aalonsopuig/Inmoov_ROS2/hardware/Default Hardware Map.pdf

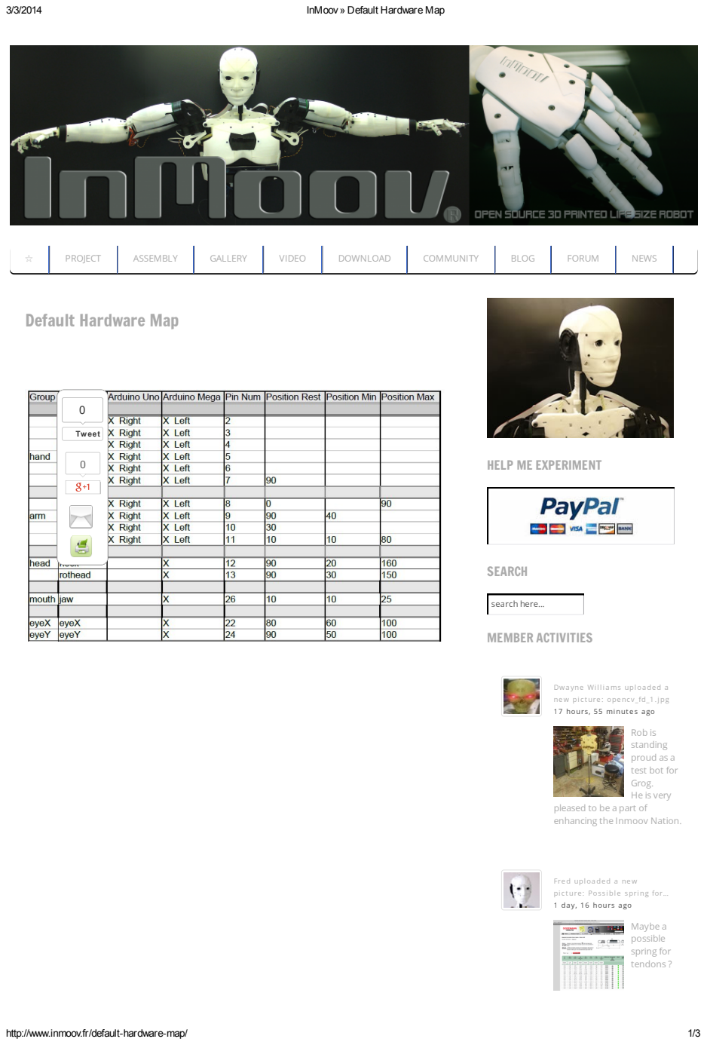
[picture p20: page 1]
InMoov» Default Hardware Map; http://www.inmoov.fr/default-hardware-map/; SEARCH; search here...; MEMBER ACTIVITIES; Maybe a possible spring for tendons ?; PROJECT; ASSEMBLY; GALLERY; VIDEO; DOWNLOAD; COMMUNITY; BLOG; FORUM; NEWS; Tweet

Default Hardware Map

HELP ME EXPERIMENT

Dwa yne Wi l l i a ms (http://www.inmoov.fr/members/dwilli9013/) upl oa ded a
new pi c t ure : openc v_fd_1. j pg (http://www.inmoov.fr/members/dwilli9013/album/picture/46/)
17 hours , 55 mi nut e s a go (http://www.inmoov.fr/activity/p/1213/)

Rob is
standing
proud as a
test bot for
Grog.
He is very

pleased to be a part of
enhancing the Inmoov Nation.

Fred (http://www.inmoov.fr/members/freddyzaz/) upl oa ded a new
pi c t ure : Pos s i bl e spri ng for… (http://www.inmoov.fr/members/freddyzaz/album/picture/45/)
1 da y, 16 hours a go (http://www.inmoov.fr/activity/p/1203/)

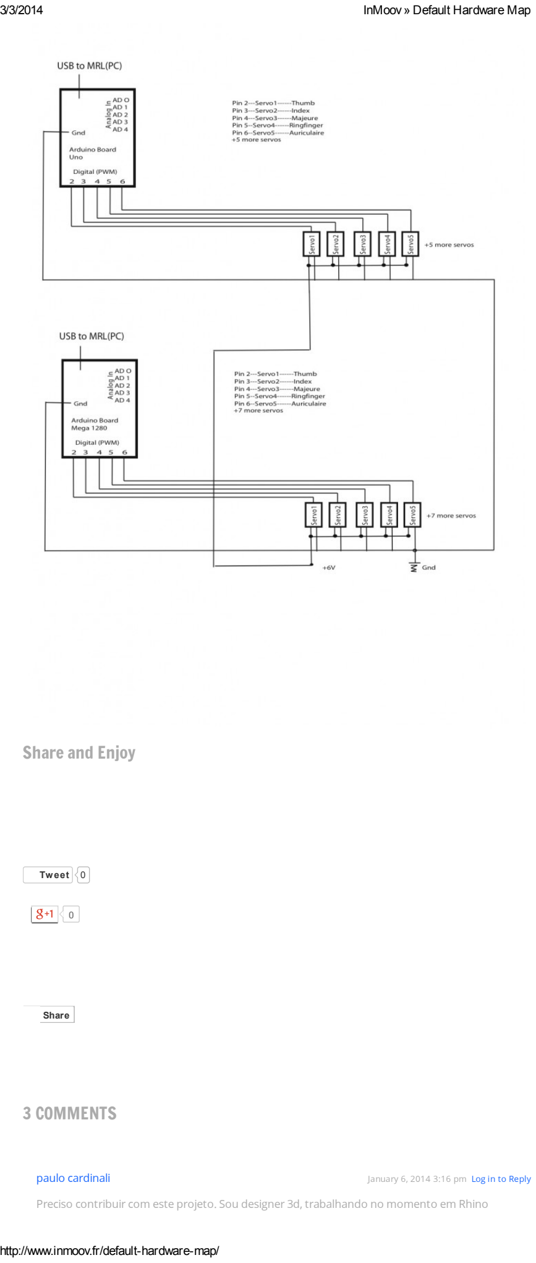
[picture p21: figure]
Tweet 0; January 6, 2014 3:16 pm Log in to Reply; Share and Enjoy; 3 COMMENTS; paulo cardinali; Share

Preciso contribuir com este projeto. Sou designer 3d, trabalhando no momento em Rhino

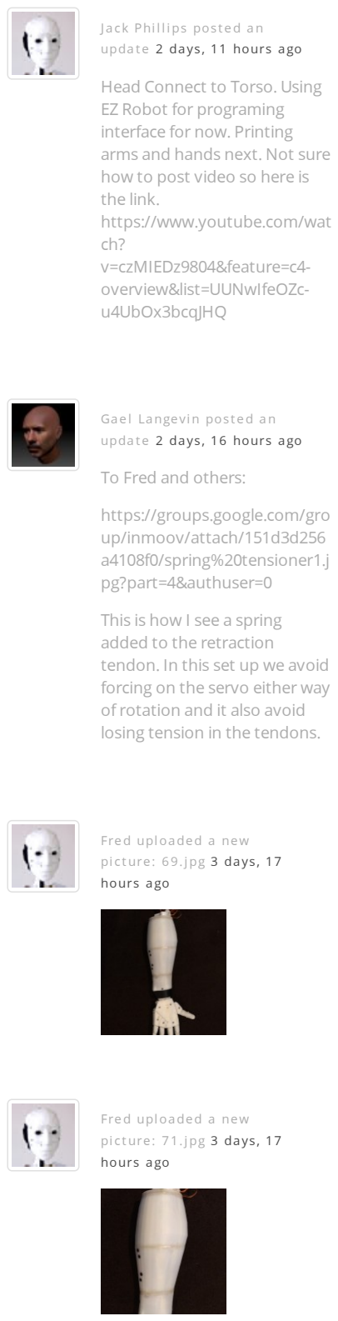
[picture p22: figure]
J a c k Phi l l i ps pos t ed a n upda t e 2 da ys , 11 hours a go; Head Connect to Torso. Using EZ Robot for programing interface for now. Printing arms and hands next. Not sure how to post video so here is the link. https://www.youtube.com/wat ch? v=czMIEDz9804&feature=c4- overview&list=UUNwIfeOZc- u4UbOx3bcqJHQ; Ga e l La nge vi n pos t ed a n upda t e 2 da ys , 16 hours a go; To Fred and others:; https://groups.google.com/gro up/inmoov/attach/151d3d256 a4108f0/spring%20tensioner1.j pg?part=4&authuser=0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

## FOLLOW ME

gael langevin (https://plus.google.com/109466702837468444192?prsrc=5) 1 circle 413 followers

## RECENT POSTS

InMoov prosthetic hand almost ready (http://www.inmoov.fr/inmoov-prosthetic-hand-almost-ready/) InMoov in Moscow, Geek Picnic (http://www.inmoov.fr/inmoov-in-moscow-geek-picnic/) InMoov on the New Yorker (http://www.inmoov.fr/inmoov-on-the-new-yorker/)
Wow InMoov Santa! (http://www.inmoov.fr/wow-inmoov-santa/)

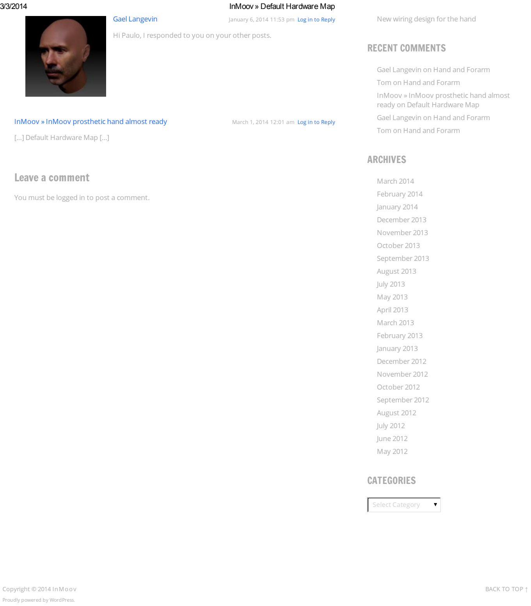
[picture p23: figure]
March 1, 2014 12:01 am Log in to Reply; Gael Langevin; […] Default Hardware Map […]; Leave a comment; New wiring design for the hand; RECENT COMMENTS; Gael Langevin on Hand and Forarm; Tom on Hand and Forarm; InMoov » InMoov prosthetic hand almost ready on Default Hardware Map; ARCHIVES; March 2014; February 2014; January 2014; December 2013; November 2013; October 2013; September 2013; August 2013; July 2013; May 2013; April 2013; March 2013; February 2013; January 2013; December 2012; November 2012; October 2012; September 2012; August 2012; July 2012; June 2012; May 2012; CATEGORIES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

January 6, 2014 11:53 pm Log in to Reply (http://www.inmoov.fr/wp-login.php?redirect_to=http%3A%2F%2Fwww.inmoov.fr%2Fdefault-hardware-map%2F)

Hi Paulo, I responded to you on your other posts.

InMoov » InMoov prosthetic hand almost ready (http://www.inmoov.fr/inmoov-prosthetic-hand-almost-ready/)

You must be logged in (http://www.inmoov.fr/wp-login.php?redirect_to=http%3A%2F%2Fwww.inmoov.fr%2Fdefault-hardware-map%2F) to post a comment.
