aalonsopuig/Inmoov_ROS2/media/Tornillos cabeza.pptx

3x16 tirafondo cabeza redonda

4x13 tirafondo cabeza redonda

3x16 tirafondo cabeza redonda

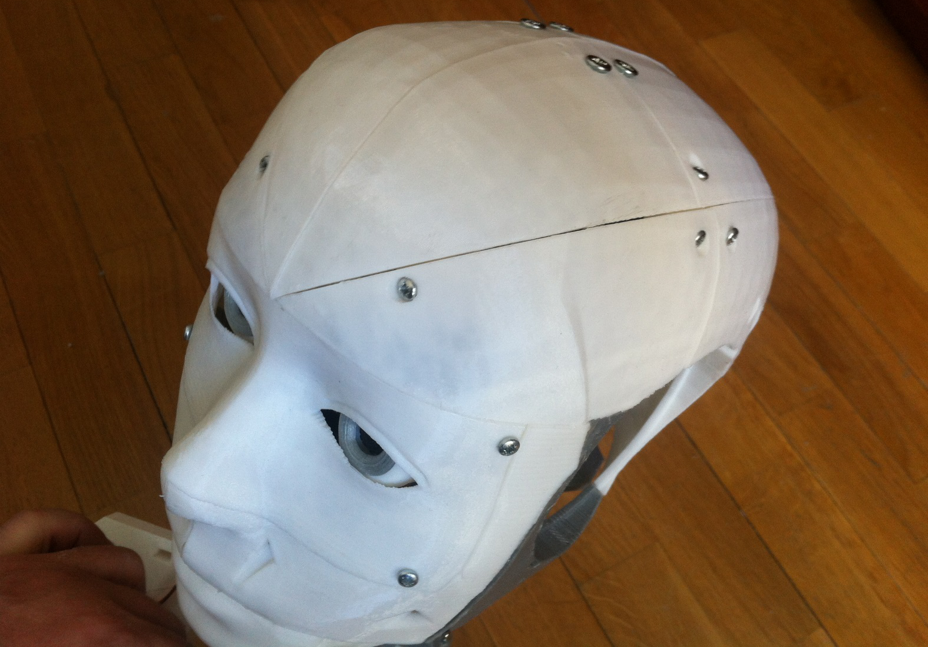
[picture p34: figure]
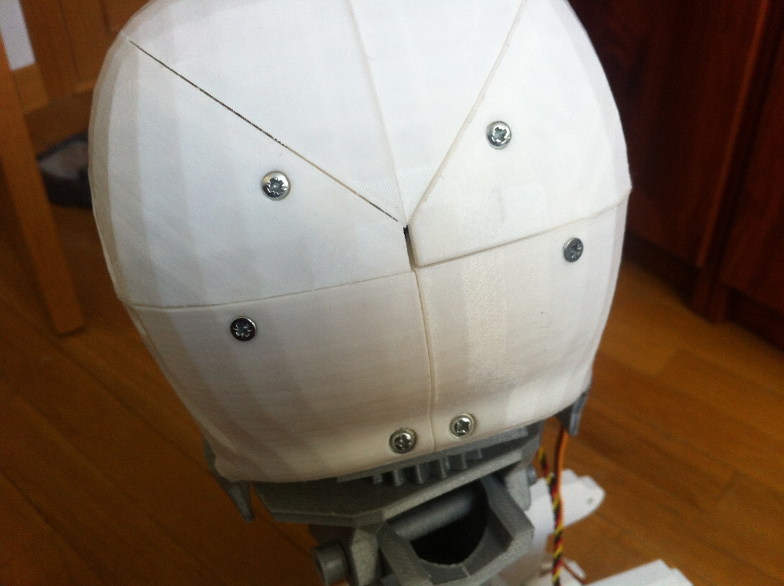
[picture p35: figure]

3x10 tirafondo cabeza redonda

3x16 tirafondo cabeza redonda

3x16 tirafondo cabeza redonda

3x10 tirafondo cabeza redonda
