aalonsopuig/Inmoov_ROS2/inmoov_ws/src/inmoov_vision/faces_db/Alejandro/Alejandro_2.png

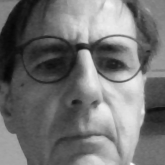
inmoov_ws/src/inmoov_vision/faces_db/Alejandro/Alejandro_2.png
