aalonsopuig/Inmoov_ROS2/inmoov_ws/src/inmoov_vision/faces_db/Daniel/Daniel_5.png

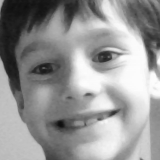
inmoov_ws/src/inmoov_vision/faces_db/Daniel/Daniel_5.png
