aalonsopuig/Inmoov_ROS2/media/20260720_172436.jpg

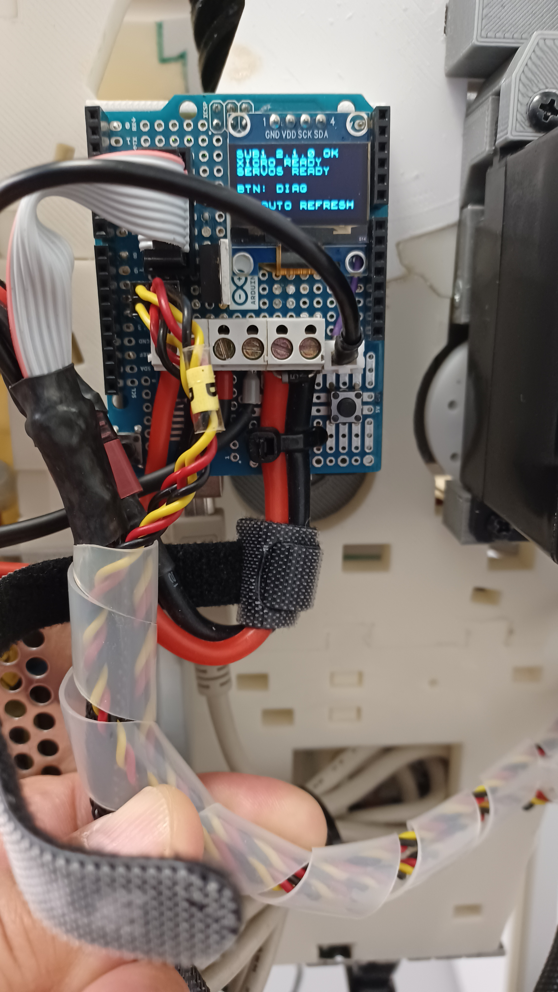
media/20260720_172436.jpg
