aalonsopuig/Inmoov_ROS2/media/20260720_172716.jpg

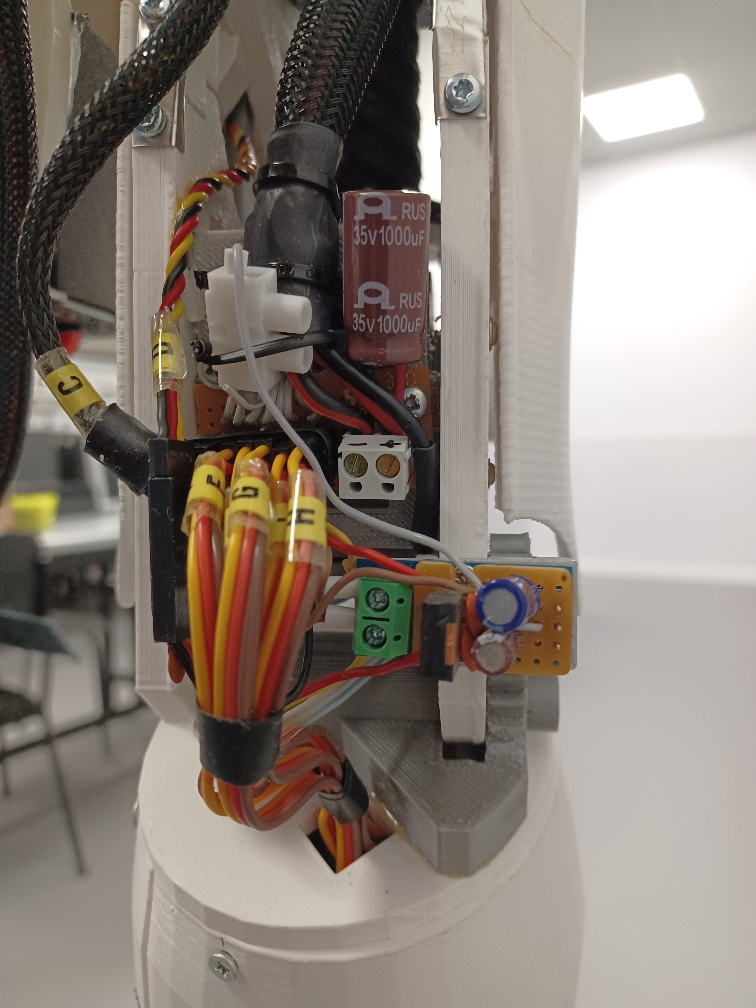
media/20260720_172716.jpg
