aalonsopuig/Inmoov_ROS2/media/IMG-20170118-WA0012.jpg

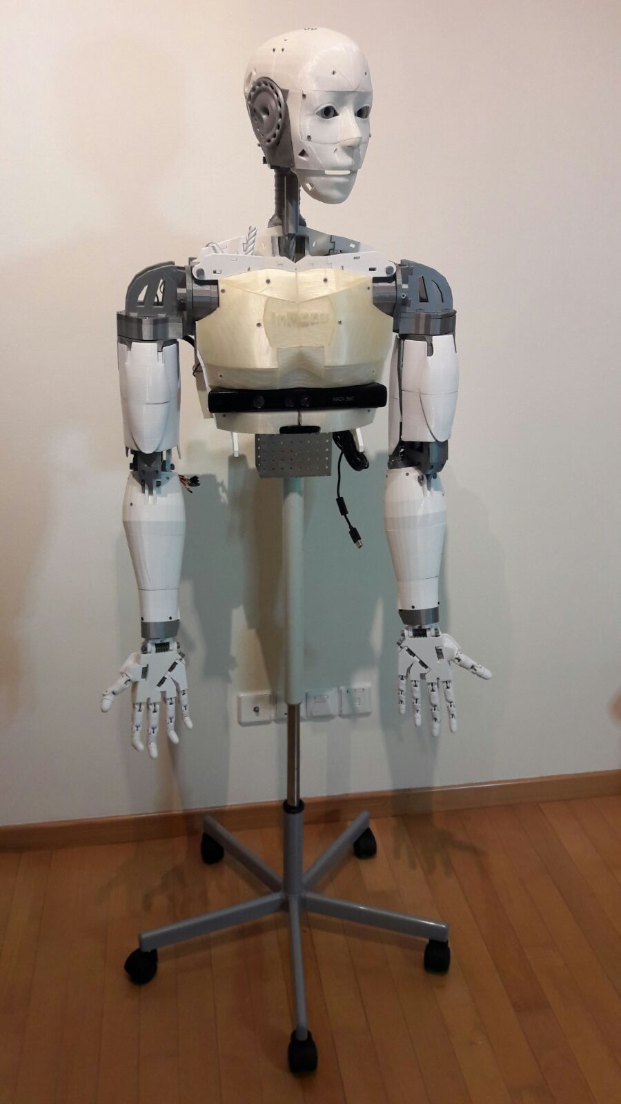
media/IMG-20170118-WA0012.jpg
