aalonsopuig/Inmoov_ROS2/media/IMG-20201107-WA0004.jpg

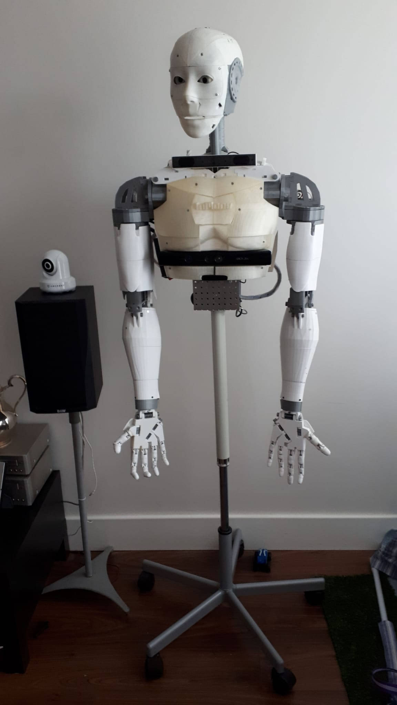
media/IMG-20201107-WA0004.jpg
