aalonsopuig/Inmoov_ROS2/media/IMG-20210605-WA0004.jpeg

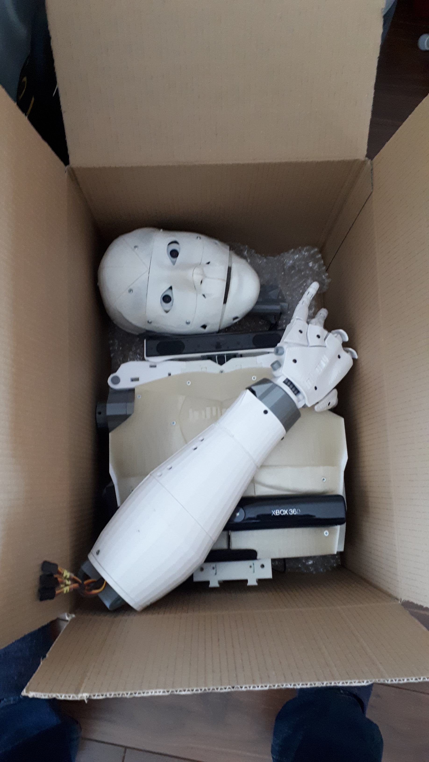
media/IMG-20210605-WA0004.jpeg
