aalonsopuig/Inmoov_ROS2/media/IMG-20211107-WA0002.jpg

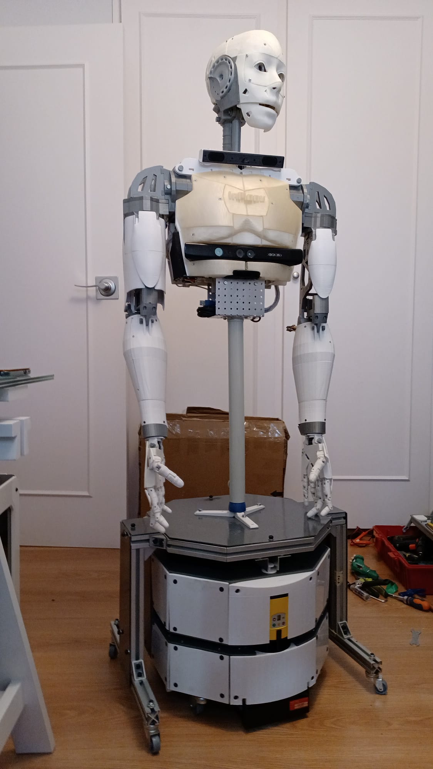
media/IMG-20211107-WA0002.jpg
