aalonsopuig/Inmoov_ROS2/media/IMG_5346.JPG

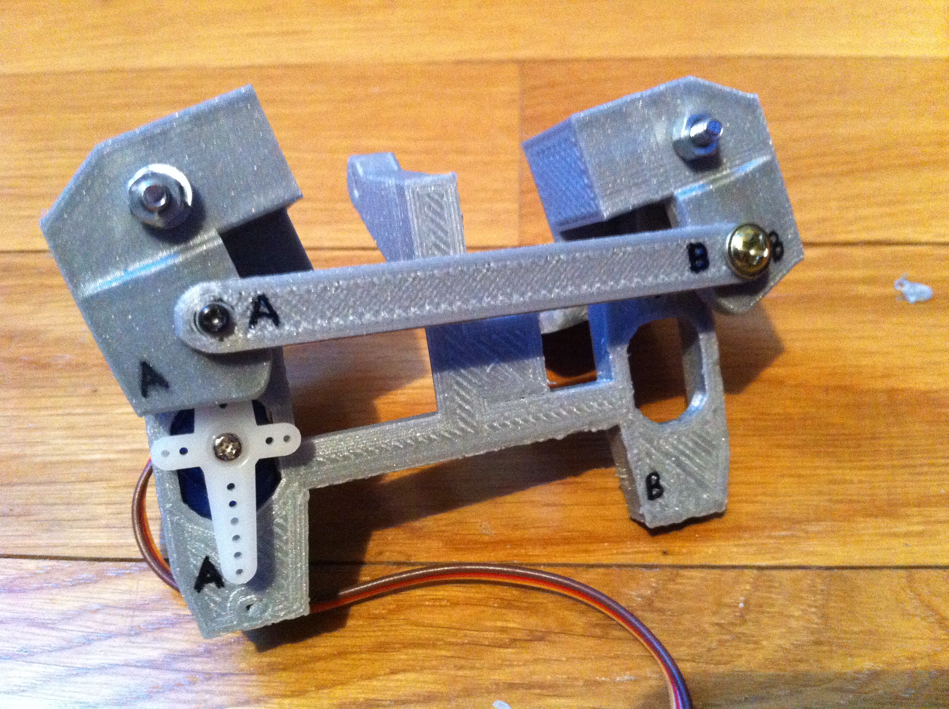
media/IMG_5346.JPG
