aalonsopuig/Inmoov_ROS2/media/IMG_5347.JPG

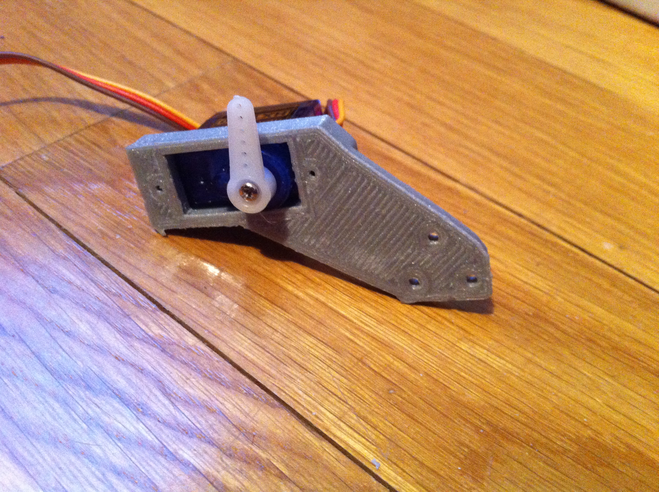
media/IMG_5347.JPG
