aalonsopuig/Inmoov_ROS2/media/IMG_5348.JPG

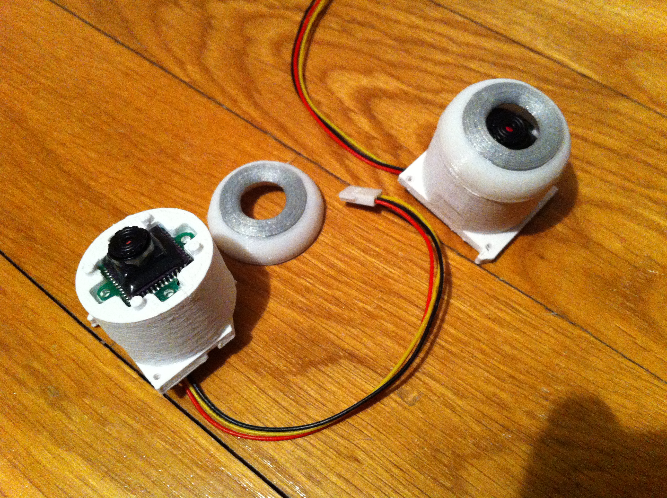
media/IMG_5348.JPG
