aalonsopuig/Inmoov_ROS2/media/IMG_5349.JPG

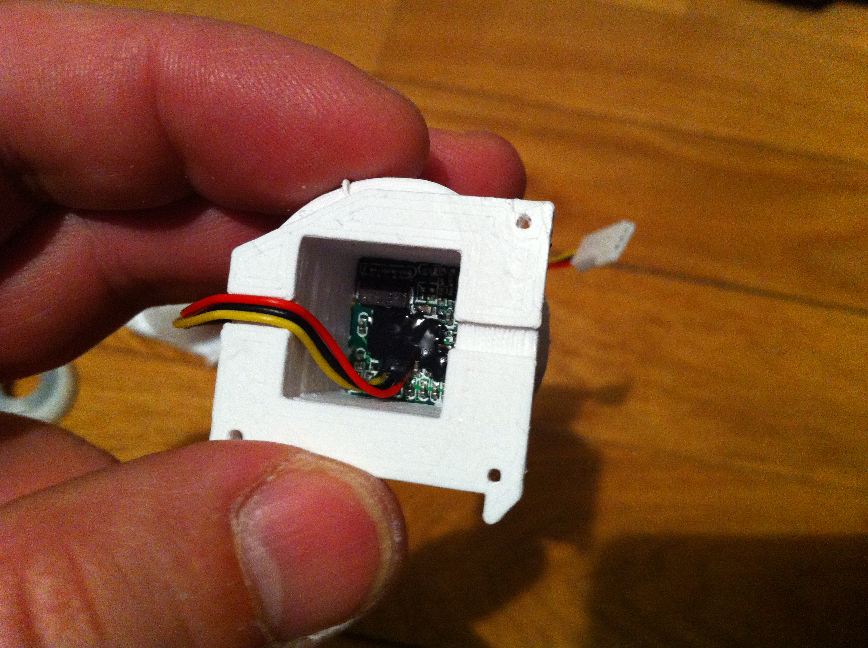
media/IMG_5349.JPG
