aalonsopuig/Inmoov_ROS2/media/IMG_5350.JPG

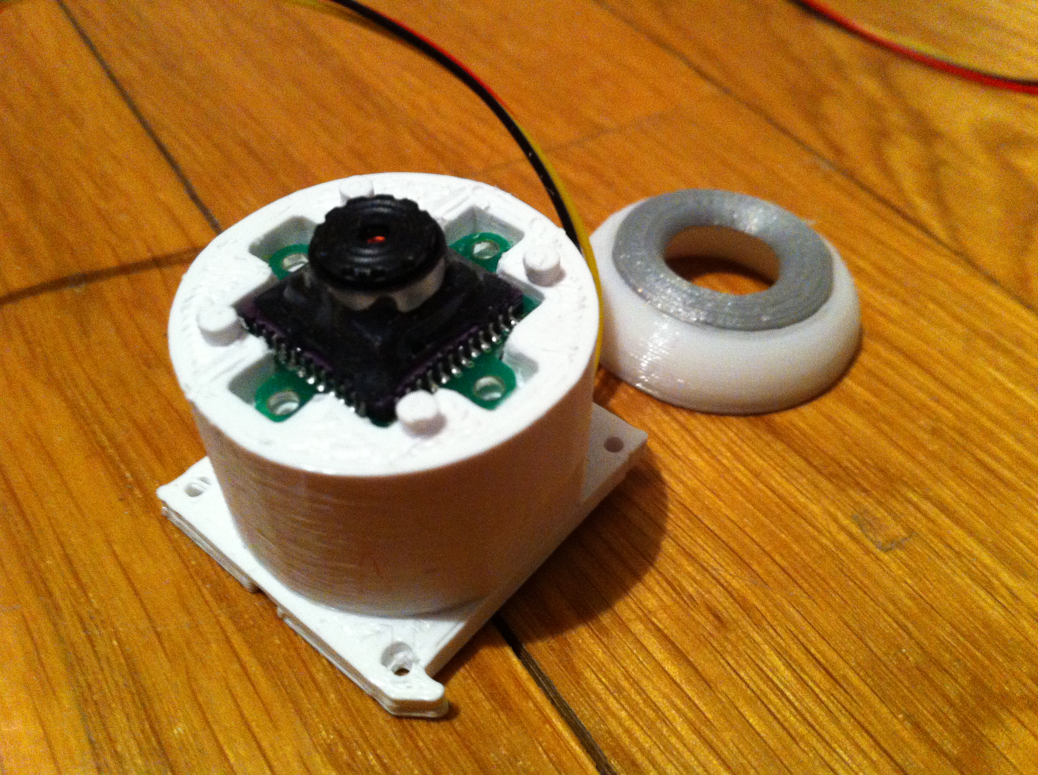
media/IMG_5350.JPG
