aalonsopuig/Inmoov_ROS2/media/IMG_5351.JPG

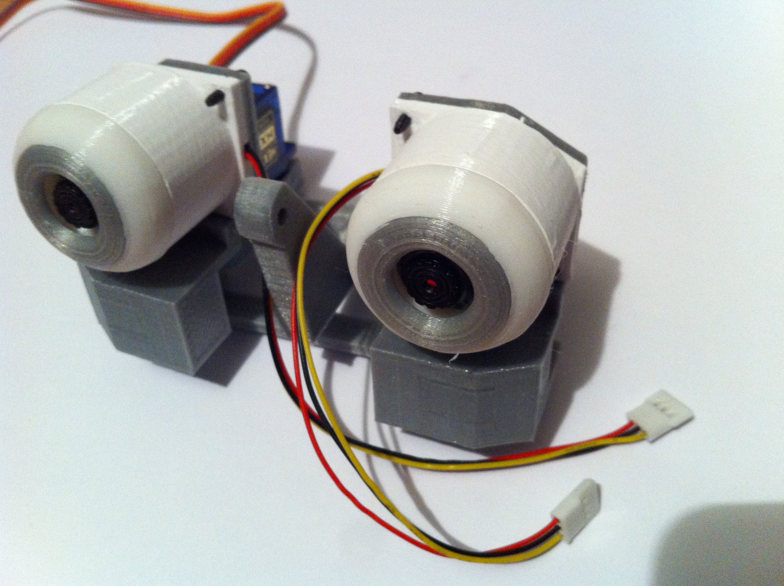
media/IMG_5351.JPG
