aalonsopuig/Inmoov_ROS2/media/IMG_5352.JPG

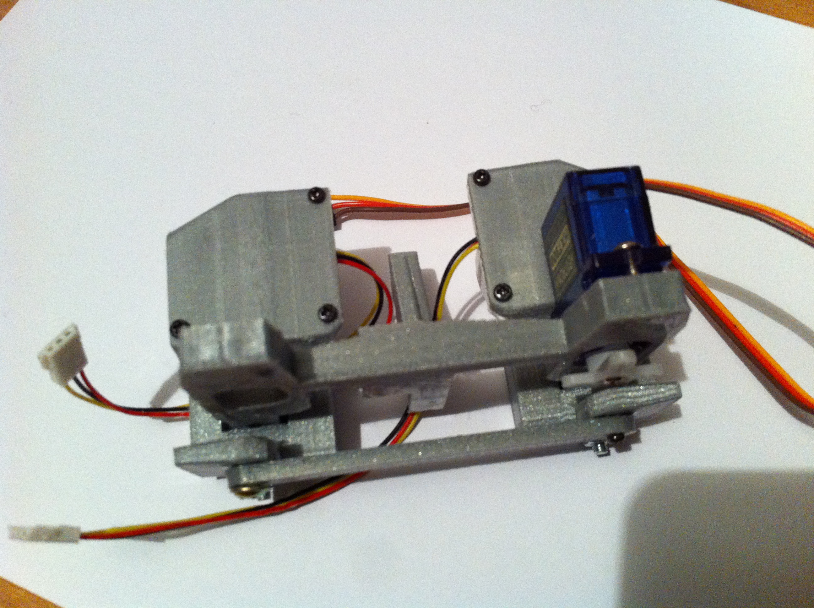
media/IMG_5352.JPG
