aalonsopuig/Inmoov_ROS2/media/IMG_5353.JPG

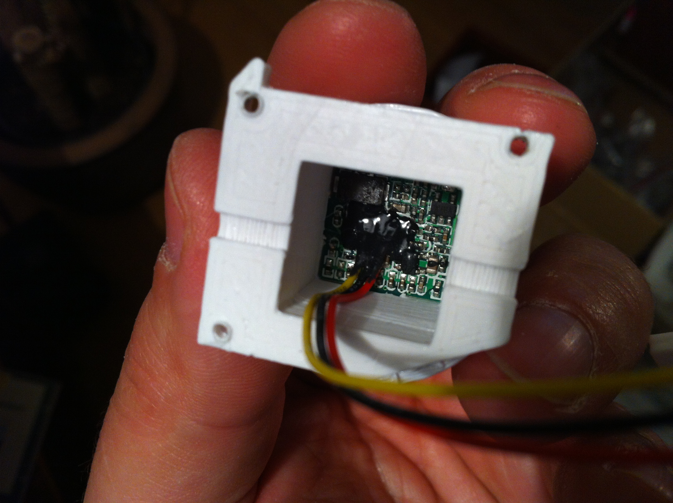
media/IMG_5353.JPG
