aalonsopuig/Inmoov_ROS2/media/IMG_5356.JPG

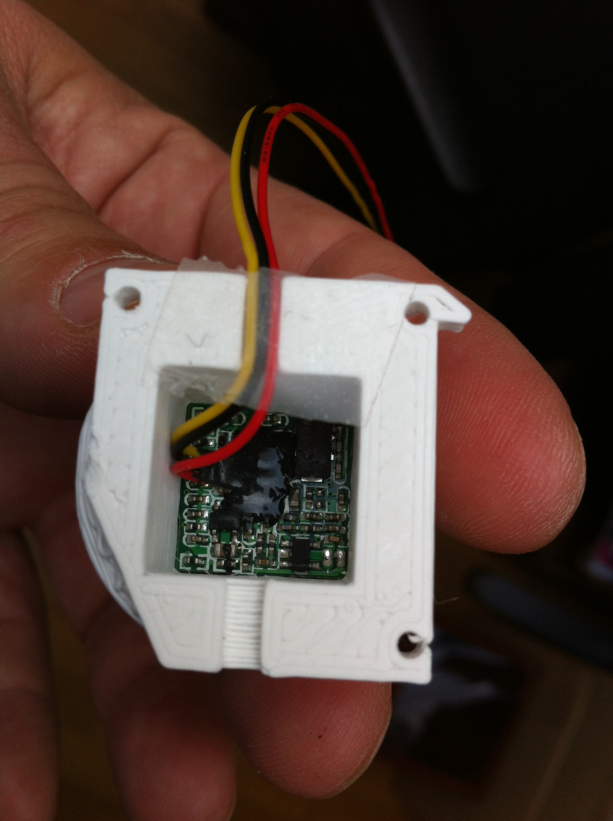
media/IMG_5356.JPG
