aalonsopuig/Inmoov_ROS2/media/IMG_5357.JPG

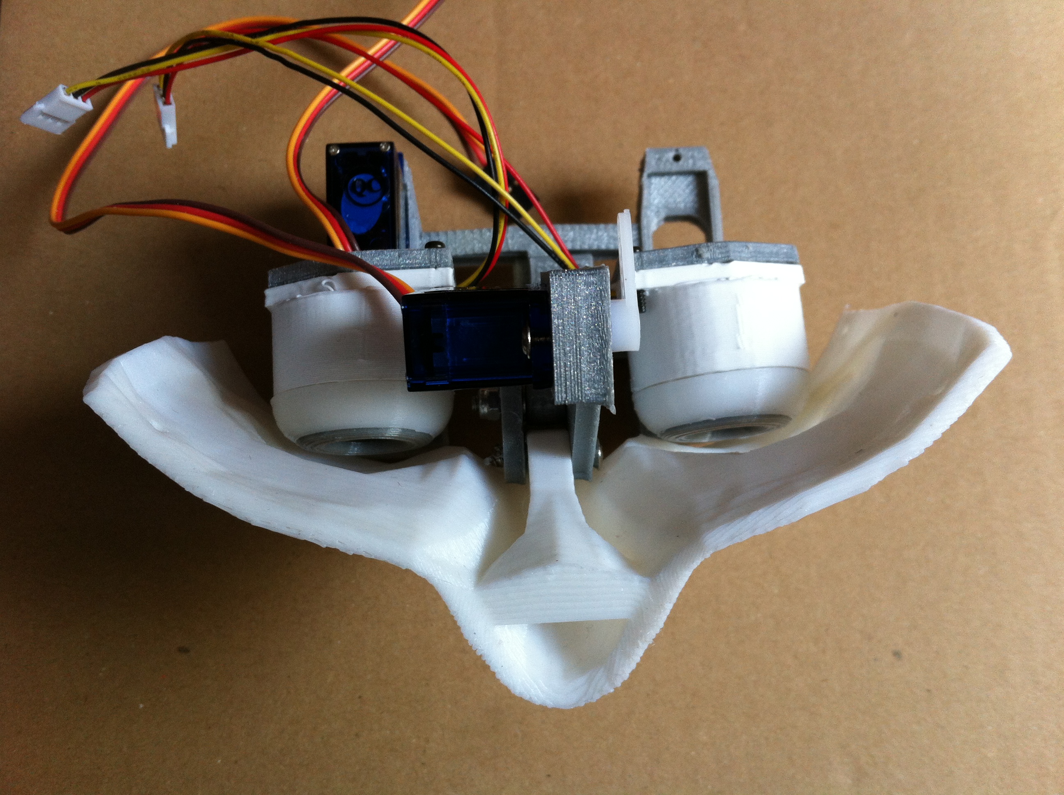
media/IMG_5357.JPG
