aalonsopuig/Inmoov_ROS2/media/IMG_5358.JPG

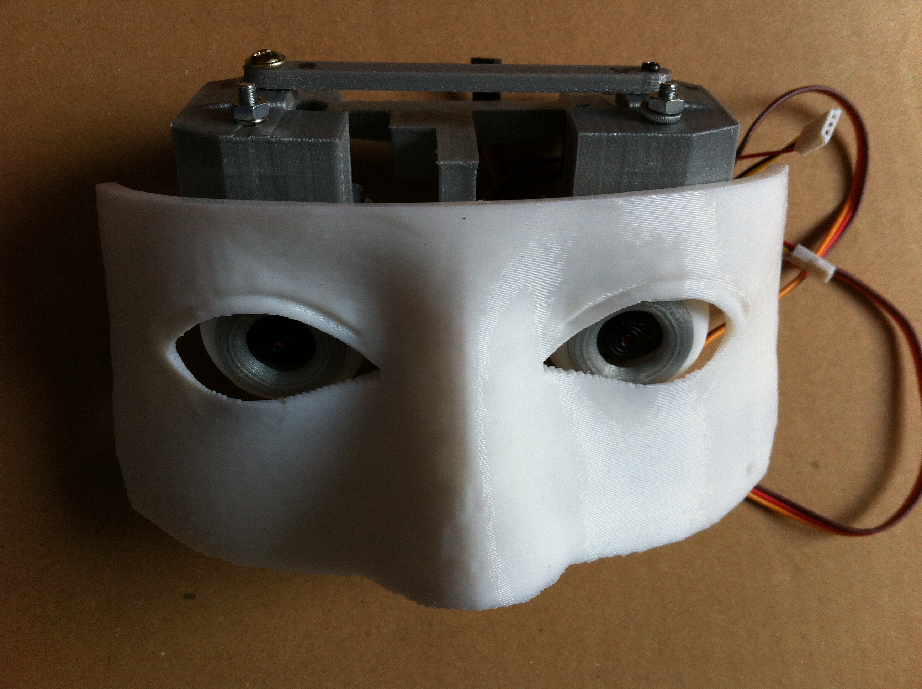
media/IMG_5358.JPG
