aalonsopuig/Inmoov_ROS2/media/IMG_5359.JPG

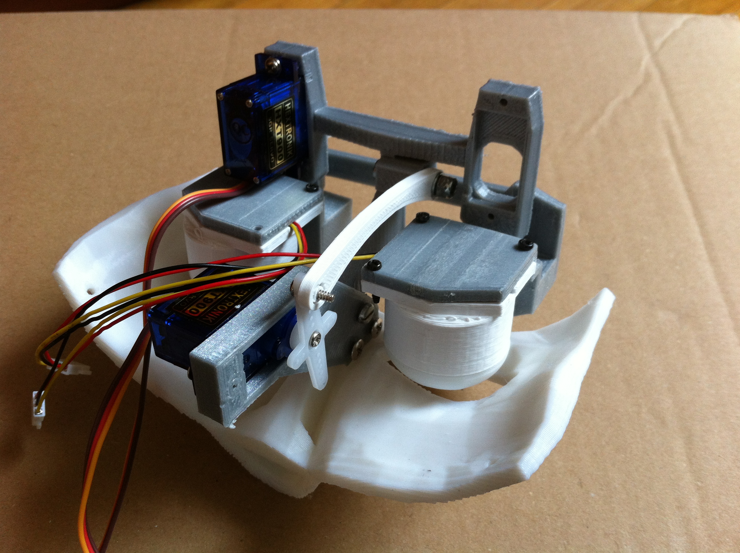
media/IMG_5359.JPG
