aalonsopuig/Inmoov_ROS2/media/IMG_5360.JPG

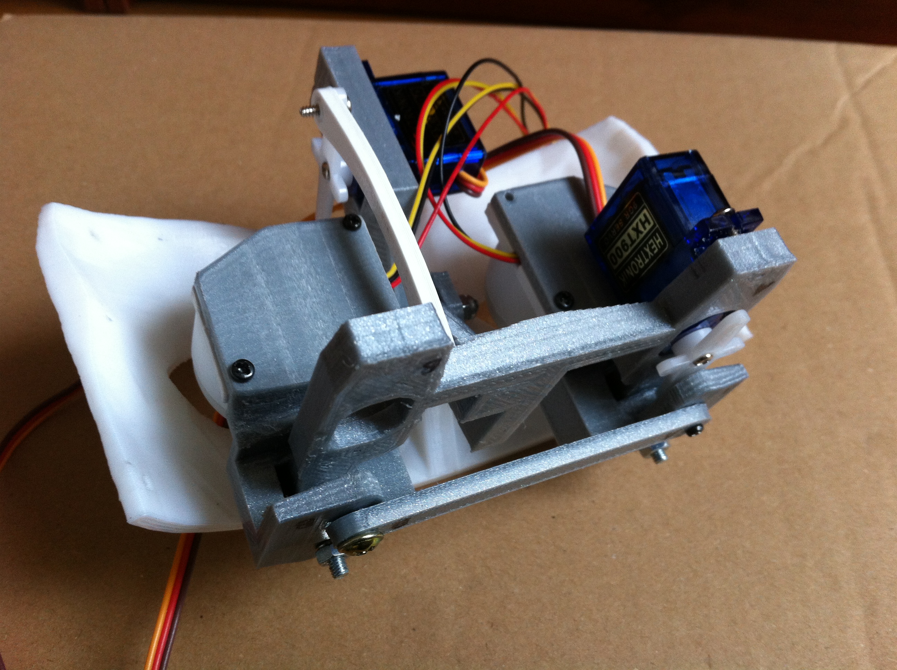
media/IMG_5360.JPG
