aalonsopuig/Inmoov_ROS2/media/IMG_5378.JPG

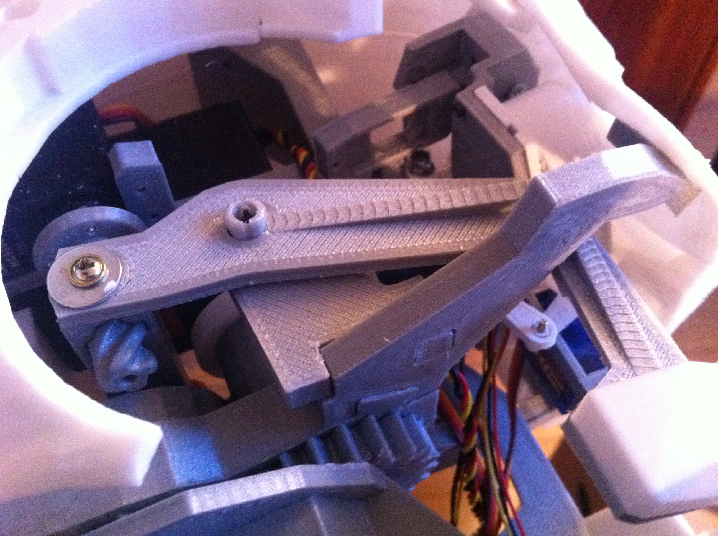
media/IMG_5378.JPG
