aalonsopuig/Inmoov_ROS2/media/IMG_5379.JPG

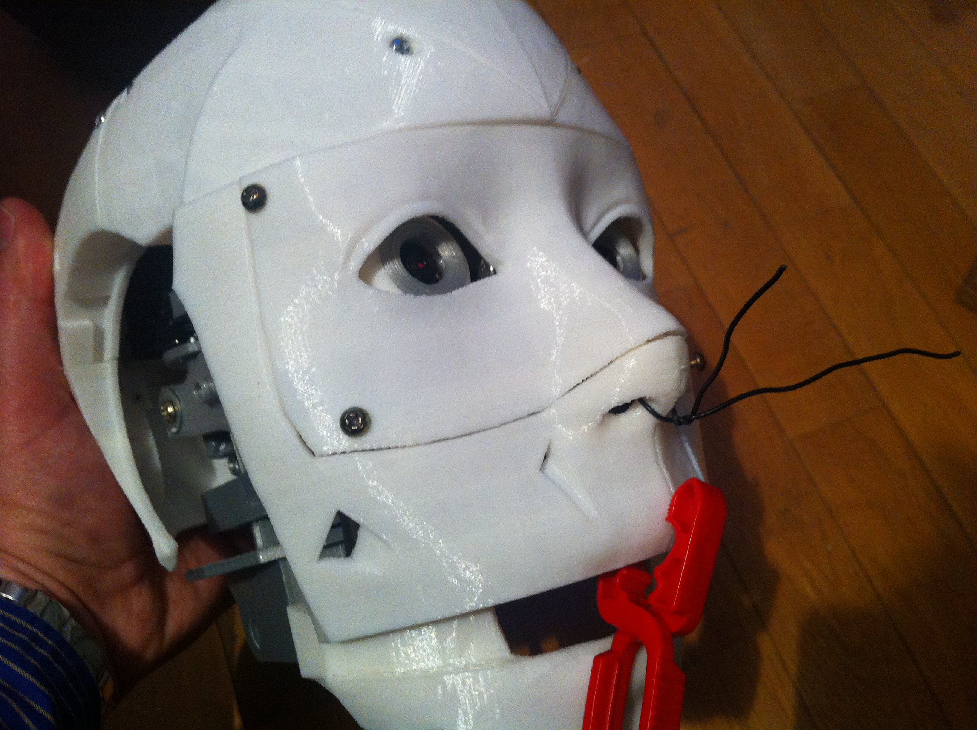
media/IMG_5379.JPG
