aalonsopuig/Inmoov_ROS2/media/IMG_5380.JPG

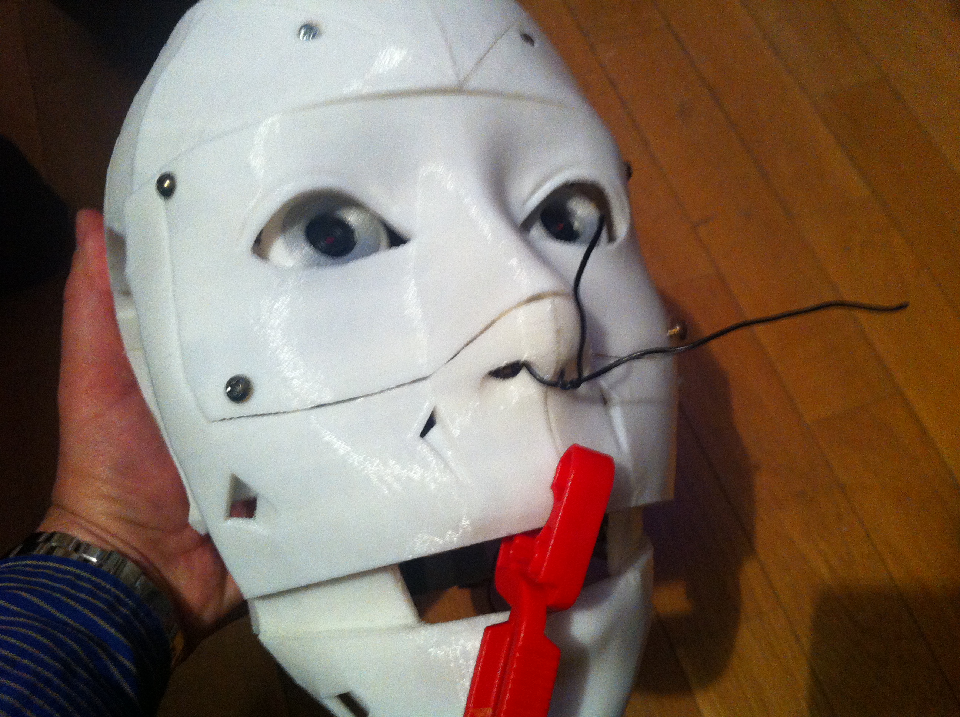
media/IMG_5380.JPG
