aalonsopuig/Inmoov_ROS2/media/IMG_5382.JPG

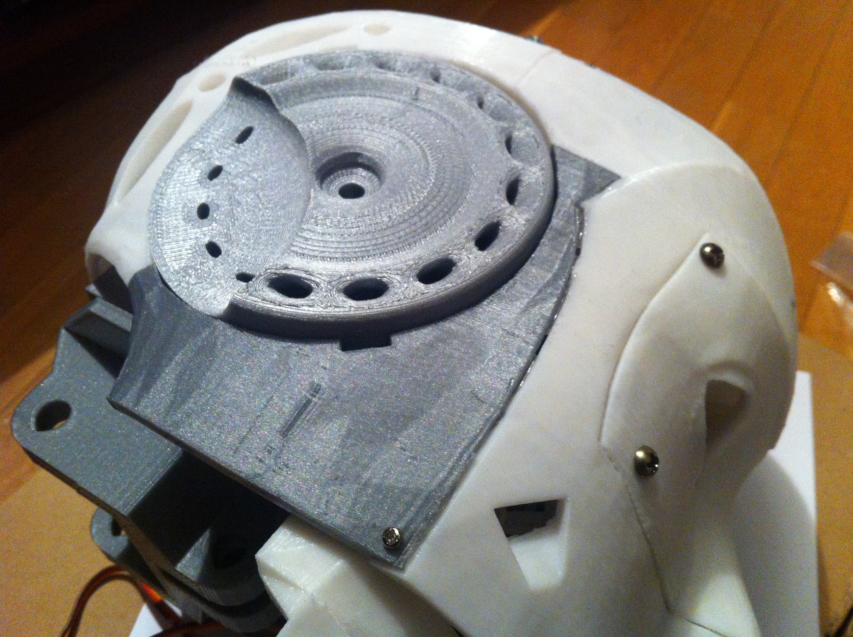
media/IMG_5382.JPG
