aalonsopuig/Inmoov_ROS2/media/IMG_5383.JPG

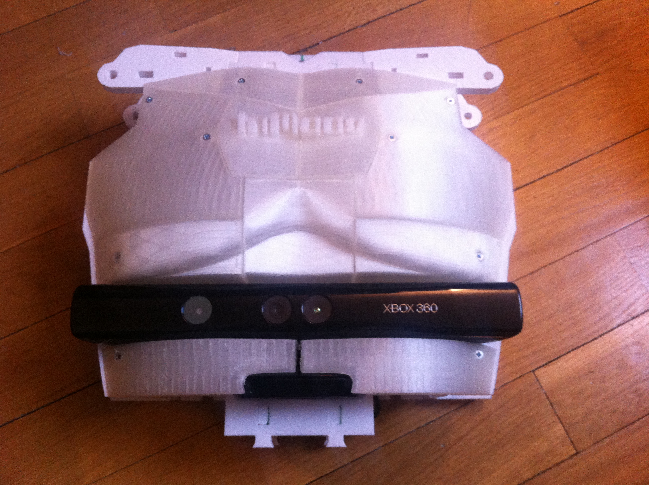
media/IMG_5383.JPG
