aalonsopuig/Inmoov_ROS2/media/IMG_5384.JPG

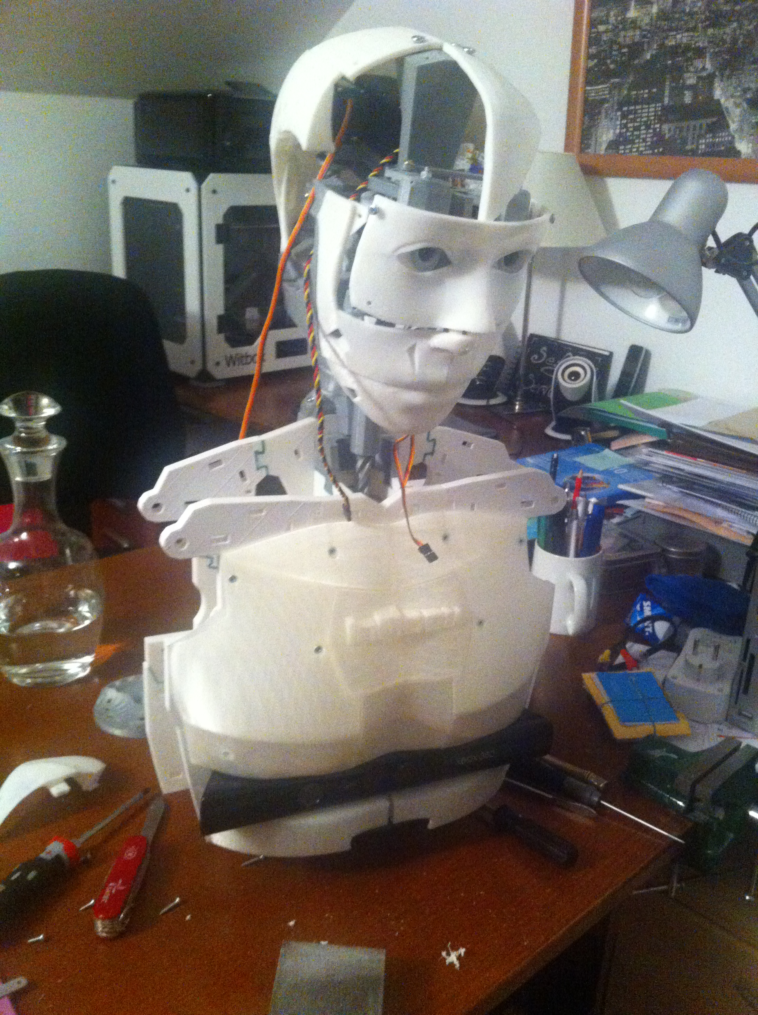
media/IMG_5384.JPG
