aalonsopuig/Inmoov_ROS2/media/IMG_5385.JPG

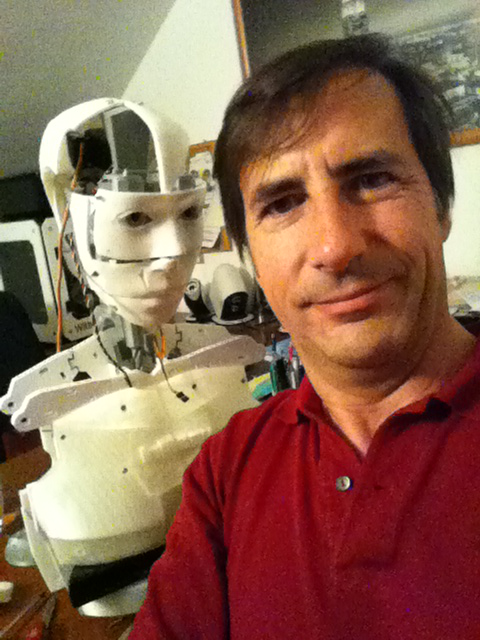
media/IMG_5385.JPG
