aalonsopuig/Inmoov_ROS2/media/IMG_5388.JPG

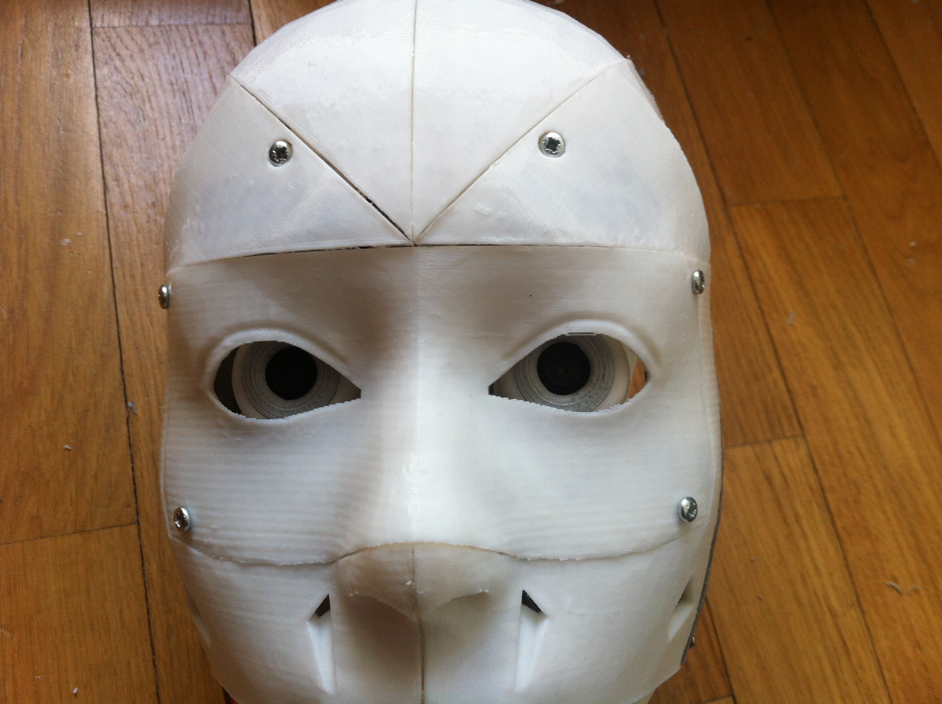
media/IMG_5388.JPG
