aalonsopuig/Inmoov_ROS2/media/IMG_6788.JPG

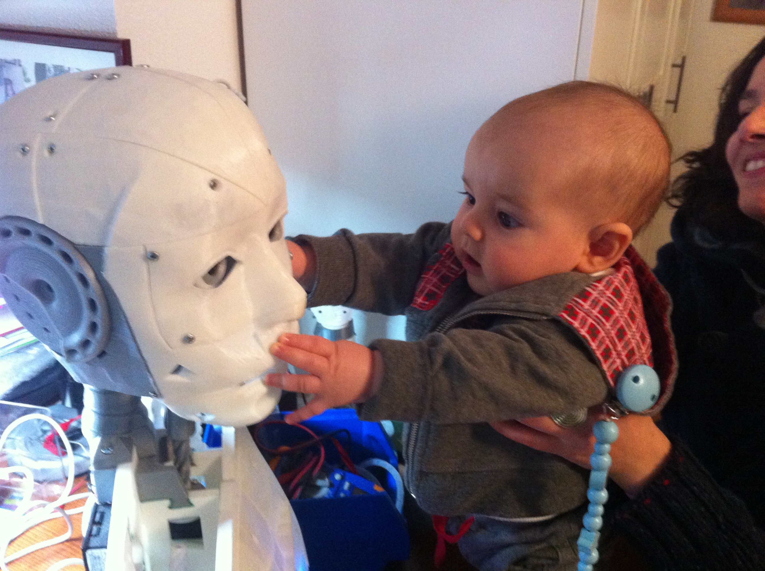
media/IMG_6788.JPG
