aalonsopuig/Inmoov_ROS2/hardware/Inmov building data.xlsx

Sheet: Pieces
 | InMoov Printing
 | Printer: Witbox |  | Plastic: PLA |  |  |  |  |  |  |  |  | 10:00:00 |  | 14:08:00 |  |  |  |  | Printing Time |  |  |  | Number of Pieces
 |  |  |  |  |  |  |  |  |  |  |  |  |  | Sets |  |  | Preparativos postimpresión |  | 69:00:00 | 29:46:00 | 92:08:00 | 92:53:00 | 36 | 12 | 55 | 55
K | Name of Piece | Printed | Picture | Section | Part | Printing Quality (micras) | Brim mm | Vertical shells | Infill | Support | Printing file | Printing time | Color | File | Printing time | Comments | Acciones | Tiempo | Head and Neck | Trunk | Left Arm | Right Arm | Head and Neck | Trunk | Left Arm | Right Arm
 | EarLeftV0 | X |  | Head and Neck | Ears | 200 | 0 | 3 | 30% | No |  | 2:00:00 | Second | EarsV0.gcode | 5:06:00 | Reducir calidad | Rebajar los bordes de base. Marcar con una L | 0:02:00 | 2:00:00 | 0:00:00 | 0:00:00 | 0:00:00 | 1 | 0 | 0 | 0
 | EarRightV0 | X |  | Head and Neck | Ears | 200 | 0 | 3 | 30% | No |  | 2:00:00 | Second | EarsV0.gcode | 5:06:00 | Reducir calidad | Rebajar los bordes de base. Marcar con una R | 0:02:00 | 2:00:00 | 0:00:00 | 0:00:00 | 0:00:00 | 1 | 0 | 0 | 0
 | EyeBallV1 | X |  | Head and Neck | Eye Mechanism | 300 | 0 | 2 | 10% | No | EyeBallV1_ballX2.gcode EyeBallV1_irisX2.gcode | 0:20:00 | White |  |  | Each file prints two pieces (different colors). | Ninguna | 0:00:00 | 0:20:00 | 0:00:00 | 0:00:00 | 0:00:00 | 1 | 0 | 0 | 0
 | EyeCameraV3 | X |  | Head and Neck | Eye Mechanism | 300 | 0 | 4 | 10% | No | EyeCameraV3.gcode | 1:45:00 | Mech |  |  |  | Repasar agujeros redondos con broca del 3. Limar la zona plana que da hacia el servo, para evitar que roce mucho el cable y la zona plana que da al otro lado para que ancle bien el ojo. Limar mucho (achaflanar) las partes superiores de la pieza para evitar que choque contra el interior de la frenteRepasar los 3 agujeros de esta parte con broca 2mm. Poner una R y L (Dcha e Izda) | 0:05:00 | 1:45:00 | 0:00:00 | 0:00:00 | 0:00:00 | 1 | 0 | 0 | 0
 | EyeMoverSideV3 | X |  | Head and Neck | Eye Mechanism | 300 | 0 | 3 | 10% | No | EyeMoverSideV3.gcode | 0:10:00 | Mech | SetEye1.gcode | 2:30:00 |  | Perforar un lado con broca 2mm y marcar con una L y el otro con broca 3mm y marcar con una R | 0:02:00 | 0:10:00 | 0:00:00 | 0:00:00 | 0:00:00 | 1 | 0 | 0 | 0
 | EyeMoverUpExtraV1 | X |  | Head and Neck | Eye Mechanism | 300 | 0 | 3 | 10% | No | EyeMoverUpExtraV1.gcode | 0:06:00 | Mech | SetEye1.gcode | 2:30:00 | Extra Piece not included in Inmoov original files. Used instead of EyeMoverUp | Quitar soportes y Brim | 0:02:00 | 0:06:00 | 0:00:00 | 0:00:00 | 0:00:00 | 1 | 0 | 0 | 0
N | EyeMoverUpV3 | N |  | Head and Neck | Eye Mechanism | 200 | 0 |  |  | No |  | 0:06:00 | Mech |  |  | Mejor usar EyeMoverUpExtraV1 |  |  | 0:06:00 | 0:00:00 | 0:00:00 | 0:00:00 | 1 | 0 | 0 | 0
 | EyeSupportV3 | X |  | Head and Neck | Eye Mechanism | 300 | 0 | 3 | 10% | No | EyeSupportV3.gcode | 1:23:00 | Mech | SetEye1.gcode | 2:30:00 |  | Repasar la perforación de los extremos (no la de anclaje de los servos) con broca del 3.También la del saliente central que se anclará en la cara. Limar los lados de las partes que entrarán en EyeCamera, puesto que la base de impresión forma un reborde que choca en los límites de los movimientos laterales. Suavizar el redondeado de la parte curva que entrará en la nariz. Poner R y L | 0:05:00 | 1:23:00 | 0:00:00 | 0:00:00 | 0:00:00 | 1 | 0 | 0 | 0
 | EyeToNoseV4 | X |  | Head and Neck | Eye Mechanism | 300 | 0 | 3 | 10% | No | EyeToNoseV4.gcode | 0:25:00 | Mech | SetEye1.gcode | 2:30:00 |  | Repasar los tres agujeros de la pieza mayor con broca 3mm | 0:02:00 | 0:25:00 | 0:00:00 | 0:00:00 | 0:00:00 | 1 | 0 | 0 | 0
 | L_EyeInterPieceV1 | x |  | Head and Neck | Eye Mechanism | 300 | 0 | 2 | 10% | No |  | 0:30:00 | Mech | RL_EyeInterPiece | 1:00:00 | Extra Piece not included in Inmoov original files | Quitar Brim. Repasar perforaciones con broca 3mm. Etiquetar R y L | 0:02:00 | 0:30:00 | 0:00:00 | 0:00:00 | 0:00:00 | 1 | 0 | 0 | 0
 | R_EyeInterPieceV1 | x |  | Head and Neck | Eye Mechanism | 300 | 0 | 2 | 10% | No |  | 0:30:00 | Mech | RL_EyeInterPiece | 1:00:00 | Extra Piece not included in Inmoov original files | Quitar Brim y ojos temporales. Repasar perforaciones con broca 3mm | 0:02:00 | 0:30:00 | 0:00:00 | 0:00:00 | 0:00:00 | 1 | 0 | 0 | 0
 | EyeglassV2 | X |  | Head and Neck | Face Parts | 300 | 5 | 2 | 10% | No | EyeglassV2.gcode | 2:15:00 | First |  |  |  | Quitar Brim. Repasar perforaciones con broca 3mm. | 0:02:00 | 2:15:00 | 0:00:00 | 0:00:00 | 0:00:00 | 1 | 0 | 0 | 0
 | LowbackV2 | X |  | Head and Neck | Face Parts | 300 | 5 | 2 | 10% | No | LowbackV2.gcode | 2:43:00 | First |  |  |  | Quitar los support que hay bajo los ejes. Suavizar el interior de la rosca para JawPiston. Perforar con broca 3mm el los extremos de los dos ejes para poner un tornillo M3. Suavizar los ejes para que entre en los agujeros extremos de JawSupport | 0:10:00 | 2:43:00 | 0:00:00 | 0:00:00 | 0:00:00 | 1 | 0 | 0 | 0
 | SideHearV2 | X |  | Head and Neck | Face Parts | 300 | 5 | 2 | 10% | No | SideHearV2.gcode | 4:30:00 | Second |  |  |  | limar ambos dientes para que entre en FaceHolder | 0:10:00 | 4:30:00 | 0:00:00 | 0:00:00 | 0:00:00 | 1 | 0 | 0 | 0
 | TopMouthV2 | X |  | Head and Neck | Face Parts | 300 | 5 | 2 | 10% | No | TopMouthV2.gcode | 4:10:00 | First |  |  |  | Suavizar rosca para que entre en JawHinge. Limpiar agujero grande de base con broca de 7mm a mano. | 0:10:00 | 4:10:00 | 0:00:00 | 0:00:00 | 0:00:00 | 1 | 0 | 0 | 0
 | JawHingeV1 | X |  | Head and Neck | Jaw Mechanism | 200 | 0 | 3 | 30% | No | JawHingeV1.gcode | 0:38:00 | Mech |  |  |  | Repasar las perforaciones pequeñas con broca de 3mm y las grandes con lima circular, pero poco. | 0:05:00 | 0:38:00 | 0:00:00 | 0:00:00 | 0:00:00 | 1 | 0 | 0 | 0
 | JawHolderV1 | X |  | Head and Neck | Jaw Mechanism | 300 | 0 | 3 | 10% | No | JawHolderV1.gcode | 0:37:00 | Mech | SetJaw1.gcode | 2:00:00 |  | Quitar el soporte temporal y limar imperfecciones. Quitar brim. | 0:05:00 | 0:37:00 | 0:00:00 | 0:00:00 | 0:00:00 | 1 | 0 | 0 | 0
 | JawPistonV1 | X |  | Head and Neck | Jaw Mechanism | 300 | 0 | 3 | 10% | No | JawPistonV1.gcode | 0:50:00 | Mech | SetJaw1.gcode | 2:00:00 |  | Limar los dientes interiores para que ancle correctamente en GearHolder. Rebajar las rebabas de base en el interior del agujero cuadrado | 0:05:00 | 0:50:00 | 0:00:00 | 0:00:00 | 0:00:00 | 1 | 0 | 0 | 0
 | JawSupportV1 | X |  | Head and Neck | Jaw Mechanism | 300 | 0 | 3 | 10% | No | JawSupportV1.gcode | 1:07:00 | Mech | SetJaw1.gcode | 2:00:00 |  | redondear por dentro los orificios con dremel hasta que casi desaparezcan las estrías. Limar los dientes exteriores de anclaje en FaceHolder | 0:05:00 | 1:07:00 | 0:00:00 | 0:00:00 | 0:00:00 | 1 | 0 | 0 | 0
 | JawV4 | X |  | Head and Neck | Jaw Mechanism | 300 | 4 | 2 | 10% | No | JawV4.gcode | 3:04:00 | First |  |  |  | Redondear con dremel y lija fina para que quepa en GearHolderV1. pasar la lija fina por la punta de los dientes un poco. | 0:05:00 | 3:04:00 | 0:00:00 | 0:00:00 | 0:00:00 | 1 | 0 | 0 | 0
 | FaceHolderV3 | X |  | Head and Neck | Neck Mechanism | 300 | 3 | 3 | 10% | No | FaceHolderV3.gcode | 1:08:00 | Mech |  |  |  | Quitar las rebabas de base de las arandelas de fijación | 0:02:00 | 1:08:00 | 0:00:00 | 0:00:00 | 0:00:00 | 1 | 0 | 0 | 0
 | GearHolderV1 | X |  | Head and Neck | Neck Mechanism | 200 | 0 | 3 | 10% | No | GearHolderV1.gcode | 3:30:00 | Mech |  |  |  | Repasar agujeros con broca de 4mm | 0:02:00 | 3:30:00 | 0:00:00 | 0:00:00 | 0:00:00 | 1 | 0 | 0 | 0
 | MainGearV1 | X |  | Head and Neck | Neck Mechanism | 300 | 0 | 4 | 10% | No | MainGearV1.gcode | 1:40:00 | Mech | SetNeck1.gcode | 4:30:00 |  | Limar un poco los lados de la base, donde están los orificios del eje. Limar también el interior de dichos orificios para que quepa el eje. Repasar taladros con broca 4mm | 0:10:00 | 1:40:00 | 0:00:00 | 0:00:00 | 0:00:00 | 1 | 0 | 0 | 0
 | NeckBoltsV2 | X |  | Head and Neck | Neck Mechanism | 300 | 5 | 2 | 10% | No | NeckBoltsV2.gcode | 1:20:00 | Second |  |  |  | Redondear por dentro con la dremel hasta que casi pierda las estrías | 0:05:00 | 1:20:00 | 0:00:00 | 0:00:00 | 0:00:00 | 1 | 0 | 0 | 0
 | NeckHingeV1 | X |  | Head and Neck | Neck Mechanism | 300 | 0 | 2 | 10% | No | NeckHingeV1.gcode | 2:00:00 | Second |  |  |  | Redondear con dremel y lija fina para que quepa en GearHolderV1. quitar las rebabas de la base en los dientes y pasar la lija fina por la punta de los dientes un poco. | 0:05:00 | 2:00:00 | 0:00:00 | 0:00:00 | 0:00:00 | 1 | 0 | 0 | 0
 | NeckV1 | X |  | Head and Neck | Neck Mechanism | 300 | 0 | 2 | 10% | No | NeckV1.gcode | 4:15:00 | Second |  |  |  | Limar un poco por el interior para quitar rebabas. Repasar agujeros servo pequeño con broca 2mm y agujeros servo grande con broca 3mm | 0:05:00 | 4:15:00 | 0:00:00 | 0:00:00 | 0:00:00 | 1 | 0 | 0 | 0
 | RingV1 | X |  | Head and Neck | Neck Mechanism | 200 | 0 | 3 | 30% | No | RingV1.gcode | 0:25:00 | Mech | SetNeck1.gcode | 4:30:00 |  | Repasar anclajes | 0:02:00 | 0:25:00 | 0:00:00 | 0:00:00 | 0:00:00 | 1 | 0 | 0 | 0
 | ServoGearV1 | X |  | Head and Neck | Neck Mechanism | 300 | 0 | 4 | 10% | No | ServoGearV1.gcode | 2:00:00 | Mech | SetNeck1.gcode | 4:30:00 |  | Limar anclajes para que entre en la otra pieza | 0:05:00 | 2:00:00 | 0:00:00 | 0:00:00 | 0:00:00 | 1 | 0 | 0 | 0
 | SkullServoFixV1 | X |  | Head and Neck | Neck Mechanism | 200 | 0 | 3 | 30% | No | SkullServoFixV1.gcode | 4:50:00 | Mech |  |  |  | Repasar orificio eje para que quepa y lijar lados del eje para que entre en NeckHinge | 0:10:00 | 4:50:00 | 0:00:00 | 0:00:00 | 0:00:00 | 1 | 0 | 0 | 0
 | ThroatHolderV1 | X |  | Head and Neck | Neck Mechanism | 300 | 0 | 2 | 10% | No | ThroatHolderV1.gcode | 0:40:00 | Second |  |  |  | Repasar perforaciones con broca 3mm. Repasar helice para que entre en ThroatPistonBase | 0:10:00 | 0:40:00 | 0:00:00 | 0:00:00 | 0:00:00 | 1 | 0 | 0 | 0
 | ThroatHoleV2 |  |  | Head and Neck | Neck Mechanism | 300 | 0 | 2 | 10% | No | ThroatHoleV2.gcode | 1:40:00 | First |  |  |  | Quitar Brim. Repasar perforaciones con broca 3mm. | 0:02:00 | 1:40:00 | 0:00:00 | 0:00:00 | 0:00:00 | 1 | 0 | 0 | 0
 | ThroatPistonBaseV2 | X |  | Head and Neck | Neck Mechanism | 300 | 0 | 2 | 10% | No | ThroatPistonBaseV2.gcode | 4:05:00 | Second |  |  |  | Quitar Brim. Repasar perforaciones con broca 3mm. Limar mucho por dentro para que no choque ojos | 0:02:00 | 4:05:00 | 0:00:00 | 0:00:00 | 0:00:00 | 1 | 0 | 0 | 0
 | ThroatPistonV2 | X |  | Head and Neck | Neck Mechanism | 300 | 0 | 2 | 100% | No | ThroatPistonV2.gcode | 3:28:00 | Second |  |  |  | Quitar Brim. Repasar perforaciones con broca 3mm. Limar mucho por dentro para que no choque ojos | 0:02:00 | 3:28:00 | 0:00:00 | 0:00:00 | 0:00:00 | 1 | 0 | 0 | 0
 | TopBackskullV1 | X |  | Head and Neck | Skull Parts | 300 | 5 | 2 | 10% | No | TopBackskullV1.gcode | 2:50:00 | First |  |  |  | Repasar un poquito bajo los nudillos y perforaciones con broca 3mm | 0:02:00 | 2:50:00 | 0:00:00 | 0:00:00 | 0:00:00 | 1 | 0 | 0 | 0
 | TopskullLeftV3 | X |  | Head and Neck | Skull Parts | 300 | 5 | 2 | 0% | No | TopskullLeftV3.gcode | 3:00:00 | First |  |  |  | Quitar brim | 0:05:00 | 3:00:00 | 0:00:00 | 0:00:00 | 0:00:00 | 1 | 0 | 0 | 0
 | TopskullRightV3 | X |  | Head and Neck | Skull Parts | 300 | 5 | 2 | 0% | No | TopskullRightV3.gcode | 3:00:00 | First |  |  |  | Quitar brim | 0:05:00 | 3:00:00 | 0:00:00 | 0:00:00 | 0:00:00 | 1 | 0 | 0 | 0
 | armtopcover1 |  |  | Left Arm | Bicep | 300 | 5 | 2 | 10% | No | armtopcover1.gcode | 3:15:00 | First |  |  |  |  | 0:05:00 | 0:00:00 | 0:00:00 | 3:15:00 | 0:00:00 | 0 | 0 | 1 | 0
 | armtopcover2 |  |  | Left Arm | Bicep | 300 | 5 | 2 | 10% | No | armtopcover2.gcode | 2:50:00 | First |  |  |  |  | 0:05:00 | 0:00:00 | 0:00:00 | 2:50:00 | 0:00:00 | 0 | 0 | 1 | 0
 | armtopcover3 |  |  | Left Arm | Bicep | 300 | 5 | 2 | 10% | No | armtopcover3.gcode | 5:05:00 | First |  |  |  |  | 0:05:00 | 0:00:00 | 0:00:00 | 5:05:00 | 0:00:00 | 0 | 0 | 1 | 0
 | elbowshaftgearV1 | X |  | Left Arm | Forearm | 300 | 0 | 4 | 10% | No | elbowshaftgearV1.gcode | 0:50:00 | Second | SetBicepL2.gcode | 3:10:00 |  | Quitar rebabas de base. Repasar perforaciones | 0:05:00 | 0:00:00 | 0:00:00 | 0:50:00 | 0:00:00 | 0 | 0 | 1 | 0
 | GearHolderV1 | X |  | Left Arm | Bicep | 300 | 0 | 2 | 10% | No | GearHolderV1.gcode | 0:30:00 | Mech | SetBicepL4.gcode | 3:30:00 |  |  | 0:05:00 | 0:00:00 | 0:00:00 | 0:30:00 | 0:00:00 | 0 | 0 | 1 | 0
 | gearpotentioV1 | X |  | Left Arm | Bicep | 100 | 0 | 4 | 30% | No | gearpotentioV1.gcode | 0:35:00 | Mech |  |  |  | Repasar agujero para eje | 0:05:00 | 0:00:00 | 0:00:00 | 0:35:00 | 0:00:00 | 0 | 0 | 1 | 0
 | higharmsideV1 | X |  | Left Arm | Bicep | 300 | 5 | 4 | 20% | No | higharmsideV1x2.gcode | 3:00:00 | Mech |  |  | 2 units in gcode. | Quitar rebabas de base. Repasar perforaciones | 0:05:00 | 0:00:00 | 0:00:00 | 3:00:00 | 0:00:00 | 0 | 0 | 1 | 0
 | leftRotcenterV2 |  |  | Left Arm | Bicep | 300 | 0 | 2 | 10% | No | leftRotcenterV2.gcode | 2:30:00 | Mech | SetBicepL3.gcode | 3:40:00 |  | Limar RotGearV3, RotWormV5leftRotcenterV2, leftRotTitV2y RotMitV2 para que encajen y fluyan correctamente | 0:02:00 | 0:00:00 | 0:00:00 | 2:30:00 | 0:00:00 | 0 | 0 | 1 | 0
 | leftRotTitV2 |  |  | Left Arm | Bicep | 300 | 0 | 2 | 10% | No | leftRotTitV2.gcode | 1:10:00 | Mech | SetBicepL3.gcode | 3:40:00 |  | Limar RotGearV3, RotWormV5leftRotcenterV2, leftRotTitV2y RotMitV2 para que encajen y fluyan correctamente | 0:02:00 | 0:00:00 | 0:00:00 | 1:10:00 | 0:00:00 | 0 | 0 | 1 | 0
 | lowarmsideV1 | X |  | Left Arm | Bicep | 300 | 5 | 4 | 20% | No | lowarmsideV1x2.gcode | 2:40:00 | Mech |  |  | 2 units in gcode. |  | 0:05:00 | 0:00:00 | 0:00:00 | 2:40:00 | 0:00:00 | 0 | 0 | 1 | 0
 | PistonanticlockV1 |  |  | Left Arm | Bicep | 200 | 0 | 3 | 100% | No | PistonanticlockV1.gcode | 2:20:00 | Second |  |  |  | Quitar rebabas de base. Repasar perforaciones | 0:05:00 | 0:00:00 | 0:00:00 | 2:20:00 | 0:00:00 | 0 | 0 | 1 | 0
 | PistonbaseantiV1 | X |  | Left Arm | Bicep | 300 | 0 | 4 | 10% | No | PistonbaseantiV1.gcode | 1:30:00 | Mech | SetBicepL4.gcode | 3:30:00 |  | Nada | 0:00:00 | 0:00:00 | 0:00:00 | 1:30:00 | 0:00:00 | 0 | 0 | 1 | 0
 | reinforcerV1 | X |  | Left Arm | Bicep | 300 | 0 | 4 | 10% | No | reinforcerV1.gcode | 0:25:00 | Mech | SetBicepL2.gcode | 3:10:00 |  | Quitar Brim. Repasar perforaciones con broca 3mm. | 0:02:00 | 0:00:00 | 0:00:00 | 0:25:00 | 0:00:00 | 0 | 0 | 1 | 0
 | RotGearV3 | X |  | Left Arm | Bicep | 300 | 0 | 4 | 10% | No | RotGearV3.gcode | 1:31:00 | Mech | SetBicepL4.gcode | 3:30:00 |  | Limar RotGearV3, RotWormV5leftRotcenterV2, leftRotTitV2y RotMitV2 para que encajen y fluyan correctamente | 0:05:00 | 0:00:00 | 0:00:00 | 1:31:00 | 0:00:00 | 0 | 0 | 1 | 0
 | RotMitV2 | X |  | Left Arm | Bicep | 300 | 0 | 2 | 10% | No | RotMitV2.gcode | 1:30:00 | Mech | SetBicepL2.gcode | 3:10:00 |  | Limar RotGearV3, RotWormV5leftRotcenterV2, leftRotTitV2y RotMitV2 para que encajen y fluyan correctamente | 0:05:00 | 0:00:00 | 0:00:00 | 1:30:00 | 0:00:00 | 0 | 0 | 1 | 0
 | RotPotentioV2 | X |  | Left Arm | Bicep | 300 | 0 | 2 | 10% | No | RotPotentioV2.gcode | 0:10:00 | Mech | SetBicepL2.gcode | 3:10:00 |  | Limar extremos para que entre en leftRotTitV2 a presión. Limar interior para que ajuste potenciómetro. | 0:02:00 | 0:00:00 | 0:00:00 | 0:10:00 | 0:00:00 | 0 | 0 | 1 | 0
 | RotWormV5 | X |  | Left Arm | Bicep | 200 | 0 | 3 | 100% | No | RotWormV5.gcode | 2:15:00 | Mech |  |  |  | Limar RotGearV3, RotWormV5leftRotcenterV2, leftRotTitV2y RotMitV2 para que encajen y fluyan correctamente | 0:05:00 | 0:00:00 | 0:00:00 | 2:15:00 | 0:00:00 | 0 | 0 | 1 | 0
 | servobaseV1 | X |  | Left Arm | Bicep | 300 | 0 | 2 | 10% | No | servobaseV1.gcode | 1:15:00 | Mech | SetBicepL1.gcode | 2:10:00 |  | Quitar rebabas de base. Repasar perforaciones | 0:05:00 | 0:00:00 | 0:00:00 | 1:15:00 | 0:00:00 | 0 | 0 | 1 | 0
 | servoholderV1 | X |  | Left Arm | Bicep | 300 | 0 | 2 | 10% | No | servoholderV1.gcode | 1:30:00 | Mech | SetBicepL1.gcode | 2:10:00 |  | Nada | 0:00:00 | 0:00:00 | 0:00:00 | 1:30:00 | 0:00:00 | 0 | 0 | 1 | 0
 | spacerV1 | X |  | Left Arm | Bicep | 300 | 0 | 4 | 10% | No | spacerV1.gcode | 0:15:00 | Mech | SetBicepL2.gcode | 3:10:00 |  | Quitar Brim. Repasar perforaciones con broca 3mm. | 0:02:00 | 0:00:00 | 0:00:00 | 0:15:00 | 0:00:00 | 0 | 0 | 1 | 0
 | LeftRobCableBackV3 | X |  | Left Arm | Forearm | 300 | 0 | 3 | 30% | No | LeftRobCableBackV3.gcode | 0:18:00 | Mech | SetForearmL1.gcode | 1:30:00
 | LeftRobCableFrontV3 | X |  | Left Arm | Forearm | 300 | 0 | 3 | 30% | No | LeftRobCableFrontV3.gcode | 0:40:00 | Mech | SetForearmL1.gcode | 1:30:00
 | Leftrobpart2V3 |  |  | Left Arm | Forearm | 300 | 5 | 2 | 10% | No | Leftrobpart2V3.gcode | 3:30:00 | First |  |  |  | Quitar Brim y soporte temporal central. Repasar los cuatro agujeros con broca de 6mm. Limar los bordes exteriores hasta perder la forma poligonal para que encajen dentro de Leftrotawrist1V3 | 0:05:00 | 0:00:00 | 0:00:00 | 3:30:00 | 0:00:00 | 0 | 0 | 1 | 0
 | leftrobpart3V3 |  |  | Left Arm | Forearm | 300 | 5 | 2 | 10% | No | leftrobpart3V3.gcode | 3:10:00 | First |  |  |  | Quitar Brim y soporte temporal central. Limar los bordes exteriores hasta perder la forma poligonal para que encajen dentro de Leftrotawrist1V3 | 0:10:00 | 0:00:00 | 0:00:00 | 3:10:00 | 0:00:00 | 0 | 0 | 1 | 0
 | leftrobpart4V3 |  |  | Left Arm | Forearm | 300 | 5 | 2 | 10% | No | leftrobpart4V3.gcode | 3:30:00 | First |  |  |  | Quitar Brim y soporte temporal central. Limar reborde exterior hasta que pierda la forma poligonal para que ancle adecuadamente en la otra pieza | 0:05:00 | 0:00:00 | 0:00:00 | 3:30:00 | 0:00:00 | 0 | 0 | 1 | 0
 | Leftrobpart5V3 |  |  | Left Arm | Forearm | 300 | 5 | 2 | 10% | No | Leftrobpart5V3.gcode | 4:25:00 | First |  |  |  | Quitar Brim y soporte temporal central. Repasar agujeros externos con broca 3mm. Limar un poco los dientes interiores para asegurar que encaja LeftRobServoBedV5 en su interior. | 0:05:00 | 0:00:00 | 0:00:00 | 4:25:00 | 0:00:00 | 0 | 0 | 1 | 0
 | LeftRobServoBedV5 | X |  | Left Arm | Forearm | 300 | 0 | 3 | 30% | No | LeftRobServoBedV5.gcode | 2:50:00 | Mech |  |  |  | Trim/Fill the holes of the simple servo bed if there is overhang
 | servo-pulleyX5 | X |  | Left Arm | Forearm | 300 | 0 | 3 | 30% | No | servo-pulleyX5.gcode | 0:30:00 | Mech | SetForearmL1.gcode | 1:30:00 |  | Repasar los agujeros de paso del hilo con broca 2mm
 | Auriculaire3 |  |  | Left Arm | Hand | 300 | 0 | 2 | 10% | No | Auriculaire3.gcode | 0:40:00 | First |  |  |  |  | 0:05:00 | 0:00:00 | 0:00:00 | 0:40:00 | 0:00:00 | 0 | 0 | 1 | 0
 | Index3 |  |  | Left Arm | Hand | 300 | 0 | 2 | 10% | No | Index3.gcode | 0:55:00 | First |  |  |  |  | 0:05:00 | 0:00:00 | 0:00:00 | 0:55:00 | 0:00:00 | 0 | 0 | 1 | 0
 | leftcoverfinger1 |  |  | Left Arm | Hand | 300 | 0 | 2 | 10% | Yes | leftcoverfinger1.gcode | 0:40:00 | First |  |  |  |  | 0:05:00 | 0:00:00 | 0:00:00 | 0:40:00 | 0:00:00 | 0 | 0 | 1 | 0
 | leftthumb5 |  |  | Left Arm | Hand | 300 | 0 | 2 | 10% | No | leftthumb5.gcode | 1:20:00 | First |  |  |  |  | 0:05:00 | 0:00:00 | 0:00:00 | 1:20:00 | 0:00:00 | 0 | 0 | 1 | 0
 | lefttopsurface4 |  |  | Left Arm | Hand | 300 | 0 | 2 | 10% | No | lefttopsurface4.gcode | 1:40:00 | First |  |  |  |  | 0:05:00 | 0:00:00 | 0:00:00 | 1:40:00 | 0:00:00 | 0 | 0 | 1 | 0
 | LeftWristlargeV4 |  |  | Left Arm | Hand | 300 | 0 | 3 | 20% | No | LeftWristlargeV4.gcode | 2:57:00 | First |  |  |  |  | 0:05:00 | 0:00:00 | 0:00:00 | 2:57:00 | 0:00:00 | 0 | 0 | 1 | 0
 | leftWristsmallV3 |  |  | Left Arm | Hand | 300 | 0 | 2 | 10% | No | leftWristsmallV3.gcode | 1:00:00 | First |  |  |  |  | 0:05:00 | 0:00:00 | 0:00:00 | 1:00:00 | 0:00:00 | 0 | 0 | 1 | 0
 | Majeure3 |  |  | Left Arm | Hand | 300 | 0 | 2 | 10% | No | Majeure3.gcode | 0:55:00 | First |  |  |  | Quitar los support que hay bajo los ejes. Suavizar el interior de la rosca para PistonAntiClock. Suavizar los ejes. | 0:10:00 | 0:00:00 | 0:00:00 | 0:55:00 | 0:00:00 | 0 | 0 | 1 | 0
 | ringfinger3 |  |  | Left Arm | Hand | 300 | 0 | 2 | 10% | No | ringfinger3.gcode | 0:55:00 | First |  |  |  | Quitar Brim. Repasar perforaciones con broca 3mm. | 0:02:00 | 0:00:00 | 0:00:00 | 0:55:00 | 0:00:00 | 0 | 0 | 1 | 0
 | ardiuinosupport |  |  | Left Arm | Other | 300 | 0 | 1 | 10% | No | ardiuinosupport.gcode | 0:25:00 | First |  |  |  | Quitar Brim. Repasar perforaciones con broca 3mm. | 0:02:00 | 0:00:00 | 0:00:00 | 0:25:00 | 0:00:00 | 0 | 0 | 1 | 0
 | leftrobcap3V1 |  |  | Left Arm | Forearm | 300 | 0 | 2 | 10% | No | leftrobcap3V1.gcode | 1:00:00 | Second |  |  |  | Quitar Brim. Repasar perforaciones con broca 3mm. | 0:02:00 | 0:00:00 | 0:00:00 | 1:00:00 | 0:00:00 | 0 | 0 | 1 | 0
 | ClaviBackV2 |  |  | Left Arm | Shoulder | 300 | 0 | 4 | 10% | No | ClaviBackV2.gcode | 1:10:00 | First |  |  |  |  | 0:05:00 | 0:00:00 | 0:00:00 | 1:10:00 | 0:00:00 | 0 | 0 | 1 | 0
 | ClaviFrontV2 |  |  | Left Arm | Shoulder | 300 | 0 | 4 | 10% | No | ClaviFrontV2.gcode | 1:15:00 | First |  |  |  |  | 0:05:00 | 0:00:00 | 0:00:00 | 1:15:00 | 0:00:00 | 0 | 0 | 1 | 0
 | leftPivcenterV1 |  |  | Left Arm | Shoulder | 300 | 0 | 2 | 10% | No | leftPivcenterV1.gcode | 2:50:00 | Mech |  |  |  |  | 0:05:00 | 0:00:00 | 0:00:00 | 2:50:00 | 0:00:00 | 0 | 0 | 1 | 0
 | leftPivMitV1 |  |  | Left Arm | Shoulder | 300 | 0 | 2 | 10% | No | leftPivMitV1.gcode | 1:40:00 | Mech | SetShoL1.gcode | 3:00:00 |  |  | 0:05:00 | 0:00:00 | 0:00:00 | 1:40:00 | 0:00:00 | 0 | 0 | 1 | 0
 | LeftPivPotholderV2 |  |  | Left Arm | Shoulder | 300 | 0 | 2 | 10% | No | LeftPivPotholderV2.gcode | 1:00:00 | Mech | SetShoL2.gcode | 3:00:00 |  |  | 0:05:00 | 0:00:00 | 0:00:00 | 1:00:00 | 0:00:00 | 0 | 0 | 1 | 0
 | leftPivTitV1 |  |  | Left Arm | Shoulder | 300 | 0 | 2 | 10% | No | leftPivTitV1.gcode | 1:15:00 | Mech | SetShoL1.gcode | 3:00:00 |  |  | 0:05:00 | 0:00:00 | 0:00:00 | 1:15:00 | 0:00:00 | 0 | 0 | 1 | 0
 | PistonbaseV4 |  |  | Left Arm | Shoulder | 300 | 0 | 4 | 10% | No | PistonbaseV4.gcode | 2:00:00 | Mech |  |  |  |  | 0:05:00 | 0:00:00 | 0:00:00 | 2:00:00 | 0:00:00 | 0 | 0 | 1 | 0
 | PistonClaviV2 |  |  | Left Arm | Shoulder | 200 | 0 | 3 | 100% | No | PistonClaviV2.gcode | 3:20:00 | Second |  |  |  |  | 0:05:00 | 0:00:00 | 0:00:00 | 3:20:00 | 0:00:00 | 0 | 0 | 1 | 0
 | PivConnectorV1 |  |  | Left Arm | Shoulder | 300 | 0 | 4 | 10% | No | PivConnectorV1.gcode | 0:40:00 | Mech | PivConnectorV1x2.gcode | 1:15:00 | 2 pieces printed in set |  | 0:05:00 | 0:00:00 | 0:00:00 | 0:40:00 | 0:00:00 | 0 | 0 | 1 | 0
 | PivGearV3 |  |  | Left Arm | Shoulder | 300 | 0 | 4 | 10% | No | PivGearV3.gcode | 1:40:00 | Mech | SetShoL2.gcode | 3:00:00 |  | Repasar perforaciones con broca 3mm. Repasar helice para que entre en PistonBase | 0:10:00 | 0:00:00 | 0:00:00 | 1:40:00 | 0:00:00 | 0 | 0 | 1 | 0
 | PivPotentioV2 |  |  | Left Arm | Shoulder | 300 | 0 | 2 | 10% | No | PivPotentioV2.gcode | 0:10:00 | Mech | SetShoL2.gcode | 3:00:00 |  | Quitar Support. Repasar perforaciones con broca 3mm. Repasar ejes. Limar algo borde base servo para que entre. | 0:05:00 | 0:00:00 | 0:00:00 | 0:10:00 | 0:00:00 | 0 | 0 | 1 | 0
 | PivWormV2 |  |  | Left Arm | Shoulder | 200 | 0 | 3 | 100% | No | PivWormV2.gcode | 2:20:00 | Mech |  |  |  | Quitar los support que hay bajo los ejes. Suavizar el interior de la rosca para PistonClavi. Suavizar los ejes. | 0:10:00 | 0:00:00 | 0:00:00 | 2:20:00 | 0:00:00 | 0 | 0 | 1 | 0
 | servoholderV1 |  |  | Left Arm | Shoulder | 300 | 0 | 4 | 10% | No | servoholderV1.gcode | 1:05:00 | First |  |  |  |  | 0:05:00 | 0:00:00 | 0:00:00 | 1:05:00 | 0:00:00 | 0 | 0 | 1 | 0
 | servoHolsterV1 |  |  | Left Arm | Shoulder | 300 | 0 | 2 | 10% | Yes | servoHolsterV1.gcode | 1:10:00 | Mech |  |  |  |  | 0:05:00 | 0:00:00 | 0:00:00 | 1:10:00 | 0:00:00 | 0 | 0 | 1 | 0
 | Bolt_entretoise6 |  |  | Left Arm | Wrist | 300 | 10 | 2 | 10% | No | Bolt_entretoise6.gcode | 2:00:00 | Second |  |  |  | Repasar anclajes | 0:05:00 | 0:00:00 | 0:00:00 | 2:00:00 | 0:00:00 | 0 | 0 | 1 | 0
 | LeftCableHolderWristV4 | X |  | Left Arm | Wrist | 300 | 0 | 2 | 10% | No | LeftCableHolderWristV4.gcode | 0:15:00 | Mech |  |  |  | Si las perforaciones de los cables tensores no son limpias, limpiar con broca de 1,2mm. Repasar con la punta de navaja para suavizar bordes cortantes del hilo | 0:05:00 | 0:00:00 | 0:00:00 | 0:15:00 | 0:00:00 | 0 | 0 | 1 | 0
 | Leftrotawrist1V3 |  |  | Left Arm | Wrist | 300 | 0 | 2 | 10% | No | Leftrotawrist1V3.gcode | 2:10:00 | First | SetWristL1.gcode | 3:00:00 |  | Quitar la pieza de support interior con un alicate. Repasar los agujetos para los hilos tensores con broca 3mm. Limar rebabas interiores de base. Repasar agujeros externos con broca 2,5mm | 0:05:00 | 0:00:00 | 0:00:00 | 2:10:00 | 0:00:00 | 0 | 0 | 1 | 0
 | leftrotawrist2 |  |  | Left Arm | Wrist | 300 | 0 | 2 | 10% | No | leftrotawrist2.gcode | 1:15:00 | Second |  |  |  | Limar interior hueco grande para que quepa sin problemas WristGearsV4 ya preparada. Repasar agujero pequeño con broca 7mm. | 0:05:00 | 0:00:00 | 0:00:00 | 1:15:00 | 0:00:00 | 0 | 0 | 1 | 0
 | rotawrist3V2 |  |  | Left Arm | Wrist | 300 | 0 | 2 | 10% | No | rotawrist3V2.gcode | 0:45:00 | First | SetWristL1.gcode | 3:00:00 |  | Repasar hueco eje con broca 8mm. Limar interior hueco grande para que quepa WristGearsV4 ya preparada | 0:05:00 | 0:00:00 | 0:00:00 | 0:45:00 | 0:00:00 | 0 | 0 | 1 | 0
 | WristGearsV4 | X |  | Left Arm | Wrist | 100 | 0 | 4 | 30% | No | WristGearsV4.gcode | 2:00:00 | Mech |  |  |  | El engranaje pequeño se tira. En el mediano se repasa con navaja el hueco del eje del servo para remarcar los dientes internos. En el grande se lima exteriormente el eje para redondear totalmente la forma poligonal. Repasar agujeros de hilo tensor con broca 2mm y avellanar un poco con navaja para evitar bordes cortantes del hilo | 0:05:00 | 0:00:00 | 0:00:00 | 2:00:00 | 0:00:00 | 0 | 0 | 1 | 0
 | BaseExtra |  |  | Other |  | 300 | 5 | 3 | 30% | No | BaseExtra.gcode |  | First |  |  |  | Repasar anclajes | 0:05:00 | 0:00:00 | 0:00:00 | 0:00:00 | 0:00:00 | 0 | 0 | 0 | 0
 | Connectors1 |  |  | Other |  | 300 | 0 | 3 | 30% | No | Connectors1.gcode | 0:20:00 | Any | Connectors.gcode | 0:42:00 |  | Repasar anclajes | 0:05:00 | 0:00:00 | 0:00:00 | 0:00:00 | 0:00:00 | 0 | 0 | 0 | 0
 | Connectors2 |  |  | Other |  | 300 | 0 | 3 | 30% | No | Connectors2.gcode | 0:20:00 | Any | Connectors.gcode |  |  | Repasar anclajes | 0:05:00 | 0:00:00 | 0:00:00 | 0:00:00 | 0:00:00 | 0 | 0 | 0 | 0
 | armtopcover1 |  |  | Right Arm | Bicep | 300 | 5 | 2 | 10% | No | armtopcover1.gcode | 3:15:00 | First |  |  |  | Repasar anclajes | 0:05:00 | 0:00:00 | 0:00:00 | 0:00:00 | 3:15:00 | 0 | 0 | 0 | 1
 | armtopcover2 |  |  | Right Arm | Bicep | 300 | 5 | 2 | 10% | No | armtopcover2.gcode | 2:50:00 | First |  |  |  | Repasar anclajes | 0:05:00 | 0:00:00 | 0:00:00 | 0:00:00 | 2:50:00 | 0 | 0 | 0 | 1
 | armtopcover3 |  |  | Right Arm | Bicep | 300 | 5 | 2 | 10% | No | armtopcover3.gcode | 5:05:00 | First |  |  |  | Repasar anclajes | 0:05:00 | 0:00:00 | 0:00:00 | 0:00:00 | 5:05:00 | 0 | 0 | 0 | 1
 | elbowshaftgearV1 |  |  | Right Arm | Forearm | 300 | 0 | 4 | 10% | No | elbowshaftgearV1.gcode | 0:50:00 | Second | SetBicepR2.gcode | 3:10:00 |  | Repasar anclajes | 0:05:00 | 0:00:00 | 0:00:00 | 0:00:00 | 0:50:00 | 0 | 0 | 0 | 1
 | GearHolderV1 |  |  | Right Arm | Bicep | 300 | 0 | 2 | 10% | No | GearHolderV1.gcode | 0:30:00 | Mech | SetBicepR4.gcode | 3:30:00 |  | Repasar anclajes | 0:05:00 | 0:00:00 | 0:00:00 | 0:00:00 | 0:30:00 | 0 | 0 | 0 | 1
 | gearpotentioV1 |  |  | Right Arm | Bicep | 100 | 0 | 4 | 30% | No | gearpotentioV1.gcode | 0:35:00 | Mech |  |  |  | Repasar anclajes | 0:05:00 | 0:00:00 | 0:00:00 | 0:00:00 | 0:35:00 | 0 | 0 | 0 | 1
 | higharmsideV1 |  |  | Right Arm | Bicep | 300 | 5 | 4 | 20% | No | higharmsideV1x2.gcode | 3:00:00 | Mech |  |  | 2 units in gcode | Repasar anclajes | 0:05:00 | 0:00:00 | 0:00:00 | 0:00:00 | 3:00:00 | 0 | 0 | 0 | 1
 | lowarmsideV1 |  |  | Right Arm | Bicep | 300 | 5 | 4 | 20% | No | lowarmsideV1x2.gcode | 2:40:00 | Mech |  |  | 2 units in gcode | Repasar anclajes | 0:05:00 | 0:00:00 | 0:00:00 | 0:00:00 | 2:40:00 | 0 | 0 | 0 | 1
 | PistonanticlockV1 |  |  | Right Arm | Bicep | 200 | 0 | 3 | 100% | No | PistonanticlockV1.gcode | 2:20:00 | Second |  |  |  | Repasar perforaciones tornillos con broca 3mm. Redondear ejes | 0:05:00 | 0:00:00 | 0:00:00 | 0:00:00 | 2:20:00 | 0 | 0 | 0 | 1
 | PistonbaseantiV1 |  |  | Right Arm | Bicep | 300 | 0 | 4 | 10% | No | PistonbaseantiV1.gcode | 1:30:00 | Mech | SetBicepR4.gcode | 3:30:00 |  | Repasar anclajes | 0:05:00 | 0:00:00 | 0:00:00 | 0:00:00 | 1:30:00 | 0 | 0 | 0 | 1
 | reinforcerV1 |  |  | Right Arm | Bicep | 300 | 0 | 2 | 10% | No | reinforcerV1.gcode | 0:25:00 | Mech | SetBicepR2.gcode | 3:10:00 |  |  | 0:05:00 | 0:00:00 | 0:00:00 | 0:00:00 | 0:25:00 | 0 | 0 | 0 | 1
 | RotcenterV2 |  |  | Right Arm | Bicep | 300 | 0 | 2 | 10% | No | RotcenterV2.gcode | 2:30:00 | Mech | SetBicepR3.gcode | 3:40:00 |  | Redondear el hueco interior para que entre RotGearV3 | 0:05:00 | 0:00:00 | 0:00:00 | 0:00:00 | 2:30:00 | 0 | 0 | 0 | 1
 | RotGearV3 |  |  | Right Arm | Bicep | 300 | 0 | 4 | 10% | No | RotGearV3.gcode | 1:31:00 | Mech | SetBicepR4.gcode | 3:30:00 |  | Redondear el eje exterior | 0:05:00 | 0:00:00 | 0:00:00 | 0:00:00 | 1:31:00 | 0 | 0 | 0 | 1
 | RotMitV2 |  |  | Right Arm | Bicep | 300 | 0 | 2 | 10% | No | RotMitV2.gcode | 1:30:00 | Mech | SetBicepR2.gcode | 3:10:00 |  | Repasar anclajes | 0:05:00 | 0:00:00 | 0:00:00 | 0:00:00 | 1:30:00 | 0 | 0 | 0 | 1
 | RotPotentioV2 |  |  | Right Arm | Bicep | 300 | 0 | 2 | 10% | No | RotPotentioV2.gcode | 0:10:00 | Mech |  |  |  | Limar extremos para que entre en RotTitV2 a presión. Limar interior para que ajuste potenciómetro. | 0:05:00 | 0:00:00 | 0:00:00 | 0:00:00 | 0:10:00 | 0 | 0 | 0 | 1
 | RotTitV2 |  |  | Right Arm | Bicep | 300 | 0 | 2 | 10% | No | RotTitV2.gcode | 1:10:00 | Mech | SetBicepR3.gcode | 3:40:00 |  | Redondear el hueco interior para que entre RotGearV3 | 0:05:00 | 0:00:00 | 0:00:00 | 0:00:00 | 1:10:00 | 0 | 0 | 0 | 1
 | RotWormV5 |  |  | Right Arm | Bicep | 200 | 0 | 3 | 100% | No | RotWormV5.gcode | 2:15:00 | Mech |  |  |  | Repasar anclajes | 0:05:00 | 0:00:00 | 0:00:00 | 0:00:00 | 2:15:00 | 0 | 0 | 0 | 1
 | servobaseV1 |  |  | Right Arm | Bicep | 300 | 0 | 2 | 10% | No | servobaseV1.gcode | 1:15:00 | Mech | SetBicepR1.gcode | 3:00:00 |  | Repasar anclajes | 0:05:00 | 0:00:00 | 0:00:00 | 0:00:00 | 1:15:00 | 0 | 0 | 0 | 1
 | servoholderV1 |  |  | Right Arm | Bicep | 300 | 0 | 2 | 10% | No | servoholderV1.gcode | 1:30:00 | Mech | SetBicepR1.gcode | 3:00:00 |  | Repasar anclajes | 0:05:00 | 0:00:00 | 0:00:00 | 0:00:00 | 1:30:00 | 0 | 0 | 0 | 1
 | spacerV1 |  |  | Right Arm | Bicep | 300 | 0 | 2 | 10% | No | spacerV1.gcode | 0:15:00 | Mech | SetBicepR2.gcode | 3:10:00 |  | Repasar anclajes | 0:05:00 | 0:00:00 | 0:00:00 | 0:00:00 | 0:15:00 | 0 | 0 | 0 | 1
 | RobCableBackV3 | X |  | Right Arm | Forearm | 300 | 0 | 3 | 30% | No | RobCableBackV3.gcode | 0:18:00 | Mech | SetForearmR1.gcode | 1:30:00
 | RobCableFrontV3 | X |  | Right Arm | Forearm | 300 | 0 | 3 | 30% | No | RobCableFrontV3.gcode | 0:40:00 | Mech | SetForearmR1.gcode | 1:30:00
 | robpart2V3 | X |  | Right Arm | Forearm | 300 | 5 | 2 | 10% | No | robpart2V3.gcode | 3:30:00 | First |  |  |  | Quitar Brim y soporte temporal central. Repasar los cuatro agujeros con broca de 6mm. Limar los bordes exteriores hasta perder la forma poligonal para que encajen dentro de rotawrist1V3 | 0:02:00 | 0:00:00 | 0:00:00 | 0:00:00 | 3:30:00 | 0 | 0 | 0 | 1
 | robpart3V3 | X |  | Right Arm | Forearm | 300 | 5 | 2 | 10% | No | robpart3V3.gcode | 3:10:00 | First |  |  |  | Quitar Brim y soporte temporal central. Limar los bordes exteriores hasta perder la forma poligonal para que encajen dentro de rotawrist1V3 | 0:05:00 | 0:00:00 | 0:00:00 | 0:00:00 | 3:10:00 | 0 | 0 | 0 | 1
 | robpart4V3 | X |  | Right Arm | Forearm | 300 | 5 | 2 | 10% | No | robpart4V3.gcode | 3:30:00 | First |  |  |  | Quitar Brim y soporte temporal central. Limar reborde exterior hasta que pierda la forma poligonal para que ancle adecuadamente en la otra pieza | 0:05:00 | 0:00:00 | 0:00:00 | 0:00:00 | 3:30:00 | 0 | 0 | 0 | 1
 | robpart5V3 | X |  | Right Arm | Forearm | 300 | 5 | 2 | 10% | No | robpart5V3.gcode | 4:25:00 | First |  |  |  | Quitar Brim y soporte temporal central. Repasar agujeros externos con broca 3mm. Limar un poco los dientes interiores para asegurar que encaja RobServoBedV5 en su interior. | 0:05:00 | 0:00:00 | 0:00:00 | 0:00:00 | 4:25:00 | 0 | 0 | 0 | 1
 | RobServoBedV5 | X |  | Right Arm | Forearm | 300 | 0 | 3 | 30% | No | RobServoBedV5.gcode | 2:50:00 | Mech |  |  |  | Trim/Fill the holes of the simple servo bed if there is overhang
 | servo-pulleyX5 | X |  | Right Arm | Forearm | 300 | 0 | 3 | 30% | No | servo-pulleyX5.gcode | 0:30:00 | Mech | SetForearmR1.gcode | 1:30:00 |  | Repasar los agujeros de paso del hilo con broca 2mm
 | Auriculaire3 |  |  | Right Arm | Hand | 300 | 0 | 2 | 10% | No | Auriculaire3.gcode | 1:15:00 | First |  |  |  | Quitar Brim. Repasar perforaciones con broca 3mm. | 0:02:00 | 0:00:00 | 0:00:00 | 0:00:00 | 1:15:00 | 0 | 0 | 0 | 1
 | coverfinger1 |  |  | Right Arm | Hand | 300 | 4 | 3 | 10% | Yes | coverfinger.gcode | 0:40:00 | First |  |  |  | Nada |  | 0:00:00 | 0:00:00 | 0:00:00 | 0:40:00 | 0 | 0 | 0 | 1
 | Index3 |  |  | Right Arm | Hand | 300 | 0 | 2 | 10% | No | Index3.gcode | 1:15:00 | First |  |  |  | Quitar Brim. Repasar perforaciones con broca 3mm. | 0:02:00 | 0:00:00 | 0:00:00 | 0:00:00 | 1:15:00 | 0 | 0 | 0 | 1
 | Majeure3 |  |  | Right Arm | Hand | 300 | 0 | 2 | 10% | No | Majeure3.gcode | 1:15:00 | First |  |  |  | Quitar Brim. Repasar perforaciones con broca 3mm. | 0:02:00 | 0:00:00 | 0:00:00 | 0:00:00 | 1:15:00 | 0 | 0 | 0 | 1
 | ringfinger3 |  |  | Right Arm | Hand | 300 | 0 | 2 | 10% | No | ringfinger3.gcode | 1:00:00 | First |  |  |  |  | 0:05:00 | 0:00:00 | 0:00:00 | 0:00:00 | 1:00:00 | 0 | 0 | 0 | 1
 | thumb5 |  |  | Right Arm | Hand | 300 | 0 | 2 | 10% | No | thumb5.gcode | 1:20:00 | First |  |  |  |  | 0:05:00 | 0:00:00 | 0:00:00 | 0:00:00 | 1:20:00 | 0 | 0 | 0 | 1
 | topsurface4 |  |  | Right Arm | Hand | 300 | 0 | 2 | 10% | No | topsurface4.gcode | 1:40:00 | First |  |  |  | Quitar support | 0:05:00 | 0:00:00 | 0:00:00 | 0:00:00 | 1:40:00 | 0 | 0 | 0 | 1
 | WristlargeV4 |  |  | Right Arm | Hand | 300 | 0 | 2 | 10% | No | WristlargeV4.gcode | 2:30:00 | First |  |  |  | Quitar rebabas de base. Repasar perforaciones | 0:05:00 | 0:00:00 | 0:00:00 | 0:00:00 | 2:30:00 | 0 | 0 | 0 | 1
 | WristsmallV3 |  |  | Right Arm | Hand | 300 | 0 | 2 | 10% | No | WristsmallV3.gcode | 1:00:00 | First |  |  |  | Quitar Brim. Repasar perforaciones con broca 3mm. | 0:02:00 | 0:00:00 | 0:00:00 | 0:00:00 | 1:00:00 | 0 | 0 | 0 | 1
 | ardiuinosupport |  |  | Right Arm | Other | 300 | 0 | 1 | 10% | No | ardiuinosupport.gcode | 0:25:00 | First |  |  |  | Nada | 0:00:00 | 0:00:00 | 0:00:00 | 0:00:00 | 0:25:00 | 0 | 0 | 0 | 1
 | robcap3V1 |  |  | Right Arm | Forearm | 300 | 0 | 2 | 10% | No | robcap3V1.gcode | 1:00:00 | Second |  |  |  | Quitar rebabas de base. Repasar perforaciones | 0:05:00 | 0:00:00 | 0:00:00 | 0:00:00 | 1:00:00 | 0 | 0 | 0 | 1
 | ClaviBackV2 |  |  | Right Arm | Shoulder | 300 | 0 | 4 | 10% | No | ClaviBackV2.gcode | 1:10:00 | First |  |  |  |  | 0:05:00 | 0:00:00 | 0:00:00 | 0:00:00 | 1:10:00 | 0 | 0 | 0 | 1
 | ClaviFrontV2 |  |  | Right Arm | Shoulder | 300 | 0 | 4 | 10% | No | ClaviFrontV2.gcode | 1:15:00 | First |  |  |  | Repasar perforaciones con broca 3mm. Repasar helice para que entre en PistonBaseAnti | 0:10:00 | 0:00:00 | 0:00:00 | 0:00:00 | 1:15:00 | 0 | 0 | 0 | 1
 | PistonbaseV4 |  |  | Right Arm | Shoulder | 300 | 0 | 4 | 10% | No | PistonbaseV4.gcode | 2:00:00 | Mech |  |  |  | Quitar las rebabas de base de las arandelas de fijación | 0:02:00 | 0:00:00 | 0:00:00 | 0:00:00 | 2:00:00 | 0 | 0 | 0 | 1
 | PistonClaviV2 |  |  | Right Arm | Shoulder | 200 | 0 | 3 | 100% | No | PistonClaviV2.gcode | 3:20:00 | Second |  |  |  |  | 0:05:00 | 0:00:00 | 0:00:00 | 0:00:00 | 3:20:00 | 0 | 0 | 0 | 1
 | PivcenterV1 |  |  | Right Arm | Shoulder | 300 | 0 | 2 | 10% | No | PivcenterV1.gcode | 2:50:00 | Mech |  |  |  | Quitar rebabas de base. Repasar perforaciones | 0:05:00 | 0:00:00 | 0:00:00 | 0:00:00 | 2:50:00 | 0 | 0 | 0 | 1
 | PivConnectorV1 |  |  | Right Arm | Shoulder | 300 | 0 | 2 | 10% | No | PivConnectorV1.gcode | 0:40:00 | Mech | PivConnectorV1x2.gcode | 1:15:00 | 2 pieces printed in set | Quitar rebabas de base. Repasar perforaciones | 0:05:00 | 0:00:00 | 0:00:00 | 0:00:00 | 0:40:00 | 0 | 0 | 0 | 1
 | PivGearV3 |  |  | Right Arm | Shoulder | 300 | 0 | 4 | 10% | No | PivGearV3.gcode | 1:40:00 | Mech | SetShoR2.gcode | 3:00:00 |  |  | 0:05:00 | 0:00:00 | 0:00:00 | 0:00:00 | 1:40:00 | 0 | 0 | 0 | 1
 | PivMitV1 |  |  | Right Arm | Shoulder | 300 | 0 | 2 | 10% | No | PivMitV1.gcode | 1:40:00 | Mech | SetShoR1.gcode | 3:00:00 |  | Quitar rebabas de base. Repasar perforaciones | 0:05:00 | 0:00:00 | 0:00:00 | 0:00:00 | 1:40:00 | 0 | 0 | 0 | 1
 | PivPotentioV2 |  |  | Right Arm | Shoulder | 300 | 0 | 2 | 10% | No | PivPotentioV2.gcode | 0:10:00 | Mech | SetShoR2.gcode | 3:00:00 |  |  | 0:05:00 | 0:00:00 | 0:00:00 | 0:00:00 | 0:10:00 | 0 | 0 | 0 | 1
 | PivPotholderV2 |  |  | Right Arm | Shoulder | 300 | 0 | 2 | 10% | No | PivPotholderV2.gcode | 1:00:00 | Mech | SetShoR2.gcode | 3:00:00 |  |  | 0:05:00 | 0:00:00 | 0:00:00 | 0:00:00 | 1:00:00 | 0 | 0 | 0 | 1
 | PivTitV1 |  |  | Right Arm | Shoulder | 300 | 0 | 2 | 10% | No | PivTitV1.gcode | 1:15:00 | Mech | SetShoR1.gcode | 3:00:00 |  |  | 0:05:00 | 0:00:00 | 0:00:00 | 0:00:00 | 1:15:00 | 0 | 0 | 0 | 1
 | PivWormV2 |  |  | Right Arm | Shoulder | 200 | 0 | 3 | 100% | No | PivWormV2.gcode | 2:20:00 | Mech |  |  |  |  | 0:05:00 | 0:00:00 | 0:00:00 | 0:00:00 | 2:20:00 | 0 | 0 | 0 | 1
 | servoholderV1 |  |  | Right Arm | Shoulder | 300 | 0 | 4 | 10% | No | servoholderV1.gcode | 1:05:00 | First |  |  |  |  | 0:05:00 | 0:00:00 | 0:00:00 | 0:00:00 | 1:05:00 | 0 | 0 | 0 | 1
 | servoHolsterV1 |  |  | Right Arm | Shoulder | 300 | 0 | 2 | 10% | Yes | servoHolsterV1.gcode | 1:10:00 | Mech |  |  |  |  | 0:05:00 | 0:00:00 | 0:00:00 | 0:00:00 | 1:10:00 | 0 | 0 | 0 | 1
 | Bolt_entretoise6 |  |  | Right Arm | Wrist | 300 | 10 | 2 | 10% | No | Bolt_entretoise6.gcode | 2:00:00 | Second |  |  |  |  | 0:05:00 | 0:00:00 | 0:00:00 | 0:00:00 | 2:00:00 | 0 | 0 | 0 | 1
 | cableholderwristV4 | X |  | Right Arm | Wrist | 300 | 0 | 2 | 10% | No | cableholderwristV4.gcode | 0:15:00 | Mech |  |  |  | Si las perforaciones de los cables tensores no son limpias, limpiar con broca de 1,2mm. Repasar con la punta de navaja para suavizar bordes cortantes del hilo | 0:05:00 | 0:00:00 | 0:00:00 | 0:00:00 | 0:15:00 | 0 | 0 | 0 | 1
 | rotawrist1V3 |  |  | Right Arm | Wrist | 300 | 0 | 2 | 10% | No | rotawrist1V3.gcode | 2:10:00 | First | SetWristR1.gcode | 3:00:00 |  | Quitar la pieza de support interior con un alicate. Repasar los agujetos para los hilos tensores con broca 3mm. Limar rebabas interiores de base. Repasar agujeros externos con broca 2,5mm | 0:05:00 | 0:00:00 | 0:00:00 | 0:00:00 | 2:10:00 | 0 | 0 | 0 | 1
 | rotawrist2 |  |  | Right Arm | Wrist | 300 | 0 | 2 | 10% | No | rotawrist2.gcode | 1:15:00 | Second |  |  |  | Limar interior hueco grande para que quepa sin problemas WristGearsV4 ya preparada. Repasar agujero pequeño con broca 7mm. | 0:05:00 | 0:00:00 | 0:00:00 | 0:00:00 | 1:15:00 | 0 | 0 | 0 | 1
 | rotawrist3V2 |  |  | Right Arm | Wrist | 300 | 0 | 2 | 10% | No | rotawrist3V2.gcode | 0:45:00 | First | SetWristR1.gcode | 3:00:00 |  | Repasar hueco eje con broca 8mm. Limar interior hueco grande para que quepa WristGearsV4 ya preparada | 0:05:00 | 0:00:00 | 0:00:00 | 0:00:00 | 0:45:00 | 0 | 0 | 0 | 1
 | WristGearsV4 | X |  | Right Arm | Wrist | 100 | 0 | 3 | 30% | No | WristGearsV4.gcode | 1:52:00 | Mech |  |  |  | El engranaje pequeño se tira. En el mediano se repasa con navaja el hueco del eje del servo para remarcar los dientes internos. En el grande se lima exteriormente el eje para redondear totalmente la forma poligonal. Repasar agujeros de hilo tensor con broca 2mm y avellanar un poco con navaja para evitar bordes cortantes del hilo | 0:05:00 | 0:00:00 | 0:00:00 | 0:00:00 | 1:52:00 | 0 | 0 | 0 | 1
 | BatteryHolderLeftV1 |  |  | Trunk | Back | 300 | 0 | 2 | 10% | No | BatteryHolderLeftV1.gcode | 1:20:00 | First | BattHolder.gcode | 2:40:00 |  |  | 0:05:00 | 0:00:00 | 1:20:00 | 0:00:00 | 0:00:00 | 0 | 1 | 0 | 0
 | BatteryHolderRightV1 |  |  | Trunk | Back | 300 | 0 | 2 | 10% | No | BatteryHolderRightV1.gcode | 1:20:00 | First | BattHolder.gcode | 2:40:00 |  |  | 0:05:00 | 0:00:00 | 1:20:00 | 0:00:00 | 0:00:00 | 0 | 1 | 0 | 0
 | BottomChestV1 | X |  | Trunk | Chest | 300 | 0 | 2 | 5% | No | BottomChestV1.gcode | 4:37:00 | Third |  |  |  | Quitar Brim. Repasar perforaciones con broca 3mm. | 0:02:00 | 0:00:00 | 4:37:00 | 0:00:00 | 0:00:00 | 0 | 1 | 0 | 0
 | ChestLeftV1 | X |  | Trunk | Chest | 300 | 0 | 2 | 10% | No | ChestLeftV1.gcode | 3:44:00 | Third |  |  |  | Quitar los support que hay bajo los ejes. Suavizar el interior de la rosca para PistonAntiClock. Suavizar los ejes. | 0:10:00 | 0:00:00 | 3:44:00 | 0:00:00 | 0:00:00 | 0 | 1 | 0 | 0
 | ChestRightV1 | X |  | Trunk | Chest | 300 | 0 | 2 | 10% | No | ChestRightV1.gcode | 3:44:00 | Third |  |  |  |  | 0:05:00 | 0:00:00 | 3:44:00 | 0:00:00 | 0:00:00
 | ChestTopAttachV1 | X |  | Trunk | Chest | 300 | 0 | 2 | 10% | No | ChestTopAttachV1.gcode | 0:37:00 | Third |  |  |  | Quitar Brim. Repasar perforaciones con broca 3mm. | 0:02:00 | 0:00:00 | 0:37:00 | 0:00:00 | 0:00:00 | 0 | 1 | 0 | 0
 | ChestTopV1 | X |  | Trunk | Chest | 300 | 5 | 2 | 10% | No | ChestTopV1.gcode | 3:09:00 | Third |  |  |  | Quitar Brim. Repasar perforaciones con broca 3mm. | 0:02:00 | 0:00:00 | 3:09:00 | 0:00:00 | 0:00:00 | 0 | 1 | 0 | 0
 | InMLeftV1 | X |  | Trunk | Chest | 300 | 0 | 2 | 10% | No | InMLeftV1.gcode | 2:10:00 | Third | SetChest1 | 3:00:00 |  |  | 0:05:00 | 0:00:00 | 2:10:00 | 0:00:00 | 0:00:00 | 0 | 1 | 0 | 0
 | InMrightV1 | X |  | Trunk | Chest | 300 | 0 | 2 | 10% | Yes | InMrightV1.gcode | 2:10:00 | Third | SetChest1 | 3:00:00 |  |  | 0:05:00 | 0:00:00 | 2:10:00 | 0:00:00 | 0:00:00 | 0 | 1 | 0 | 0
 | MiddleChestV1 |  |  | Trunk | Chest | 300 | 5 | 2 | 10% | No | MiddleChestV1.gcode | 2:15:00 | Third |  |  | Sustituir por modelo con PIR |  | 0:05:00 | 0:00:00 | 2:15:00 | 0:00:00 | 0:00:00 | 0 | 1 | 0 | 0
 | UnderKinectV1 | X |  | Trunk | Chest | 300 | 0 | 2 | 10% | Yes | UnderKinectV1.gcode | 3:00:00 | Third |  |  |  |  | 0:05:00 | 0:00:00 | 3:00:00 | 0:00:00 | 0:00:00 | 0 | 1 | 0 | 0
 | ChestLowV1 | X |  | Trunk | Torso | 300 | 0 | 4 | 10% | No | ChestLowV1.gcode | 0:30:00 | First | ChestLowV1x2.gcode | 1:00:00 | Two pieces in the set file |  | 0:05:00 | 0:00:00 | 0:30:00 | 0:00:00 | 0:00:00 | 0 | 1 | 0 | 0
 | HomLowBack-V1 | X |  | Trunk | Torso | 300 | 0 | 4 | 10% | No | HomLowBack-V1.gcode | 1:10:00 | First | HomLowBack-V1x2.gcode | 2:30:00 | Two pieces in the set file |  | 0:05:00 | 0:00:00 | 1:10:00 | 0:00:00 | 0:00:00 | 0 | 1 | 0 | 0
 | HomLowFront-V1 | X |  | Trunk | Torso | 300 | 0 | 4 | 10% | No | HomLowFront-V1.gcode | 1:10:00 | First | HomLowFront-V1x2.gcode | 2:30:00 | Two pieces in the set file |  | 0:05:00
 | homplateback+V1 | X |  | Trunk | Torso | 300 | 0 | 4 | 10% | No | homplateback+V1.gcode | 1:00:00 | First | TorsoSet3.gcode | 3:50:00 |  | Quitar los support que hay bajo los ejes. Suavizar el interior de la rosca para PistonClavi. Suavizar los ejes. | 0:10:00
 | homplatebacklow+V1 |  |  | Trunk | Torso | 300 | 0 | 4 | 10% | No | homplatebacklow+V1.gcode | 0:50:00 | First | TorsoSet2.gcode | 3:00:00 |  |  | 0:05:00 | 0:00:00 | 0:50:00 | 0:00:00 | 0:00:00 | 0 | 1 | 0 | 0
 | homplatebacklow-V1 |  |  | Trunk | Torso | 300 | 0 | 4 | 10% | No | homplatebacklow-V1.gcode | 0:50:00 | First | TorsoSet2.gcode | 3:00:00 |  |  | 0:05:00 | 0:00:00 | 0:50:00 | 0:00:00 | 0:00:00 | 0 | 1 | 0 | 0
 | homplateback-V1 |  |  | Trunk | Torso | 300 | 0 | 4 | 10% | No | homplateback-V1.gcode | 1:00:00 | First | TorsoSet1.gcode | 3:00:00 |  |  |  | 0:00:00 | 1:00:00 | 0:00:00 | 0:00:00 | 0 | 1 | 0 | 0
 | homplatefront+V1 |  |  | Trunk | Torso | 300 | 0 | 4 | 10% | No | homplatefront+V1.gcode | 1:00:00 | First | TorsoSet1.gcode | 3:00:00
 | homplatefront-V1 | X |  | Trunk | Torso | 300 | 0 | 4 | 10% | No | homplatefront-V1.gcode | 1:00:00 | First | TorsoSet3.gcode | 3:50:00 |  |  | 0:05:00 | 0:00:00 | 1:00:00 | 0:00:00 | 0:00:00 | 0 | 1 | 0 | 0
 | InterKinectMidV1 | X |  | Trunk | Torso | 300 | 0 | 4 | 10% | No | InterKinectMidV1.gcode | 0:50:00 | First | InterKinectMidV1x2.gcode | 2:00:00 | Two pieces in the set file | Repasar agujero mayor con broca 3mm | 0:05:00
 | InterKinectSideV1 | X |  | Trunk | Torso | 300 | 0 | 4 | 10% | No | InterKinectSideV1.gcode | 0:40:00 | First | InterKinectSideV1x2.gcode | 1:20:00 | Two pieces in the set file |  | 0:05:00 | 0:00:00 | 0:40:00 | 0:00:00 | 0:00:00
 | KinectMidBackV1 | X |  | Trunk | Torso | 300 | 0 | 4 | 10% | No | KinectMidBackV1.gcode | 1:40:00 | First | TorsoSet3.gcode | 3:50:00 |  |  |  | 0:00:00 | 1:40:00 | 0:00:00 | 0:00:00 | 0 | 1 | 0 | 0
 | KinectMidFrontV1 |  |  | Trunk | Torso | 300 | 0 | 4 | 10% | No | KinectMidFrontV1.gcode | 0:50:00 | First | TorsoSet1.gcode | 3:00:00 |  |  | 0:05:00 | 0:00:00 | 0:50:00 | 0:00:00 | 0:00:00 | 0 | 1 | 0 | 0
 | KinectSideBackV1 | X |  | Trunk | Torso | 300 | 0 | 4 | 10% | No | KinectSideBackV1.gcode | 1:40:00 | First | KinectSideBackV1x2.gcode | 3:30:00 | Two pieces in the set file |  | 0:05:00 | 0:00:00 | 1:40:00 | 0:00:00 | 0:00:00 | 0 | 1 | 0 | 0
 | KinectSideHolderV1 | X |  | Trunk | Torso | 300 | 5 | 4 | 10% | No | KinectSideHolderV1.gcode | 1:15:00 | First | KinectSideHolderV1x2.gcode | 2:30:00 | Two pieces in the set file | Quitar brim. Repasar perforaciones con broca 3mm. Repasar helice para que entre en PistonBase | 0:10:00 | 0:00:00 | 1:15:00 | 0:00:00 | 0:00:00 | 0 | 1 | 0 | 0
 | servoHolsterV1 |  |  | Trunk | Torso | 300 | 0 | 4 | 10% | Yes | servoHolsterV1.gcode | 1:10:00 | First |  |  |  |  | 0:05:00 | 0:00:00 | 1:10:00 | 0:00:00 | 0:00:00 | 0 | 1 | 0 | 0
 | SternumV1 |  |  | Trunk | Torso | 300 | 0 | 4 | 10% | No | SternumV1.gcode | 1:00:00 | First | TorsoSet2.gcode | 3:00:00 |  |  | 0:05:00 | 0:00:00 | 1:00:00 | 0:00:00 | 0:00:00 | 0 | 1 | 0 | 0
 | ThroatLowerV1 | X |  | Trunk | Torso | 300 | 0 | 4 | 10% | No | ThroatLowerV1.gcode | 1:00:00 | First | ThroatLowerV1x2.gcode | 2:00:00 | Two pieces in the set file | Quitar Support. Repasar perforaciones con broca 3mm. Repasar ejes. Limar algo borde base servo para que entre. | 0:05:00 | 0:00:00 | 1:00:00 | 0:00:00 | 0:00:00 | 0 | 1 | 0 | 0

Sheet: Preparativos adicionales
Trucaje servos biceps (2 por brazo) | http://www.inmoov.fr/bicep/

Sheet: Costs & Materials
Costs & Materials
Item | Used |  |  |  |  |  |  | Cost |  | Distributor | Webpage |  | Coments
 | Left arm | Right arm | Trunk | Head and Neck | Top Stomach | Mid Stomach | TOTAL | Cost per unit | Cost per robot |  |  | Sust
PLA Reel 1Kg | 1 | 1 | 1 | 1 |  |  | 4 | 25 € | 100 €
MiniServos DS929HV |  |  |  | 3 |  |  | 3 | 7 € | 21 € | HobbyKing | http://tinyurl.com/pd32u5e | http://tinyurl.com/noscumh | Corona DS929HV (7.4v) MG Digital Servo 2.4kg/ 12.5g/ 0.09sec. Posible sustituto: HXT900 más barato
Servo 1/4 scale HS-805BB | 4 | 4 | 1 | 1 | 2 |  | 12 | 35 € | 420 € | HobbyKing | http://tinyurl.com/nnmhkor | http://www.rcradical.com/es/todos/866-hs-805bb-mega-servo-.html | Hitec HS-805BB Mega 1/4 Scale servo 19.8kg/152g/0.19sec
Servo HK15298 | 5 | 5 |  | 1 |  |  | 11 | 19 € | 209 € | HobbyKing | http://tinyurl.com/ofz3os4 | http://cgi.ebay.es/ws/eBayISAPI.dll?ViewItem&item=151241723625 | HK15298 High Voltage Coreless Digital MG/BB Servo 66g / 15kg / 0.11s. 90 degrees rotation. Alternative: MG946r
Servo MG996 | 1 | 1 |  |  |  |  | 2 | 10 € | 20 € | HobbyKing | http://tinyurl.com/ns7dm4r | http://cgi.ebay.es/ws/eBayISAPI.dll?ViewItem&item=161254736735 | Towerpro MG996R 10kg Servo 55g / 10kg / .20sec. 180 degree rotation
Servo Vigor VSD-11AYMB |  |  |  |  |  | 2 | 2 | 20 € | 40 € | HobbyKing | http://tinyurl.com/zm86wd2
Arduino |  |  | 2 |  |  |  | 2 | 15 € | 30 €
Other electronics |  |  | 1 |  |  |  | 1 | 30 € | 30 €
Hardware (nuts, bolts, cables,bicomponent, grease..) | 1 | 1 | 1 | 1 | 1 | 1 | 6 | 10 € | 60 €
Braided fish line 200LB | 10% | 10% |  |  |  |  | 20% | 30 € | 6 € | eBay | http://tinyurl.com/pc9chzv
Sensors (Pir, ..) |  |  | 1 |  |  |  | 1 | 15 € | 15 €
Cameras |  |  |  | 2 |  |  | 2 | 40 € | 80 €
Video converter usb |  |  |  | 1 |  |  | 1 | 20 € | 20 €
Base |  |  | 1 |  |  |  | 1 | 100 € | 100 €
Altavoz USB |  |  |  | 1 |  |  | 1 | 20 € | 20 €
Hub USB |  |  |  |  |  |  | 0 | 20 € | 0 €
Kinect |  |  | 1 |  |  |  | 1 | 85 € | 85 € | eBay
Author donation | 1 | 1 | 1 | 1 | 1 | 1 | 6 | 25 € | 150 €
Printer usage & Electricity | 88 | 88 | 46 | 65 |  |  | 287 | 1.1 € | 315.7 €
Trabajo PostImpresión (15€/h) | 4.6 | 4.6 | 1.0 | 3.0 |  |  | 13.2 | 15 € | 197.5 €
Packaging & Documentation printing | 1 | 1 | 1 | 1 |  |  | 4 | 10 € | 40 €
COSTE PRODUCCIÓN | 483.55 € | 483.55 € | 430.6 € | 381.5 € | 105 € | 75 € |  |  | 1963.2 €
PVP (sin iva) |  |  |  |  |  |  |  |  | 3000 € | 152.8117359%
Total beneficio (inc. horas trabajo) |  |  |  |  |  |  |  |  | 1234.3 €
Production controls
Printed pieces | 55 | 55 | 12 | 36 |  |  | 158
Printing time | 92:08:00 | 92:53:00 | 29:46:00 | 69:00:00 |  |  | 283:47:00 |  |  |  | 8.928571429
 |  |  |  |  |  |  |  |  |  |  | 12.5
Montaje robot mecánica (15€/h) | 4.6 | 4.6 | 1.0 | 3.0 |  |  | 13.2 | 15 € | 197.5 €
Montaje robot electrónica (15€/h) | 3 | 3 | 3 | 3 |  |  | 12 | 15 € | 180 €
Maleta y material extra |  |  |  |  |  |  |  |  | 200 €
COSTE MONTAJE |  |  |  |  |  |  |  |  | 577.5 €
PVP (in iva) |  |  |  |  |  |  |  |  | 700 €
Total beneficio (inc. horas trabajo) |  |  |  |  |  |  |  |  | 500 €
Curso Invención con Arduino |  |  |  |  |  |  | 28.0 | 20 € | 560 €
Curso de robótica avanzada |  |  |  |  |  |  | 74.0 | 20 € | 1480 €
 |  |  |  |  |  |  |  |  | 0 €
Material formativo |  |  |  |  |  |  |  |  | 200 €
FORMACIÓN |  |  |  | Horas |  |  | 102.0 | Coste | 2240 €
PVP (in iva) |  |  |  |  |  |  |  |  | 950 €
Total beneficio (inc. horas trabajo) |  |  |  |  |  |  |  |  | 750 €
 |  |  |  |  |  |  |  |  | 3950 €

Sheet: Colors
Color code | Color | Notes
First | White | used in general visible parts of the body
Mech | Gray | Used in internal mechanisms
Second | Gray | Used in some parts as a second color for visible parts
Third | Translucent | used in some parts as third color

Sheet: Hardware Map
Grupo | Parte | Arduino Uno | Arduino Mega | Pin | Pos.Min | Pos.Rest | Pos.Max
Hand & Wrist | Thumb | X Right | X Left | 2
 | Index | X Right | X Left | 3
 | Majeure | X Right | X Left | 4
 | RingFinger | X Right | X Left | 5
 | Pinky | X Right | X Left | 6
 | Wrist | X Right | X Left | 7
Arm | Bicep | X Right | X Left | 8
 | Rotate | X Right | X Left | 9
 | Shoulder | X Right | X Left | 10
 | Omoplate | X Right | X Left | 11
Head | Neck |  | X | 12 | 32 | 100 | 175 | Amarillo gordo
 | RothHead |  | X | 13 | 30 | 90 | 150 | amarillo
 | Jaw |  | X | 26 | 10 | 10 | 25 | verde
 | EyeX |  | X | 22 | 60 | 80 | 100 | azul
 | EyeY |  | X | 24 | 50 | 90 | 100 | morado

Sheet: Material formativo
Formación
 | Material formador o general
 |  | Osciloscopio
 |  | Dremel
 |  | Herramientas caras |  |  | Batas o delantales
 |  | Soldador |  |  | Papel para limpiarse
 |  |  |  |  | Gafas de protección
 |  |  |  |  | Guantes
 |  | Material curso robótica avanzada | Coste total | Notas
 |  | Impresión y preparación piezas 3D | 1386.308068 € | 158 piezas impresas y reformadas
 |  | Motores | 1023.838631 € | 24 motores
 |  | Material electrónico vario | 336.1858191 € | Sensores, tarjetas de control,…
 |  | Material mecánico vario | 253.6674817 € | Tornillería, soportes,..
 |  | Material formativo 15 alumnos (5 grupos de 3) | 453 € | Detallado su contenido en la tabla de abajo
 |  | TOTAL | 0 €
 |  | Material formativo | Coste total | Notas
 |  | Polímetros | 35 € | Medición voltaje, corriente, resistencia,..
 |  | Testers servos | 6 € | Prueba de servos
 |  | Set herramientas (Destornilladores, alicates, tijeras, cortadores, pegamento, cinta aislante..) | 45 € | Herramientas varias
 |  | Placas Arduino Uno | 65 € | Placa de programación
 |  | Arduino Protoshield | 40 € | Placa para montar prototipos
 |  | Set de cablecillos breadboard | 15 € | Cables de prototipado
 |  | Componentes: Resistencias, condensadores, Leds, diodos, Zumbador, transistor, sensor temperatura, potenciómetro, sensor luz resistivo, pulsadores, bumpers, relé. | 50 € | Componentes electrónicos
 |  | Cajas clasificadoras de componentes | 20 € | Caja para componentes
 |  | Motores DC | 20 € | Motor de corriente continua
 |  | Servomotores | 30 € | Servomotor
 |  | Alimentadores de corriente | 60 € | Fuente de alimentación 9v
 |  | Sensores PIR | 6 € | Sensor de presencia
 |  | Teclados matriciales | 6 € | Teclado numérico
 |  | Acelerómetros | 10 € | Sensor de aceleración
 |  | Joysticks | 3 € | Joystick XY
 |  | Pantallas LCD serie | 15 € | Display alfanumérico
 |  | Sensores de presión | 7 € | Sensor de presión
 |  | Sensores de inclinación | 4 € | Sensor inclinación
 |  | Sensores apertura de puertas | 4 € | Sensores apertura de puertas
 |  | Diodos led tricolor | 4 € | Diodos led tricolor
 |  | Altavoces | 4 € | Altavoces
 |  | Barras de leds | 4 € | Barras de leds
 |  | TOTAL | 453 €

Sheet: Curso
Programa del Curso de Robótica Avanzada
Sesión | Módulo | Tema | Actividad
1 | Módulo 1 - Taller de sistemas microcontrolados y robótica | Conceptos robótica, automatización y sistemas microcontrolados | Conceptos generales, con demo de robots y sistemas microcontrolados
2 |  | Conceptos de electrónica I. Voltaje y corriente | Conceptos de voltaje y corriente. Uso de polímetro, fuente de alimentación y protoboard,..
3 |  | Conceptos de electrónica II. Componentes básicos | Resistencias, condensadores y transistores
4 |  | Conceptos de electrónica III. Sensores | Uso de sensores varios y medición con polímetro
5 |  | Conceptos de electrónica IV. Tipos de señales | Las señales analógicas y las señales digitales. Uso del osciloscopio
6 |  | Conceptos de electrónica V. Los microcontroladores | El arduino, lo que hace, la electrónica digital en general.
7 |  | Programación de microcontroladores I | Conceptos básicos de programación. El entorno Arduino
8 |  | Programación de microcontroladores II | 1er programa. Encender y parpadear un led
9 |  | Programación de microcontroladores III | 2º programa. Enviar texto al ordenador
10 |  | Programación de microcontroladores IV | 3er progrma. Leer sensores
11 |  | Programación de microcontroladores V | 4º programa. PWM. Servos y motores
12 |  | Programación de microcontroladores VI | 5º programa. Sistema sensor-actuador
13 |  | Proyecto I | Proyecto de fin de módulo
14 |  | Proyecto II | Proyecto de fin de módulo
15 | MÓDULO 2 – Construcción de un robot humanoide | Introducción a los objetivos | Demo de Paul, Partes que lo componen, herramientas a utilizar, formación de grupos, entrega de documentación
16 |  | Montaje-I | Montaje del robot y conceptos de mecánica
17 |  | Montaje-II | Montaje del robot y conceptos de mecánica
18 |  | Montaje-III | Montaje del robot y conceptos de mecánica
19 |  | Montaje-IV | Montaje del robot y conceptos de electrónica
20 |  | Montaje-V | Montaje del robot y conceptos de electrónica
21 |  | Montaje-VI | Montaje del robot y conceptos de electrónica
22 |  | Montaje-VII | Montaje del robot y programación básica
23 |  | Programación-I | Programación básica del robot
24 |  | Programación-II | Programación básica del robot
25 | MÓDULO 3 – Control avanzado del robot humanoide | Introducción a los objetivos | Demo avanzada de Paul. Entorno de desarrollo
26 |  | Framework MRL-I | Conceptos del framework
27 |  | Framework MRL-II | Primer programa básico en el framework
28 |  | Framework MRL-III | Los módulos del framework
29 |  | Framework MRL-IV | Manejo de arduino desde el framework
30 |  | Lenguaje Python-I | Conceptos básicos del lenguaje de programación Python
31 |  | Lenguaje Python-II | Conceptos básicos del lenguaje de programación Python
32 |  | Lenguaje Python-III | Conceptos básicos del lenguaje de programación Python
33 |  | Módulo de control manual del robot | Manejo de módulos de MRL para control del robot
34 |  | Módulo de habla | Manejo de módulos de MRL para control del robot
35 |  | Módulo de seguimiento de objetos | Manejo de módulos de MRL para control del robot
36 |  | Módulo de control por voz | Manejo de módulos de MRL para control del robot
37 |  | Control completo del robot | Manejo de módulos de MRL para control del robot
