aalonsopuig/Inmoov_ROS2/hardware/Servos config.xlsx

Inmoov Servos connection & configuration
Group | Part | Con | Servo type | Arduino Mega (left) | Arduino Uno (Right) | Pin num. | Position Min (absolute) | Position Max (Absolute) | Position Rest (absolute) | Position Rest (Relative to 0-180)
Left Hand | Thumb | J | MG946R | X |  | 2
 | Index | I | MG946R | X |  | 3
 | Majeure | H | MG946R | X |  | 4
 | Ringfinger | G | MG946R | X |  | 5
 | Auriculaire | F | MG946R | X |  | 6
 | Wrist | E | MG996R | X |  | 7
Left Arm | Bicep | D | HX-805BB | X |  | 8
 | Rotate | C | HX-805BB | X |  | 9
 | Shoulder | B | HX-805BB | X |  | 10
 | Omoplate | A | HX-805BB | X |  | 11
Right Hand | Thumb | J | MG946R |  | X | 2
 | Index | I | MG946R |  | X | 3
 | Majeure | H | MG946R |  | X | 4
 | Ringfinger | G | MG946R |  | X | 5
 | Auriculaire | F | MG946R |  | X | 6
 | Wrist | E | MG996R |  | X | 7
Right Arm | Bicep | D | HX-805BB |  | X | 8
 | Rotate | C | HX-805BB |  | X | 9
 | Shoulder | B | HX-805BB |  | X | 10
 | Omoplate | A | HX-805BB |  | X | 11
Head | Neck |  | HX-805BB | X |  | 12
 | Rothead |  | HX-805BB | X |  | 13
 | Jaw |  | MG996R | X |  | 26
 | EyeX |  | DS929HV | X |  | 22
 | EyeY |  | DS929HV | X |  | 24
Stom | TopStom |  |  | X |  | 27
 | MidStom |  |  | X |  | 28
 | LowStom |  |  | X |  | 29
 | Led/neoR |  |  | X |  | 30
