aalonsopuig/Inmoov_ROS2/docs/assembly/Head and Neck/Face Parts/EyeglassV2_preview_featured.jpg

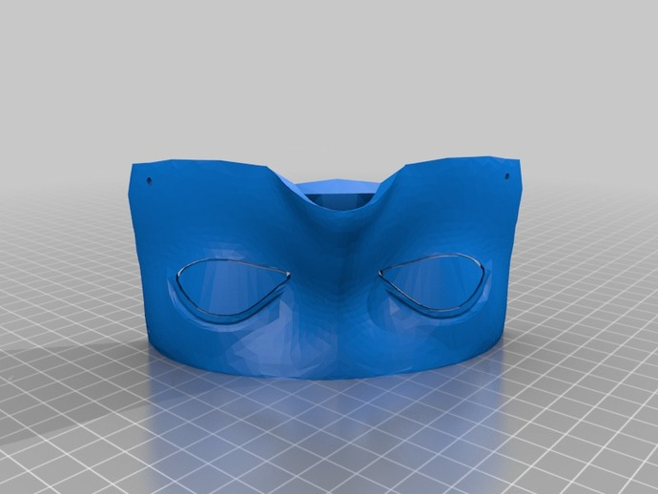
docs/assembly/Head and Neck/Face Parts/EyeglassV2_preview_featured.jpg
