aalonsopuig/Inmoov_ROS2/docs/assembly/Head and Neck/Face Parts/Inmoov5635_preview_featured.jpg

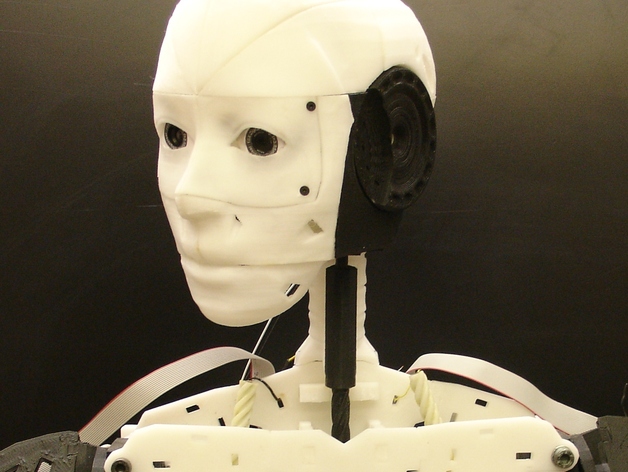
docs/assembly/Head and Neck/Face Parts/Inmoov5635_preview_featured.jpg
