aalonsopuig/Inmoov_ROS2/docs/assembly/Head and Neck/Face Parts/LowbackV2_preview_featured.jpg

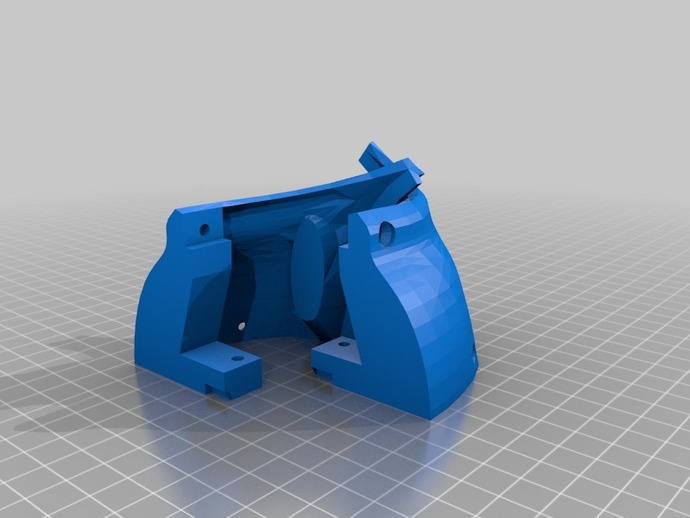
docs/assembly/Head and Neck/Face Parts/LowbackV2_preview_featured.jpg
