aalonsopuig/Inmoov_ROS2/docs/assembly/Head and Neck/Face Parts/TopMouthV2_preview_featured.jpg

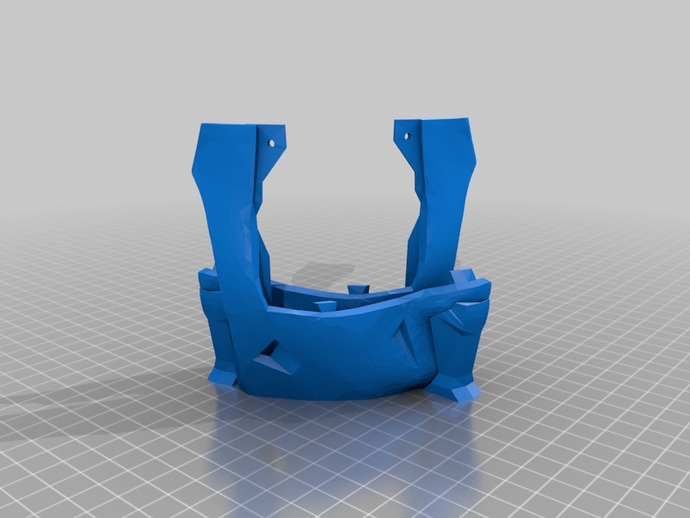
docs/assembly/Head and Neck/Face Parts/TopMouthV2_preview_featured.jpg
