aalonsopuig/Inmoov_ROS2/docs/assembly/Head and Neck/Skull parts/TopBackskullV1.png

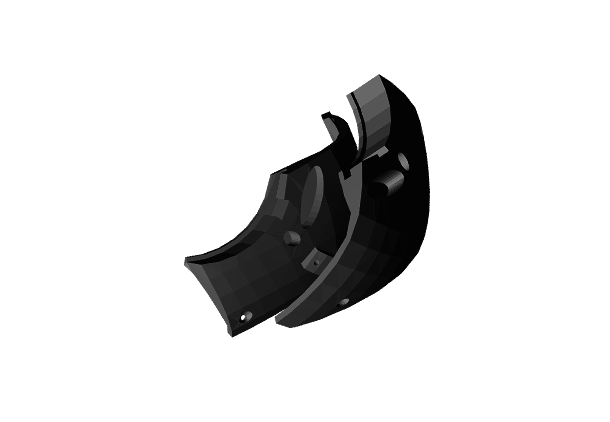
docs/assembly/Head and Neck/Skull parts/TopBackskullV1.png
