aalonsopuig/Inmoov_ROS2/docs/assembly/Head and Neck/Skull parts/TopskullLeftV3.png

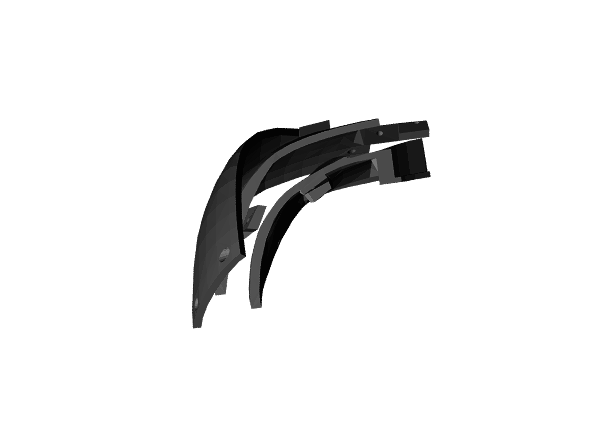
docs/assembly/Head and Neck/Skull parts/TopskullLeftV3.png
