aalonsopuig/Inmoov_ROS2/hardware/3d_parts/Head and Neck/Neck Mechanism/MainGearV1.stl

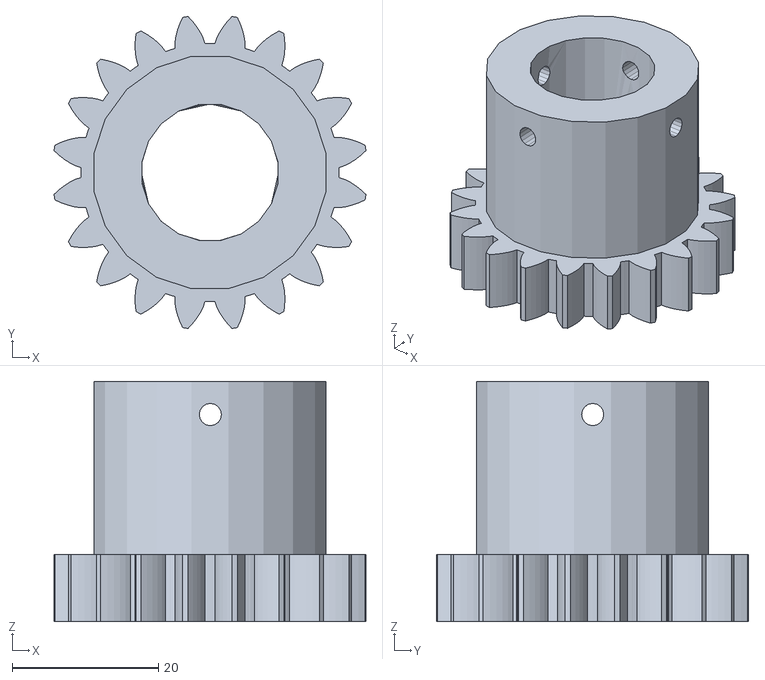
[picture p94: CAD file, 2026-03-08]
hardware/3d_parts/Head and Neck/Neck Mechanism/MainGearV1.stl
42.7 x 42.7 x 32.8
