aalonsopuig/Inmoov_ROS2/hardware/3d_parts/Head and Neck/Ears/EarRightV0.stl

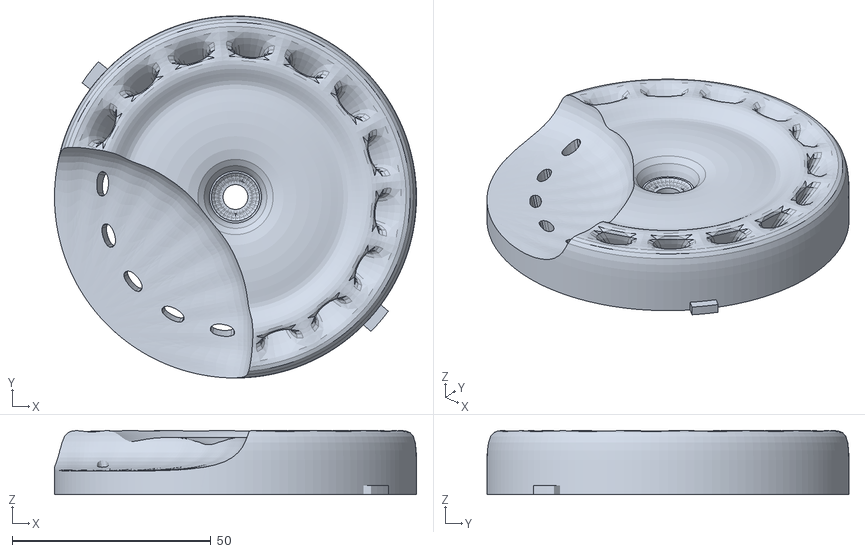
[picture p95: CAD file, 2026-03-08]
hardware/3d_parts/Head and Neck/Ears/EarRightV0.stl
91.0 x 91.0 x 16.1
