aalonsopuig/Inmoov_ROS2/hardware/3d_parts/Head and Neck/Eye mechanism/EyeBallV1.stl

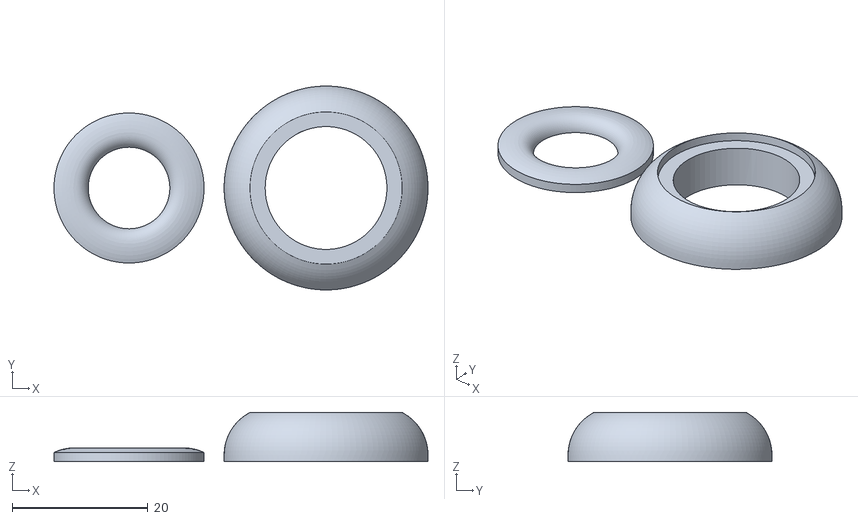
[picture p96: CAD file, 2026-03-08]
hardware/3d_parts/Head and Neck/Eye mechanism/EyeBallV1.stl
55.0 x 30.0 x 7.25
