aalonsopuig/Inmoov_ROS2/hardware/3d_parts/Head and Neck/Face Parts/TopMouthV2.stl

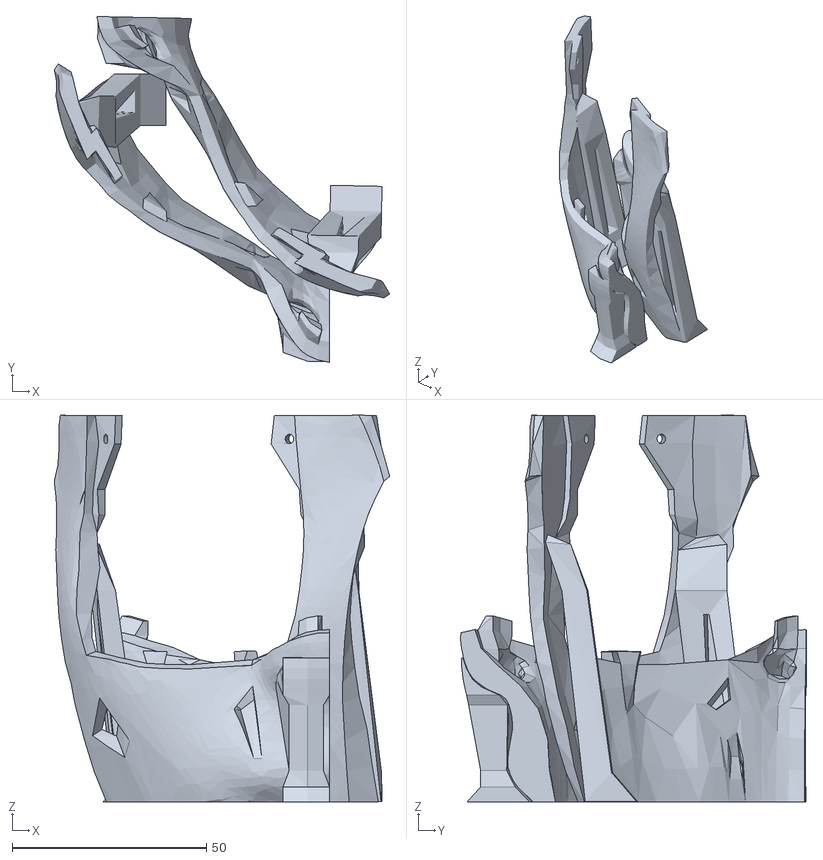
[picture p97: CAD file, 2026-03-08]
hardware/3d_parts/Head and Neck/Face Parts/TopMouthV2.stl
86.3 x 89.0 x 99.5
