aalonsopuig/Inmoov_ROS2/hardware/3d_parts/Head and Neck/Jaw Mechanism/JawHolderV1.stl

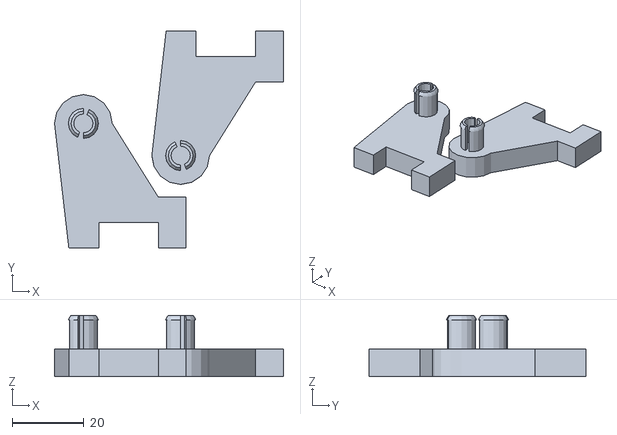
[picture p98: CAD file, 2026-03-08]
hardware/3d_parts/Head and Neck/Jaw Mechanism/JawHolderV1.stl
63.7 x 60.4 x 17.0
