aalonsopuig/Inmoov_ROS2/hardware/3d_parts/Head and Neck/Neck Mechanism/NeckHingeV1.stl

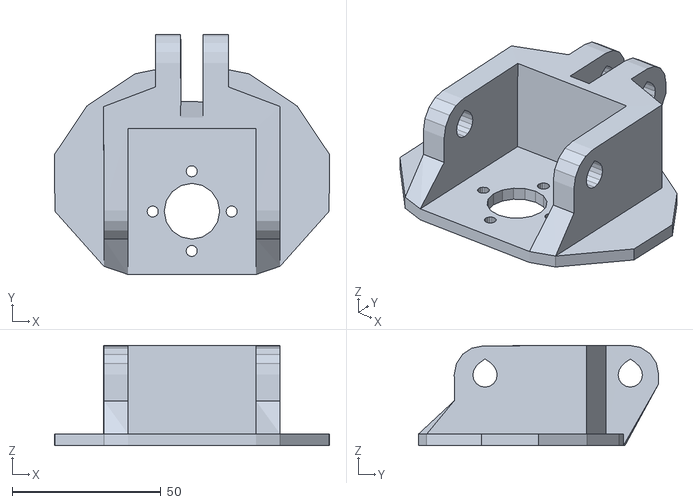
[picture p99: CAD file, 2026-03-08]
hardware/3d_parts/Head and Neck/Neck Mechanism/NeckHingeV1.stl
92.3 x 80.6 x 33.7
