aalonsopuig/Inmoov_ROS2/hardware/3d_parts/Head and Neck/Skull parts/TopskullLeftV3.stl

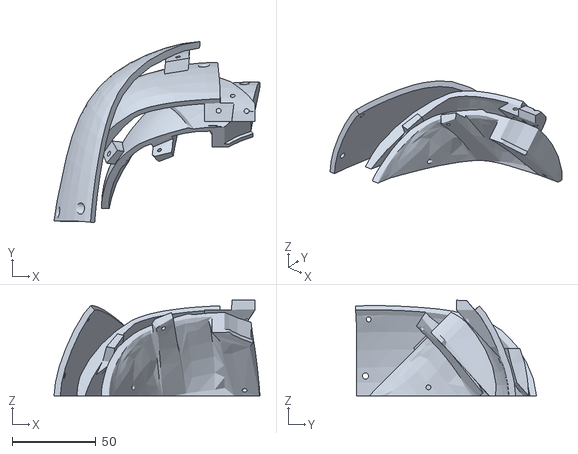
[picture p100: CAD file, 2026-03-08]
hardware/3d_parts/Head and Neck/Skull parts/TopskullLeftV3.stl
123.3 x 108.4 x 57.3
