aalonsopuig/Inmoov_ROS2/hardware/3d_parts/Left Arm/Bicep/servoholderV1.stl

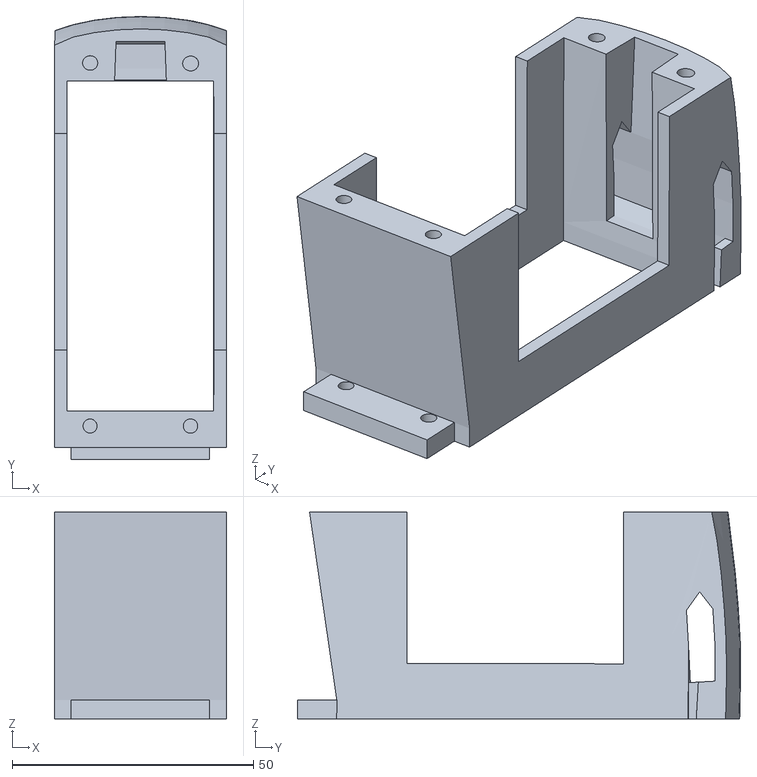
[picture p101: CAD file, 2026-03-08]
hardware/3d_parts/Left Arm/Bicep/servoholderV1.stl
35.8 x 91.9 x 42.9
