aalonsopuig/Inmoov_ROS2/hardware/3d_parts/Left Arm/Forearm/leftrobpart3V3.stl

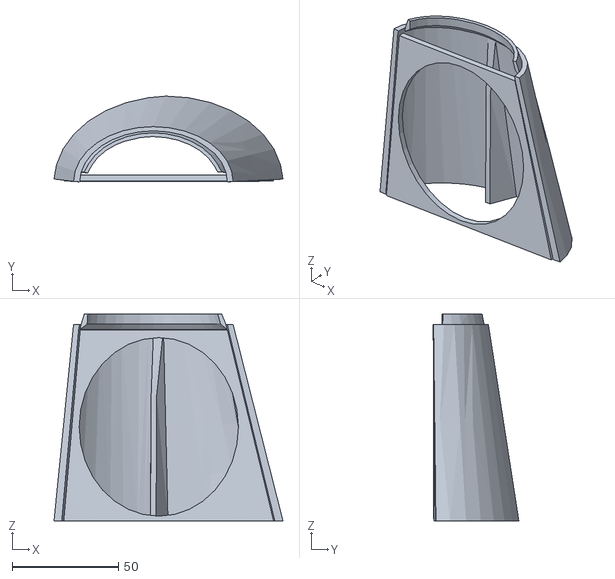
[picture p102: CAD file, 2026-03-08]
hardware/3d_parts/Left Arm/Forearm/leftrobpart3V3.stl
107.8 x 40.4 x 97.3
