aalonsopuig/Inmoov_ROS2/hardware/3d_parts/Left Arm/Hand/lefttopsurface4.stl

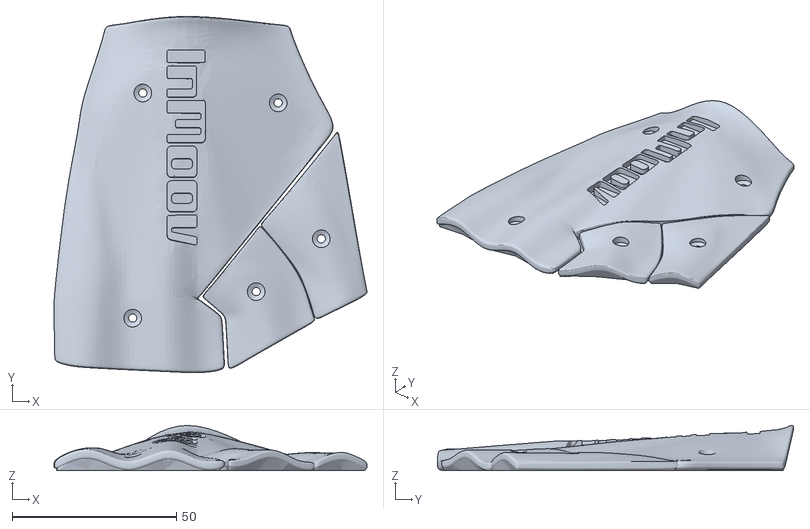
[picture p103: CAD file, 2026-03-08]
hardware/3d_parts/Left Arm/Hand/lefttopsurface4.stl
95.2 x 108.3 x 13.7
