aalonsopuig/Inmoov_ROS2/hardware/3d_parts/Left Arm/Other/leftrobcap3V1.stl

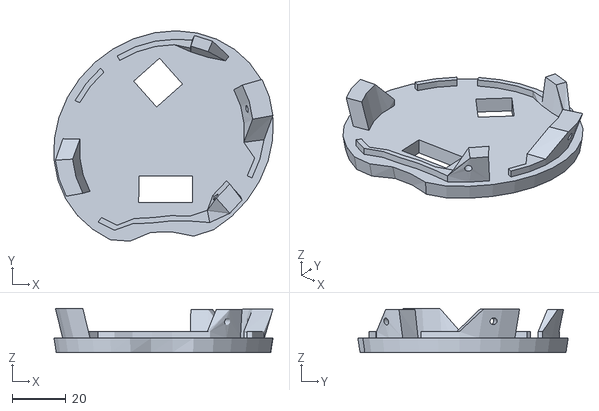
[picture p104: CAD file, 2026-03-08]
hardware/3d_parts/Left Arm/Other/leftrobcap3V1.stl
81.4 x 78.2 x 16.4
