aalonsopuig/Inmoov_ROS2/hardware/3d_parts/Left Arm/Shoulder/PivWormV2.stl

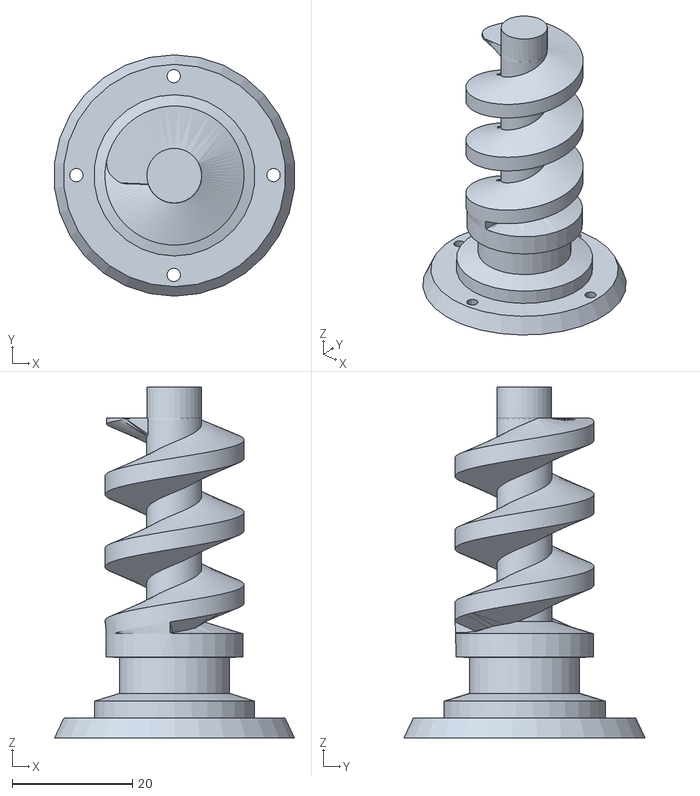
[picture p105: CAD file, 2026-03-08]
hardware/3d_parts/Left Arm/Shoulder/PivWormV2.stl
39.9 x 40.2 x 58.4
