aalonsopuig/Inmoov_ROS2/hardware/3d_parts/Right Arm/Bicep/PistonbaseantiV2.stl

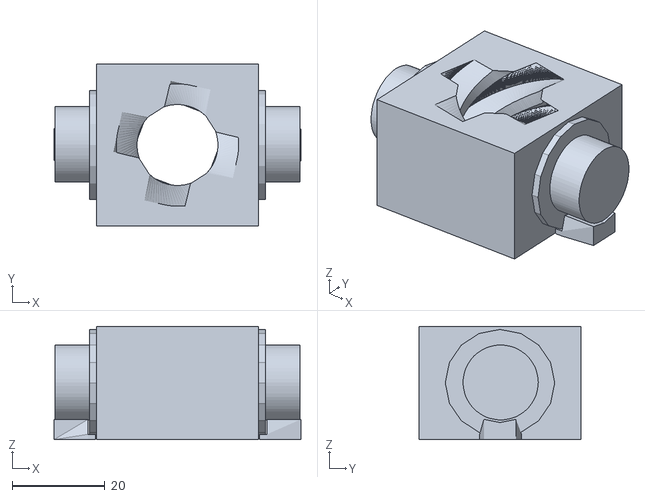
[picture p106: CAD file, 2026-04-30]
hardware/3d_parts/Right Arm/Bicep/PistonbaseantiV2.stl
53.3 x 35.0 x 24.5
