aalonsopuig/Inmoov_ROS2/hardware/3d_parts/Right Arm/Forearm/servo-pulleyX5.stl

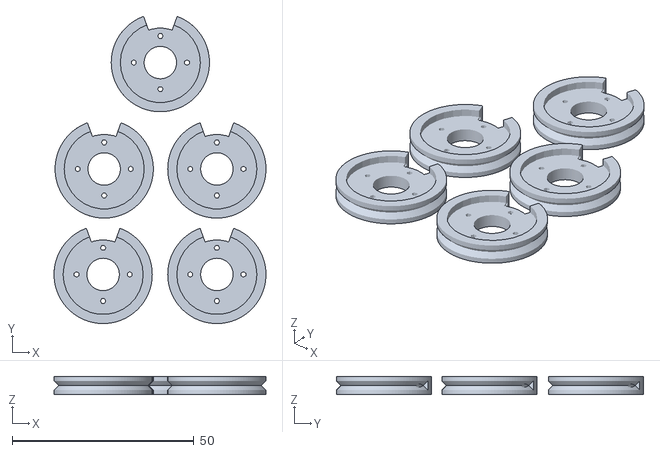
[picture p107: CAD file, 2026-03-08]
hardware/3d_parts/Right Arm/Forearm/servo-pulleyX5.stl
58.3 x 84.4 x 5.00
