aalonsopuig/Inmoov_ROS2/hardware/3d_parts/Right Arm/Hand/topsurface4.stl

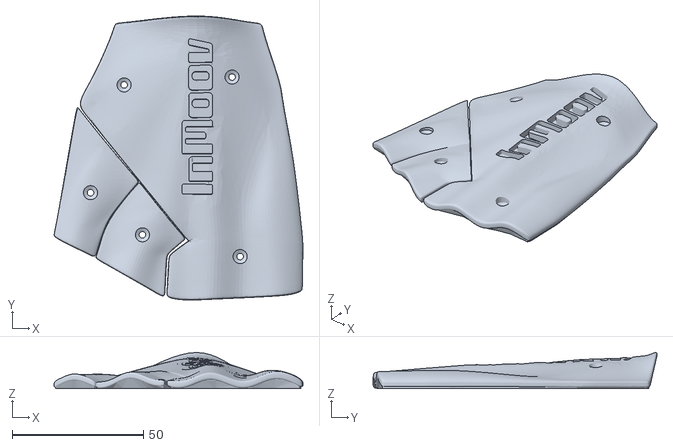
[picture p108: CAD file, 2026-03-08]
hardware/3d_parts/Right Arm/Hand/topsurface4.stl
94.9 x 108.3 x 13.7
