aalonsopuig/Inmoov_ROS2/hardware/3d_parts/Right Arm/Other/ardiuinosupport.stl

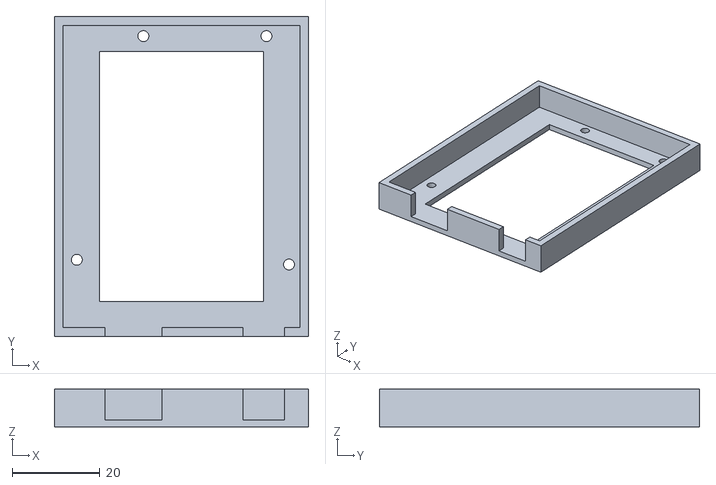
[picture p109: CAD file, 2026-03-08]
hardware/3d_parts/Right Arm/Other/ardiuinosupport.stl
58.0 x 73.0 x 8.62
