aalonsopuig/Inmoov_ROS2/hardware/3d_parts/Right Arm/Shoulder/servoHolsterV1.stl

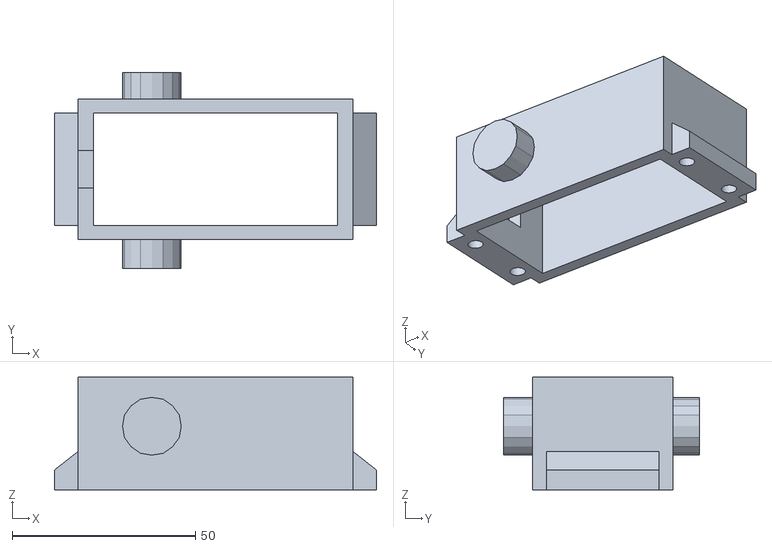
[picture p110: CAD file, 2026-03-08]
hardware/3d_parts/Right Arm/Shoulder/servoHolsterV1.stl
87.9 x 53.5 x 30.7
