aalonsopuig/Inmoov_ROS2/hardware/3d_parts/Right Arm/Wrist/rotawrist1V3.stl

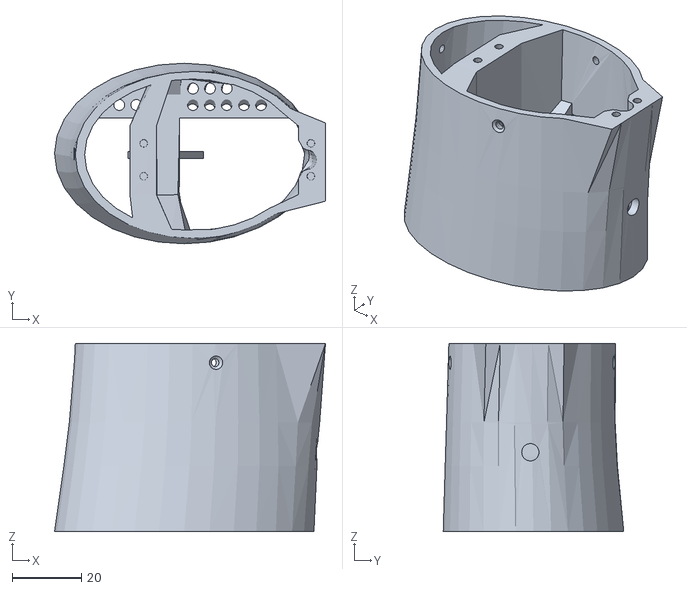
[picture p111: CAD file, 2026-03-08]
hardware/3d_parts/Right Arm/Wrist/rotawrist1V3.stl
78.4 x 52.2 x 54.4
