aalonsopuig/Inmoov_ROS2/hardware/3d_parts/Trunk/Back/BatteryHolderLeftV1.stl

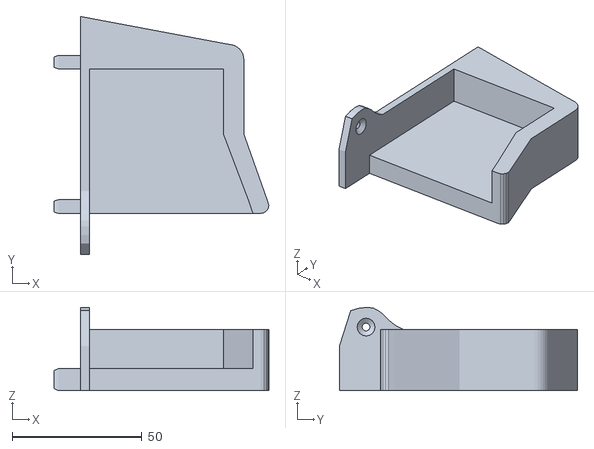
[picture p112: CAD file, 2026-03-08]
hardware/3d_parts/Trunk/Back/BatteryHolderLeftV1.stl
82.8 x 91.7 x 32.1
