aalonsopuig/Inmoov_ROS2/hardware/3d_parts/Trunk/Chest/ChestRightV1.stl

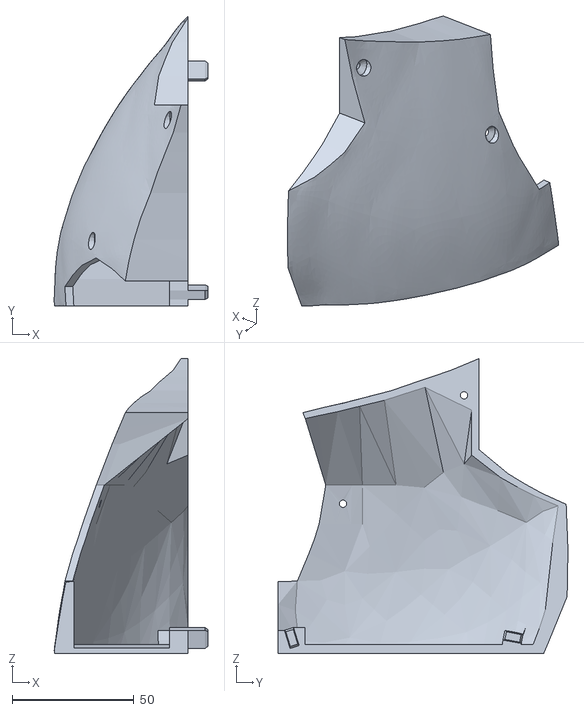
[picture p113: CAD file, 2026-03-08]
hardware/3d_parts/Trunk/Chest/ChestRightV1.stl
63.1 x 119.0 x 121.1
