aalonsopuig/Inmoov_ROS2/hardware/3d_parts/Trunk/Torso/ChestLowV1.stl

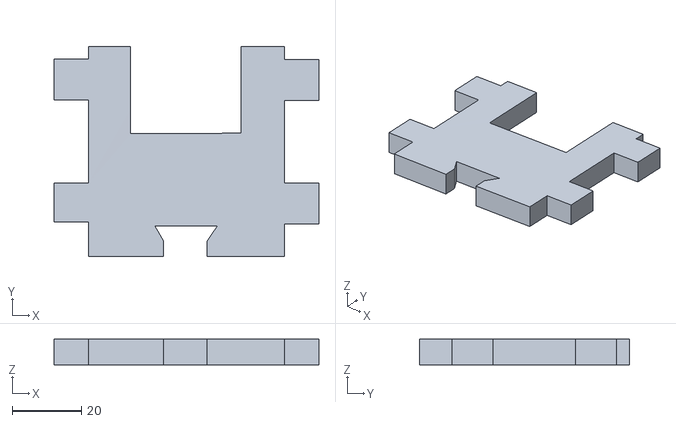
[picture p114: CAD file, 2026-03-08]
hardware/3d_parts/Trunk/Torso/ChestLowV1.stl
76.6 x 60.8 x 7.49
