aalonsopuig/Inmoov_ROS2/inmoov_ws/src/inmoov_meshes/meshes/head.stl

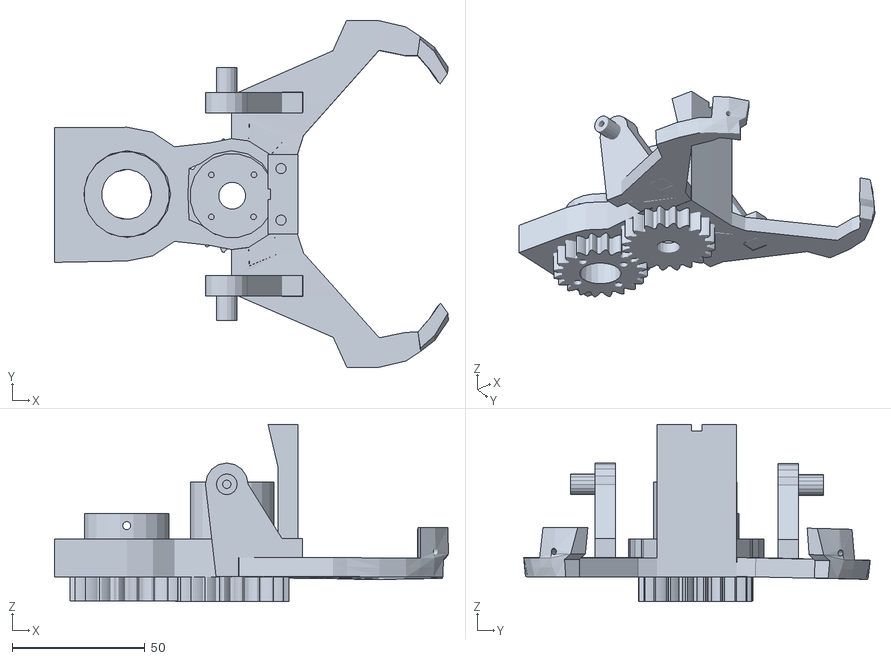
[picture p115: CAD file, 2025-06-18]
inmoov_ws/src/inmoov_meshes/meshes/head.stl
148.3 x 130.5 x 66.7
