aalonsopuig/Inmoov_ROS2/hardware/3d_parts/Head and Neck/Face Parts/EyeglassV2.stl

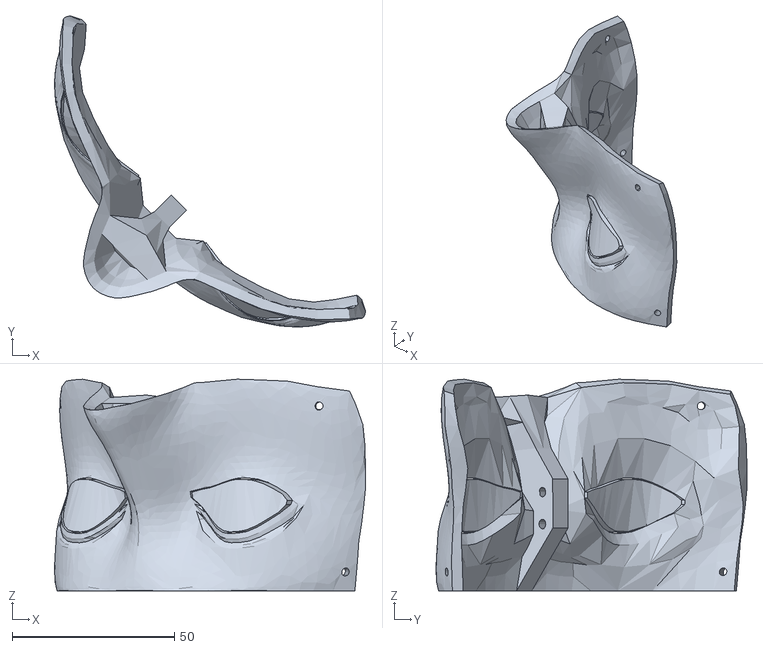
[picture p117: CAD file, 2026-03-08]
hardware/3d_parts/Head and Neck/Face Parts/EyeglassV2.stl
95.8 x 95.8 x 65.2
