aalonsopuig/Inmoov_ROS2/hardware/3d_parts/Head and Neck/Jaw Mechanism/JawHingeV1.stl

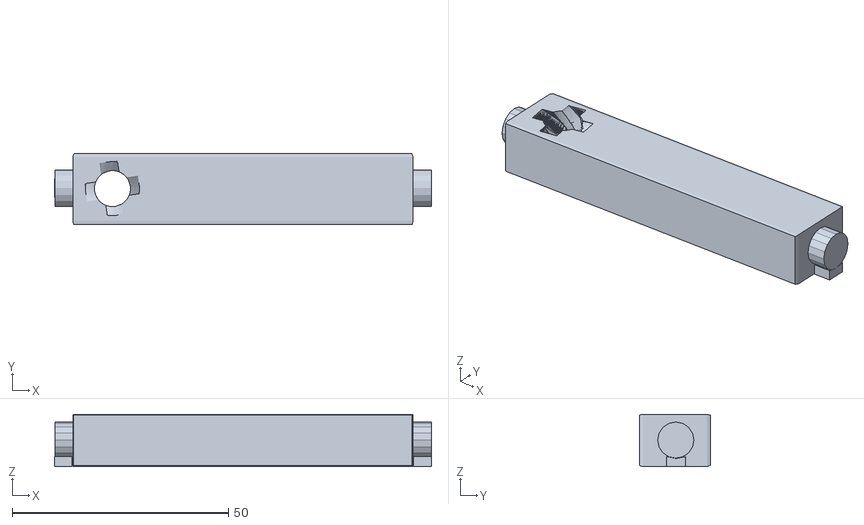
[picture p118: CAD file, 2026-03-08]
hardware/3d_parts/Head and Neck/Jaw Mechanism/JawHingeV1.stl
87.1 x 16.4 x 12.1
