aalonsopuig/Inmoov_ROS2/hardware/3d_parts/Left Arm/Bicep/servobaseV1.stl

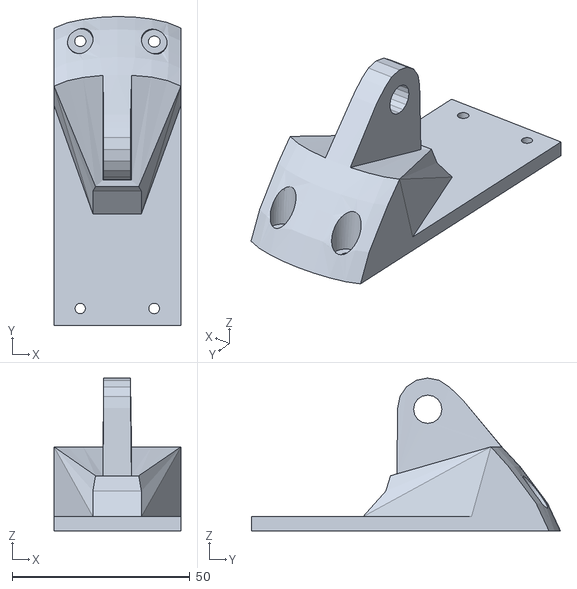
[picture p119: CAD file, 2026-03-08]
hardware/3d_parts/Left Arm/Bicep/servobaseV1.stl
35.7 x 87.0 x 43.1
