aalonsopuig/Inmoov_ROS2/hardware/3d_parts/Left Arm/Forearm/LeftRobCableBackV3.stl

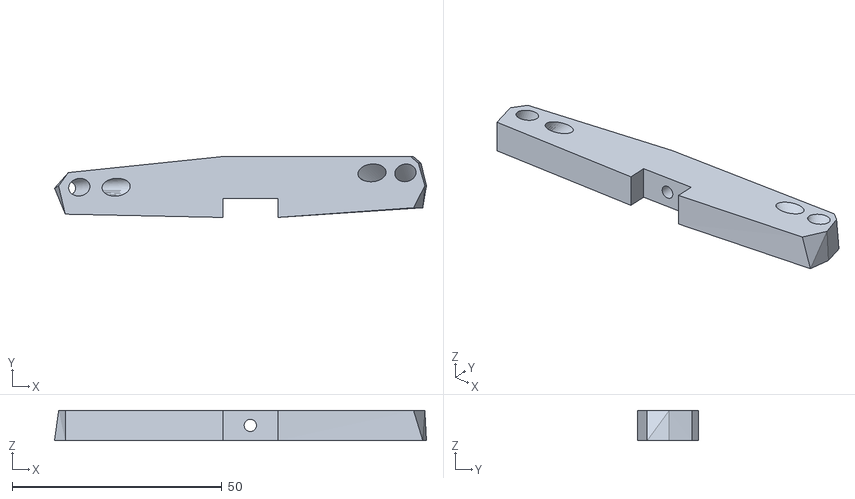
[picture p120: CAD file, 2026-03-08]
hardware/3d_parts/Left Arm/Forearm/LeftRobCableBackV3.stl
88.7 x 14.5 x 7.17
