aalonsopuig/Inmoov_ROS2/hardware/3d_parts/Left Arm/Hand/Index3.stl

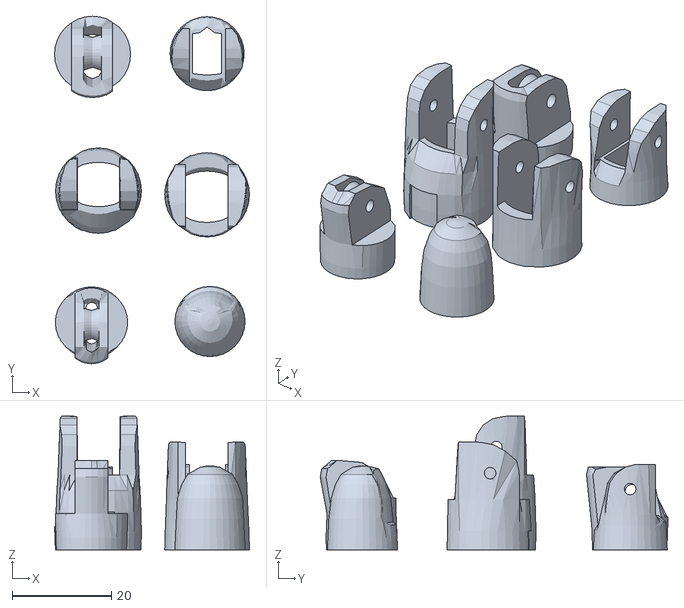
[picture p121: CAD file, 2026-03-08]
hardware/3d_parts/Left Arm/Hand/Index3.stl
39.4 x 70.2 x 27.0
