aalonsopuig/Inmoov_ROS2/hardware/3d_parts/Left Arm/Shoulder/ClaviBackV2.stl

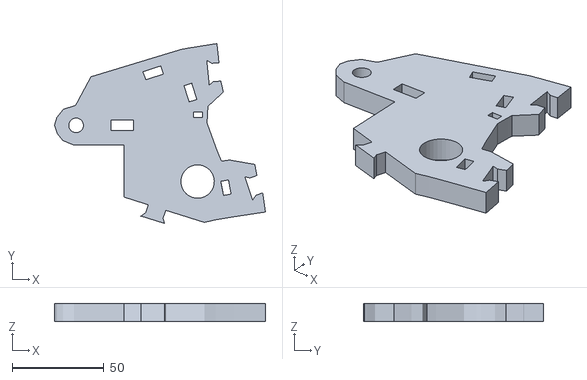
[picture p122: CAD file, 2026-03-08]
hardware/3d_parts/Left Arm/Shoulder/ClaviBackV2.stl
114.9 x 97.9 x 10.0
