aalonsopuig/Inmoov_ROS2/hardware/3d_parts/Left Arm/Wrist/rotawrist3V2.stl

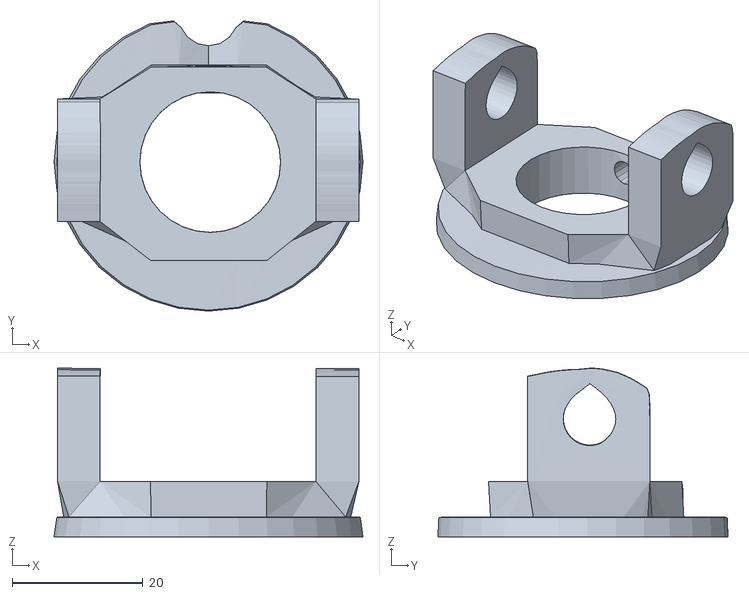
[picture p123: CAD file, 2026-03-08]
hardware/3d_parts/Left Arm/Wrist/rotawrist3V2.stl
47.2 x 44.3 x 25.7
