aalonsopuig/Inmoov_ROS2/hardware/3d_parts/Right Arm/Bicep/PistonanticlockV2.stl

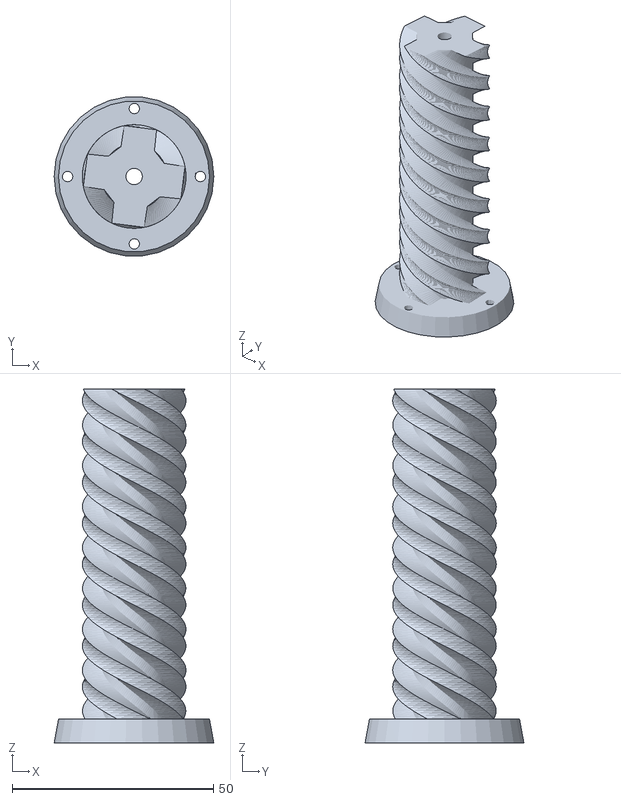
[picture p124: CAD file, 2026-04-30]
hardware/3d_parts/Right Arm/Bicep/PistonanticlockV2.stl
39.7 x 39.5 x 88.0
