aalonsopuig/Inmoov_ROS2/hardware/3d_parts/Right Arm/Forearm/RobServoBedV5.stl

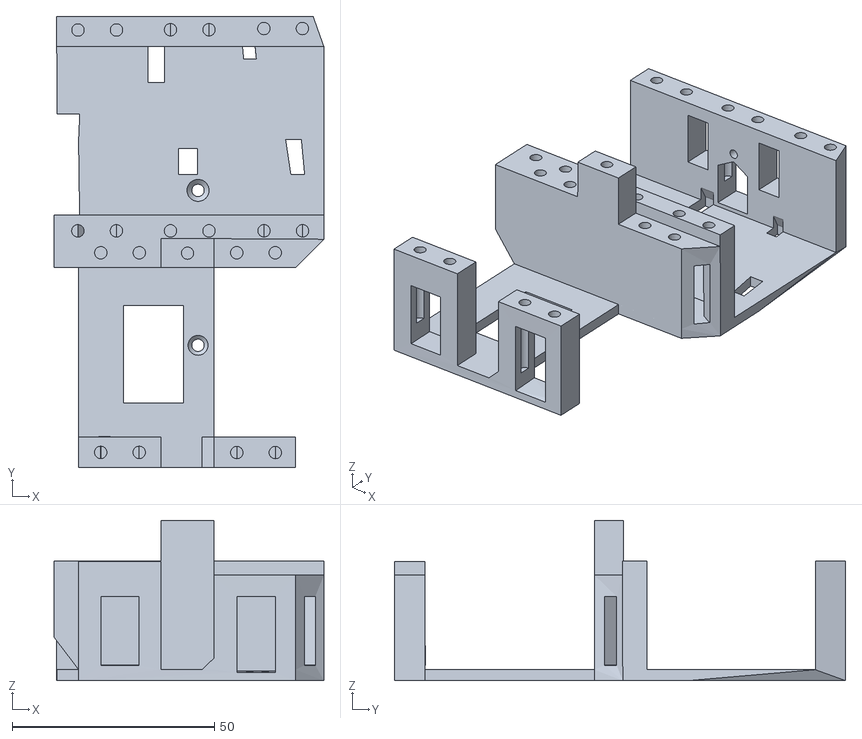
[picture p125: CAD file, 2026-03-08]
hardware/3d_parts/Right Arm/Forearm/RobServoBedV5.stl
66.7 x 111.6 x 39.7
