aalonsopuig/Inmoov_ROS2/hardware/3d_parts/Right Arm/Hand/ringfinger3.stl

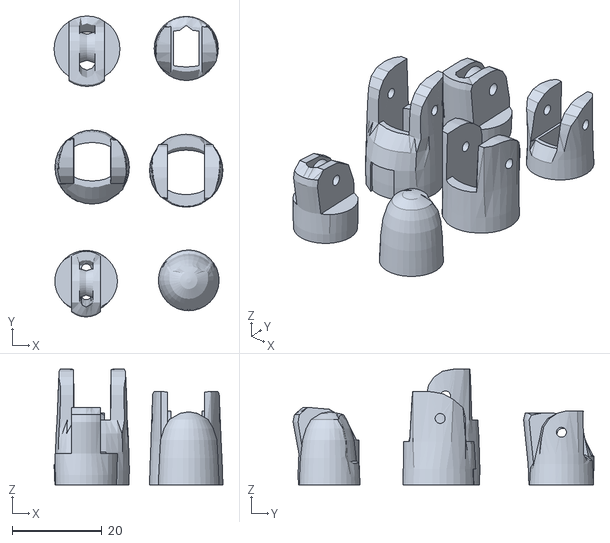
[picture p126: CAD file, 2026-03-08]
hardware/3d_parts/Right Arm/Hand/ringfinger3.stl
37.6 x 67.0 x 25.8
