aalonsopuig/Inmoov_ROS2/hardware/3d_parts/Right Arm/Shoulder/PivTitV1.stl

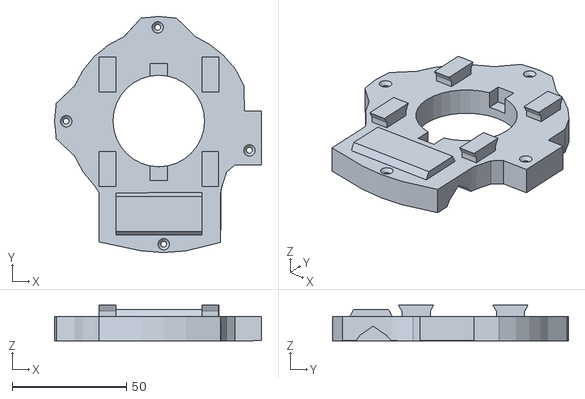
[picture p127: CAD file, 2026-03-08]
hardware/3d_parts/Right Arm/Shoulder/PivTitV1.stl
90.7 x 103.5 x 15.6
