aalonsopuig/Inmoov_ROS2/hardware/3d_parts/Right Arm/Wrist/cableholderwristV4.stl

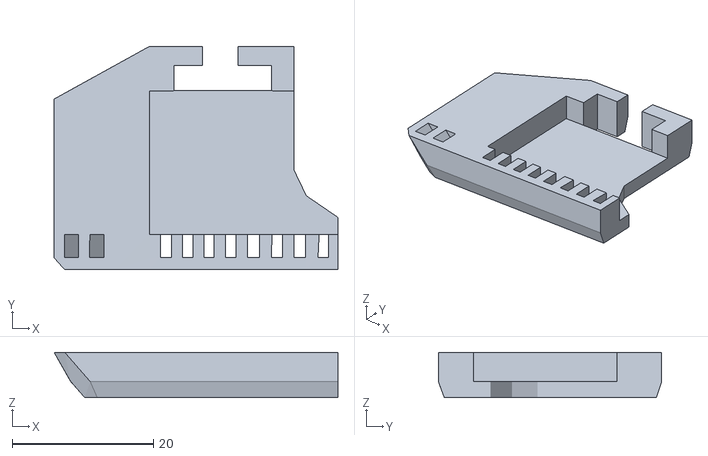
[picture p128: CAD file, 2026-03-08]
hardware/3d_parts/Right Arm/Wrist/cableholderwristV4.stl
40.2 x 31.6 x 6.44
