aalonsopuig/Inmoov_ROS2/hardware/3d_parts/Trunk/Chest/MiddleChestV1.stl

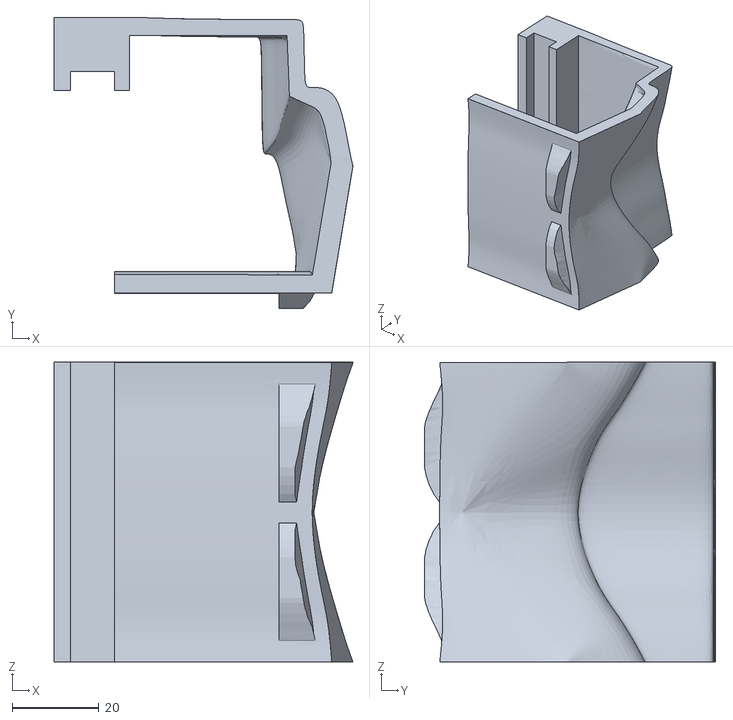
[picture p129: CAD file, 2026-03-08]
hardware/3d_parts/Trunk/Chest/MiddleChestV1.stl
69.1 x 67.2 x 69.3
