aalonsopuig/Inmoov_ROS2/hardware/3d_parts/Trunk/Torso/KinectMidBackV1.stl

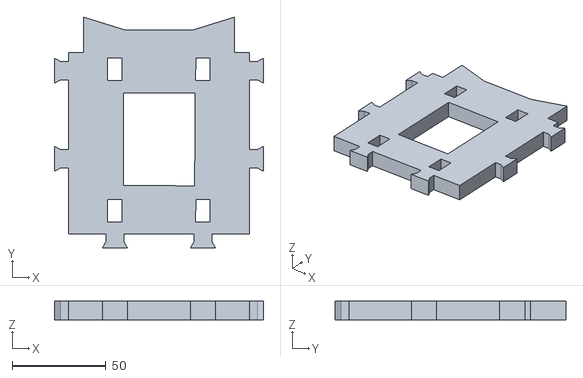
[picture p130: CAD file, 2026-03-08]
hardware/3d_parts/Trunk/Torso/KinectMidBackV1.stl
111.7 x 123.4 x 10.0
