aalonsopuig/Inmoov_ROS2/inmoov_ws/src/inmoov_meshes/meshes/index3_3.stl

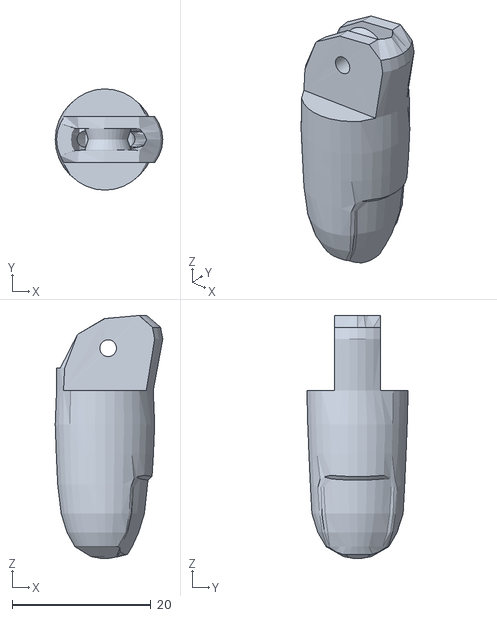
[picture p131: CAD file, 2025-06-18]
inmoov_ws/src/inmoov_meshes/meshes/index3_3.stl
15.5 x 14.6 x 35.1
