aalonsopuig/Inmoov_ROS2/hardware/3d_parts/Head and Neck/Eye mechanism/EyeMoverUpExtraV1.FCStd

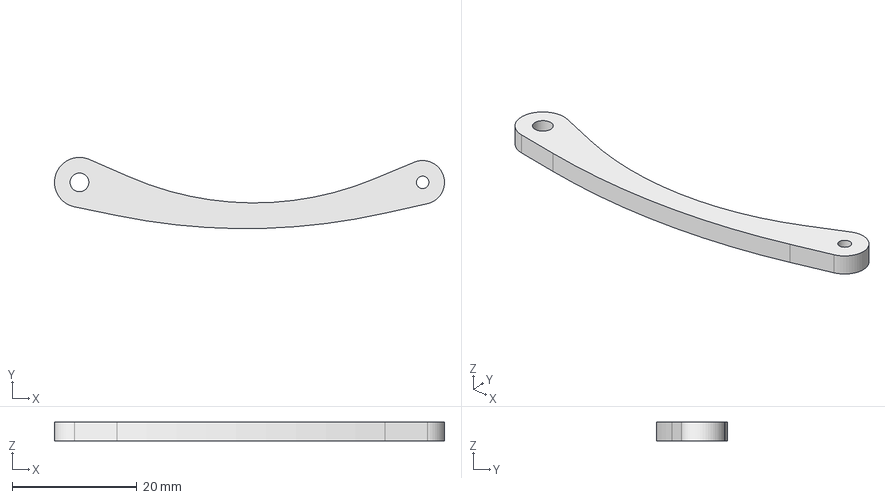
[picture p132: CAD file, 2026-03-08]
hardware/3d_parts/Head and Neck/Eye mechanism/EyeMoverUpExtraV1.FCStd
62.5 x 11.4 x 3.00 mm
