aalonsopuig/Inmoov_ROS2/hardware/3d_parts/Head and Neck/Face Parts/LowbackV2.stl

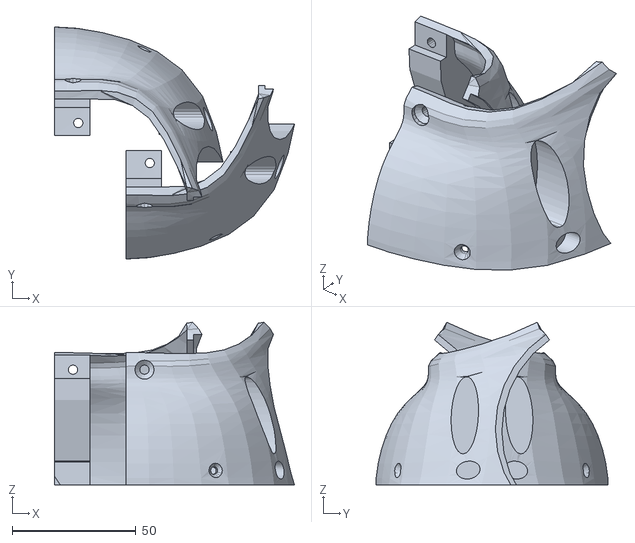
[picture p133: CAD file, 2026-03-08]
hardware/3d_parts/Head and Neck/Face Parts/LowbackV2.stl
97.1 x 93.9 x 65.8
