aalonsopuig/Inmoov_ROS2/hardware/3d_parts/Head and Neck/Jaw Mechanism/JawSupportV1.stl

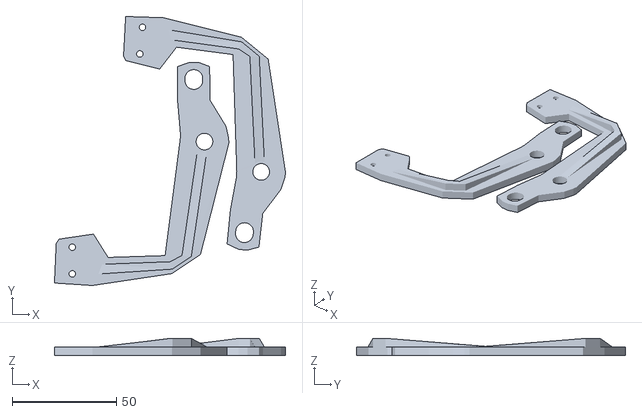
[picture p134: CAD file, 2026-03-08]
hardware/3d_parts/Head and Neck/Jaw Mechanism/JawSupportV1.stl
110.8 x 128.9 x 8.26
