aalonsopuig/Inmoov_ROS2/hardware/3d_parts/Head and Neck/Neck Mechanism/RingV1.stl

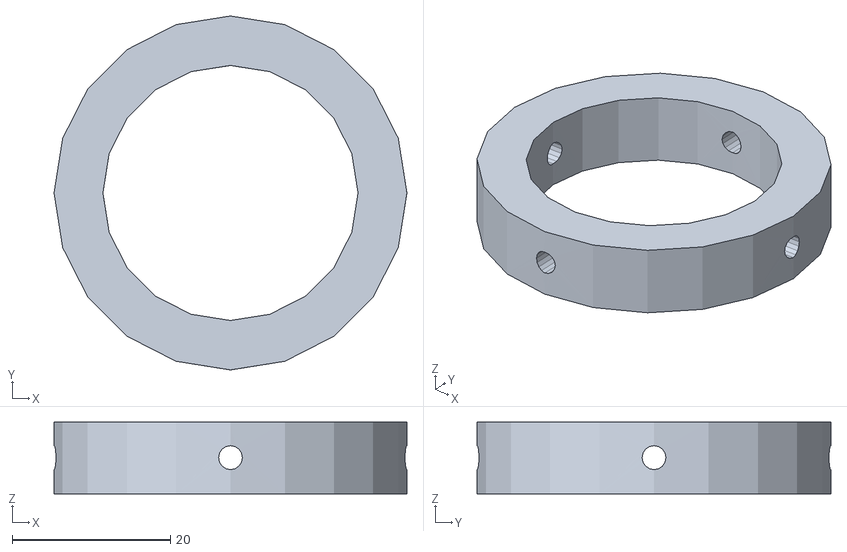
[picture p135: CAD file, 2026-03-08]
hardware/3d_parts/Head and Neck/Neck Mechanism/RingV1.stl
44.6 x 44.7 x 9.08
