aalonsopuig/Inmoov_ROS2/hardware/3d_parts/Head and Neck/Skull parts/TopBackskullV1.stl

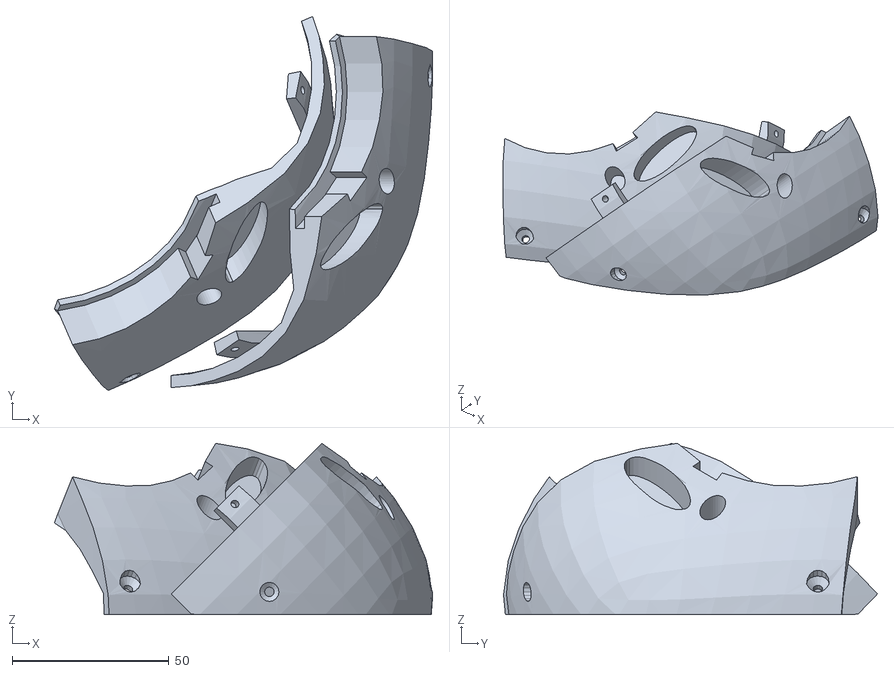
[picture p136: CAD file, 2026-03-08]
hardware/3d_parts/Head and Neck/Skull parts/TopBackskullV1.stl
120.6 x 119.2 x 54.6
