aalonsopuig/Inmoov_ROS2/hardware/3d_parts/Left Arm/Bicep/spacerV1.stl

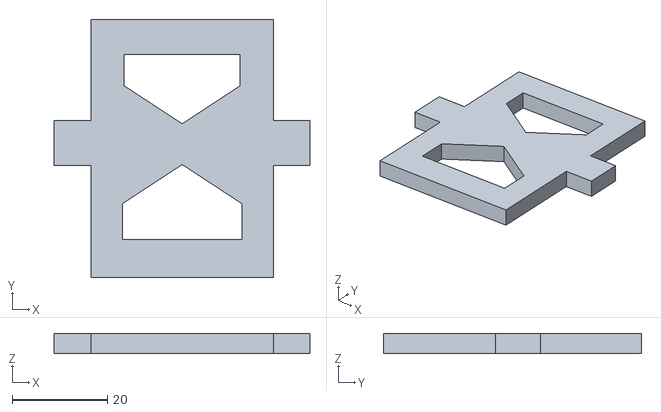
[picture p137: CAD file, 2026-03-08]
hardware/3d_parts/Left Arm/Bicep/spacerV1.stl
53.8 x 54.3 x 4.23
