aalonsopuig/Inmoov_ROS2/hardware/3d_parts/Left Arm/Forearm/Leftrobpart5V3.stl

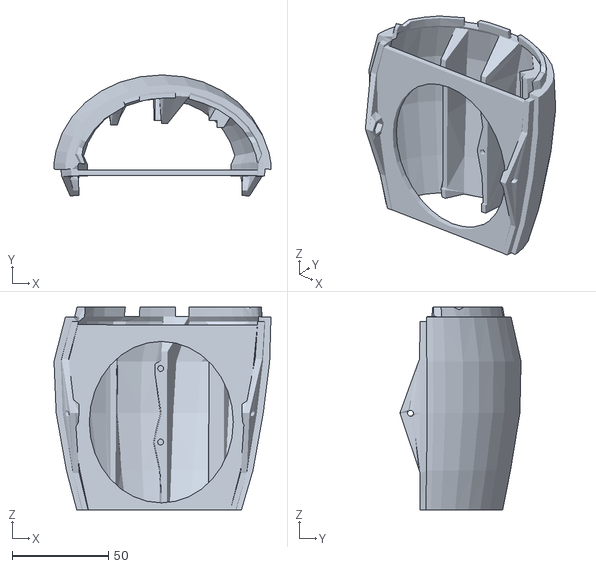
[picture p138: CAD file, 2026-03-08]
hardware/3d_parts/Left Arm/Forearm/Leftrobpart5V3.stl
113.0 x 63.1 x 105.7
