aalonsopuig/Inmoov_ROS2/hardware/3d_parts/Left Arm/Hand/leftcoverfinger1.stl

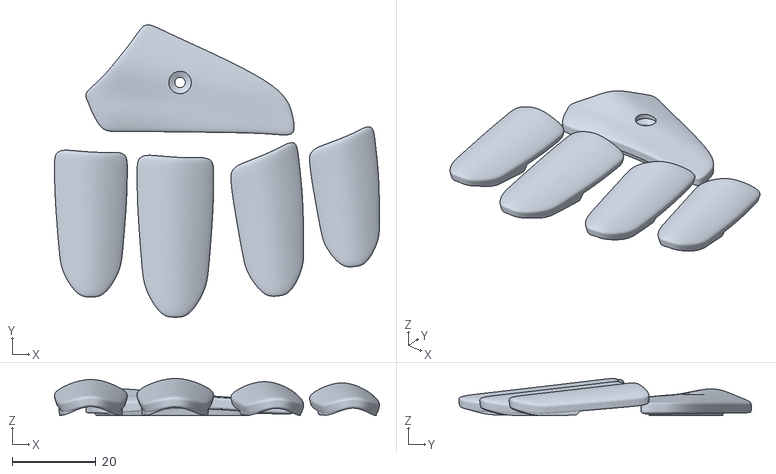
[picture p139: CAD file, 2026-03-08]
hardware/3d_parts/Left Arm/Hand/leftcoverfinger1.stl
77.7 x 69.9 x 8.87
