aalonsopuig/Inmoov_ROS2/hardware/3d_parts/Left Arm/Shoulder/LeftPivPotholderV2.stl

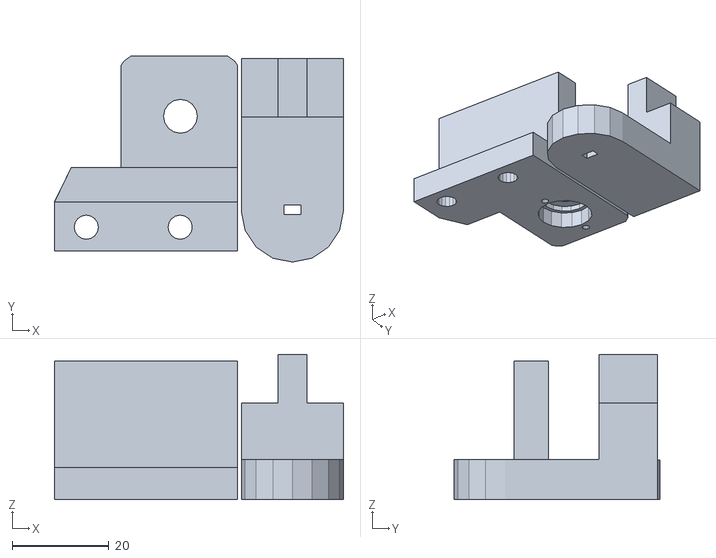
[picture p140: CAD file, 2026-03-08]
hardware/3d_parts/Left Arm/Shoulder/LeftPivPotholderV2.stl
59.6 x 42.5 x 30.0
