aalonsopuig/Inmoov_ROS2/hardware/3d_parts/Left Arm/Wrist/WristGearsV4.stl

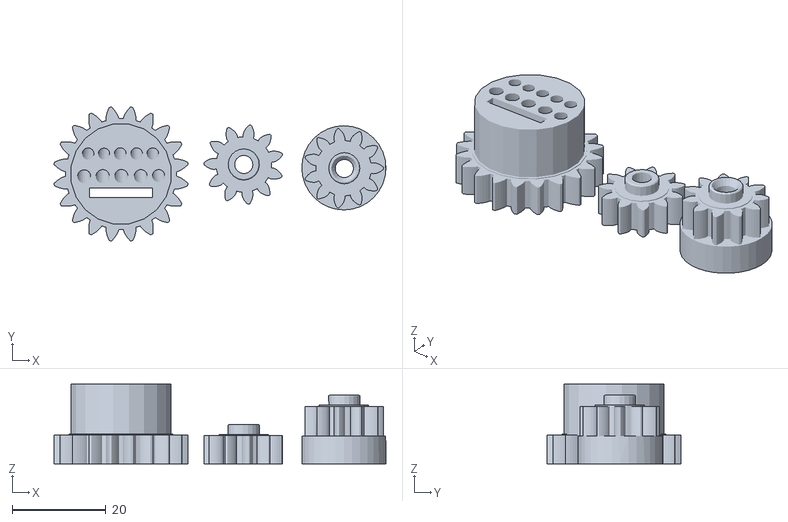
[picture p141: CAD file, 2026-03-08]
hardware/3d_parts/Left Arm/Wrist/WristGearsV4.stl
71.0 x 28.7 x 17.1
