aalonsopuig/Inmoov_ROS2/hardware/3d_parts/Other/connectors1.stl

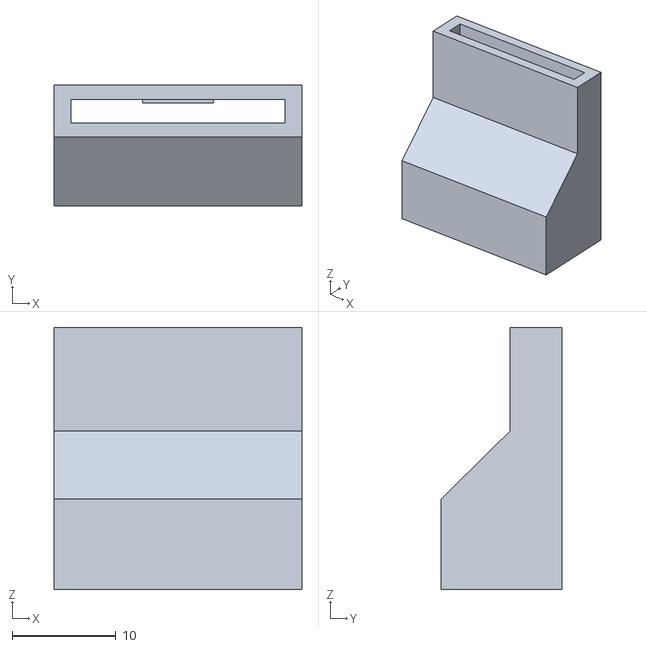
[picture p142: CAD file, 2026-03-08]
hardware/3d_parts/Other/connectors1.stl
23.9 x 11.6 x 25.3
