aalonsopuig/Inmoov_ROS2/hardware/3d_parts/Right Arm/Bicep/elbowshaftgearV1.stl

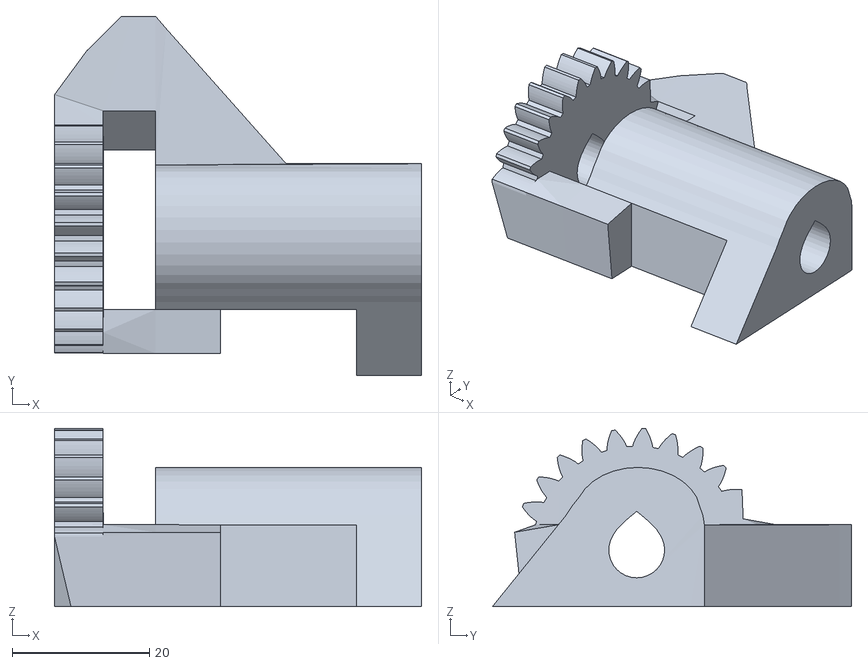
[picture p143: CAD file, 2026-03-08]
hardware/3d_parts/Right Arm/Bicep/elbowshaftgearV1.stl
53.5 x 52.4 x 26.0
