aalonsopuig/Inmoov_ROS2/hardware/3d_parts/Right Arm/Hand/Majeure3.stl

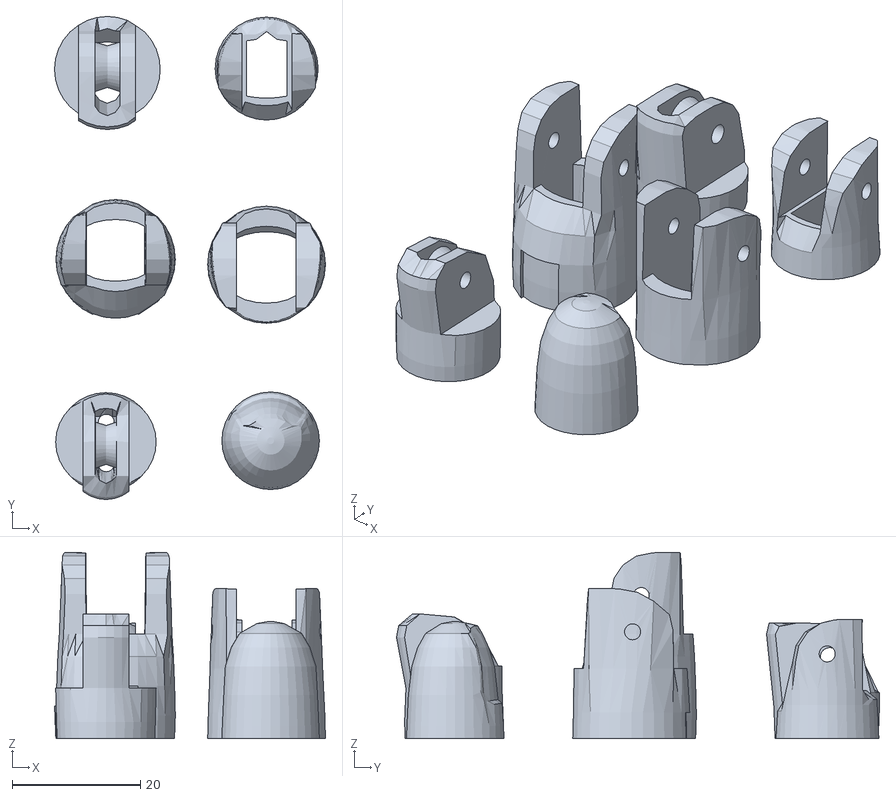
[picture p144: CAD file, 2026-03-08]
hardware/3d_parts/Right Arm/Hand/Majeure3.stl
42.2 x 75.2 x 29.0
