aalonsopuig/Inmoov_ROS2/hardware/3d_parts/Right Arm/Shoulder/ClaviFrontV2.stl

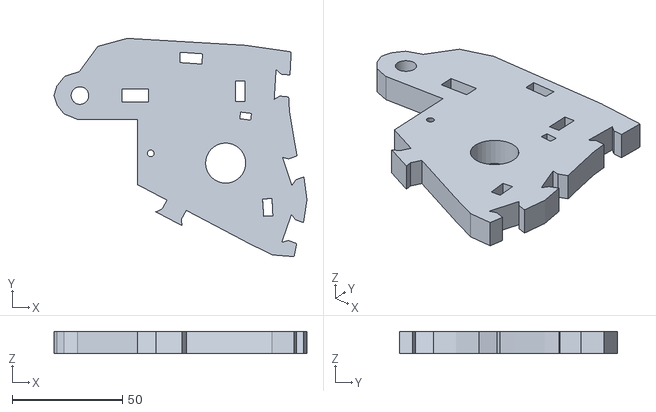
[picture p145: CAD file, 2026-03-08]
hardware/3d_parts/Right Arm/Shoulder/ClaviFrontV2.stl
114.7 x 98.9 x 10.0
