aalonsopuig/Inmoov_ROS2/hardware/3d_parts/Right Arm/Wrist/rotawrist2.stl

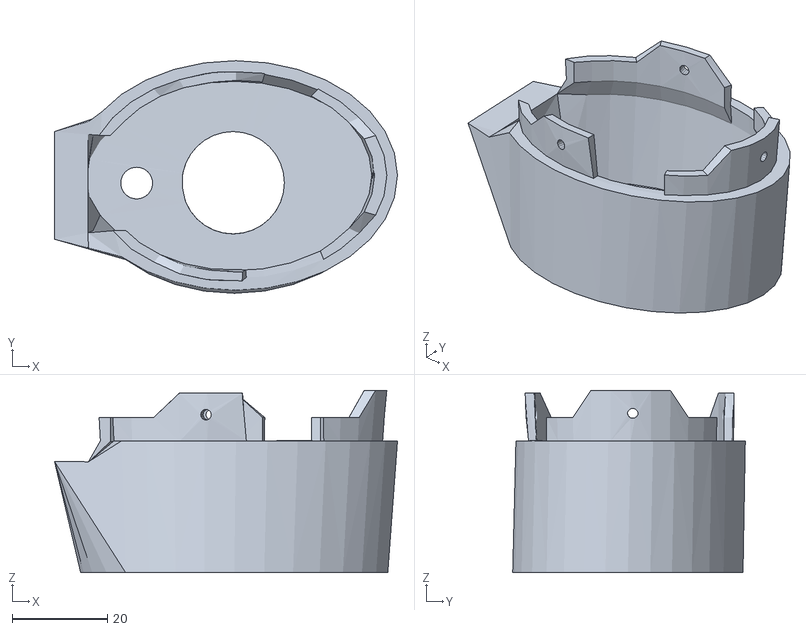
[picture p146: CAD file, 2026-03-08]
hardware/3d_parts/Right Arm/Wrist/rotawrist2.stl
72.1 x 48.9 x 38.3
