aalonsopuig/Inmoov_ROS2/hardware/3d_parts/Trunk/Chest/ChestTopAttachV1.stl

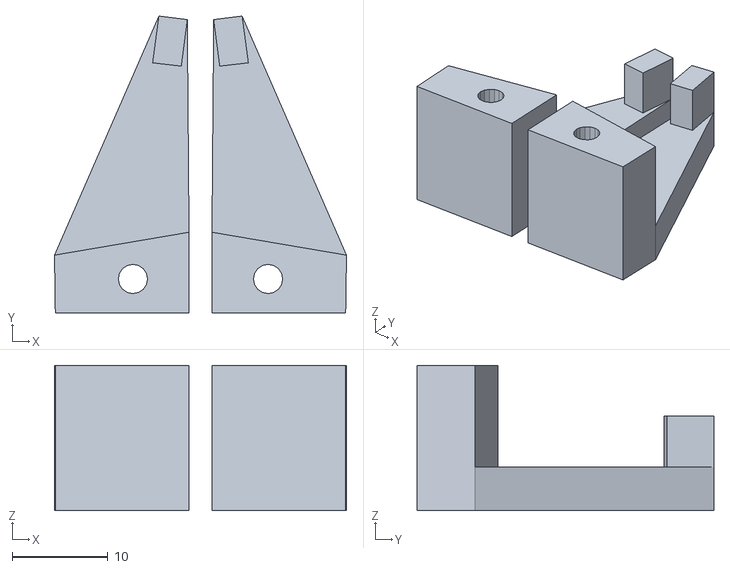
[picture p147: CAD file, 2026-03-08]
hardware/3d_parts/Trunk/Chest/ChestTopAttachV1.stl
30.5 x 31.0 x 15.2
