aalonsopuig/Inmoov_ROS2/hardware/3d_parts/Trunk/Torso/homplateback+V1.stl

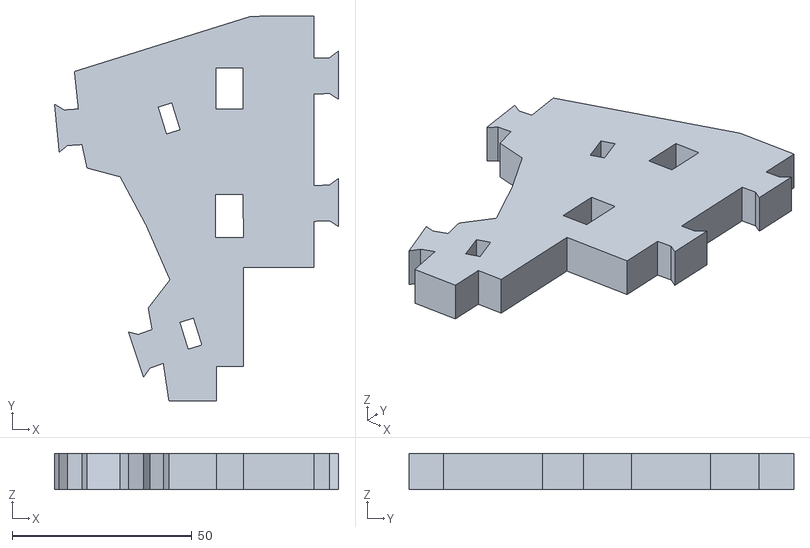
[picture p148: CAD file, 2026-03-08]
hardware/3d_parts/Trunk/Torso/homplateback+V1.stl
79.0 x 107.0 x 10.0
