aalonsopuig/Inmoov_ROS2/inmoov_ws/src/inmoov_meshes/meshes/r_hand.stl

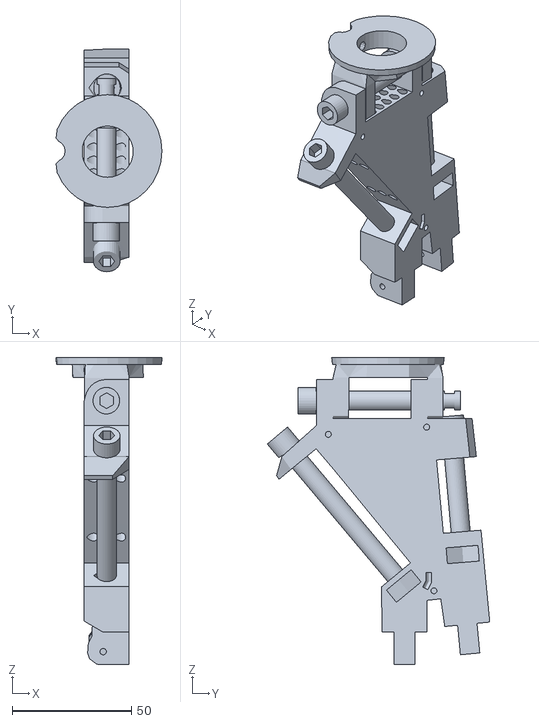
[picture p149: CAD file, 2025-06-18]
inmoov_ws/src/inmoov_meshes/meshes/r_hand.stl
44.3 x 93.1 x 128.5
