aalonsopuig/Inmoov_ROS2/hardware/3d_parts/Head and Neck/Eye mechanism/EyeToNoseV4.stl

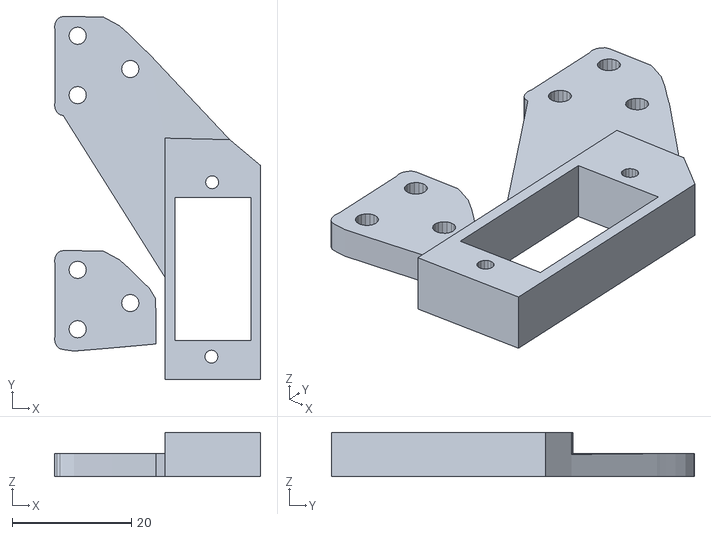
[picture p150: CAD file, 2026-03-08]
hardware/3d_parts/Head and Neck/Eye mechanism/EyeToNoseV4.stl
34.6 x 60.9 x 7.42
