aalonsopuig/Inmoov_ROS2/hardware/3d_parts/Head and Neck/Face Parts/SideHearV2.stl

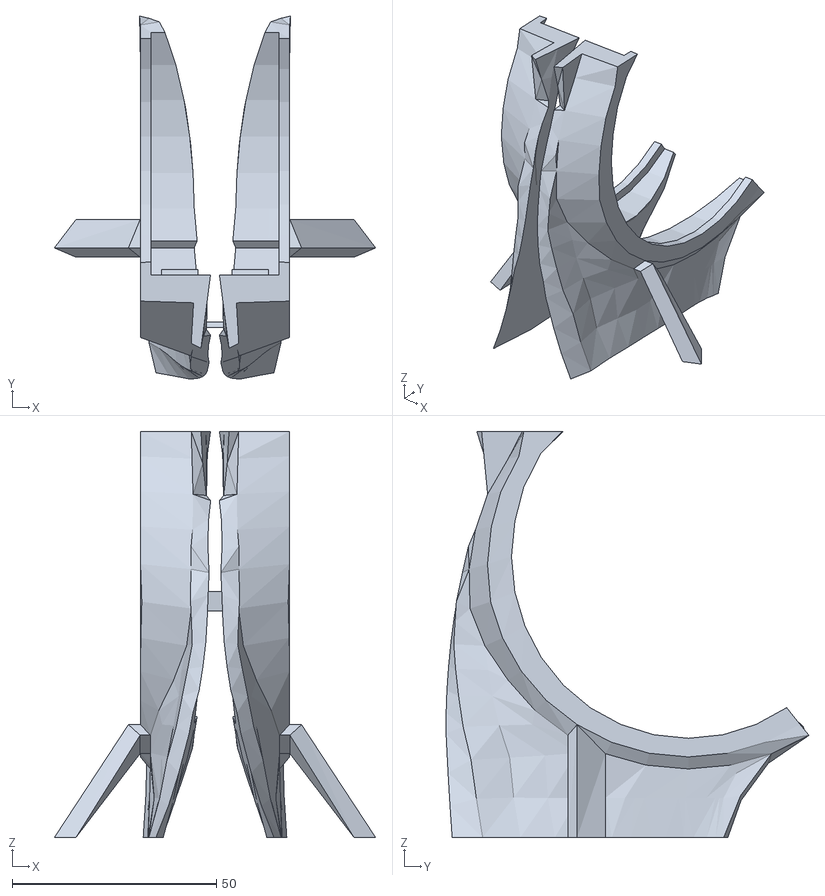
[picture p151: CAD file, 2026-03-08]
hardware/3d_parts/Head and Neck/Face Parts/SideHearV2.stl
78.7 x 88.9 x 99.5
