aalonsopuig/Inmoov_ROS2/hardware/3d_parts/Head and Neck/Jaw Mechanism/JawV4.stl

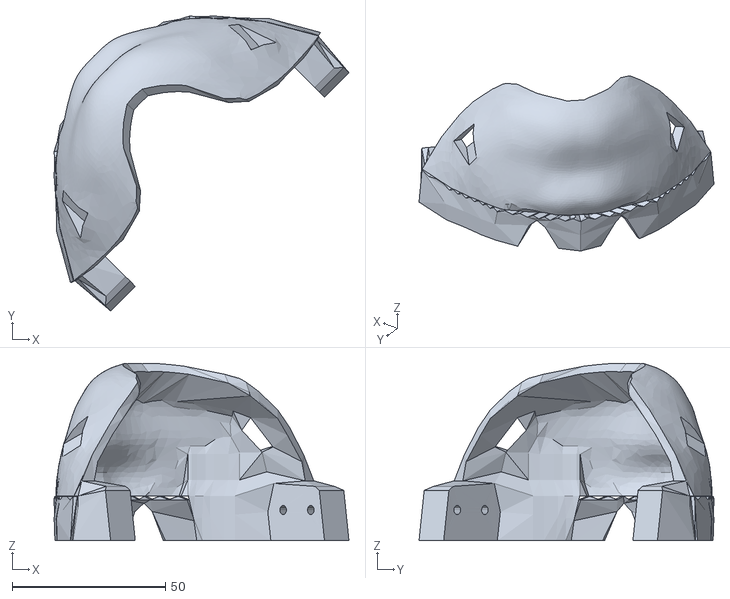
[picture p152: CAD file, 2026-03-08]
hardware/3d_parts/Head and Neck/Jaw Mechanism/JawV4.stl
96.4 x 96.4 x 58.0
