aalonsopuig/Inmoov_ROS2/hardware/3d_parts/Head and Neck/Neck Mechanism/FaceHolderV3.stl

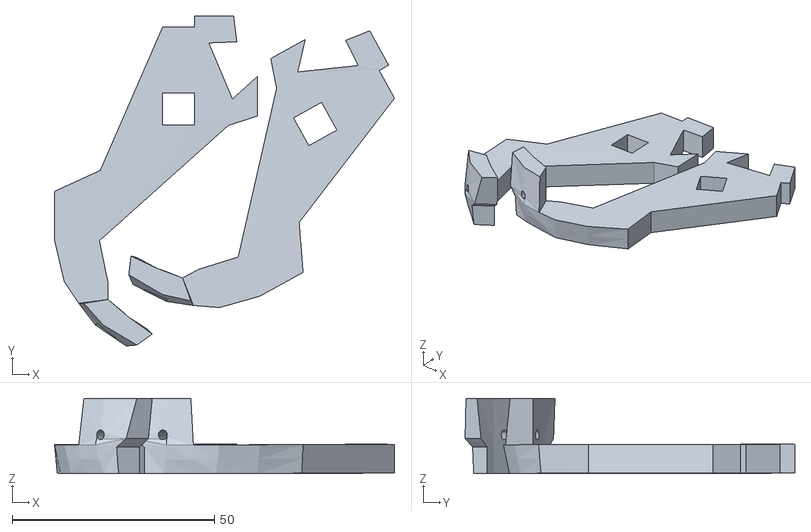
[picture p153: CAD file, 2026-03-08]
hardware/3d_parts/Head and Neck/Neck Mechanism/FaceHolderV3.stl
84.1 x 81.7 x 18.7
