aalonsopuig/Inmoov_ROS2/hardware/3d_parts/Left Arm/Bicep/gearpotentioV1.stl

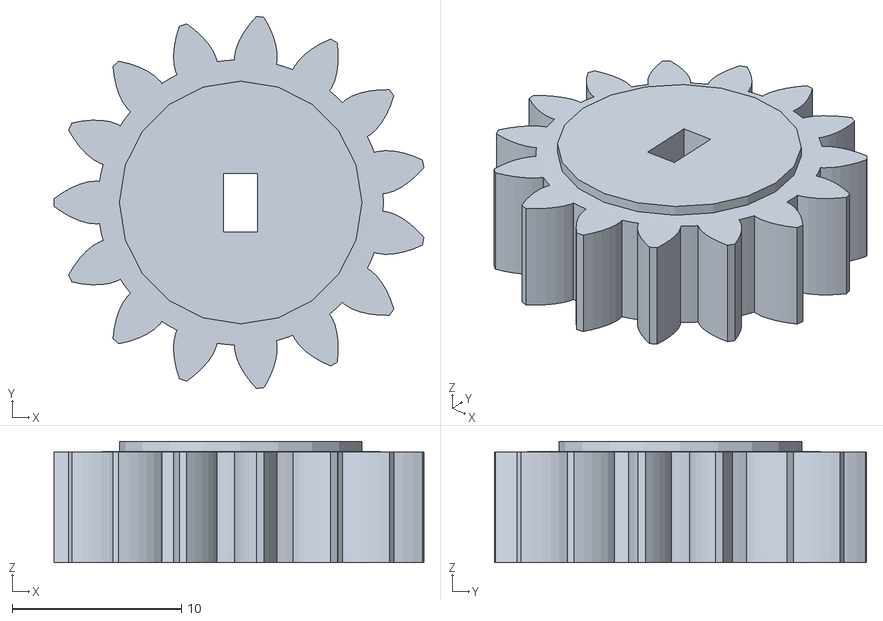
[picture p154: CAD file, 2026-03-08]
hardware/3d_parts/Left Arm/Bicep/gearpotentioV1.stl
21.8 x 22.0 x 7.15
