aalonsopuig/Inmoov_ROS2/hardware/3d_parts/Left Arm/Forearm/Leftrobpart2V3.stl

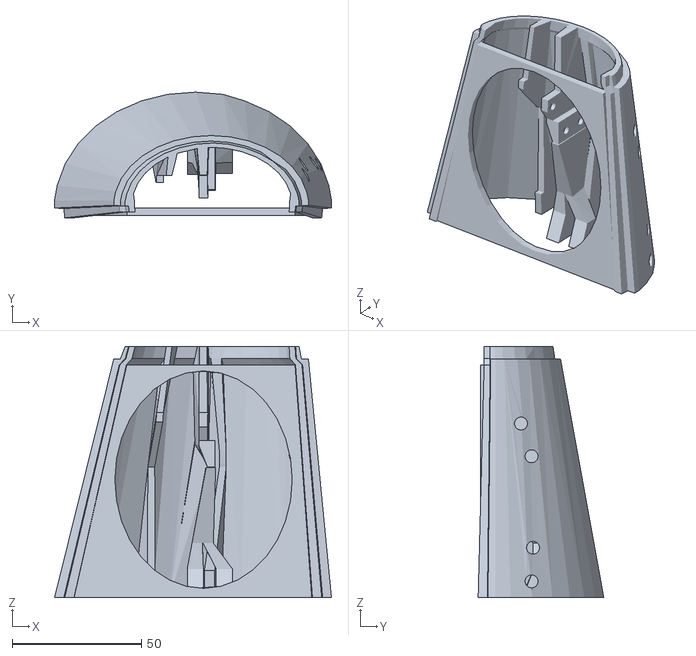
[picture p155: CAD file, 2026-03-08]
hardware/3d_parts/Left Arm/Forearm/Leftrobpart2V3.stl
107.2 x 48.7 x 97.3
