aalonsopuig/Inmoov_ROS2/hardware/3d_parts/Left Arm/Shoulder/PivGearV3.stl

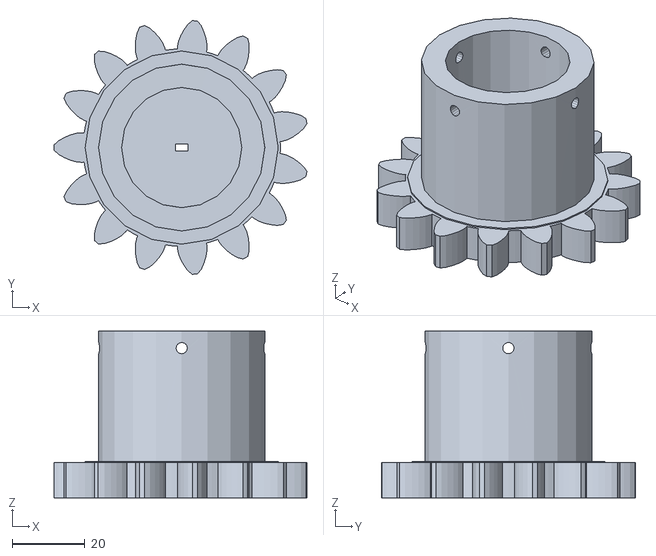
[picture p156: CAD file, 2026-03-08]
hardware/3d_parts/Left Arm/Shoulder/PivGearV3.stl
69.5 x 69.8 x 45.9
