aalonsopuig/Inmoov_ROS2/hardware/3d_parts/Other/BackBottomSupport_v2.FCStd

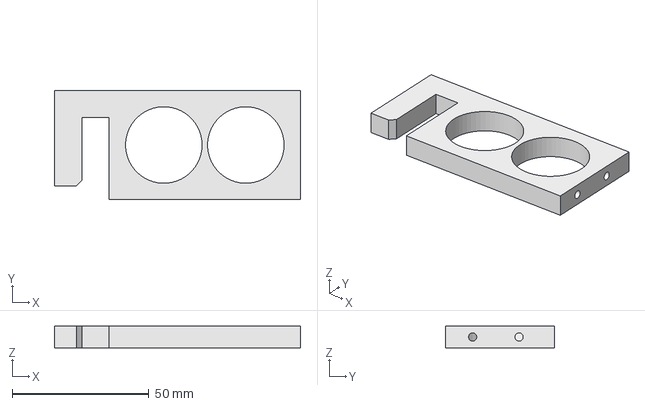
[picture p157: CAD file, 2026-03-08]
hardware/3d_parts/Other/BackBottomSupport_v2.FCStd
90.0 x 40.0 x 8.00 mm
