aalonsopuig/Inmoov_ROS2/hardware/3d_parts/Right Arm/Bicep/armtopcover3.stl

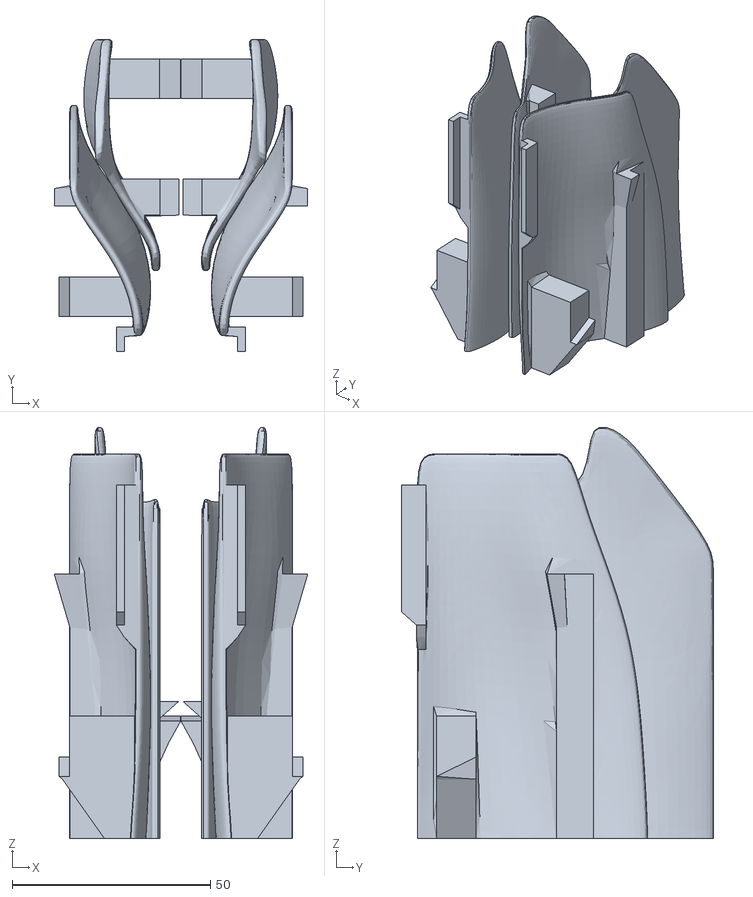
[picture p158: CAD file, 2026-03-08]
hardware/3d_parts/Right Arm/Bicep/armtopcover3.stl
63.9 x 78.6 x 103.5
