aalonsopuig/Inmoov_ROS2/hardware/3d_parts/Right Arm/Forearm/RobCableFrontV3.stl

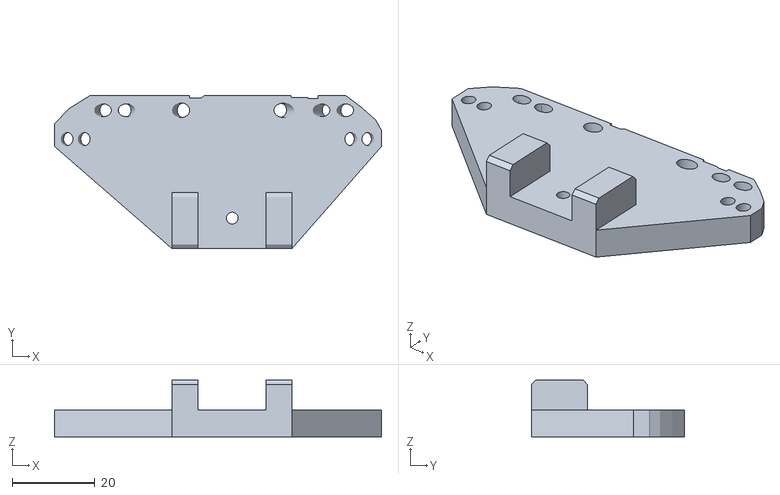
[picture p159: CAD file, 2026-03-08]
hardware/3d_parts/Right Arm/Forearm/RobCableFrontV3.stl
79.3 x 37.1 x 13.8
