aalonsopuig/Inmoov_ROS2/hardware/3d_parts/Right Arm/Shoulder/PistonClaviV2.stl

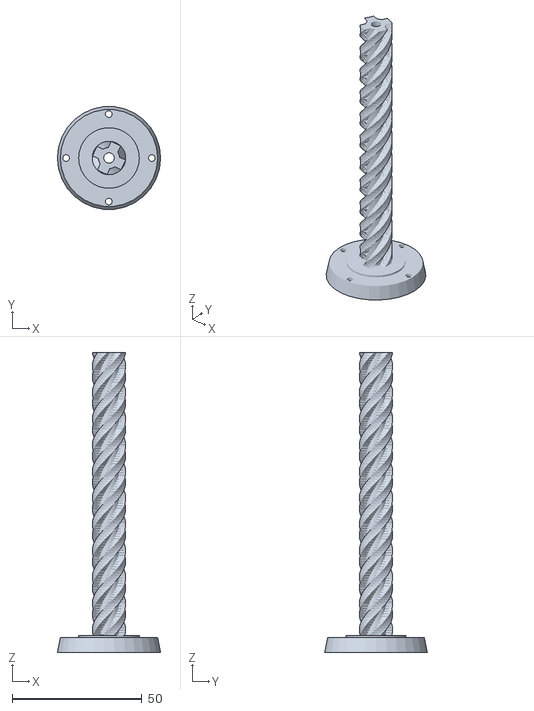
[picture p160: CAD file, 2026-03-08]
hardware/3d_parts/Right Arm/Shoulder/PistonClaviV2.stl
39.7 x 39.5 x 115.4
