aalonsopuig/Inmoov_ROS2/hardware/3d_parts/Trunk/Chest/ChestTopV1.stl

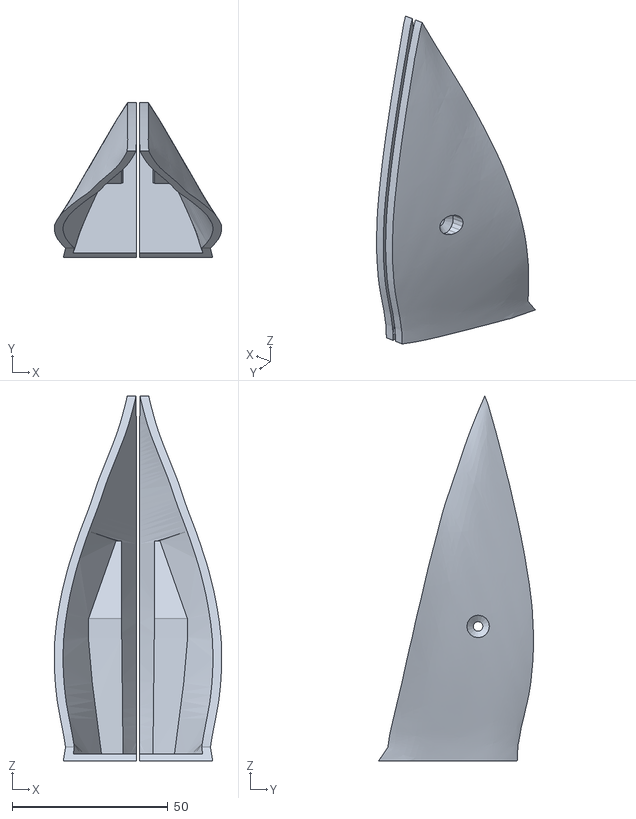
[picture p161: CAD file, 2026-03-08]
hardware/3d_parts/Trunk/Chest/ChestTopV1.stl
53.8 x 49.8 x 117.3
