aalonsopuig/Inmoov_ROS2/hardware/3d_parts/Trunk/Torso/HomLowBack-V1.stl

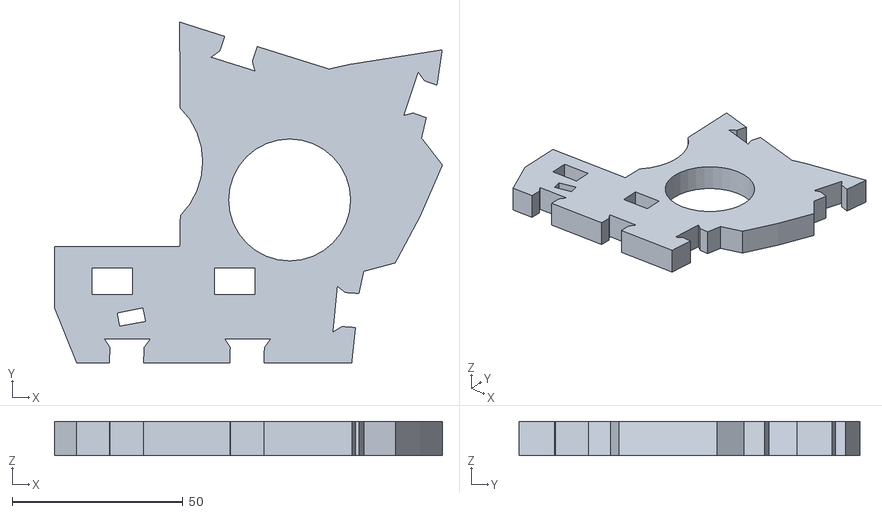
[picture p162: CAD file, 2026-03-08]
hardware/3d_parts/Trunk/Torso/HomLowBack-V1.stl
113.5 x 99.7 x 10.1
