aalonsopuig/Inmoov_ROS2/inmoov_ws/src/inmoov_meshes/meshes/middle3_3.stl

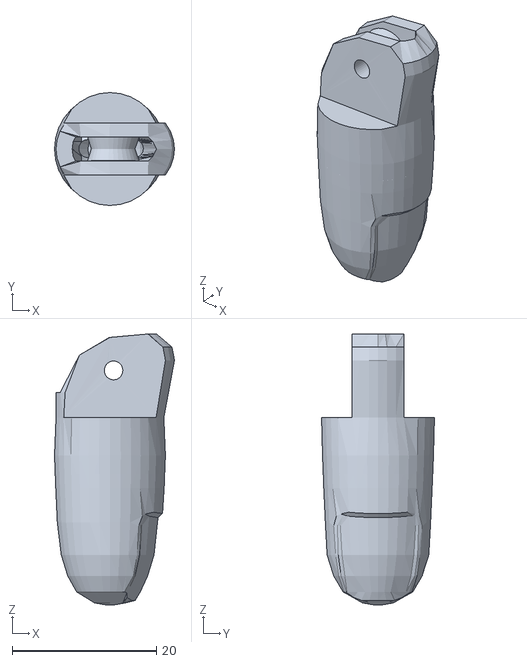
[picture p163: CAD file, 2025-06-18]
inmoov_ws/src/inmoov_meshes/meshes/middle3_3.stl
16.7 x 15.7 x 37.6
