aalonsopuig/Inmoov_ROS2/hardware/3d_parts/Head and Neck/Eye mechanism/L_EyeInterPieceV1.FCStd

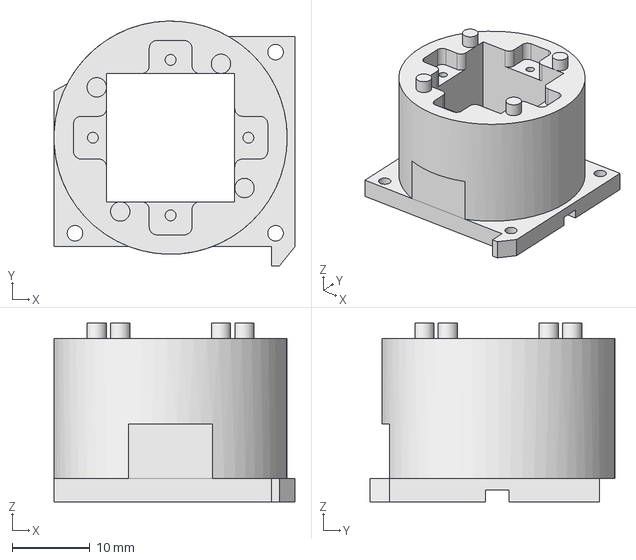
[picture p164: CAD file, 2026-03-08]
hardware/3d_parts/Head and Neck/Eye mechanism/L_EyeInterPieceV1.FCStd
31.0 x 31.5 x 23.0 mm
