aalonsopuig/Inmoov_ROS2/hardware/3d_parts/Head and Neck/Jaw Mechanism/JawPistonV1.stl

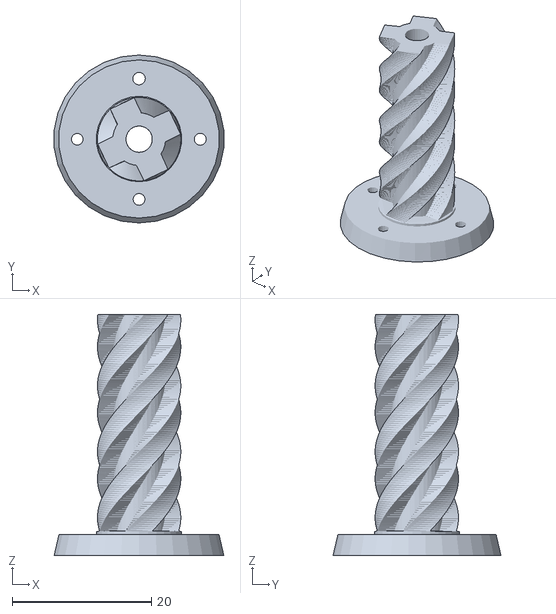
[picture p165: CAD file, 2026-03-08]
hardware/3d_parts/Head and Neck/Jaw Mechanism/JawPistonV1.stl
24.4 x 24.1 x 34.6
