aalonsopuig/Inmoov_ROS2/hardware/3d_parts/Left Arm/Bicep/PistonanticlockV1.stl

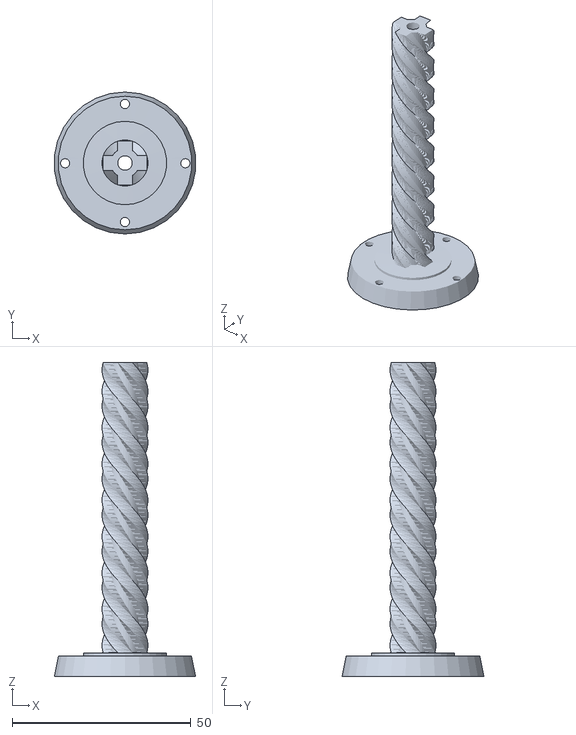
[picture p166: CAD file, 2026-03-08]
hardware/3d_parts/Left Arm/Bicep/PistonanticlockV1.stl
39.5 x 39.7 x 87.9
