aalonsopuig/Inmoov_ROS2/hardware/3d_parts/Left Arm/Forearm/leftrobpart4V3.stl

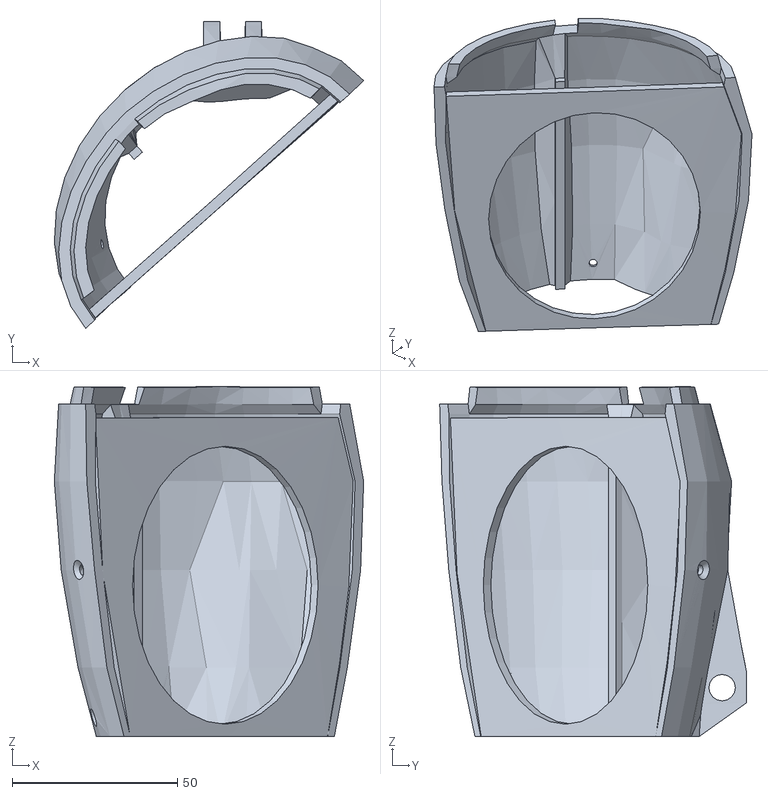
[picture p167: CAD file, 2026-03-08]
hardware/3d_parts/Left Arm/Forearm/leftrobpart4V3.stl
93.5 x 92.7 x 105.8
