aalonsopuig/Inmoov_ROS2/hardware/3d_parts/Left Arm/Hand/leftWristsmallV3.stl

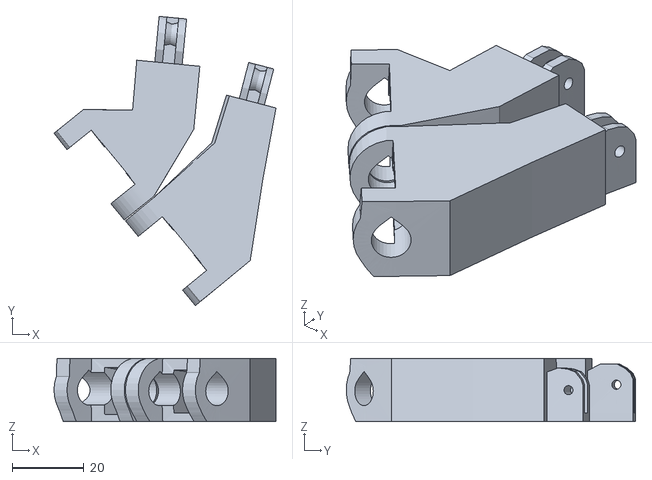
[picture p168: CAD file, 2026-03-08]
hardware/3d_parts/Left Arm/Hand/leftWristsmallV3.stl
62.0 x 80.8 x 17.7
