aalonsopuig/Inmoov_ROS2/hardware/3d_parts/Left Arm/Shoulder/PivConnectorV1.stl

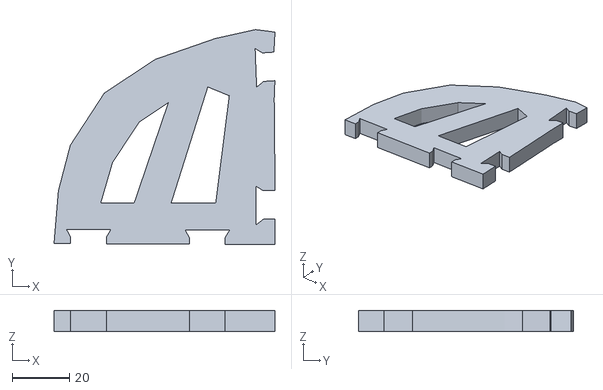
[picture p169: CAD file, 2026-03-08]
hardware/3d_parts/Left Arm/Shoulder/PivConnectorV1.stl
77.1 x 74.9 x 7.49
