aalonsopuig/Inmoov_ROS2/hardware/3d_parts/Other/BackBottomSupport.FCStd

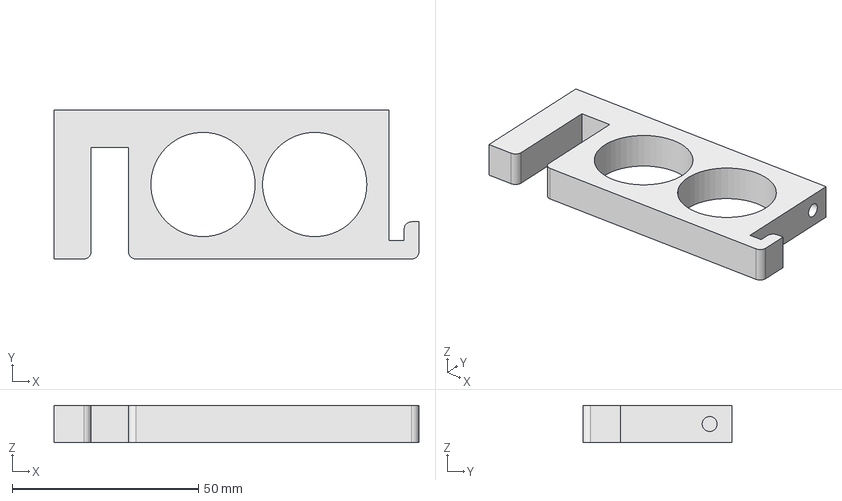
[picture p170: CAD file, 2026-03-08]
hardware/3d_parts/Other/BackBottomSupport.FCStd
98.0 x 40.0 x 10.0 mm
