aalonsopuig/Inmoov_ROS2/hardware/3d_parts/Right Arm/Bicep/higharmsideV1.stl

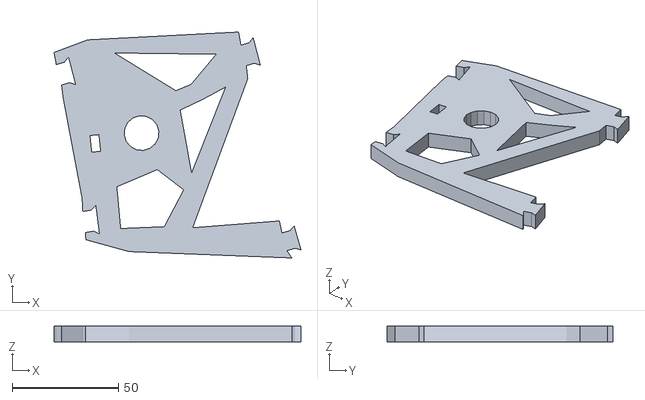
[picture p171: CAD file, 2026-03-08]
hardware/3d_parts/Right Arm/Bicep/higharmsideV1.stl
116.5 x 106.5 x 7.50
