aalonsopuig/Inmoov_ROS2/hardware/3d_parts/Right Arm/Hand/WristlargeV4.stl

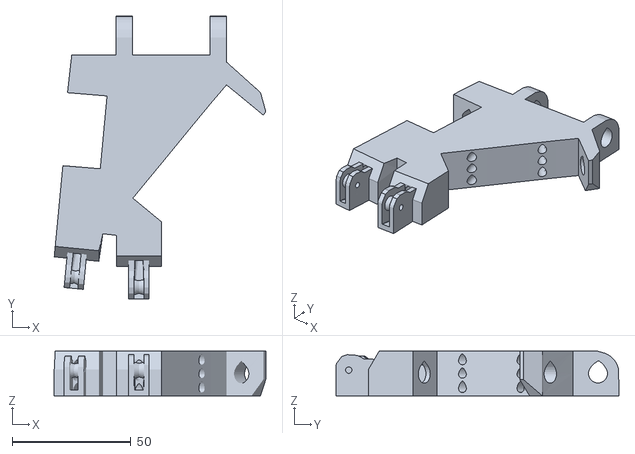
[picture p172: CAD file, 2026-03-08]
hardware/3d_parts/Right Arm/Hand/WristlargeV4.stl
89.2 x 119.4 x 18.9
