aalonsopuig/Inmoov_ROS2/hardware/3d_parts/Right Arm/Shoulder/PistonbaseV4.stl

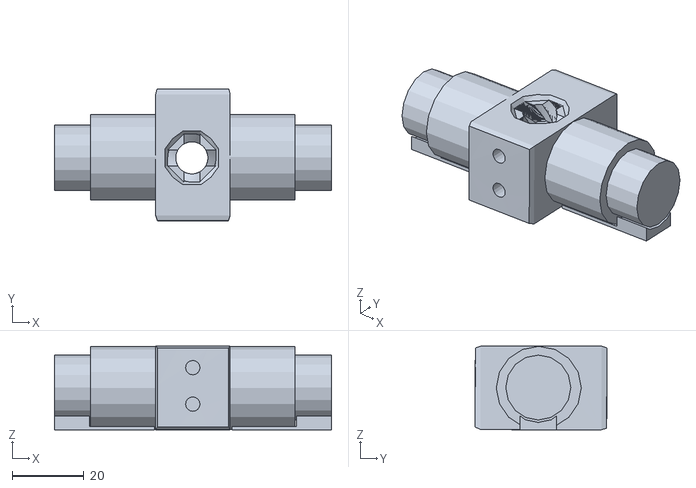
[picture p173: CAD file, 2026-03-08]
hardware/3d_parts/Right Arm/Shoulder/PistonbaseV4.stl
77.0 x 36.6 x 23.2
