aalonsopuig/Inmoov_ROS2/hardware/3d_parts/Trunk/Chest/UnderKinectV1.stl

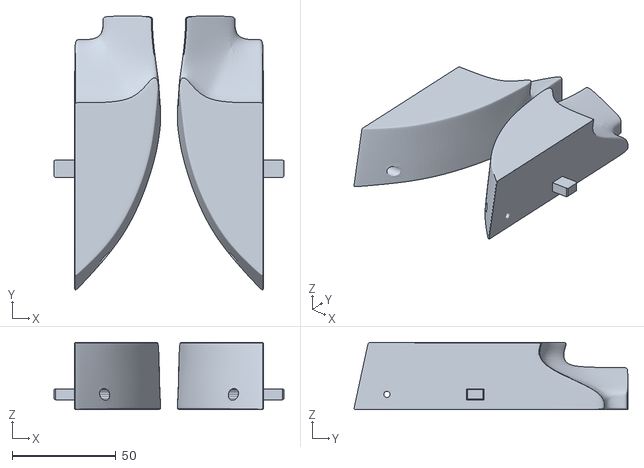
[picture p174: CAD file, 2026-03-08]
hardware/3d_parts/Trunk/Chest/UnderKinectV1.stl
110.8 x 132.0 x 32.4
