aalonsopuig/Inmoov_ROS2/hardware/3d_parts/Trunk/Torso/InterKinectMidV1.stl

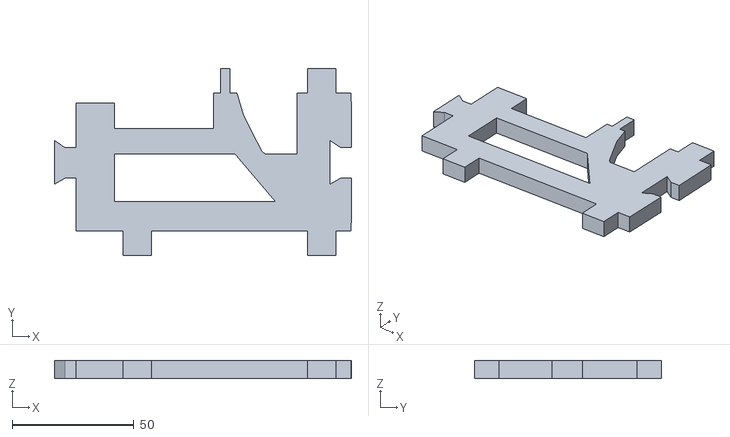
[picture p175: CAD file, 2026-03-08]
hardware/3d_parts/Trunk/Torso/InterKinectMidV1.stl
122.0 x 76.7 x 7.49
