aalonsopuig/Inmoov_ROS2/inmoov_ws/src/inmoov_meshes/meshes/kinectone.stl

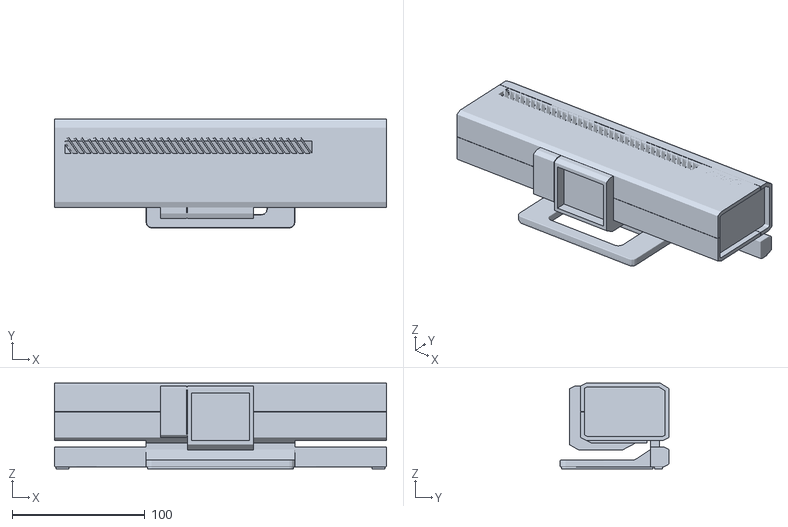
[picture p176: CAD file, 2025-06-18]
inmoov_ws/src/inmoov_meshes/meshes/kinectone.stl
250.0 x 82.0 x 64.5
