aalonsopuig/Inmoov_ROS2/hardware/3d_parts/Head and Neck/Eye mechanism/EyeSupportV3.stl

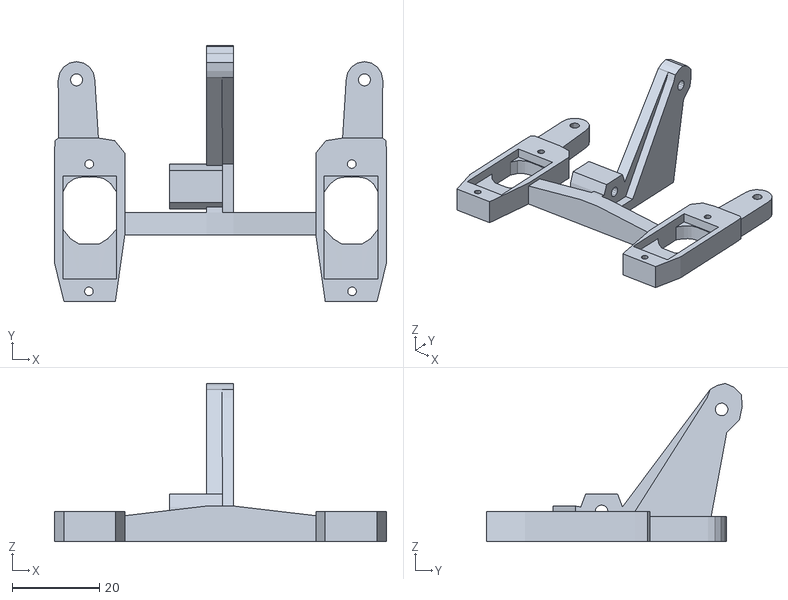
[picture p177: CAD file, 2026-03-08]
hardware/3d_parts/Head and Neck/Eye mechanism/EyeSupportV3.stl
76.2 x 58.7 x 36.3
