aalonsopuig/Inmoov_ROS2/hardware/3d_parts/Head and Neck/Neck Mechanism/GearHolderV1.stl

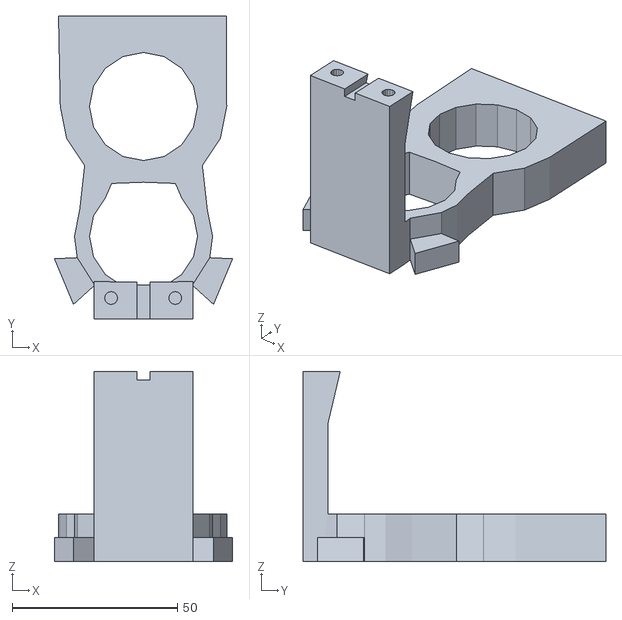
[picture p178: CAD file, 2026-03-08]
hardware/3d_parts/Head and Neck/Neck Mechanism/GearHolderV1.stl
53.9 x 91.6 x 57.5
