aalonsopuig/Inmoov_ROS2/hardware/3d_parts/Left Arm/Bicep/lowarmsideV1.stl

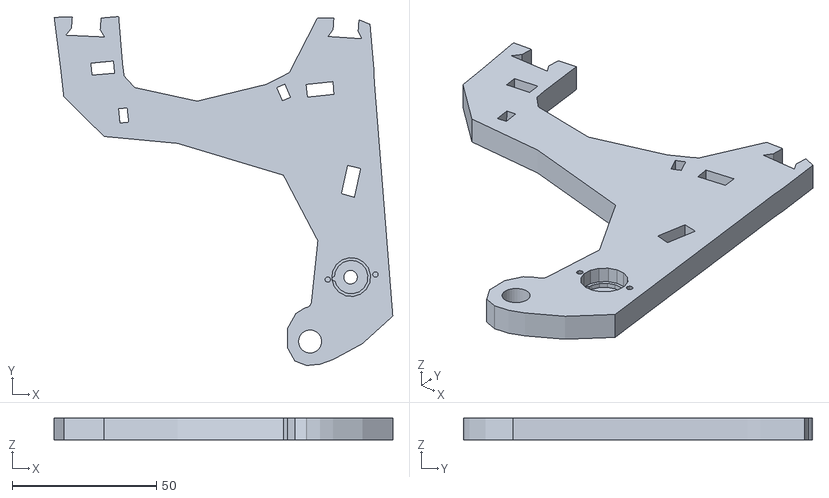
[picture p179: CAD file, 2026-03-08]
hardware/3d_parts/Left Arm/Bicep/lowarmsideV1.stl
117.3 x 120.9 x 7.50
