aalonsopuig/Inmoov_ROS2/hardware/3d_parts/Left Arm/Shoulder/PivPotentioV2.stl

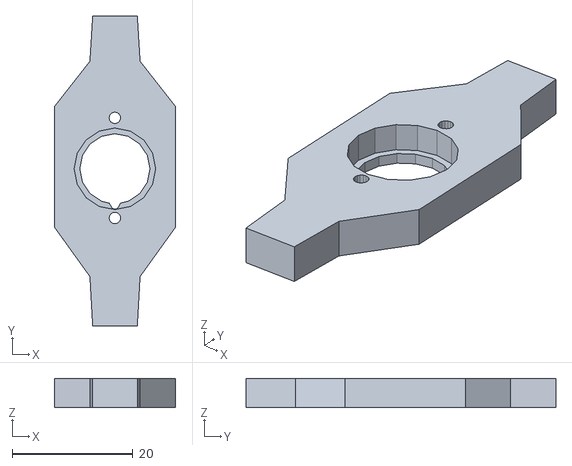
[picture p180: CAD file, 2026-03-08]
hardware/3d_parts/Left Arm/Shoulder/PivPotentioV2.stl
20.1 x 51.3 x 4.83
