aalonsopuig/Inmoov_ROS2/hardware/3d_parts/Other/connectors2.stl

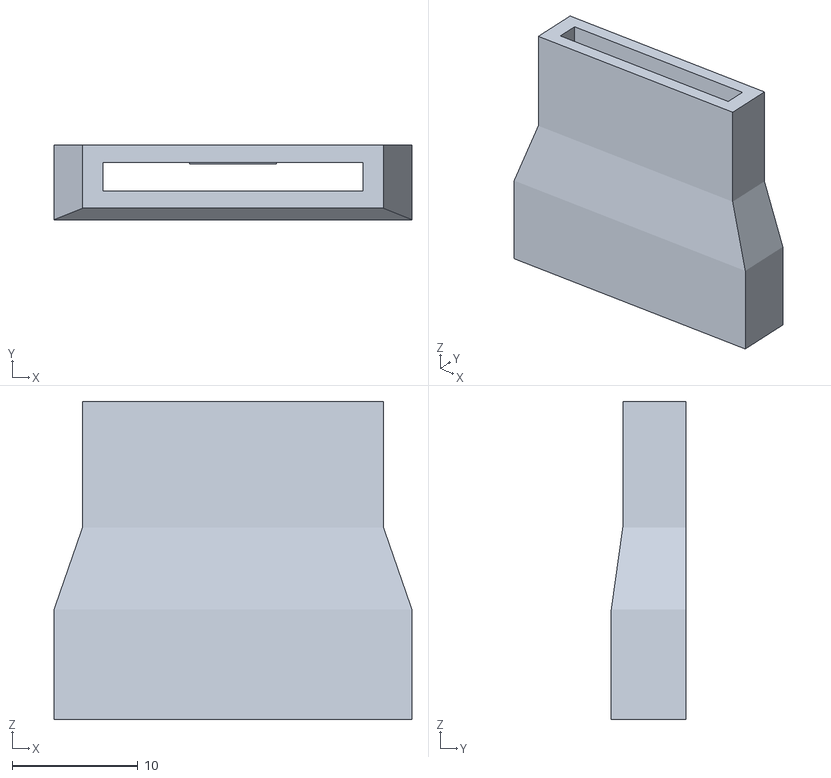
[picture p181: CAD file, 2026-03-08]
hardware/3d_parts/Other/connectors2.stl
28.4 x 5.91 x 25.3
