aalonsopuig/Inmoov_ROS2/hardware/3d_parts/Trunk/Chest/BottomChestV1.stl

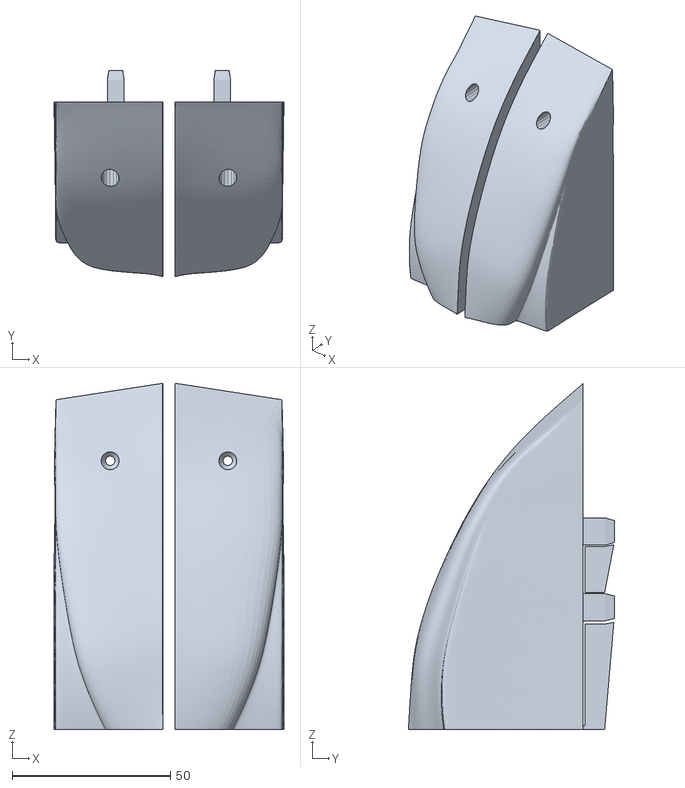
[picture p182: CAD file, 2026-03-08]
hardware/3d_parts/Trunk/Chest/BottomChestV1.stl
72.5 x 65.1 x 109.2
