aalonsopuig/Inmoov_ROS2/hardware/3d_parts/Trunk/Torso/KinectMidFrontV1.stl

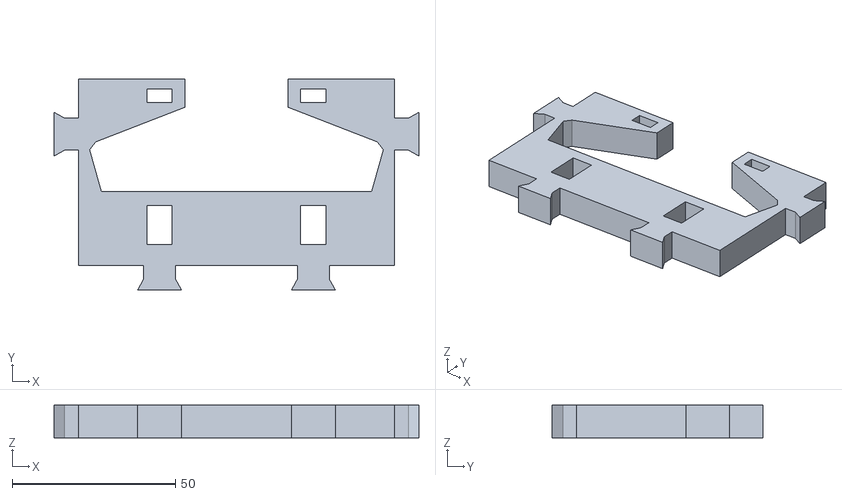
[picture p183: CAD file, 2026-03-08]
hardware/3d_parts/Trunk/Torso/KinectMidFrontV1.stl
111.7 x 64.5 x 10.0
