aalonsopuig/Inmoov_ROS2/inmoov_ws/src/inmoov_meshes/meshes/middle3_1.stl

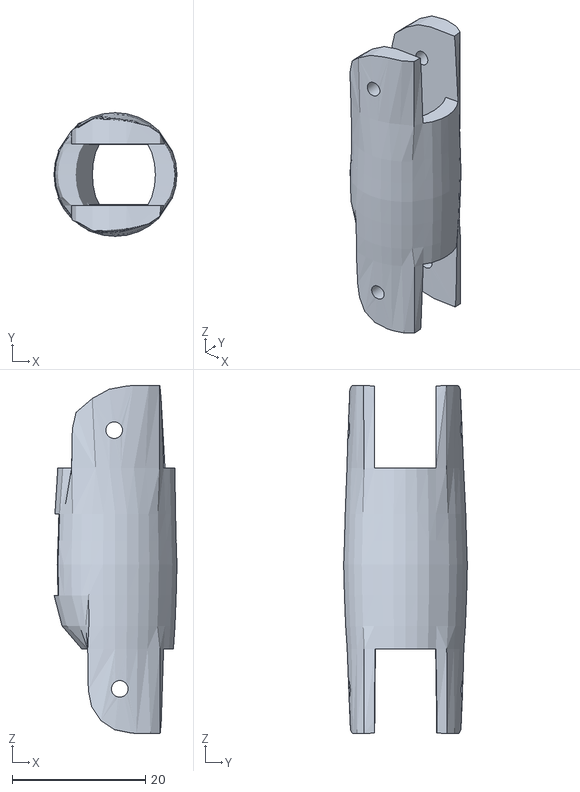
[picture p184: CAD file, 2025-06-18]
inmoov_ws/src/inmoov_meshes/meshes/middle3_1.stl
18.5 x 18.6 x 52.3
