aalonsopuig/Inmoov_ROS2/hardware/3d_parts/Head and Neck/Eye mechanism/EyeMoverSideV3.stl

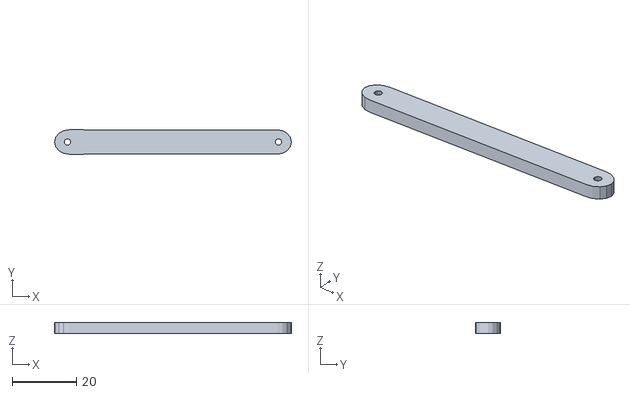
[picture p185: CAD file, 2026-03-08]
hardware/3d_parts/Head and Neck/Eye mechanism/EyeMoverSideV3.stl
74.0 x 7.65 x 3.36
