aalonsopuig/Inmoov_ROS2/hardware/3d_parts/Head and Neck/Neck Mechanism/SkullServoFixV1.stl

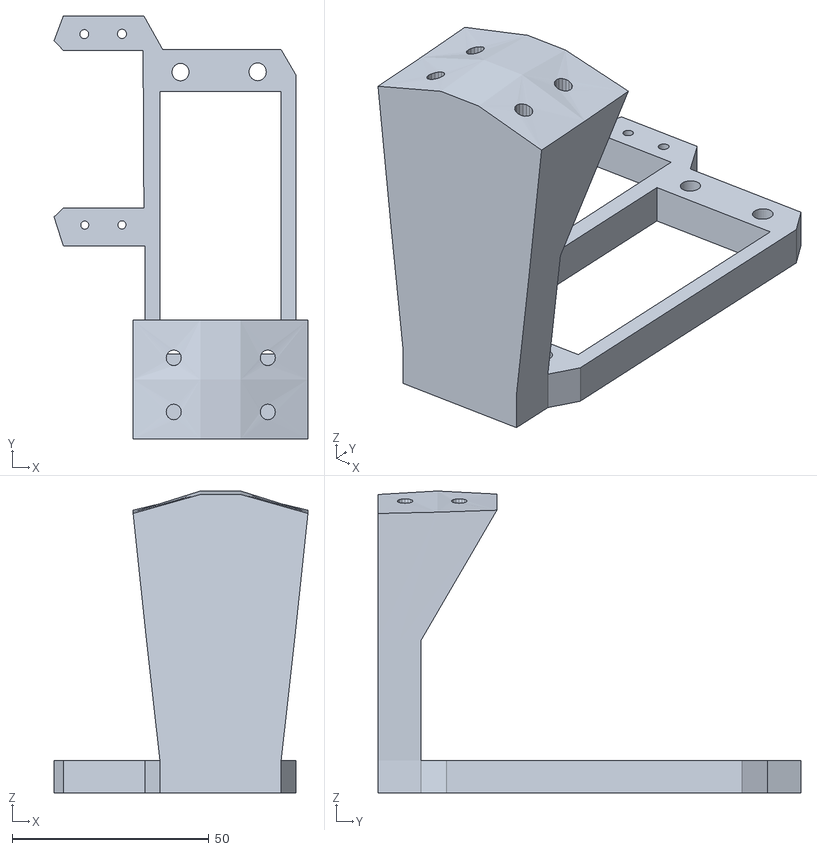
[picture p186: CAD file, 2026-03-08]
hardware/3d_parts/Head and Neck/Neck Mechanism/SkullServoFixV1.stl
64.5 x 107.4 x 76.7
