aalonsopuig/Inmoov_ROS2/hardware/3d_parts/Left Arm/Bicep/PistonbaseantiV1.stl

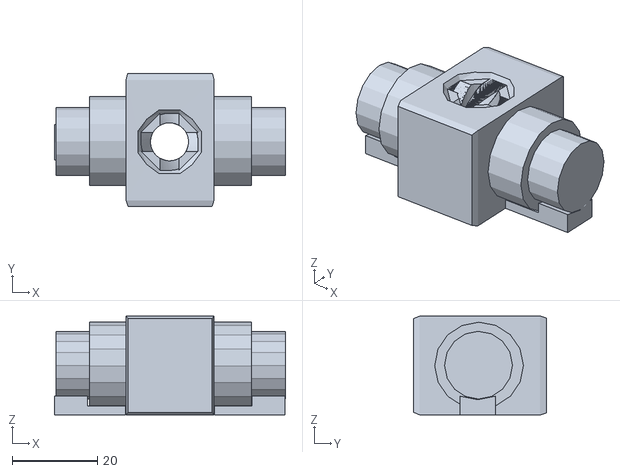
[picture p187: CAD file, 2026-03-08]
hardware/3d_parts/Left Arm/Bicep/PistonbaseantiV1.stl
54.3 x 31.2 x 23.2
