aalonsopuig/Inmoov_ROS2/hardware/3d_parts/Left Arm/Hand/Auriculaire3.stl

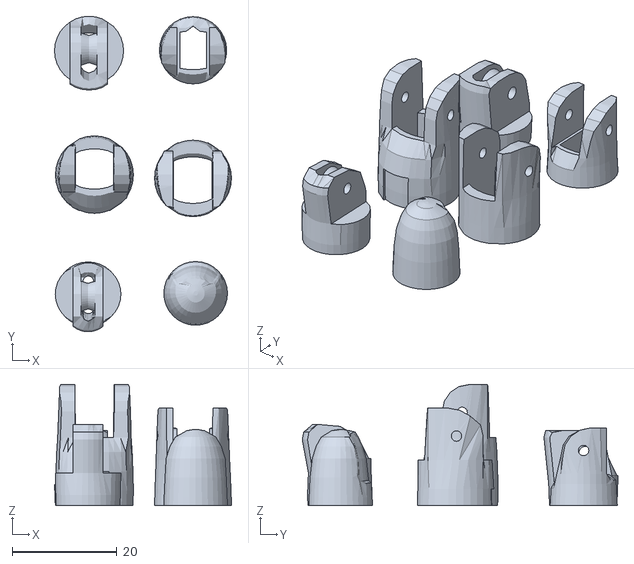
[picture p188: CAD file, 2026-03-08]
hardware/3d_parts/Left Arm/Hand/Auriculaire3.stl
33.8 x 60.3 x 23.2
