aalonsopuig/Inmoov_ROS2/hardware/3d_parts/Right Arm/Shoulder/PivcenterV1.stl

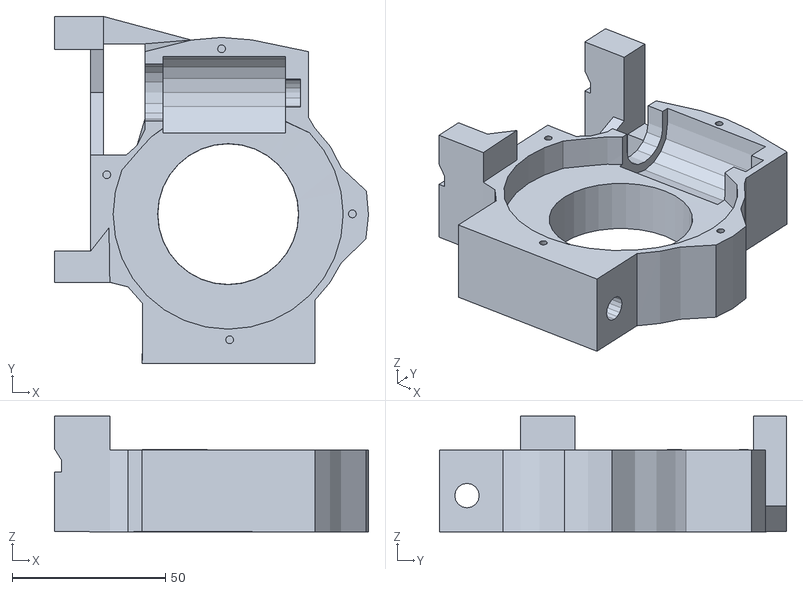
[picture p189: CAD file, 2026-03-08]
hardware/3d_parts/Right Arm/Shoulder/PivcenterV1.stl
102.6 x 113.4 x 37.8
