aalonsopuig/Inmoov_ROS2/hardware/3d_parts/Trunk/Chest/InMLeftV1.stl

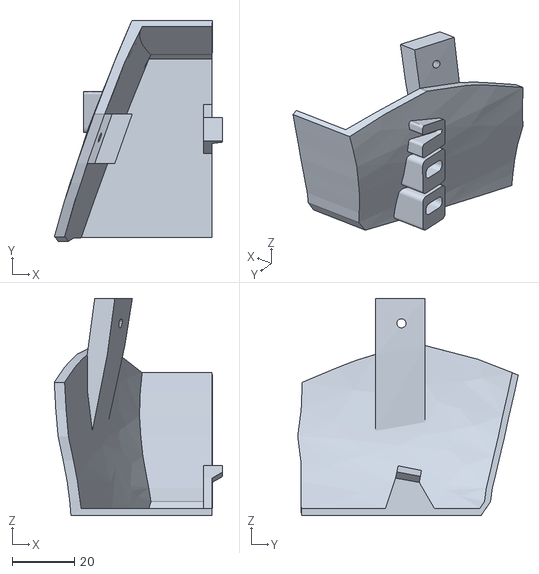
[picture p190: CAD file, 2026-03-08]
hardware/3d_parts/Trunk/Chest/InMLeftV1.stl
53.9 x 70.6 x 69.5
