aalonsopuig/Inmoov_ROS2/hardware/3d_parts/Trunk/Torso/SternumV1.stl

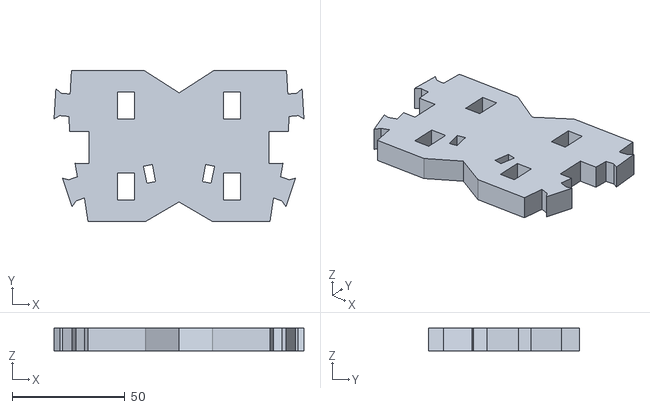
[picture p191: CAD file, 2026-03-08]
hardware/3d_parts/Trunk/Torso/SternumV1.stl
110.9 x 67.0 x 10.0
