aalonsopuig/Inmoov_ROS2/inmoov_ws/src/inmoov_meshes/meshes/earleftv1.stl

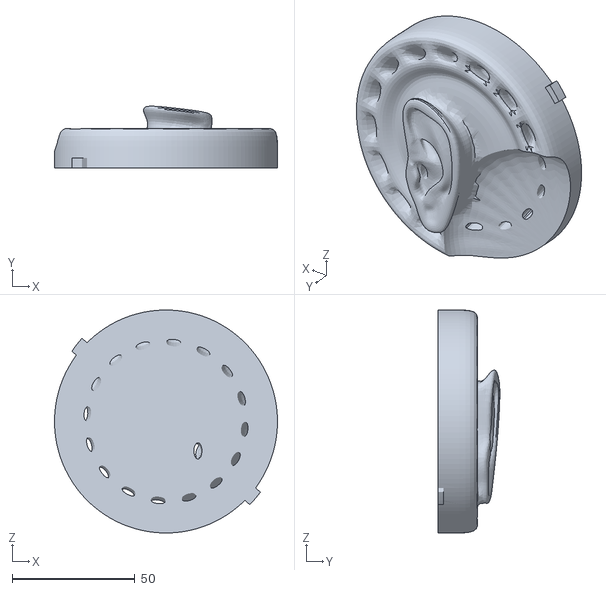
[picture p192: CAD file, 2025-06-18]
inmoov_ws/src/inmoov_meshes/meshes/earleftv1.stl
91.0 x 25.2 x 91.0
