aalonsopuig/Inmoov_ROS2/hardware/3d_parts/Head and Neck/Eye mechanism/EyeCameraV3.stl

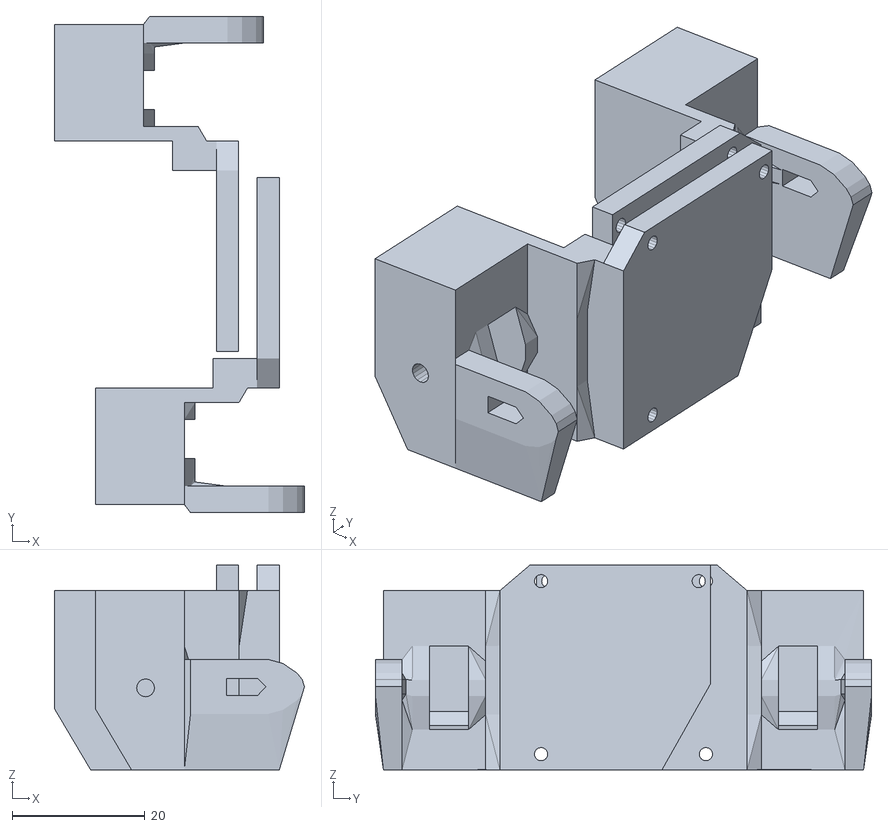
[picture p193: CAD file, 2026-03-08]
hardware/3d_parts/Head and Neck/Eye mechanism/EyeCameraV3.stl
37.7 x 74.9 x 30.9
