aalonsopuig/Inmoov_ROS2/hardware/3d_parts/Head and Neck/Neck Mechanism/ThroatHoleV2.stl

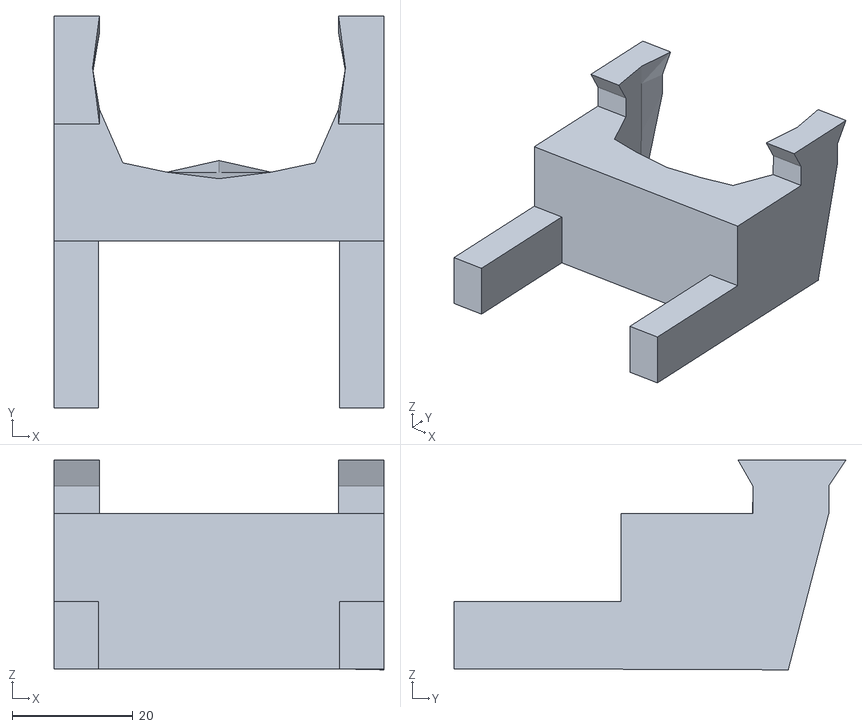
[picture p194: CAD file, 2026-03-08]
hardware/3d_parts/Head and Neck/Neck Mechanism/ThroatHoleV2.stl
54.6 x 64.8 x 34.7
