aalonsopuig/Inmoov_ROS2/hardware/3d_parts/Left Arm/Bicep/armtopcover1.stl

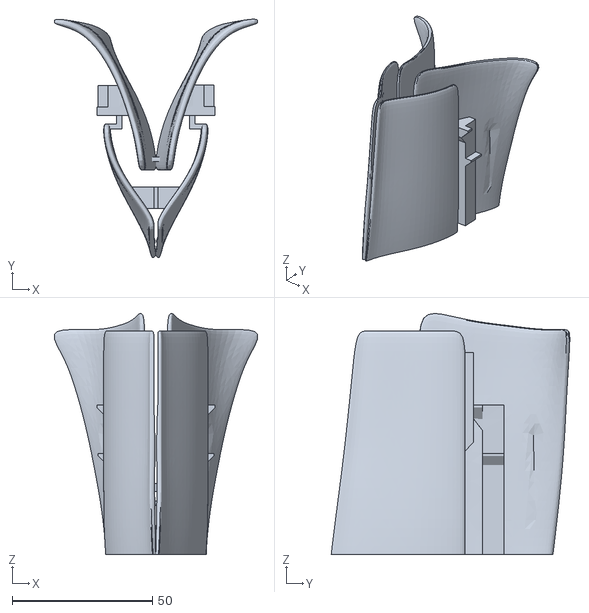
[picture p195: CAD file, 2026-03-08]
hardware/3d_parts/Left Arm/Bicep/armtopcover1.stl
72.7 x 85.2 x 86.1
