aalonsopuig/Inmoov_ROS2/hardware/3d_parts/Left Arm/Hand/leftthumb5.stl

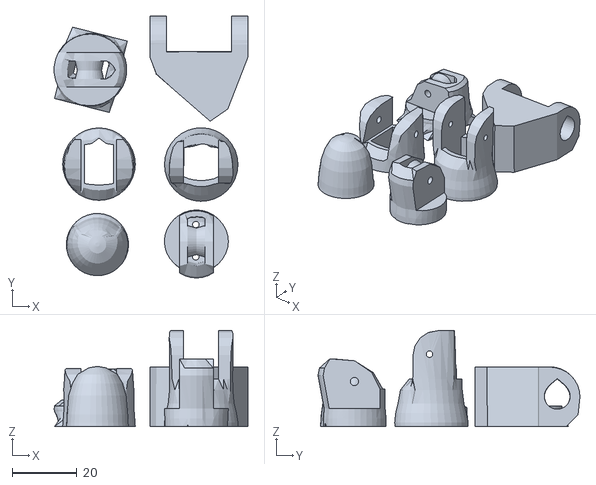
[picture p196: CAD file, 2026-03-08]
hardware/3d_parts/Left Arm/Hand/leftthumb5.stl
60.1 x 81.2 x 29.8
