aalonsopuig/Inmoov_ROS2/hardware/3d_parts/Other/BackTopSupport.FCStd

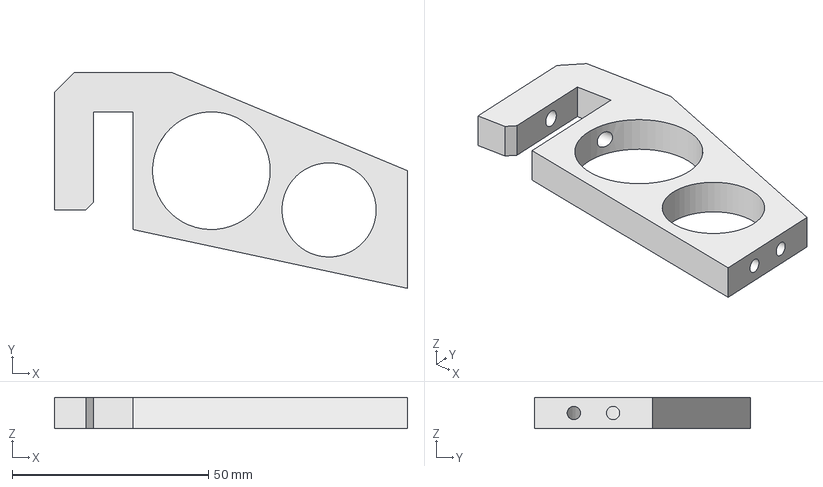
[picture p197: CAD file, 2026-03-08]
hardware/3d_parts/Other/BackTopSupport.FCStd
90.0 x 55.0 x 8.00 mm
