aalonsopuig/Inmoov_ROS2/hardware/3d_parts/Right Arm/Bicep/RotWormV5.stl

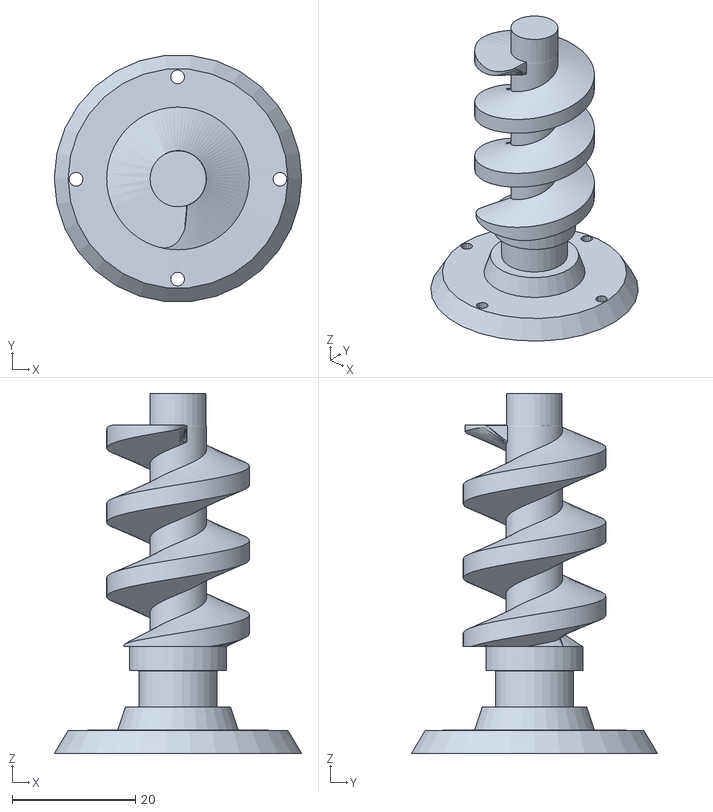
[picture p198: CAD file, 2026-03-08]
hardware/3d_parts/Right Arm/Bicep/RotWormV5.stl
40.2 x 39.9 x 58.4
