aalonsopuig/Inmoov_ROS2/hardware/3d_parts/Trunk/Torso/KinectSideBackV1.stl

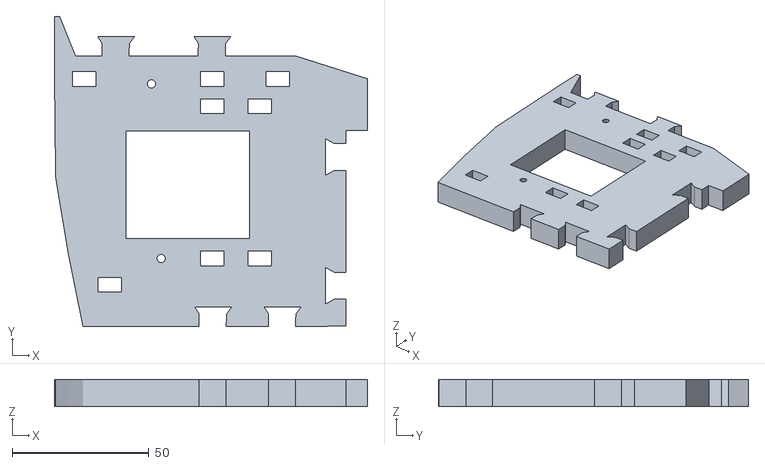
[picture p200: CAD file, 2026-03-08]
hardware/3d_parts/Trunk/Torso/KinectSideBackV1.stl
114.7 x 113.5 x 10.0
