aalonsopuig/Inmoov_ROS2/inmoov_ws/src/inmoov_meshes/meshes/mid_stomach.stl

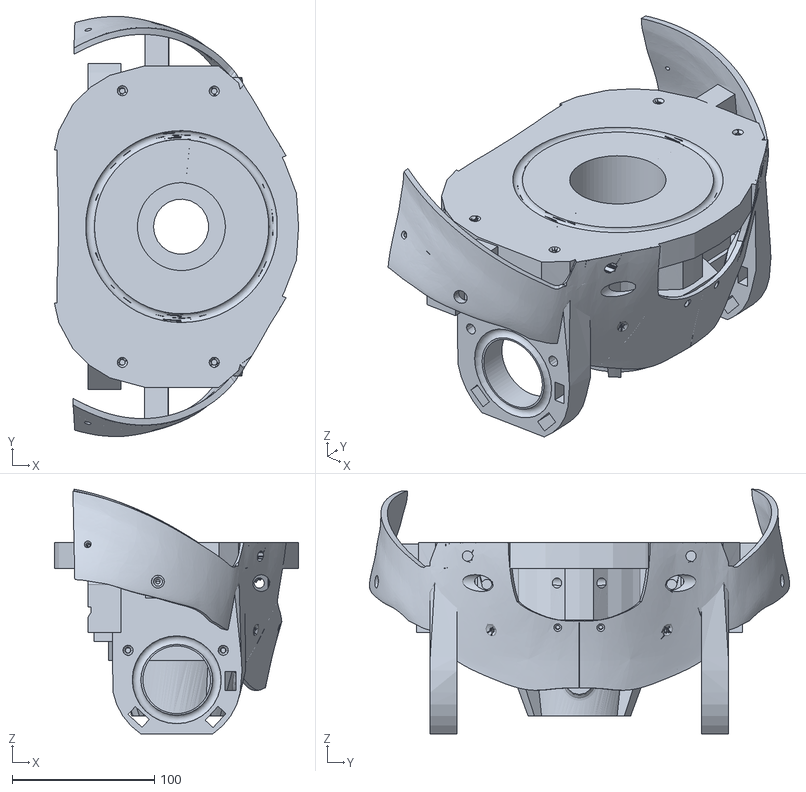
[picture p201: CAD file, 2025-06-18]
inmoov_ws/src/inmoov_meshes/meshes/mid_stomach.stl
171.8 x 295.4 x 172.1
