aalonsopuig/Inmoov_ROS2/hardware/3d_parts/Head and Neck/Eye mechanism/EyeMoverUpV3.stl

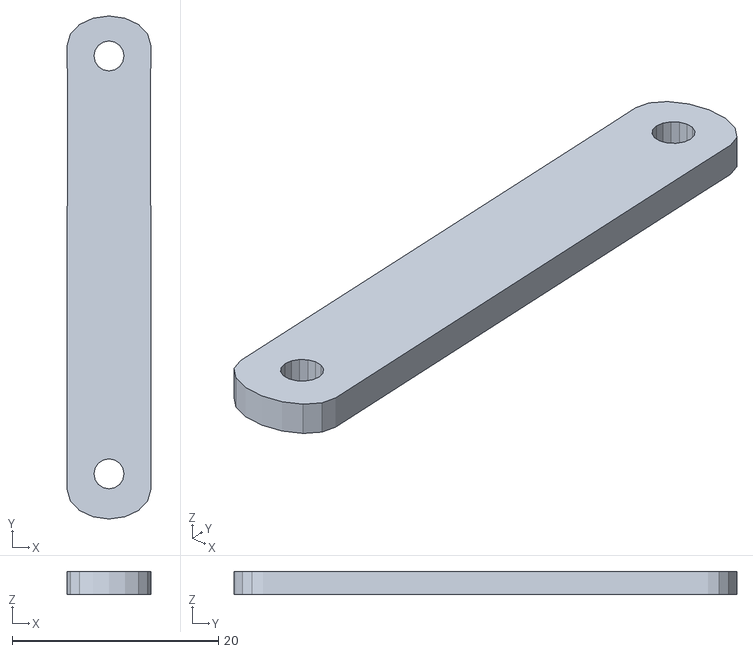
[picture p202: CAD file, 2026-03-08]
hardware/3d_parts/Head and Neck/Eye mechanism/EyeMoverUpV3.stl
8.12 x 48.8 x 2.27
