aalonsopuig/Inmoov_ROS2/hardware/3d_parts/Head and Neck/Neck Mechanism/ThroatPistonBaseV2.stl

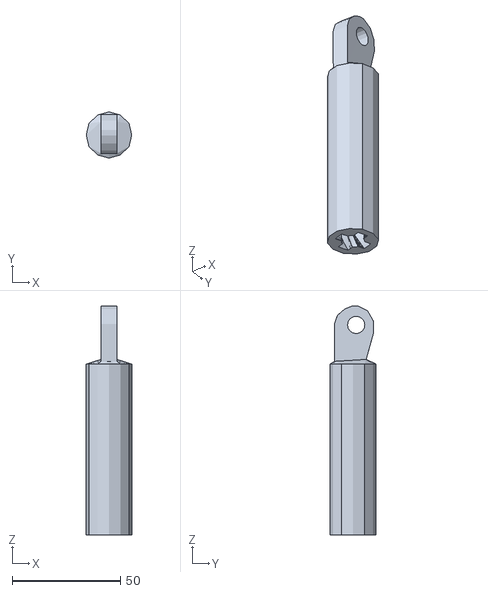
[picture p203: CAD file, 2026-03-08]
hardware/3d_parts/Head and Neck/Neck Mechanism/ThroatPistonBaseV2.stl
21.1 x 21.4 x 105.9
