aalonsopuig/Inmoov_ROS2/hardware/3d_parts/Left Arm/Shoulder/leftPivMitV1.stl

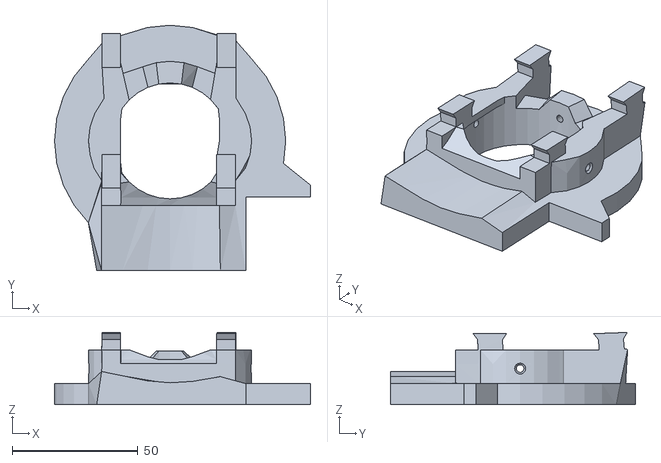
[picture p204: CAD file, 2026-03-08]
hardware/3d_parts/Left Arm/Shoulder/leftPivMitV1.stl
101.6 x 97.5 x 28.7
