aalonsopuig/Inmoov_ROS2/hardware/3d_parts/Other/BaseExtra.stl

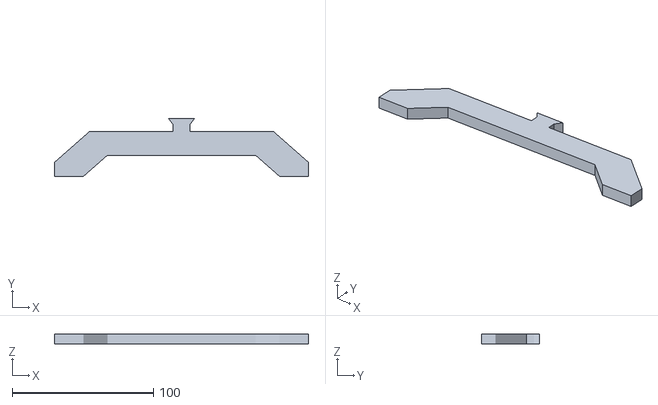
[picture p205: CAD file, 2026-03-08]
hardware/3d_parts/Other/BaseExtra.stl
180.0 x 41.0 x 7.00
