aalonsopuig/Inmoov_ROS2/hardware/3d_parts/Right Arm/Shoulder/servoholderV1.stl

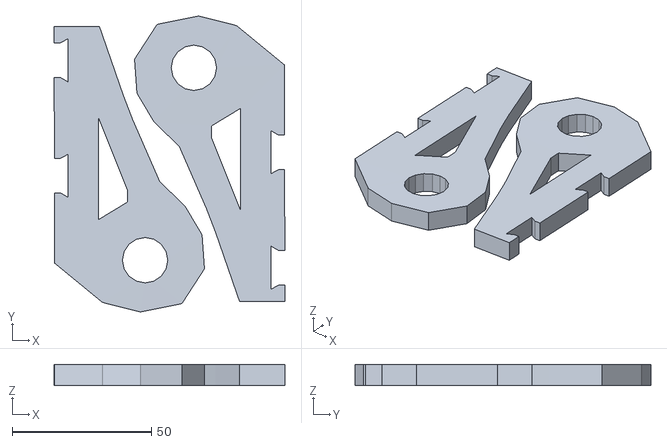
[picture p206: CAD file, 2026-03-08]
hardware/3d_parts/Right Arm/Shoulder/servoholderV1.stl
82.8 x 106.2 x 7.56
