aalonsopuig/Inmoov_ROS2/inmoov_ws/src/inmoov_meshes/meshes/iris.stl

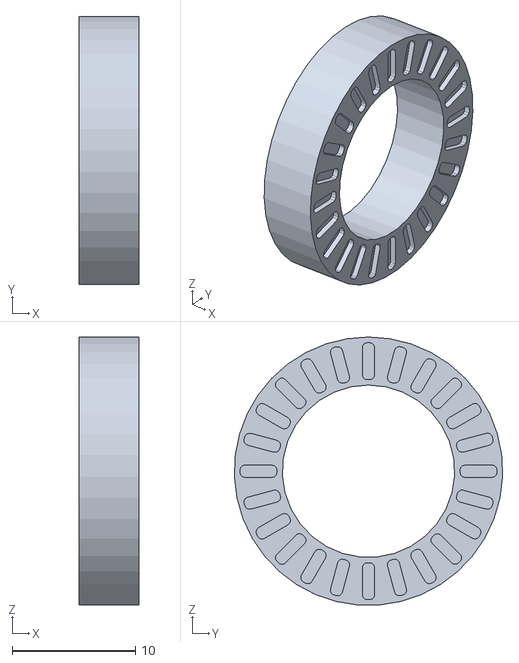
[picture p207: CAD file, 2025-06-18]
inmoov_ws/src/inmoov_meshes/meshes/iris.stl
4.85 x 21.8 x 21.8
