aalonsopuig/Inmoov_ROS2/(list of files, cad)

Other CAD files:
hardware/3d_parts/Head and Neck/Ears/EarLeftV0.stl
hardware/3d_parts/Head and Neck/Skull parts/TopskullRightV3.stl
hardware/3d_parts/Right Arm/Other/robcap3V1.stl
hardware/3d_parts/Trunk/Back/BatteryHolderRightV1.stl
hardware/3d_parts/Right Arm/Forearm/RobCableBackV3.stl
hardware/3d_parts/Left Arm/Wrist/Leftrotawrist1V3.stl
hardware/3d_parts/Right Arm/Hand/coverfinger1.stl
hardware/3d_parts/Left Arm/Wrist/leftrotawrist2.stl
hardware/3d_parts/Right Arm/Forearm/robpart3V3.stl
hardware/3d_parts/Left Arm/Forearm/LeftRobCableFrontV3.stl
hardware/3d_parts/Left Arm/Wrist/LeftCableHolderWristV4.stl
hardware/3d_parts/Right Arm/Forearm/robpart5V3.stl
hardware/3d_parts/Left Arm/Forearm/LeftRobServoBedV5.stl
hardware/3d_parts/Right Arm/Forearm/robpart2V3.stl
hardware/3d_parts/Right Arm/Forearm/robpart4V3.stl
hardware/3d_parts/Right Arm/Hand/WristsmallV3.stl
hardware/3d_parts/Right Arm/Shoulder/PivPotholderV2.stl
hardware/3d_parts/Left Arm/Hand/LeftWristlargeV4.stl
hardware/3d_parts/Right Arm/Hand/thumb5.stl
hardware/3d_parts/Trunk/Chest/ChestLeftV1.stl
hardware/3d_parts/Head and Neck/Eye mechanism/EyeMoverUpExtraV1.stl
hardware/3d_parts/Head and Neck/Eye mechanism/L_EyeInterPiecev1.stl
hardware/3d_parts/Head and Neck/Eye mechanism/R_EyeInterPiecev1.stl
hardware/3d_parts/Head and Neck/Neck Mechanism/NeckBoltsV2.stl
hardware/3d_parts/Head and Neck/Neck Mechanism/NeckV1.stl
hardware/3d_parts/Head and Neck/Neck Mechanism/ServoGearV1.stl
hardware/3d_parts/Head and Neck/Neck Mechanism/ThroatHolderV1.stl
hardware/3d_parts/Head and Neck/Neck Mechanism/ThroatPistonV2.stl
hardware/3d_parts/Left Arm/Bicep/GearHolderV1.stl
hardware/3d_parts/Left Arm/Bicep/RotGearV3.stl
hardware/3d_parts/Left Arm/Bicep/RotMitV2.stl
hardware/3d_parts/Left Arm/Bicep/armtopcover2.stl
hardware/3d_parts/Left Arm/Bicep/leftRotTitV2.stl
hardware/3d_parts/Left Arm/Bicep/leftRotcenterV2.stl
hardware/3d_parts/Left Arm/Bicep/reinforcerV1.stl
hardware/3d_parts/Left Arm/Shoulder/leftPivTitV1.stl
hardware/3d_parts/Left Arm/Shoulder/leftPivcenterV1.stl
hardware/3d_parts/Left Arm/Wrist/Bolt_entretoise6.stl
hardware/3d_parts/Other/BackBottomSupport.stl
hardware/3d_parts/Other/BackBottomSupport_v2.stl
hardware/3d_parts/Other/BackTopSupport.stl
hardware/3d_parts/Other/Bolt 8x26.stl
hardware/3d_parts/Other/Bolt 8x68.stl
hardware/3d_parts/Other/Bolt 8x83.stl
hardware/3d_parts/Right Arm/Bicep/GearHolderV1.stl
hardware/3d_parts/Right Arm/Bicep/RotGearV3.stl
hardware/3d_parts/Right Arm/Bicep/RotMitV2.stl
hardware/3d_parts/Right Arm/Bicep/RotTitV2.stl
hardware/3d_parts/Right Arm/Bicep/RotcenterV2.stl
hardware/3d_parts/Right Arm/Bicep/armtopcover2.stl
hardware/3d_parts/Right Arm/Bicep/reinforcerV1.stl
hardware/3d_parts/Right Arm/Shoulder/PivMitV1.stl
hardware/3d_parts/Right Arm/Wrist/Bolt_entretoise6.stl
hardware/3d_parts/Trunk/Torso/HomLowFront-V1.stl
hardware/3d_parts/Trunk/Torso/InterKinectSideV1.stl
hardware/3d_parts/Trunk/Torso/KinectSideHolderV1.stl
hardware/3d_parts/Trunk/Torso/ThroatLowerV1.stl
hardware/3d_parts/Trunk/Torso/homplateback-V1.stl
hardware/3d_parts/Trunk/Torso/homplatebacklow+V1.stl
hardware/3d_parts/Trunk/Torso/homplatebacklow-V1.stl
hardware/3d_parts/Trunk/Torso/homplatefront+V1.stl
hardware/3d_parts/Trunk/Torso/homplatefront-V1.stl
inmoov_ws/src/inmoov_meshes/meshes/bicep.stl
inmoov_ws/src/inmoov_meshes/meshes/bicepcover.stl
inmoov_ws/src/inmoov_meshes/meshes/camera.stl
inmoov_ws/src/inmoov_meshes/meshes/chest.stl
inmoov_ws/src/inmoov_meshes/meshes/disk.stl
inmoov_ws/src/inmoov_meshes/meshes/earrightv1.stl
inmoov_ws/src/inmoov_meshes/meshes/eye.stl
inmoov_ws/src/inmoov_meshes/meshes/eyesupport.stl
inmoov_ws/src/inmoov_meshes/meshes/face.stl
inmoov_ws/src/inmoov_meshes/meshes/head_base.stl
inmoov_ws/src/inmoov_meshes/meshes/index3_1.stl
inmoov_ws/src/inmoov_meshes/meshes/index3_2.stl
inmoov_ws/src/inmoov_meshes/meshes/jaw.stl
inmoov_ws/src/inmoov_meshes/meshes/l_cover_hand.stl
inmoov_ws/src/inmoov_meshes/meshes/l_cover_handpinky.stl
inmoov_ws/src/inmoov_meshes/meshes/l_cover_handring.stl
inmoov_ws/src/inmoov_meshes/meshes/l_cover_index.stl
inmoov_ws/src/inmoov_meshes/meshes/l_cover_middle.stl
inmoov_ws/src/inmoov_meshes/meshes/l_cover_pinky.stl
inmoov_ws/src/inmoov_meshes/meshes/l_cover_ring.stl
inmoov_ws/src/inmoov_meshes/meshes/l_cover_thumb.stl
inmoov_ws/src/inmoov_meshes/meshes/l_eyesupport.stl
inmoov_ws/src/inmoov_meshes/meshes/l_forearm.stl
inmoov_ws/src/inmoov_meshes/meshes/l_hand.stl
inmoov_ws/src/inmoov_meshes/meshes/l_pinky3_1.stl
inmoov_ws/src/inmoov_meshes/meshes/l_ring3_1.stl
inmoov_ws/src/inmoov_meshes/meshes/l_shoulder.stl
inmoov_ws/src/inmoov_meshes/meshes/l_shoulder_base.stl
inmoov_ws/src/inmoov_meshes/meshes/l_thumb5_1.stl
inmoov_ws/src/inmoov_meshes/meshes/middle3_2.stl
inmoov_ws/src/inmoov_meshes/meshes/pinky3_2.stl
inmoov_ws/src/inmoov_meshes/meshes/pinky3_3.stl
inmoov_ws/src/inmoov_meshes/meshes/pinky3_4.stl
inmoov_ws/src/inmoov_meshes/meshes/r_cover_hand.stl
inmoov_ws/src/inmoov_meshes/meshes/r_cover_handpinky.stl
inmoov_ws/src/inmoov_meshes/meshes/r_cover_handring.stl
inmoov_ws/src/inmoov_meshes/meshes/r_cover_index.stl
inmoov_ws/src/inmoov_meshes/meshes/r_cover_middle.stl
inmoov_ws/src/inmoov_meshes/meshes/r_cover_pinky.stl
inmoov_ws/src/inmoov_meshes/meshes/r_cover_ring.stl
inmoov_ws/src/inmoov_meshes/meshes/r_cover_thumb.stl
inmoov_ws/src/inmoov_meshes/meshes/r_eyesupport.stl
inmoov_ws/src/inmoov_meshes/meshes/r_forearm.stl
inmoov_ws/src/inmoov_meshes/meshes/r_pinky3_1.stl
inmoov_ws/src/inmoov_meshes/meshes/r_ring3_1.stl
inmoov_ws/src/inmoov_meshes/meshes/r_shoulder.stl
inmoov_ws/src/inmoov_meshes/meshes/r_shoulder_base.stl
inmoov_ws/src/inmoov_meshes/meshes/r_thumb5_1.stl
inmoov_ws/src/inmoov_meshes/meshes/ring3_2.stl
inmoov_ws/src/inmoov_meshes/meshes/ring3_3.stl
inmoov_ws/src/inmoov_meshes/meshes/ring3_4.stl
inmoov_ws/src/inmoov_meshes/meshes/skull.stl
inmoov_ws/src/inmoov_meshes/meshes/thumb5_2.stl
inmoov_ws/src/inmoov_meshes/meshes/thumb5_3.stl
inmoov_ws/src/inmoov_meshes/meshes/top_stomach.stl
inmoov_ws/src/inmoov_meshes/meshes/torso.stl
inmoov_ws/src/inmoov_meshes/meshes/virtual.stl
