aalonsopuig/Inmoov_ROS2/docs/assembly/Head and Neck/Ears/Instructions.txt

Instructions

Print all parts. Mine are done with ABS. 
I already expect some remarks about these "Too" human ears... 
But the head of InMoov looked flat when seen from the front, and adding human ears, helps in that matter.
