aalonsopuig/Inmoov_ROS2/docs/assembly/Assembly Sketchs.pdf

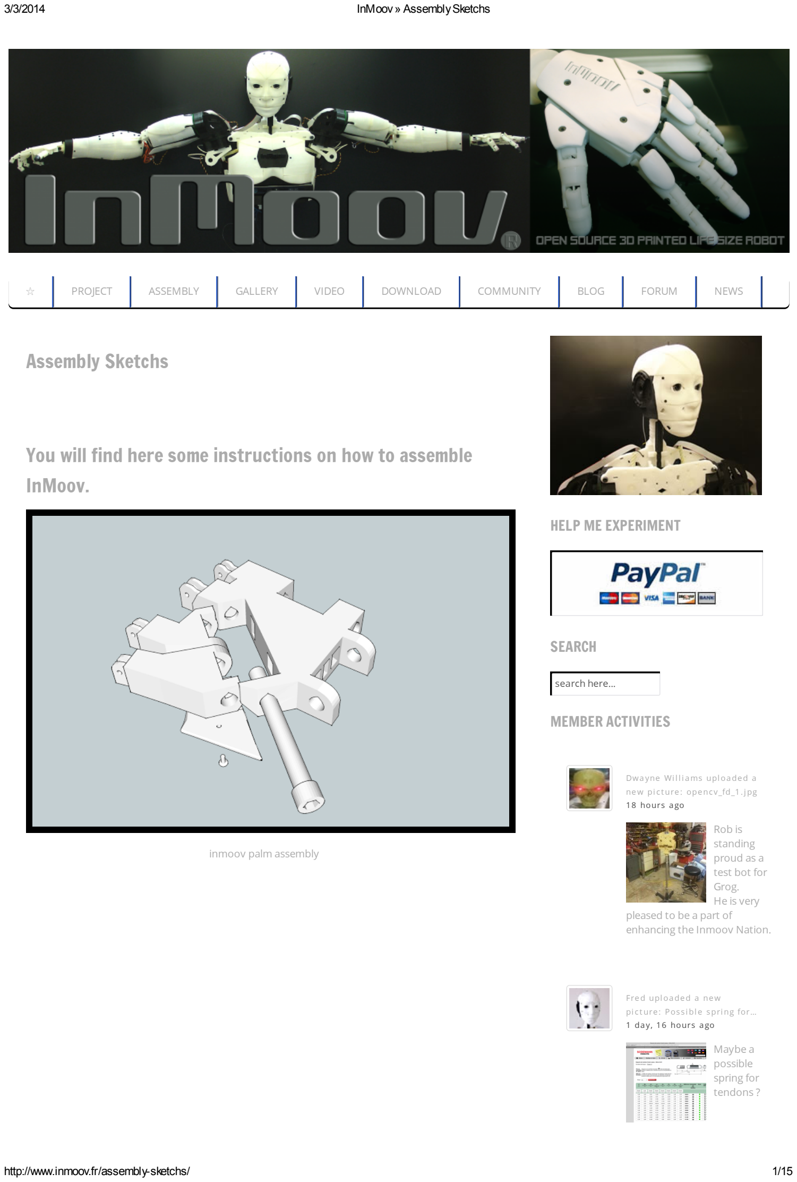
[picture p264: page 1]

3/3/2014 | InMoov» AssemblySketchs
http://www.inmoov.fr/assembly-sketchs/ | 1/15

# Assembly Sketchs

# You will find here some instructions on how to assemble

InMoov.

inmoov palm assembly

## HELP ME EXPERIMENT

## SEARCH

search here...

## MEMBER ACTIVITIES

Dwa yne Wi l l i a ms (http://www.inmoov.fr/members/dwilli9013/) upl oa ded a new pi c t ure : openc v_fd_1. j pg (http://www.inmoov.fr/members/dwilli9013/album/picture/46/) 18 hours a go (http://www.inmoov.fr/activity/p/1213/)

Rob is
standing
proud as a
test bot for
Grog.
He is very
pleased to be a part of
enhancing the Inmoov Nation.

Fred (http://www.inmoov.fr/members/freddyzaz/) upl oa ded a new
pi c t ure : Pos s i bl e spri ng for… (http://www.inmoov.fr/members/freddyzaz/album/picture/45/) 1 da y, 16 hours a go (http://www.inmoov.fr/activity/p/1203/)

Maybe a
possible
spring for
tendons ?
☆ (http://www.inmoov.fr/) | PROJECT (http://www.inmoov.fr/project/) | ASSEMBLY (http://www.inmoov.fr/assembly/) | GALLERY (http://www.inmoov.fr/gallery/) | VIDEO (http://www.inmoov.fr/youvideo/) | DOWNLOAD (http://www.inmoov.fr/download/) | COMMUNITY (http://www.inmoov.fr/community/) | BLOG (http://inmoov.blogspot.com/) | FORUM (https://groups.google.com/forum/#!forum/inmoov) | NEWS (http://www.inmoov.fr/on-the-net/)

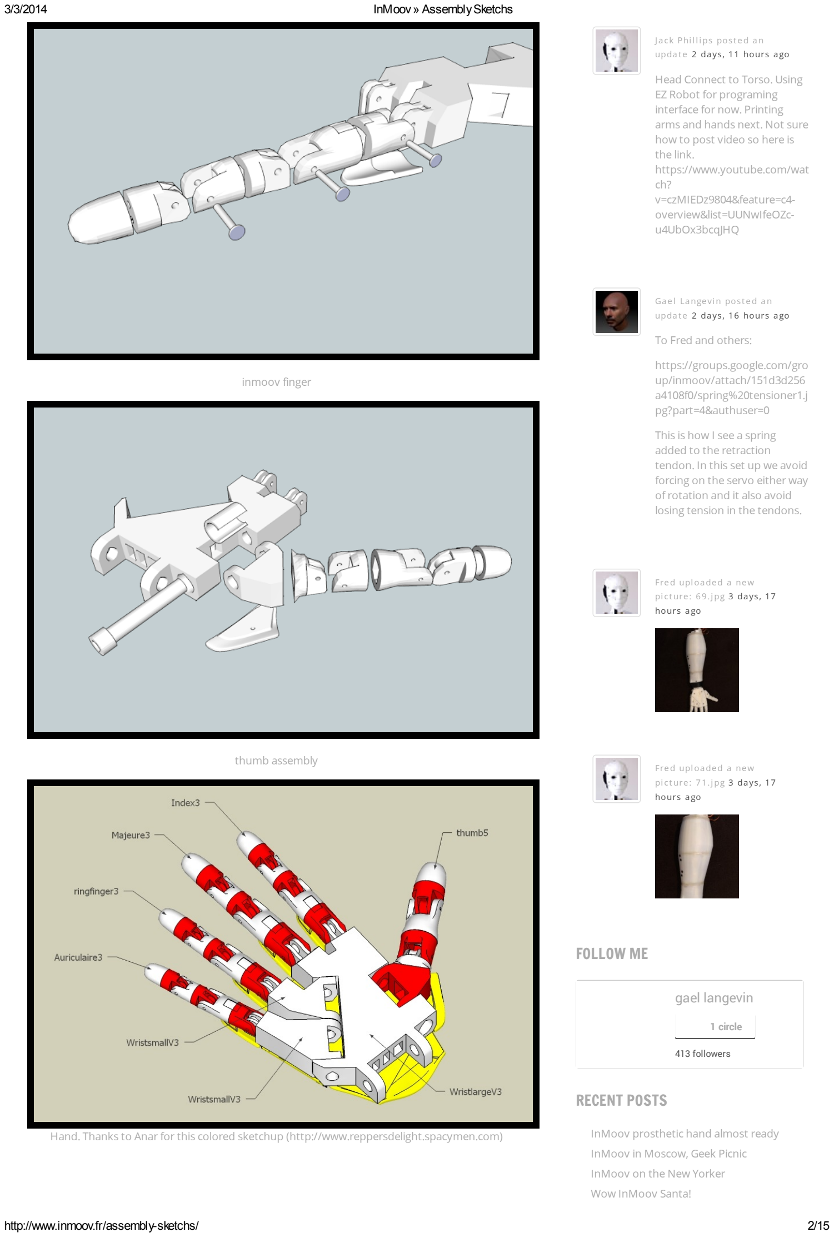
[picture p265: page 2]

inmoov finger

thumb assembly

Hand. Thanks to Anar for this colored sketchup (http://www.reppersdelight.spacymen.com)

J a c k Phi l l i ps (http://www.inmoov.fr/members/jackphillips/) pos t ed a n
upda t e 2 da ys , 11 hours a go (http://www.inmoov.fr/activity/p/1199/)

Head Connect to Torso. Using EZ Robot for programing
interface for now. Printing arms and hands next. Not sure how to post video so here is the link.
https://www.youtube.com/watch?
v=czMIEDz9804&feature=c4-
overview&list=UUNwIfeOZc-u4UbOx3bcqJHQ (https://www.youtube.com/watch?v=czMIEDz9804&feature=c4-overview&list=UUNwIfeOZc-u4UbOx3bcqJHQ)

Ga e l La nge vi n (http://www.inmoov.fr/members/admin/) pos t ed a n upda t e 2 da ys , 16 hours a go (http://www.inmoov.fr/activity/p/1198/)

To Fred and others:

https://groups.google.com/group/inmoov/attach/151d3d256a4108f0/spring%20tensioner1.jpg?part=4&authuser=0 (https://groups.google.com/group/inmoov/attach/151d3d256a4108f0/spring%20tensioner1.jpg?part=4&authuser=0)

This is how I see a spring added to the retraction
tendon. In this set up we avoid forcing on the servo either way of rotation and it also avoid losing tension in the tendons.

Fred (http://www.inmoov.fr/members/freddyzaz/) upl oa ded a new
pi c t ure : 69. j pg (http://www.inmoov.fr/members/freddyzaz/album/picture/44/) 3 da ys , 17 hours a go (http://www.inmoov.fr/activity/p/1183/)

Fred (http://www.inmoov.fr/members/freddyzaz/) upl oa ded a new
pi c t ure : 71. j pg (http://www.inmoov.fr/members/freddyzaz/album/picture/43/) 3 da ys , 17 hours a go (http://www.inmoov.fr/activity/p/1182/)

## FOLLOW ME

## gael langevin (https://plus.google.com/109466702837468444192?prsrc=5)

413 followers

### 1 circle

## RECENT POSTS

InMoov prosthetic hand almost ready (http://www.inmoov.fr/inmoov-prosthetic-hand-almost-ready/) InMoov in Moscow, Geek Picnic (http://www.inmoov.fr/inmoov-in-moscow-geek-picnic/) InMoov on the New Yorker (http://www.inmoov.fr/inmoov-on-the-new-yorker/)
Wow InMoov Santa! (http://www.inmoov.fr/wow-inmoov-santa/)

## RECENT COMMENTS

## ARCHIVES

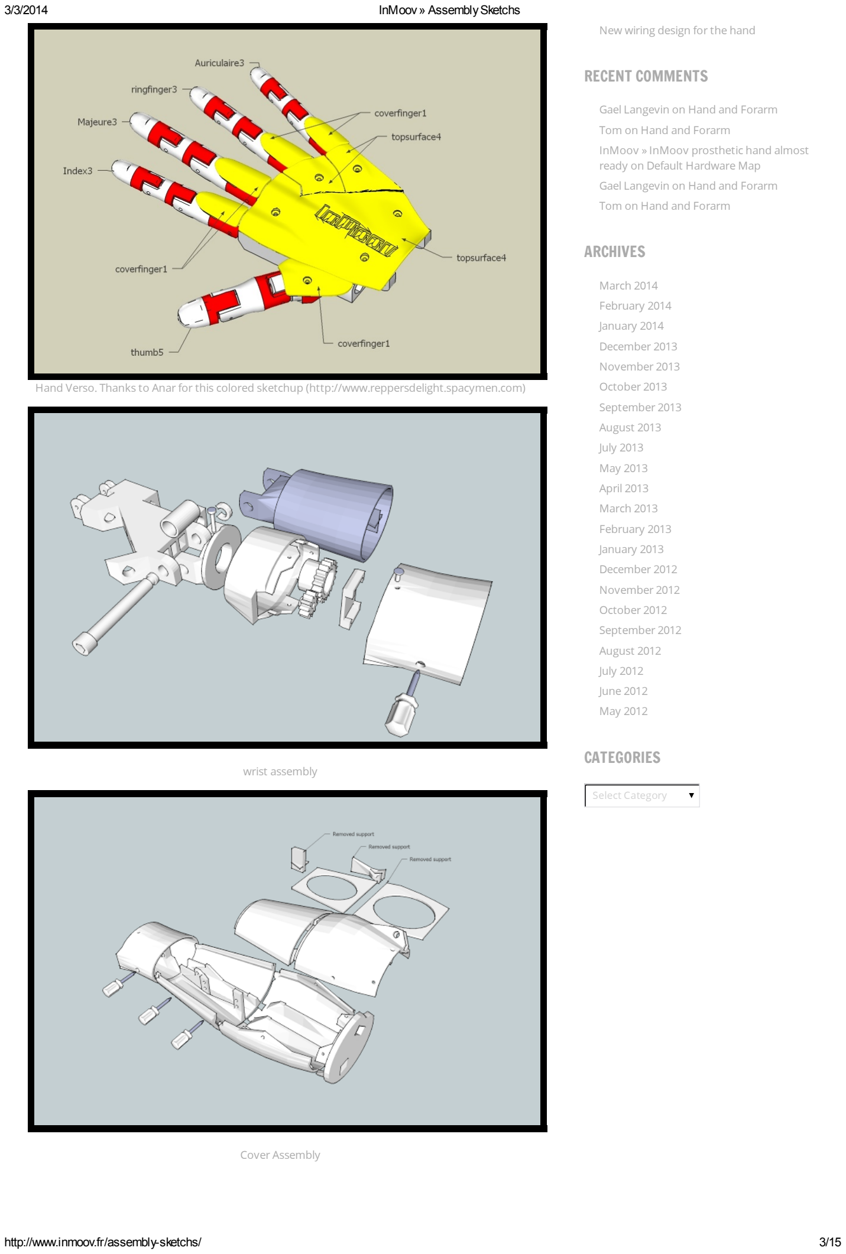
[picture p266: page 3]

Hand Verso. Thanks to Anar for this colored sketchup (http://www.reppersdelight.spacymen.com)

wrist assembly

Cover Assembly

New wiring design for the hand (http://www.inmoov.fr/new-wiring-design-for-the-hand/)

Gael Langevin (http://www.inmoov.fr/) on Hand and Forarm (http://www.inmoov.fr/hand-and-forarm/#comment-482)
Tom on Hand and Forarm (http://www.inmoov.fr/hand-and-forarm/#comment-481)
InMoov » InMoov prosthetic hand almost ready on Default Hardware Map (http://www.inmoov.fr/inmoov-prosthetic-hand-almost-ready/)
Gael Langevin (http://www.inmoov.fr/) on Hand and Forarm (http://www.inmoov.fr/hand-and-forarm/#comment-479)
Tom on Hand and Forarm (http://www.inmoov.fr/hand-and-forarm/#comment-478)

March 2014 (http://www.inmoov.fr/2014/03/)
February 2014 (http://www.inmoov.fr/2014/02/)
January 2014 (http://www.inmoov.fr/2014/01/)
December 2013 (http://www.inmoov.fr/2013/12/)
November 2013 (http://www.inmoov.fr/2013/11/)
October 2013 (http://www.inmoov.fr/2013/10/)
September 2013 (http://www.inmoov.fr/2013/09/)
August 2013 (http://www.inmoov.fr/2013/08/)
July 2013 (http://www.inmoov.fr/2013/07/)
May 2013 (http://www.inmoov.fr/2013/05/)
April 2013 (http://www.inmoov.fr/2013/04/)
March 2013 (http://www.inmoov.fr/2013/03/)
February 2013 (http://www.inmoov.fr/2013/02/)
January 2013 (http://www.inmoov.fr/2013/01/)
December 2012 (http://www.inmoov.fr/2012/12/)
November 2012 (http://www.inmoov.fr/2012/11/)
October 2012 (http://www.inmoov.fr/2012/10/)
September 2012 (http://www.inmoov.fr/2012/09/)
August 2012 (http://www.inmoov.fr/2012/08/)
July 2012 (http://www.inmoov.fr/2012/07/)
June 2012 (http://www.inmoov.fr/2012/06/)
May 2012 (http://www.inmoov.fr/2012/05/)

## CATEGORIES

Select Category

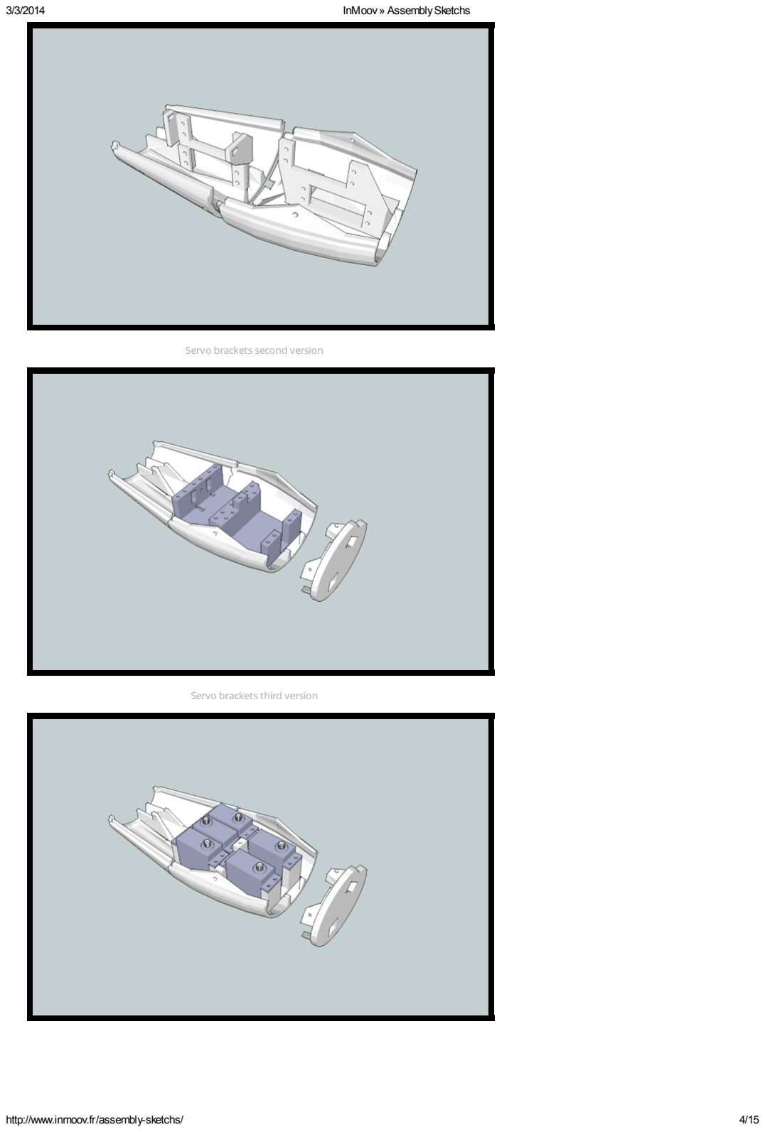
[picture p267: page 4]

Servo brackets second version

Servo brackets third version

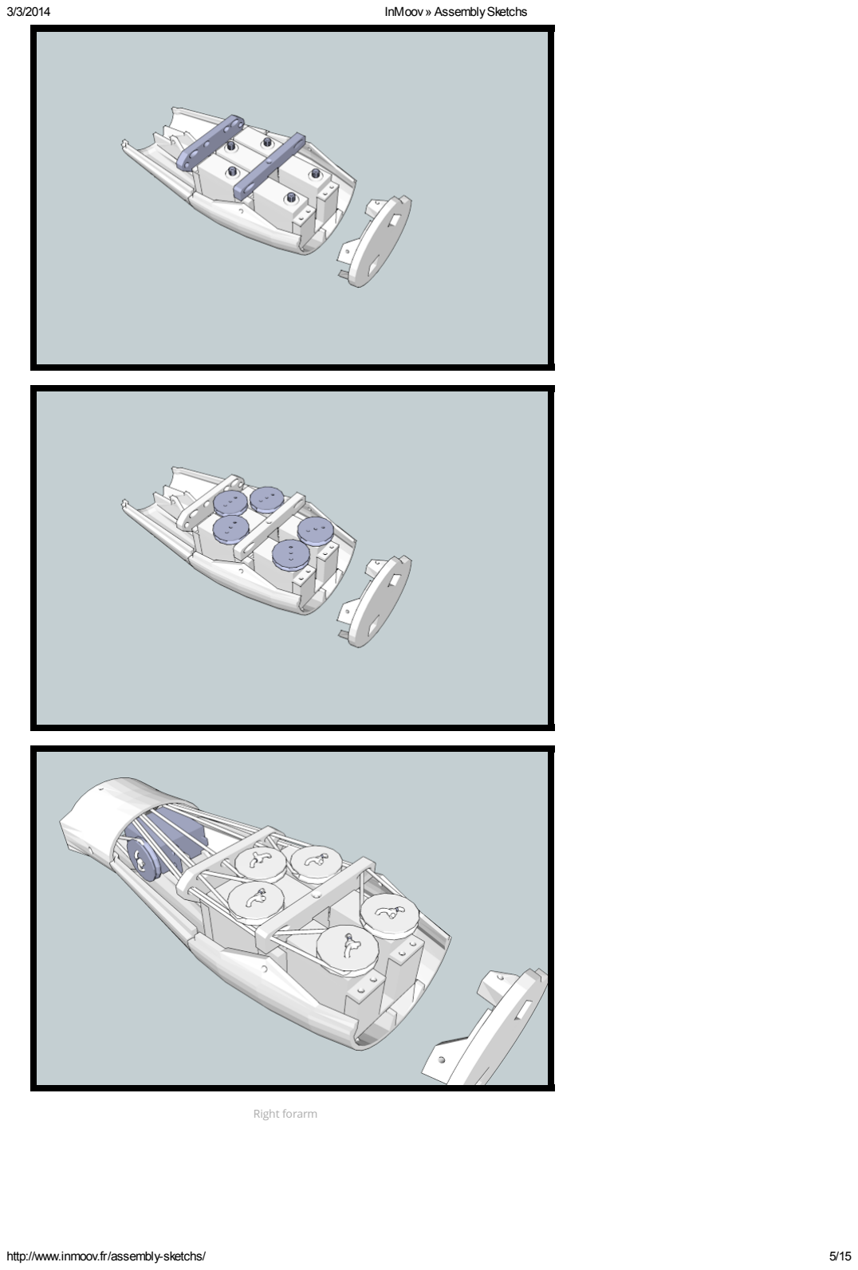
[picture p268: page 5]

Right forarm

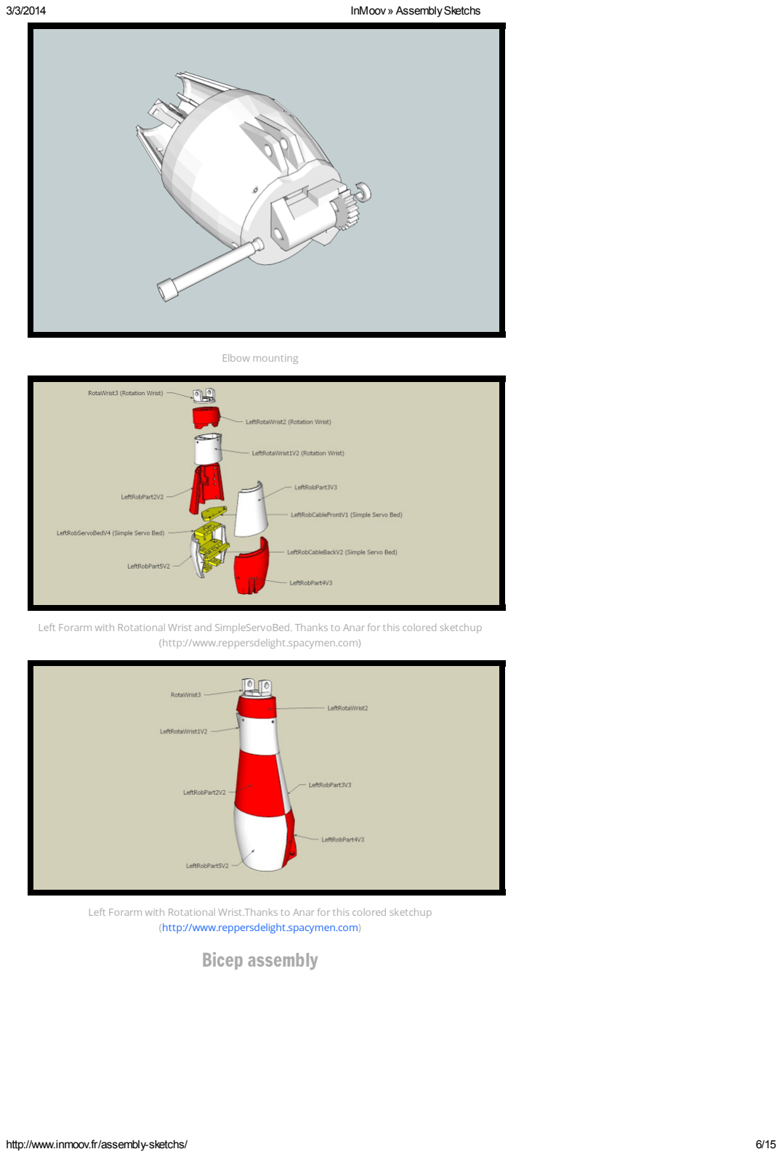
[picture p269: page 6]

Elbow mounting

Left Forarm with Rotational Wrist and SimpleServoBed. Thanks to Anar for this colored sketchup (http://www.reppersdelight.spacymen.com)

Left Forarm with Rotational Wrist.Thanks to Anar for this colored sketchup (http://www.reppersdelight.spacymen.com)

# Bicep assembly

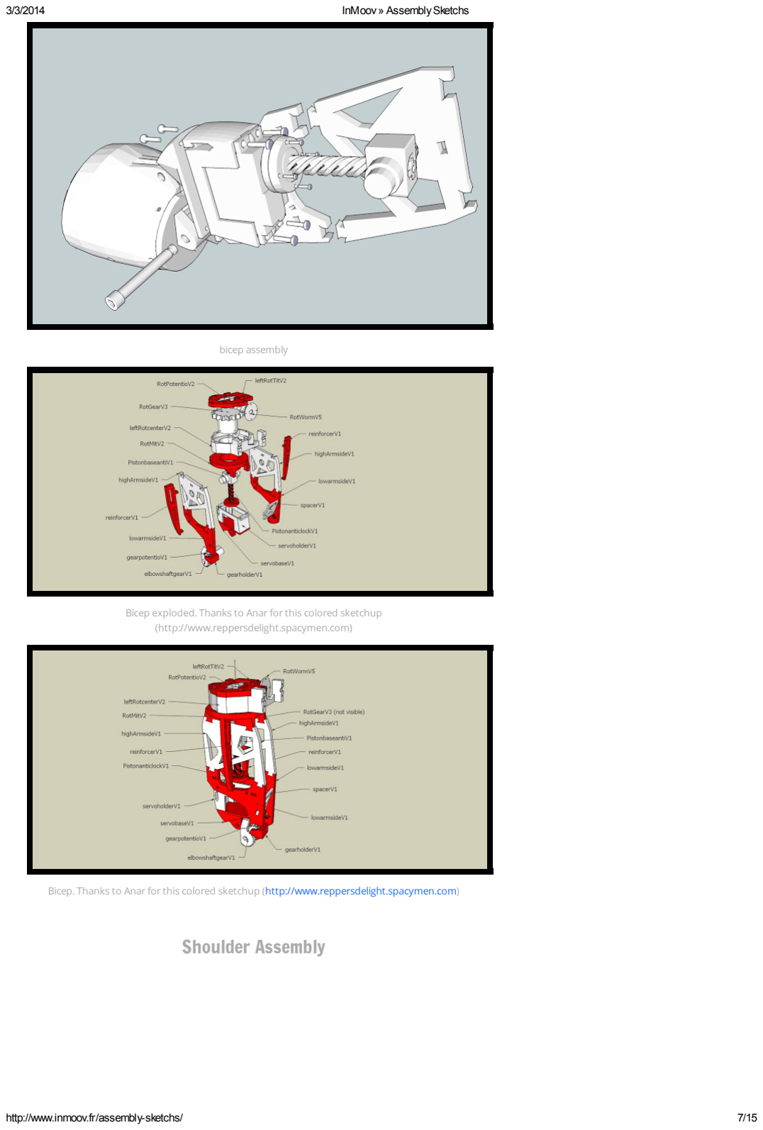
[picture p270: page 7]

bicep assembly

Bicep exploded. Thanks to Anar for this colored sketchup (http://www.reppersdelight.spacymen.com)

Bicep. Thanks to Anar for this colored sketchup (http://www.reppersdelight.spacymen.com)

# Shoulder Assembly

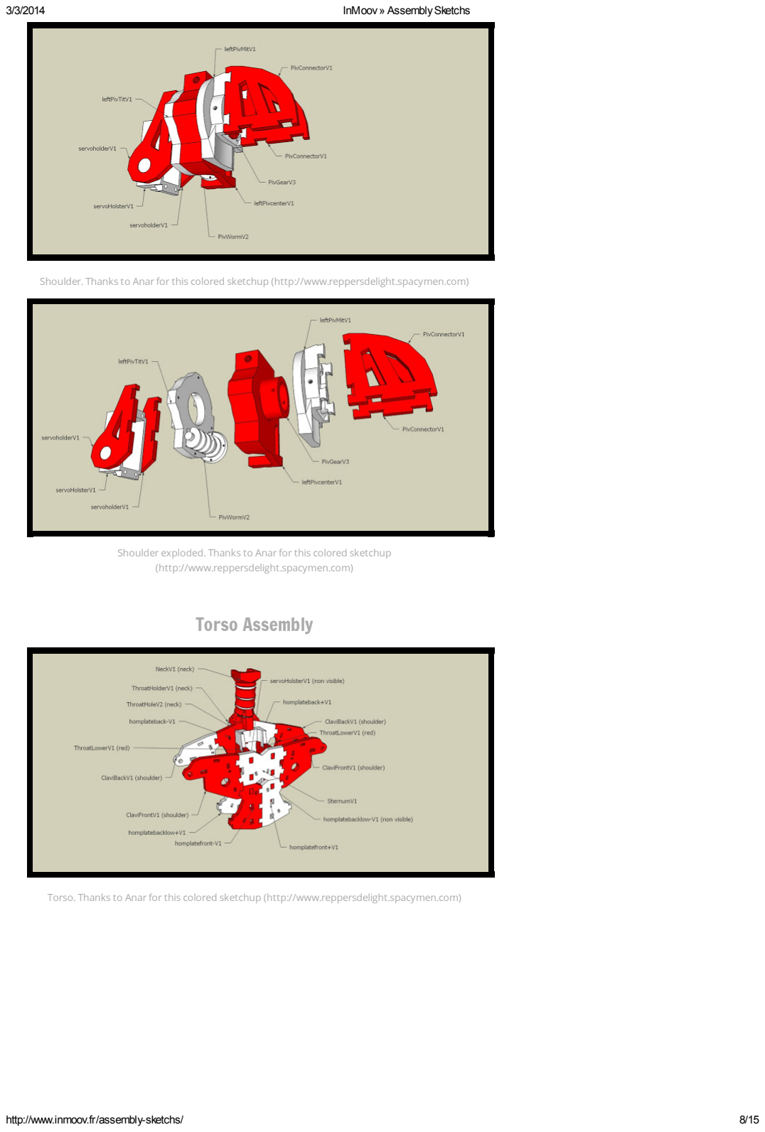
[picture p271: page 8]

Shoulder. Thanks to Anar for this colored sketchup (http://www.reppersdelight.spacymen.com)

Shoulder exploded. Thanks to Anar for this colored sketchup (http://www.reppersdelight.spacymen.com)

# Torso Assembly

Torso. Thanks to Anar for this colored sketchup (http://www.reppersdelight.spacymen.com)

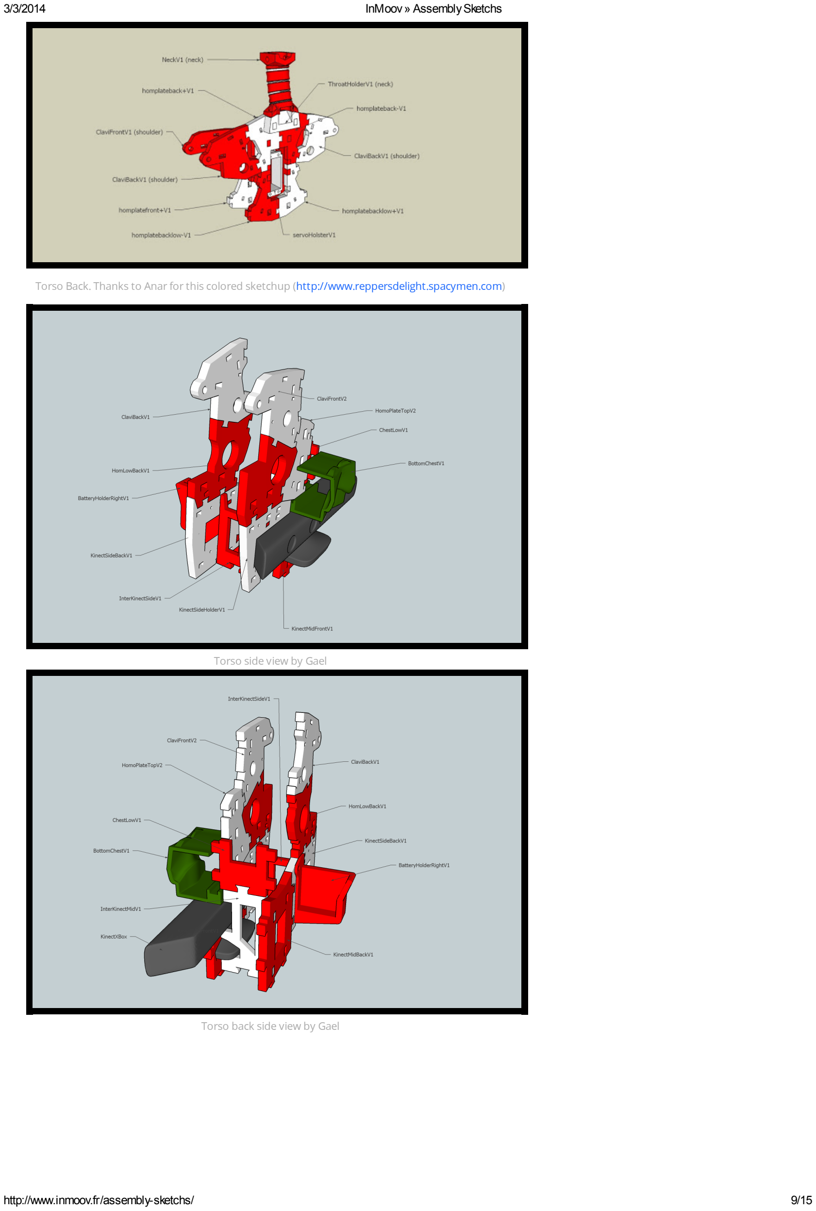
[picture p272: page 9]

Torso Back. Thanks to Anar for this colored sketchup (http://www.reppersdelight.spacymen.com)

Torso side view by Gael

Torso back side view by Gael

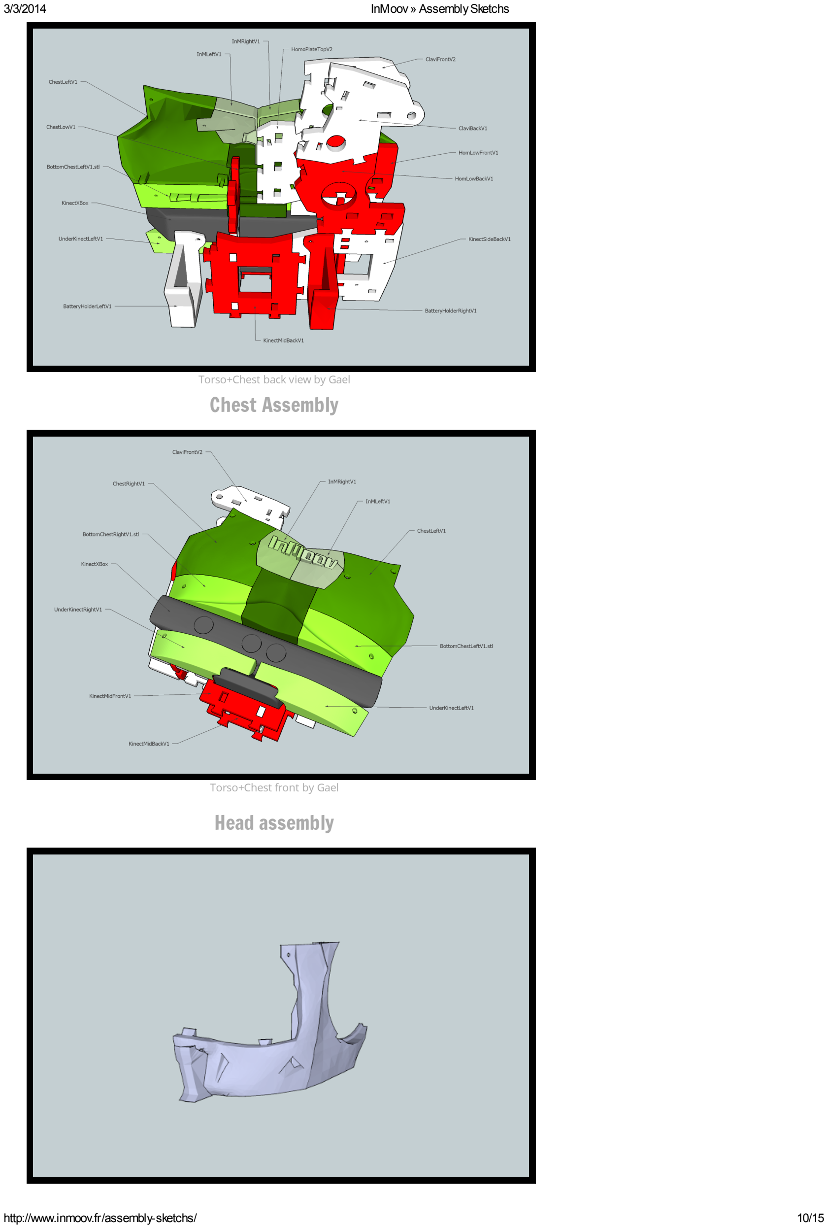
[picture p273: page 10]

Torso+Chest back view by Gael

# Chest Assembly

Torso+Chest front by Gael

# Head assembly

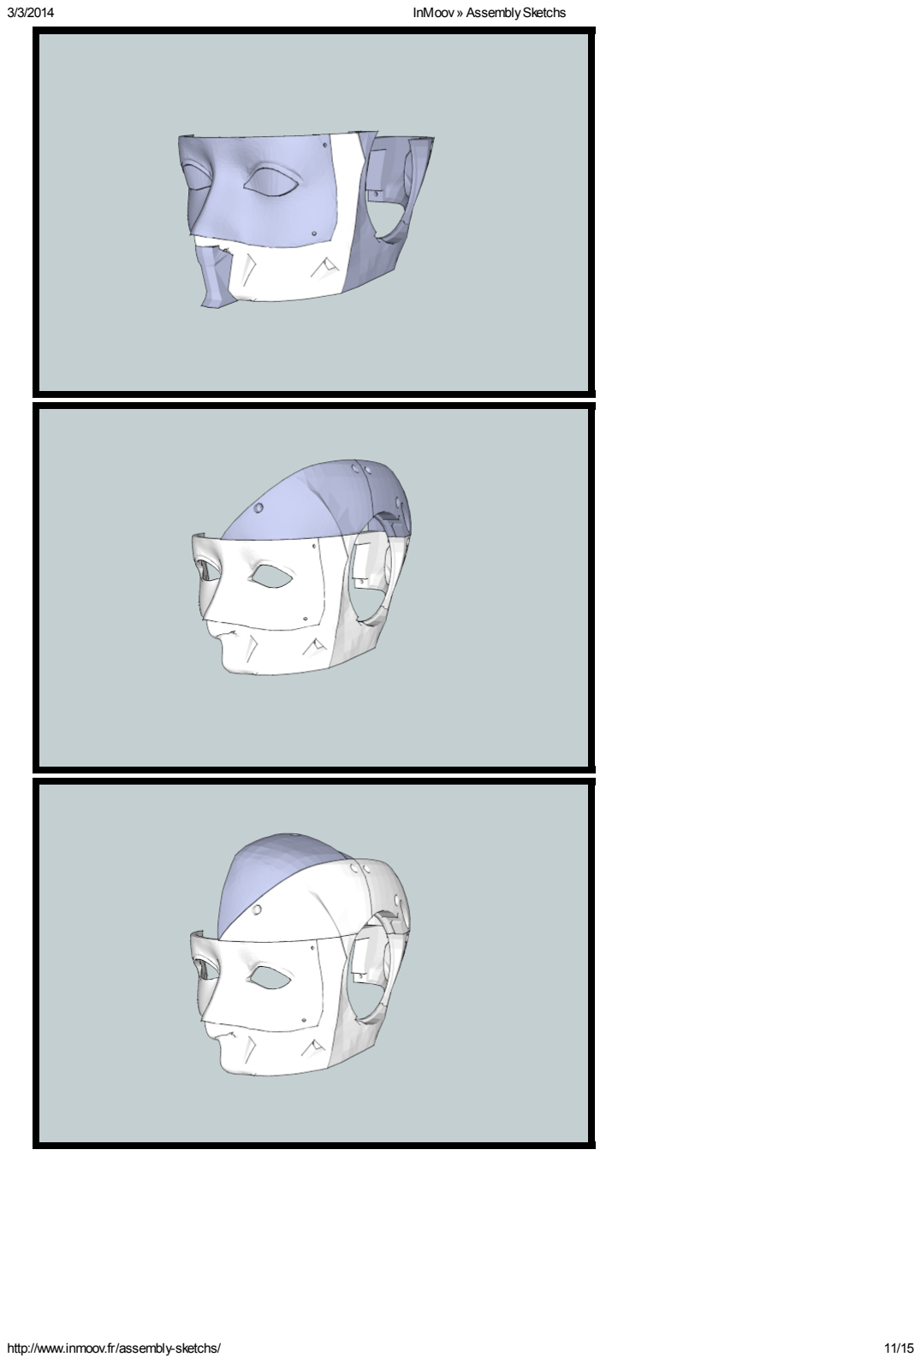
[picture p274: page 11]
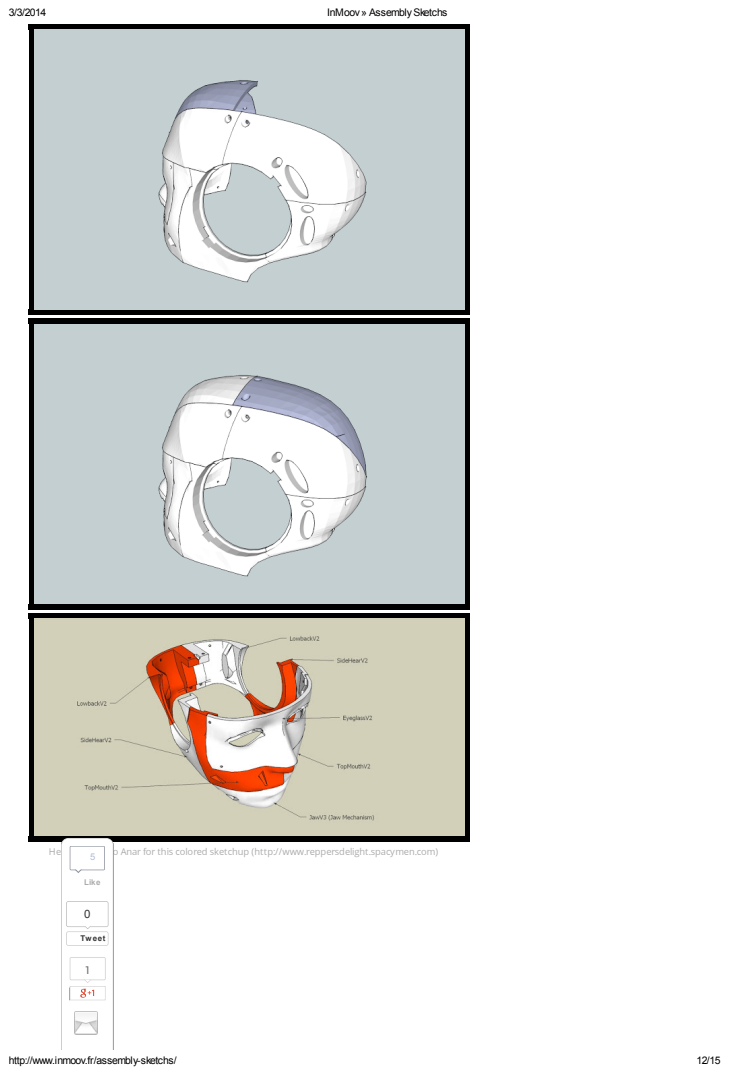
[picture p275: page 12]
Tweet; Like

Head. Thanks to Anar for this colored sketchup (http://www.reppersdelight.spacymen.com)

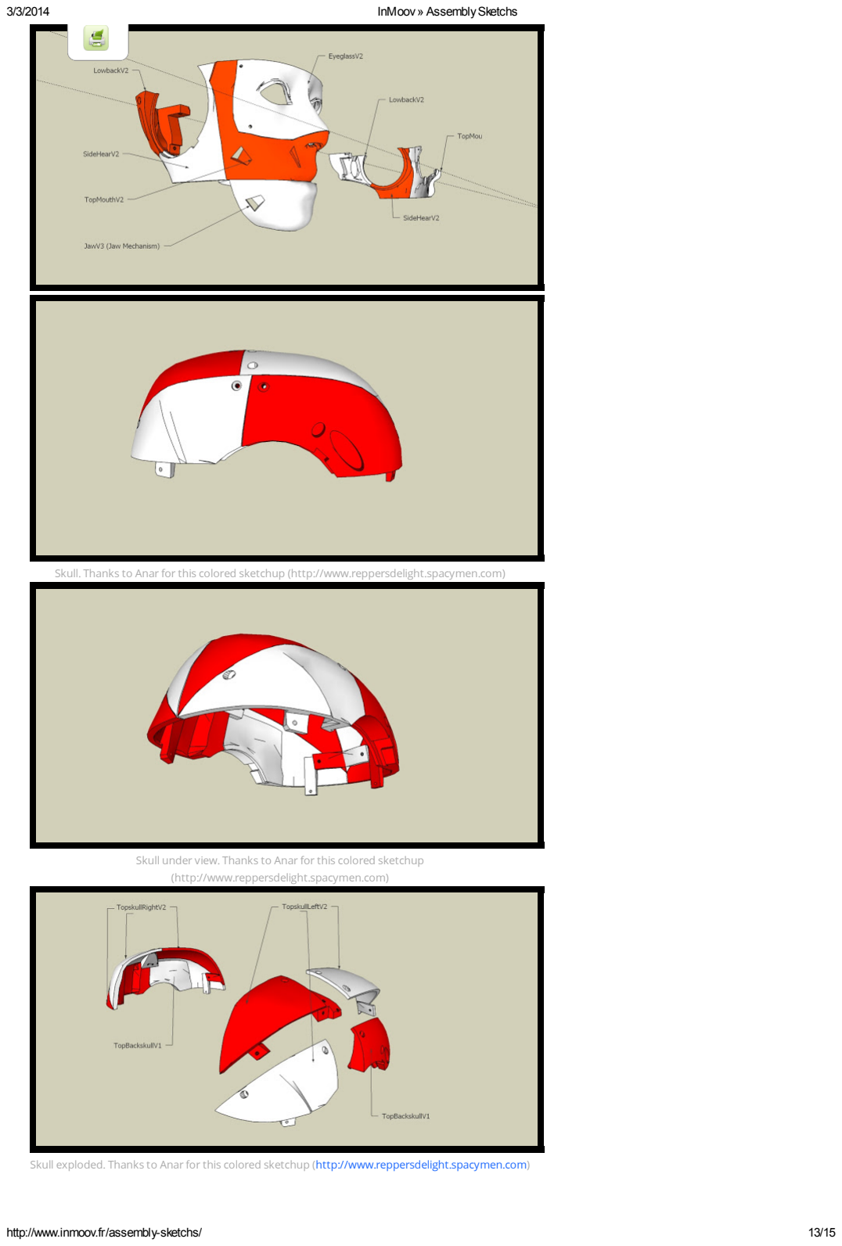
[picture p276: page 13]

Skull. Thanks to Anar for this colored sketchup (http://www.reppersdelight.spacymen.com)

Skull under view. Thanks to Anar for this colored sketchup (http://www.reppersdelight.spacymen.com)

Skull exploded. Thanks to Anar for this colored sketchup (http://www.reppersdelight.spacymen.com)

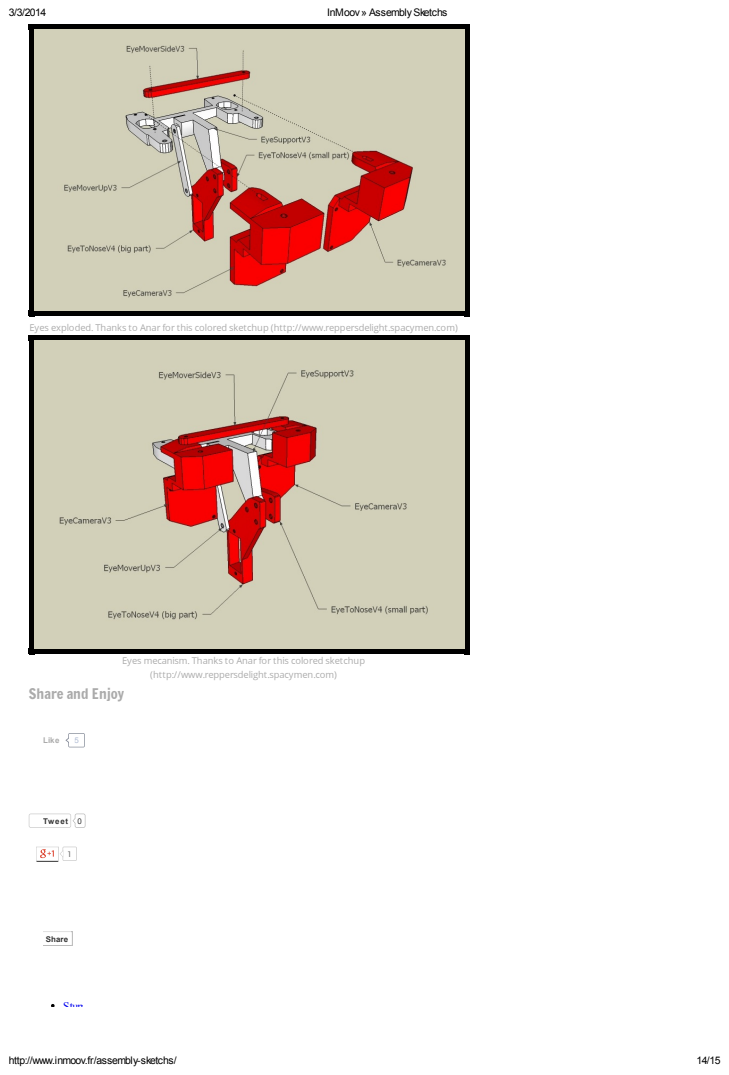
[picture p277: page 14]
Tweet 0; Stum; Like; Share

Eyes exploded. Thanks to Anar for this colored sketchup (http://www.reppersdelight.spacymen.com)

Eyes mecanism. Thanks to Anar for this colored sketchup
(http://www.reppersdelight.spacymen.com)

Share and Enjoy

# Leave a comment

You must be logged in (http://www.inmoov.fr/wp-login.php?redirect_to=http%3A%2F%2Fwww.inmoov.fr%2Fassembly-sketchs%2F) to post a comment.

Copyright © 2014 InMoov (http://www.inmoov.fr/)

Proudly powered by WordPress. (http://wordpress.org/)

BACK TO TOP ↑
