aalonsopuig/Inmoov_ROS2/docs/assembly/Head and Neck/Eye Mechanism.pdf

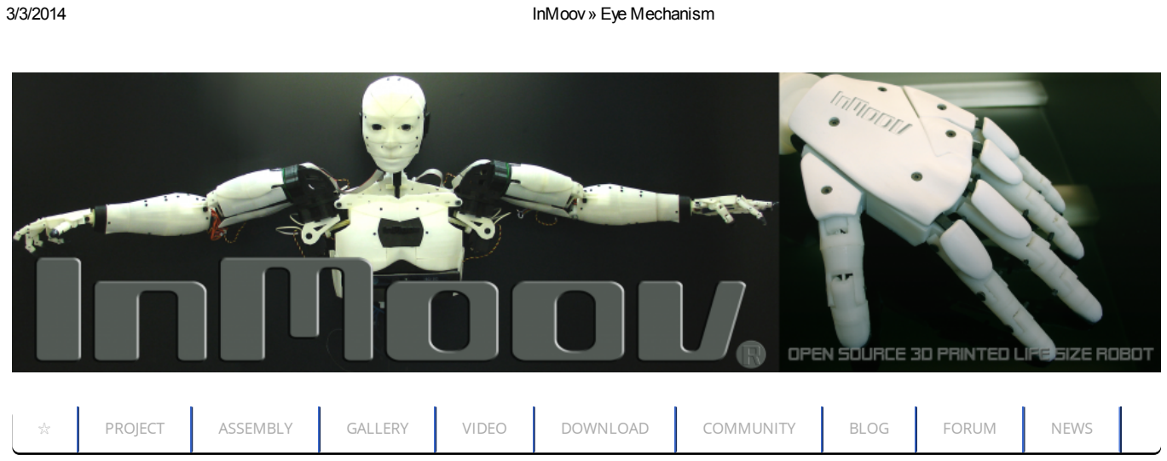
[picture p278: figure]
InMoov» Eye Mechanism; PROJECT; ASSEMBLY; GALLERY; VIDEO; DOWNLOAD; COMMUNITY; BLOG; FORUM; NEWS

http://www.inmoov.fr/eye-mechanism/ | 1/6

# Eye Mechanism

# Eye Mechanism Assembly

I used 3 DS929HV servos from Hobbyking. The two servos mounted for the right/left movement are connected with Y connector, so they receive the same data and act simulteanously.
Some of the pictures (http://twitter.com/search?q=http%3A%2F%2Fwww.inmoov.fr%2Feye-mechanism%2F) in this tuto are showing parts that might be a bit different than the one you actually printed. This (http://twitter.com/search?q=http%3A%2F%2Fwww.inmoov.fr%2Feye-mechanism%2F) is due to different iterations.

Start by screwing the two servos to EyeSupport. In the tuto I have attached only one, but it is best to have two.

Set your servos at 90 degrees using your Arduino. Attache the actuators of your servos in this position.

## HELP ME EXPERIMENT

## SEARCH

search here...

## MEMBER ACTIVITIES

Dwa yne Wi l l i a ms (http://www.inmoov.fr/members/dwilli9013/) upl oa ded a new pi c t ure : openc v_fd_1. j pg (http://www.inmoov.fr/members/dwilli9013/album/picture/46/) 17 hours , 49 mi nut e s a go (http://www.inmoov.fr/activity/p/1213/)

Rob is
standing
proud as a
test bot for
Grog.
He is very
pleased to be a part of
enhancing the Inmoov Nation.

Fred (http://www.inmoov.fr/members/freddyzaz/) upl oa ded a new
pi c t ure : Pos s i bl e spri ng for… (http://www.inmoov.fr/members/freddyzaz/album/picture/45/) 1 da y, 16 hours a go (http://www.inmoov.fr/activity/p/1203/)

Maybe a
possible
spring for
tendons ?

Tweet (https://twitter.com/intent/tweet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)

0 (http://twitter.com/search?q=http%3A%2F%2Fwww.inmoov.fr%2Feye-mechanism%2F)

0 (http://www.inmoov.fr/imm_old/4.bp.blogspot.com/-aUWmvPmD_ls/UYvhhV13xDI/AAAAAAAABfo/_HFu9oBjdY4/s1600/DSC05755.JPG)

2

Like

Mount EyeCamera part and make sure it can rotate freely on the screw.

Mount the second EyeCamera part

Now add and screw the third servo to EyeToNose

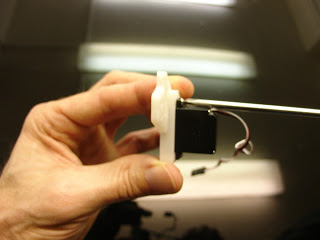
[picture p279: figure]
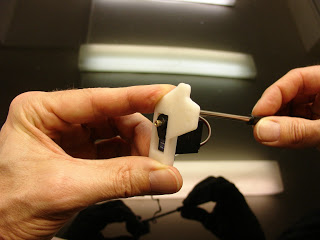
[picture p280: figure]

Your part will look a bit different in length.

J a c k Phi l l i ps pos t ed a n upda t e 2 da ys , 11 hours a go; Head Connect to Torso. Using EZ Robot for programing interface for now. Printing arms and hands next. Not sure how to post video so here is the link. https://www.youtube.com/wat ch? v=czMIEDz9804&feature=c4- overview&list=UUNwIfeOZc- u4UbOx3bcqJHQ; Ga e l La nge vi n pos t ed a n upda t e 2 da ys , 16 hours a go; To Fred and others:; https://groups.google.com/gro up/inmoov/attach/151d3d256 a4108f0/spring%20tensioner1.j pg?part=4&authuser=0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

## FOLLOW ME

## gael langevin (https://plus.google.com/109466702837468444192?prsrc=5)

413 followers

### 1 circle

## RECENT POSTS

InMoov prosthetic hand almost ready (http://www.inmoov.fr/inmoov-prosthetic-hand-almost-ready/) InMoov in Moscow, Geek Picnic (http://www.inmoov.fr/inmoov-in-moscow-geek-picnic/) InMoov on the New Yorker (http://www.inmoov.fr/inmoov-on-the-new-yorker/)
Wow InMoov Santa! (http://www.inmoov.fr/wow-inmoov-santa/)

Be sure to have your servo set at 90 degrees and mount the actuator this way.

Attach EyeToNose to the EyeGlass part

This is a bit difficult because the access with the screw driver isn’t straight.

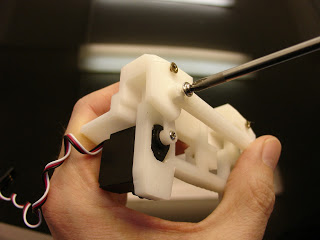
[picture p281: figure]

Now fix EyeMoverSide through EyeCamera to the actuator of the servo

New wiring design for the hand (http://www.inmoov.fr/new-wiring-design-for-the-hand/)

## RECENT COMMENTS

Gael Langevin (http://www.inmoov.fr/) on Hand and Forarm (http://www.inmoov.fr/hand-and-forarm/#comment-482)
Tom on Hand and Forarm (http://www.inmoov.fr/hand-and-forarm/#comment-481)
InMoov » InMoov prosthetic hand almost ready on Default Hardware Map (http://www.inmoov.fr/inmoov-prosthetic-hand-almost-ready/)
Gael Langevin (http://www.inmoov.fr/) on Hand and Forarm (http://www.inmoov.fr/hand-and-forarm/#comment-479)
Tom on Hand and Forarm (http://www.inmoov.fr/hand-and-forarm/#comment-478)

## ARCHIVES

March 2014 (http://www.inmoov.fr/2014/03/)
February 2014 (http://www.inmoov.fr/2014/02/)
January 2014 (http://www.inmoov.fr/2014/01/)
December 2013 (http://www.inmoov.fr/2013/12/)
November 2013 (http://www.inmoov.fr/2013/11/)
October 2013 (http://www.inmoov.fr/2013/10/)
September 2013 (http://www.inmoov.fr/2013/09/)
August 2013 (http://www.inmoov.fr/2013/08/)
July 2013 (http://www.inmoov.fr/2013/07/)
May 2013 (http://www.inmoov.fr/2013/05/)
April 2013 (http://www.inmoov.fr/2013/04/)
March 2013 (http://www.inmoov.fr/2013/03/)
February 2013 (http://www.inmoov.fr/2013/02/)
January 2013 (http://www.inmoov.fr/2013/01/)
December 2012 (http://www.inmoov.fr/2012/12/)
November 2012 (http://www.inmoov.fr/2012/11/)
October 2012 (http://www.inmoov.fr/2012/10/)
September 2012 (http://www.inmoov.fr/2012/09/)
August 2012 (http://www.inmoov.fr/2012/08/)
July 2012 (http://www.inmoov.fr/2012/07/)
June 2012 (http://www.inmoov.fr/2012/06/)
May 2012 (http://www.inmoov.fr/2012/05/)

## CATEGORIES

Select Category


Repeat this on bothe eyes.

Mount EyeMoverUp, it should NOT be tight screwed


Fix this assembly to EyeToNose, going through the eye space is an option to make it easier.

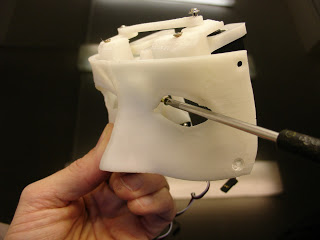
[picture p282: figure]

Fix the EyeMoverUp to the bottom servo actuator.
Normaly your mechanism should be ready for movements.
Making test with your Arduino is a good thing at this point. Be sure to start with small range degree movements, especially for the up and down movement. You can start with 30 to 120, it should be fine.
What follows is what I did to make the cameras look more like eyes.

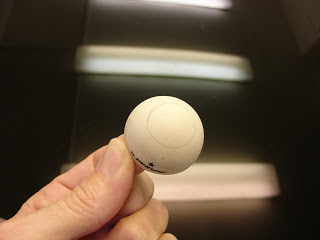
[picture p283: figure]

I used a ping pong ball cutted with a knife and small scissors.
The hole where you insert the lens can be rounded up with sand paper, because cutting a clean hole with a knife isn’t easy.

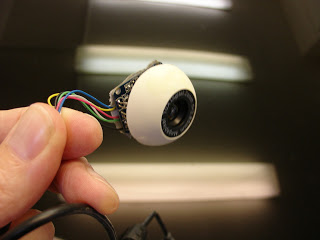
[picture p284: figure]

Adjust the hole precisely to your lens and PCB board

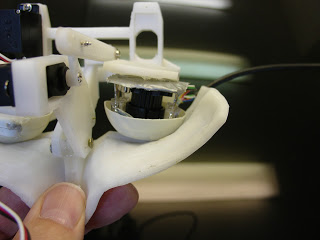
[picture p285: figure]

I used a piece of heavy tape to cover the back of the PCB, for two reasons:
First to avoid using hot glue directly on the components and also to shutter the back of the lens to keep it dark (Oddly light coming from the back of the lens interfer with the image received by the camera.)

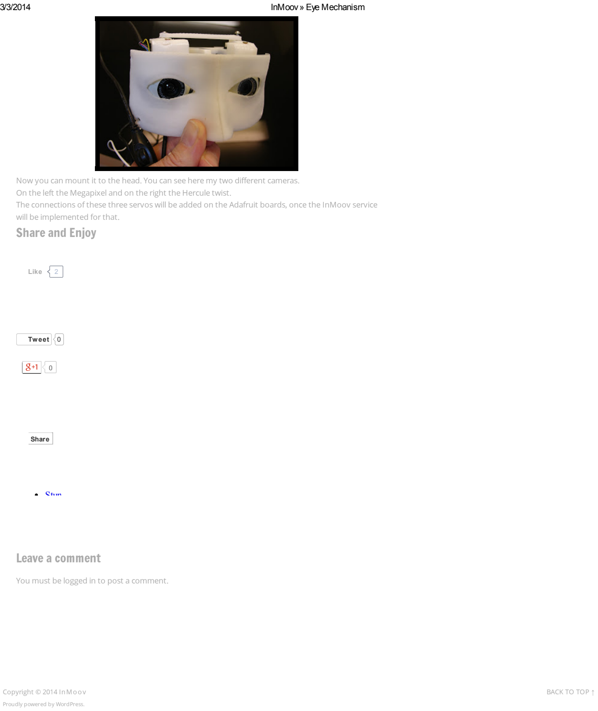
[picture p286: figure]
Tweet 0; Stum; will be implemented for that. Share and Enjoy; Leave a comment; Copyright © 2014 InMoov; Proudly powered by WordPress.; BACK TO TOP ↑; Like; Share

Now you can mount it to the head. You can see here my two different cameras.
On the left the Megapixel and on the right the Hercule twist.
The connections of these three servos will be added on the Adafruit boards, once the InMoov service

You must be logged in (http://www.inmoov.fr/wp-login.php?redirect_to=http%3A%2F%2Fwww.inmoov.fr%2Feye-mechanism%2F) to post a comment.
