aalonsopuig/Inmoov_ROS2/docs/assembly/Head and Neck/Neck and Jaw.pdf

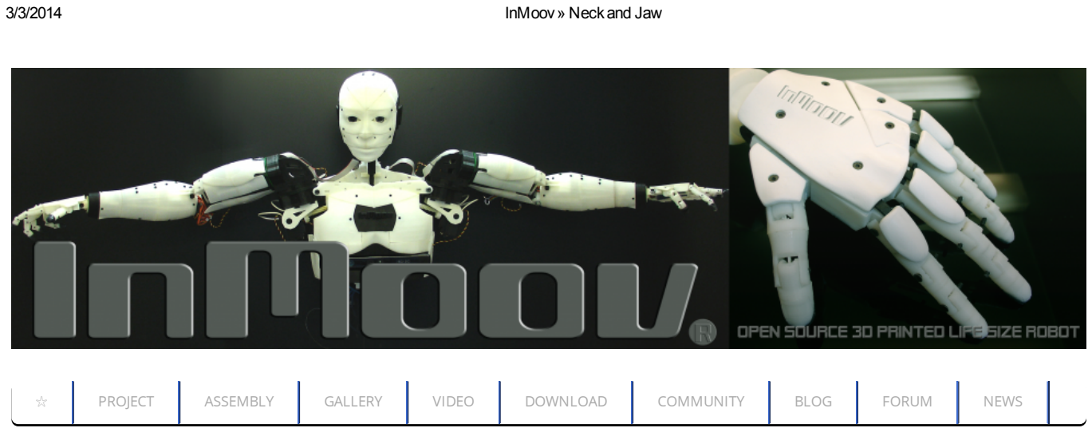
[picture p287: figure]
InMoov» Neckand Jaw; PROJECT; ASSEMBLY; GALLERY; VIDEO; DOWNLOAD; COMMUNITY; BLOG; FORUM; NEWS
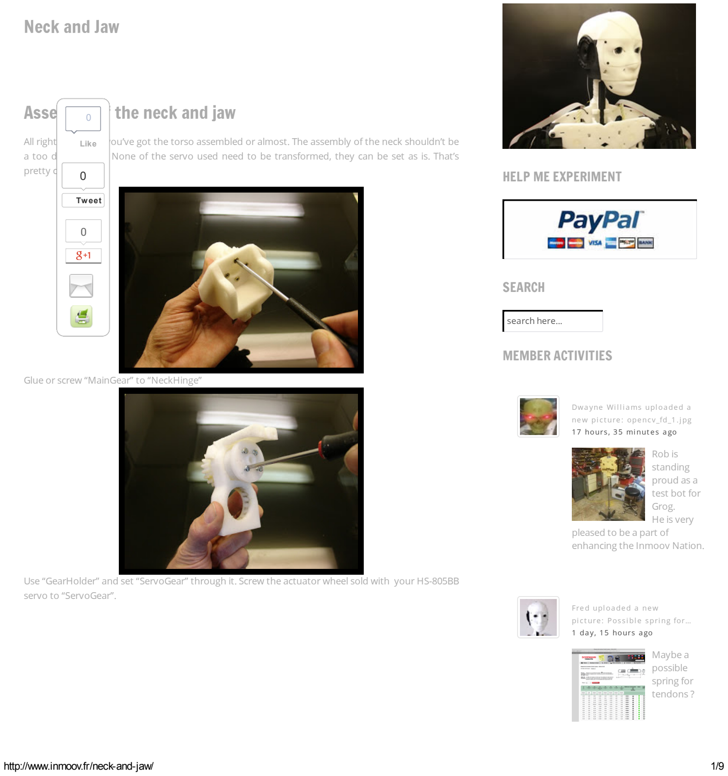
[picture p288: figure]
http://www.inmoov.fr/neck-and-jaw/; Neck and Jaw; Assembly of the neck and jaw; pretty cool.; Glue or screw “MainGear” to “NeckHinge”; servo to “ServoGear”.; HELP ME EXPERIMENT; SEARCH; search here...; MEMBER ACTIVITIES; Dwa yne Wi l l i a ms upl oa ded a new pi c t ure : openc v_fd_1. j pg 17 hours , 35 mi nut e s a go; Rob is standing proud as a test bot for Grog. He is very pleased to be a part of enhancing the Inmoov Nation.; Fred upl oa ded a new pi c t ure : Pos s i bl e spri ng for… 1 da y, 15 hours a go; Maybe a possible spring for tendons ?; Tweet; Like

All right I presume you’ve got the torso assembled or almost. The assembly of the neck shouldn’t be a too difficult step. None of the servo used need to be transformed, they can be set as is. That’s

Use “GearHolder” and set “ServoGear” through it. Screw the actuator wheel sold with your HS-805BB

Use your Arduino board and set your HS-805BB servo to 90°. Puch it in the turntable.

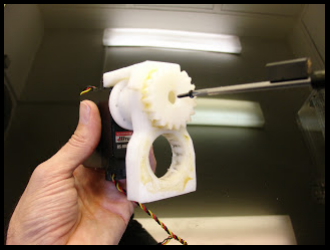
[picture p289: figure]

This a bit tricky but can be achieved using a magnet on your screwdriver. Using the screw delivered with the servo, you need to screw the turntable to the servo inside “ServoGear”. Keep your servo at 90°.


Mount this assembly to the assembly “MainGear” and “NeckHinge”using some grease to ease the rotation. “GearHolder” should be aligned with “NeckHinge” and your servo should be still at 90°.


Fix the “LowBackRight” and “LowBackLeft” or “Temporary” to “GearHolder”.This will be the back of the skull.

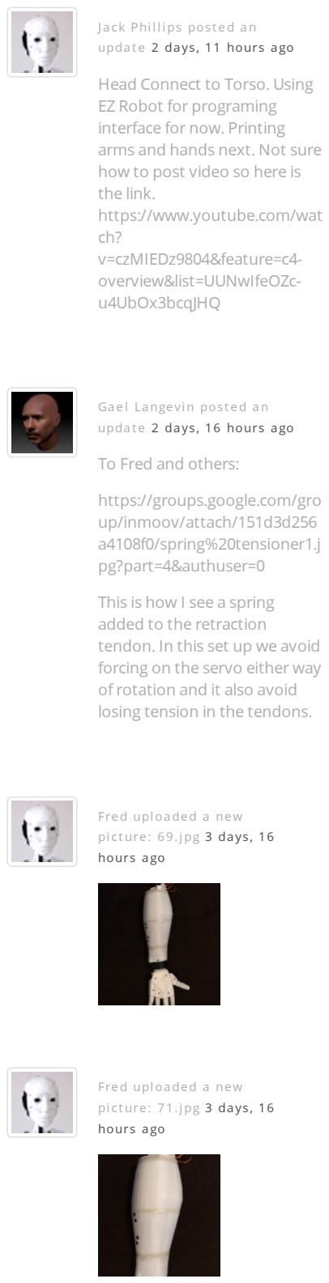
[picture p290: figure]
J a c k Phi l l i ps pos t ed a n upda t e 2 da ys , 11 hours a go; Head Connect to Torso. Using EZ Robot for programing interface for now. Printing arms and hands next. Not sure how to post video so here is the link. https://www.youtube.com/wat ch? v=czMIEDz9804&feature=c4- overview&list=UUNwIfeOZc- u4UbOx3bcqJHQ; Ga e l La nge vi n pos t ed a n upda t e 2 da ys , 16 hours a go; To Fred and others:; https://groups.google.com/gro up/inmoov/attach/151d3d256 a4108f0/spring%20tensioner1.j pg?part=4&authuser=0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

## FOLLOW ME

## gael langevin (https://plus.google.com/109466702837468444192?prsrc=5)

413 followers

### 1 circle

## RECENT POSTS

InMoov prosthetic hand almost ready (http://www.inmoov.fr/inmoov-prosthetic-hand-almost-ready/) InMoov in Moscow, Geek Picnic (http://www.inmoov.fr/inmoov-in-moscow-geek-picnic/) InMoov on the New Yorker (http://www.inmoov.fr/inmoov-on-the-new-yorker/)
Wow InMoov Santa! (http://www.inmoov.fr/wow-inmoov-santa/)

Screw “Ring” to “MainGear”. Try to avoid slack between parts.

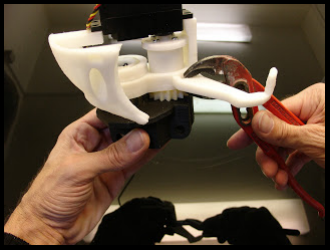
[picture p291: figure]

Use your favoriet pliers to mount “FaceHolder”. You can mount both of them.

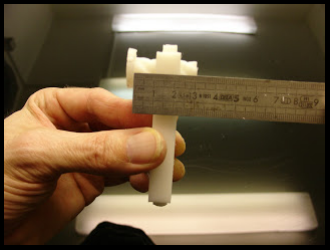
[picture p292: figure]

Now lets build the jaw. Take “JawPiston” and turn it inside “JawHinge” until you get 1cm offset between them.


Mount screw this on the turntable of your HK15298 or similar servo. Set your servo at 0° with the arduino board. Keeping the 1cm offset, “JawHinge” should be mounted at a 90° angle compared to the servo.

New wiring design for the hand (http://www.inmoov.fr/new-wiring-design-for-the-hand/)

## RECENT COMMENTS

Gael Langevin (http://www.inmoov.fr/) on Hand and Forarm (http://www.inmoov.fr/hand-and-forarm/#comment-482)
Tom on Hand and Forarm (http://www.inmoov.fr/hand-and-forarm/#comment-481)
InMoov » InMoov prosthetic hand almost ready on Default Hardware Map (http://www.inmoov.fr/inmoov-prosthetic-hand-almost-ready/)
Gael Langevin (http://www.inmoov.fr/) on Hand and Forarm (http://www.inmoov.fr/hand-and-forarm/#comment-479)
Tom on Hand and Forarm (http://www.inmoov.fr/hand-and-forarm/#comment-478)

## ARCHIVES

March 2014 (http://www.inmoov.fr/2014/03/)
February 2014 (http://www.inmoov.fr/2014/02/)
January 2014 (http://www.inmoov.fr/2014/01/)
December 2013 (http://www.inmoov.fr/2013/12/)
November 2013 (http://www.inmoov.fr/2013/11/)
October 2013 (http://www.inmoov.fr/2013/10/)
September 2013 (http://www.inmoov.fr/2013/09/)
August 2013 (http://www.inmoov.fr/2013/08/)
July 2013 (http://www.inmoov.fr/2013/07/)
May 2013 (http://www.inmoov.fr/2013/05/)
April 2013 (http://www.inmoov.fr/2013/04/)
March 2013 (http://www.inmoov.fr/2013/03/)
February 2013 (http://www.inmoov.fr/2013/02/)
January 2013 (http://www.inmoov.fr/2013/01/)
December 2012 (http://www.inmoov.fr/2012/12/)
November 2012 (http://www.inmoov.fr/2012/11/)
October 2012 (http://www.inmoov.fr/2012/10/)
September 2012 (http://www.inmoov.fr/2012/09/)
August 2012 (http://www.inmoov.fr/2012/08/)
July 2012 (http://www.inmoov.fr/2012/07/)
June 2012 (http://www.inmoov.fr/2012/06/)
May 2012 (http://www.inmoov.fr/2012/05/)

## CATEGORIES

Select Category


Mount screw “SkullServoFix” over the HS-805BB servo.

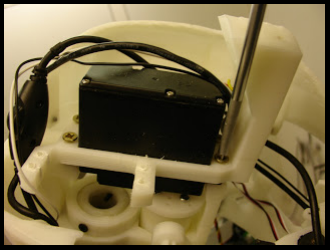
[picture p293: figure]

Put all 4 screws. Don’t mind the wires on my pictures they come from cameras.


Glue with acetonethe two “JawHolders” on both sides of whole assembly. It comes/fit on the “FaceHolders”

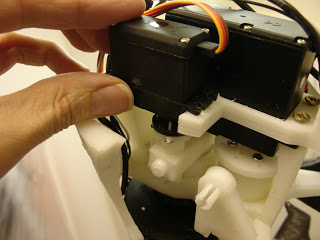
[picture p294: figure]

Now take your HK15298 assembly and slide it through.

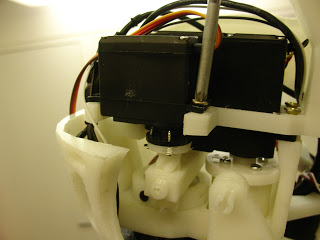
[picture p295: figure]

Put all 4 screws to fix your HK15298 servo.

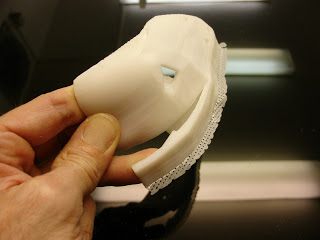
[picture p296: figure]

Remove the pre-support from “Jaw”. My “Jaw” shown on this picture is only a half part. It was a previous test print I did. Your “Jaw” is one piece print.


Screw “Jawsupport” to “Jaw”. Make sure the flat surfaces of the “Jawsupport” are on the inside.

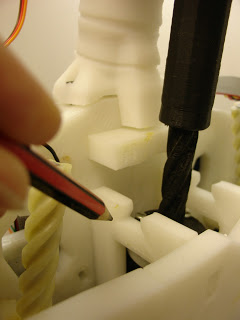
[picture p297: figure]

Fix in “ThroatHole”. Mine looks different than yours. Sorry for this picture but “ThroatPiston” and “ThroatPistonBase” shouldn’t be already mounted, it comes in the next steps.

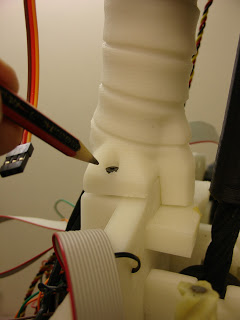
[picture p298: figure]

Screw “Neck” to “ThroatHole”.

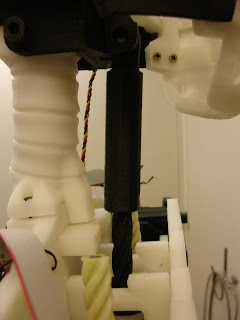
[picture p299: figure]

Fix “NeckHinge” to “Neck” with a 8mm bolt (or print one from the hand)
Assuming you have already fixed your HS-805BB servo in the Torso assembly. Set your servo at 90° with arduino board. Turn “ThroatPiston” and “ThroatPistonBase” in a matter to get “NeckHinge” straight flat.

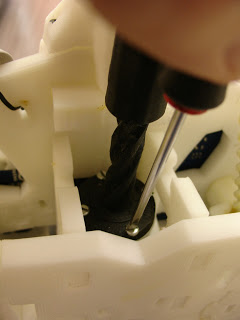
[picture p300: figure]

Screw “ThroatPiston” to its turntable keeping your servo at 90°.

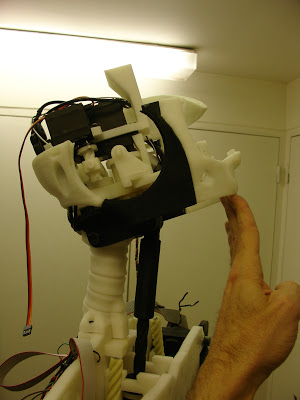
[picture p301: figure]

Fix “ThroatPistonBase” to “NeckHinge” with a 8mm bolt (or print one from the hand)
Now the whole head should be able to go up and down if the servo turns from 0 to 180. Make a test with the arduino. Run this test carefully.

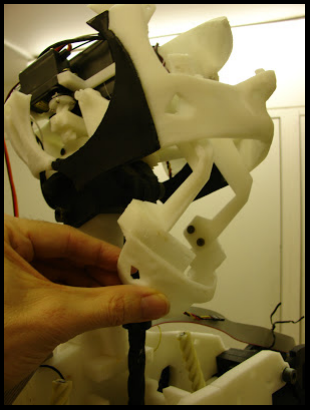
[picture p302: figure]

Leaving the head up, Slide the jaw assembly in to the head.

Bring the “JawSupports” through and mount them to the “JawHinges” and “JawHolders”

Using washers, set screws in.
Run a test on the jaw mechanism with Arduino.
ATTENTION: the jaw servo can only turn from 0 to 20° (I think) if more it might break something. Please Run your own test to check. (At the moment I write this I don’t remember exactly to how much mine could go. When I will plug it again I will rectify this)
You can run the cables of your servos in the “Neck”.
Now you should be set to move the head and the jaw through your Arduino.
Check InMoov service Myrobotlab (http://myrobotlab.org/service/inmoov) for to get this added to your robot. Jaw is not yet implemented in InMoov service at this date 08/03/2013.

# Share and Enjoy

Like 0

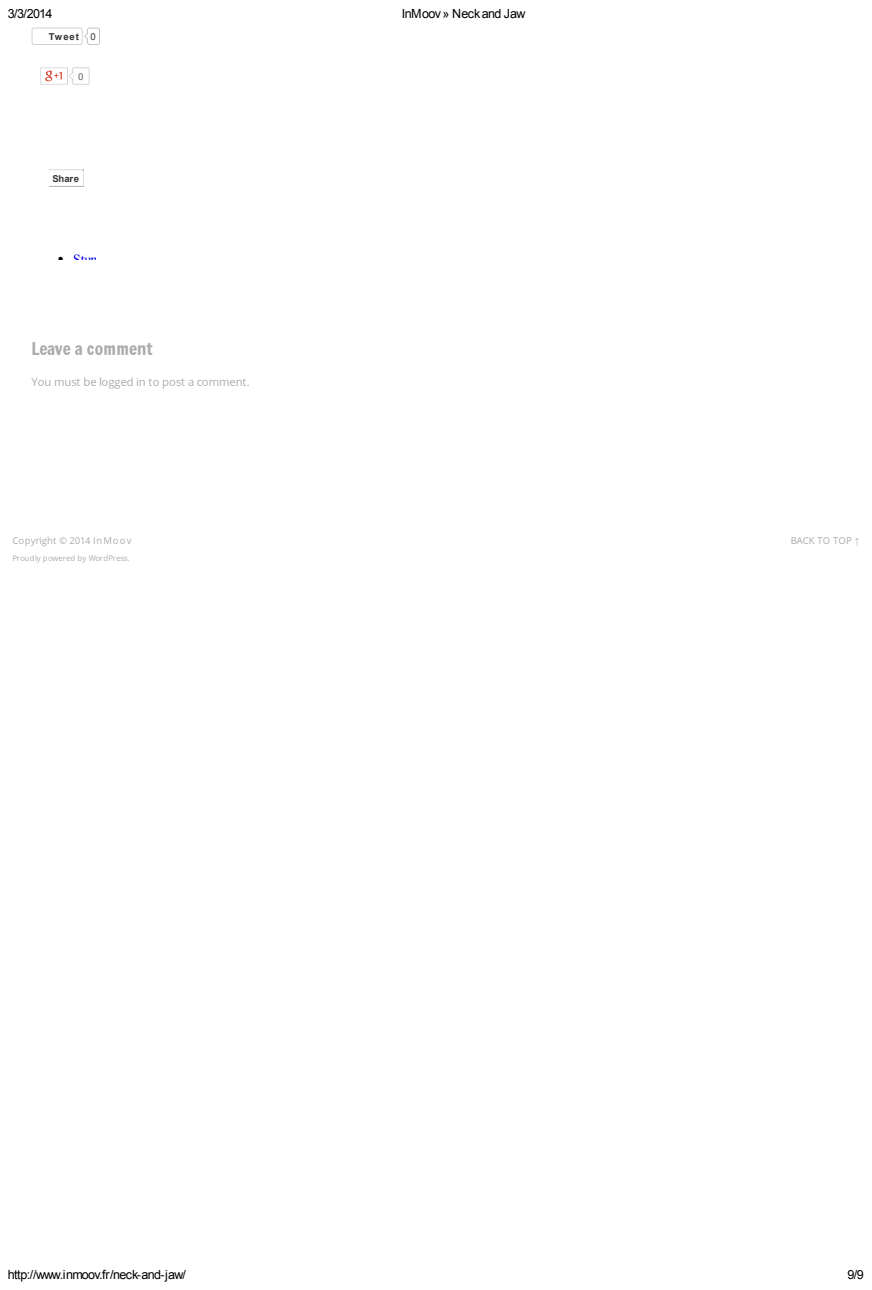
[picture p303: page 9]
Tweet 0; Stum; Leave a comment; Copyright © 2014 InMoov; Share

You must be logged in (http://www.inmoov.fr/wp-login.php?redirect_to=http%3A%2F%2Fwww.inmoov.fr%2Fneck-and-jaw%2F) to post a comment.

BACK TO TOP ↑

Proudly powered by WordPress. (http://wordpress.org/)
