aalonsopuig/Inmoov_ROS2/docs/assembly/Arms/Bicep/Bicep.pdf

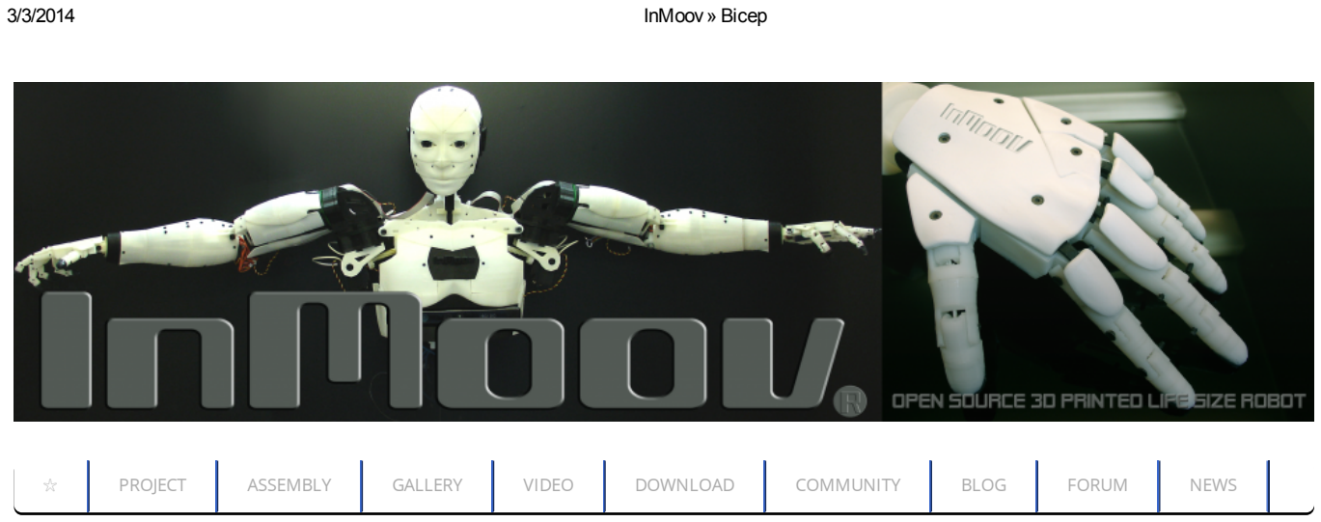
[picture p310: figure]
InMoov» Bicep; PROJECT; ASSEMBLY; GALLERY; VIDEO; DOWNLOAD; COMMUNITY; BLOG; FORUM; NEWS

http://www.inmoov.fr/bicep/ | 1/10

# Bicep

# Building the bicep of InMoov

I have tried to make this as simple as I could, and I hope you will find answers to your questions here. Once you have printed the parts you can start the job. On these pictures I was assembling the left arm so take that in consideration if you are building the right arm.

STEP1:

What we want to do in this first tuto is to extract the potentiometer of the 2 servos and adding by welding, extra cable length:

We will start by opening the Hitec HS-805BB servo by unscrewing all the screws at the bottom. It comes apart in three parts. Make sure to work in a clean place, you don’t want to lose anything and spoil the grease it contains. Once the top is removed, note or take a picture of each gears placement, check well there are two looking almost alike (shown on picture).

Remove the bearing and it’s rings(note the order). It can be a little hard to remove it, I used a small screw driver placed under the bearing.

## HELP ME EXPERIMENT

## SEARCH

search here...

## MEMBER ACTIVITIES

Dwa yne Wi l l i a ms (http://www.inmoov.fr/members/dwilli9013/) upl oa ded a new pi c t ure : openc v_fd_1. j pg (http://www.inmoov.fr/members/dwilli9013/album/picture/46/) 17 hours , 58 mi nut e s a go (http://www.inmoov.fr/activity/p/1213/)

Rob is
standing
proud as a
test bot for
Grog.
He is very
pleased to be a part of
enhancing the Inmoov Nation.

Fred (http://www.inmoov.fr/members/freddyzaz/) upl oa ded a new
pi c t ure : Pos s i bl e spri ng for… (http://www.inmoov.fr/members/freddyzaz/album/picture/45/) 1 da y, 16 hours a go (http://www.inmoov.fr/activity/p/1203/)

Maybe a
possible
spring for
tendons ?

Now we want to remove the pcb card and it’s motor, on some servos it just came easy, but there is a bit of glue around the motor, so you can push the motor down by pressing the little metal gear placed at the tip of my screw driver.

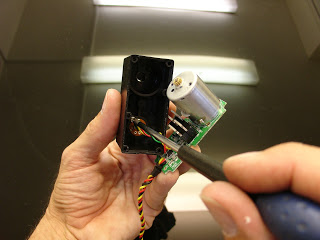
[picture p311: figure]

Aaah, it came out, unscrew the potentiometer, for to release it out see next picture.

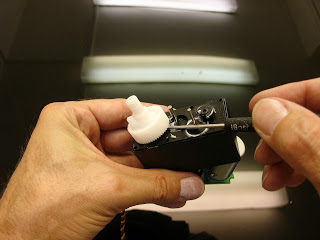
[picture p312: figure]

help yourself again with your small screwdriver placed under the big gear.

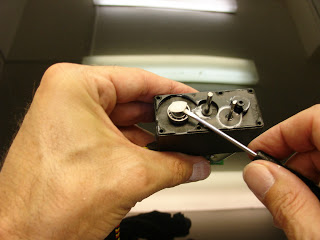
[picture p313: figure]

Remove the plastic washer(we won’t need it anymore, but keep it you never know…)

J a c k Phi l l i ps pos t ed a n upda t e 2 da ys , 11 hours a go; Head Connect to Torso. Using EZ Robot for programing interface for now. Printing arms and hands next. Not sure how to post video so here is the link. https://www.youtube.com/wat ch? v=czMIEDz9804&feature=c4- overview&list=UUNwIfeOZc- u4UbOx3bcqJHQ; Ga e l La nge vi n pos t ed a n upda t e 2 da ys , 16 hours a go; To Fred and others:; https://groups.google.com/gro up/inmoov/attach/151d3d256 a4108f0/spring%20tensioner1.j pg?part=4&authuser=0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

## FOLLOW ME

## gael langevin (https://plus.google.com/109466702837468444192?prsrc=5)

413 followers

### 1 circle

## RECENT POSTS

InMoov prosthetic hand almost ready (http://www.inmoov.fr/inmoov-prosthetic-hand-almost-ready/) InMoov in Moscow, Geek Picnic (http://www.inmoov.fr/inmoov-in-moscow-geek-picnic/) InMoov on the New Yorker (http://www.inmoov.fr/inmoov-on-the-new-yorker/)
Wow InMoov Santa! (http://www.inmoov.fr/wow-inmoov-santa/)

This is a bit tough, cut the “stopper” with a knife or pliers, BUT DON’T DAMAGE THE GEAR.

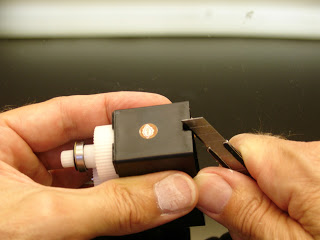
[picture p314: figure]

Remount all the gears back in there original place. Arrange with your knife a bigger opening for the extra length cables. When unwelding the cables from the board and the potentiometer note the colors. (I didn’t with my first servo, answered the phone for ten minutes and when I went back for welding I couldn’ remember the colors… Caused to damage the servo permanently, 30euros in the trash, Aaargh)

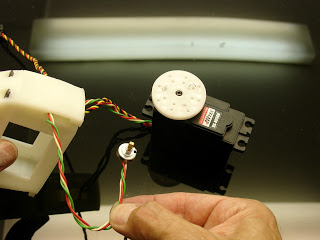
[picture p315: figure]

Before welding the potentiometer of the low part of bicep, run your cables in the gap of “servoholderV1″.

For the low part servo of the bicep, your cables should be welded in the same color order as when you opened the servo. Your cables should be about 25/30 cm long. Now we are set for to assemble the parts.

STEP2:

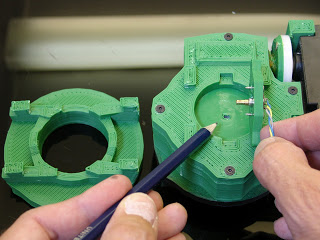
[picture p316: figure]

This picture is to show you what is the angle position of “rotgearV1″ compared to “rotmitV1″. Check

New wiring design for the hand (http://www.inmoov.fr/new-wiring-design-for-the-hand/)

## RECENT COMMENTS

Gael Langevin (http://www.inmoov.fr/) on Hand and Forarm (http://www.inmoov.fr/hand-and-forarm/#comment-482)
Tom on Hand and Forarm (http://www.inmoov.fr/hand-and-forarm/#comment-481)
InMoov » InMoov prosthetic hand almost ready on Default Hardware Map (http://www.inmoov.fr/inmoov-prosthetic-hand-almost-ready/)
Gael Langevin (http://www.inmoov.fr/) on Hand and Forarm (http://www.inmoov.fr/hand-and-forarm/#comment-479)
Tom on Hand and Forarm (http://www.inmoov.fr/hand-and-forarm/#comment-478)

## ARCHIVES

March 2014 (http://www.inmoov.fr/2014/03/)
February 2014 (http://www.inmoov.fr/2014/02/)
January 2014 (http://www.inmoov.fr/2014/01/)
December 2013 (http://www.inmoov.fr/2013/12/)
November 2013 (http://www.inmoov.fr/2013/11/)
October 2013 (http://www.inmoov.fr/2013/10/)
September 2013 (http://www.inmoov.fr/2013/09/)
August 2013 (http://www.inmoov.fr/2013/08/)
July 2013 (http://www.inmoov.fr/2013/07/)
May 2013 (http://www.inmoov.fr/2013/05/)
April 2013 (http://www.inmoov.fr/2013/04/)
March 2013 (http://www.inmoov.fr/2013/03/)
February 2013 (http://www.inmoov.fr/2013/02/)
January 2013 (http://www.inmoov.fr/2013/01/)
December 2012 (http://www.inmoov.fr/2012/12/)
November 2012 (http://www.inmoov.fr/2012/11/)
October 2012 (http://www.inmoov.fr/2012/10/)
September 2012 (http://www.inmoov.fr/2012/09/)
August 2012 (http://www.inmoov.fr/2012/08/)
July 2012 (http://www.inmoov.fr/2012/07/)
June 2012 (http://www.inmoov.fr/2012/06/)
May 2012 (http://www.inmoov.fr/2012/05/)

## CATEGORIES

Select Category the little rectangle hole.

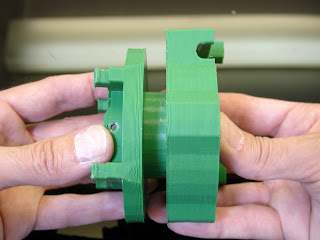
[picture p317: figure]

So keeping the same rotation angle, mount “rotmitV1″ to “rotgearV1″. (Don’t refer to this picture for the angle, parts you’ve downloaded aren’t the same anymore)

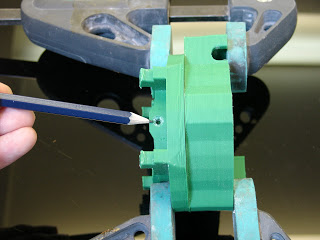
[picture p318: figure]

I used clamps to make sure there wouldn’t backlash between all three parts during screwing them. Make sure your screws don’t come out behind, or recut them. (Don’t refer to this picture for the angle, parts you’ve downloaded aren’t the same anymore)

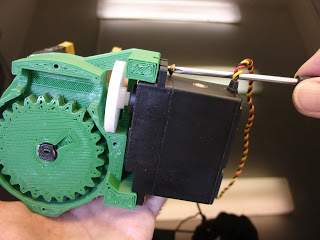
[picture p319: figure]

Attach one servo to “rotcenterV1″. For to do so: mount but don’t tight fit the white actuator wheel.

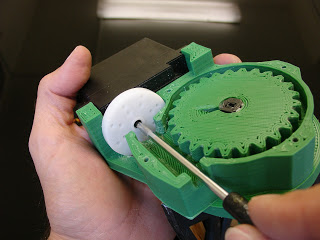
[picture p320: figure]

Once the servo is attached, you can tight the screw.

Mount “rotwormV4″ to the actuator with 4 little screws, make sure they don’t come out behind the actuator, otherwise you have to cut them. Mount “rotgearV2″ to “rotcenterV2″, it should turn easily but with no backlash. I made it operate a few turns by plugging the servo on the Arduino. Then I cleaned up the dust created by the parts. Before closing the case with “rotTitV1″, use a good amount of grease, every where on the gears.

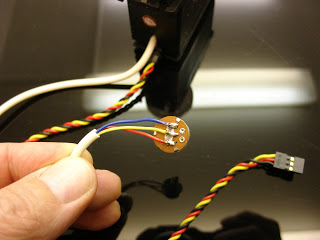
[picture p321: figure]

If you are building the left ROTATE arm, your cables should be welded in the same color order as when you opened the servo.

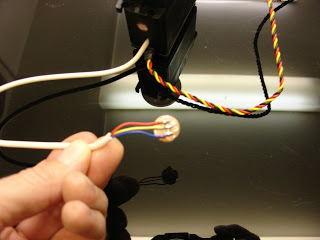
[picture p322: figure]

If you are building the right ROTATE arm, your cables should be welded in the opposite color order as when you opened the servo.

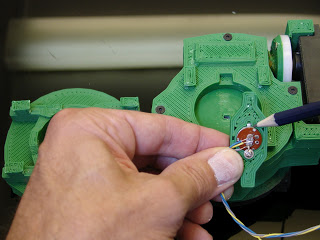
[picture p323: figure]

Mount the potentiometer to “rotpotentioV2″ but make sure to place the little metal plate from the potentiometer in the gap designed in “rotpotentioV2″. Use some little spare screws from your small servos.

PS: “rotmitV2 was not supposed to be standing on the left on three above pictures, since you already have mounted it…

Ease “pistonanticlockV1″ in to “pistonbaseV1″. I have reinforced “pistonanticlockV1″ on the inside with a metal rod. But you can use it like this, it should hold. I broke a few of them during my tests, and was glad they could break instead of something else.

Assemble “higharmV1″ to “rotmitV1″”, use pliers , with ABS it just fit perfectly, I felt like playing with Lego’s. Make sure you have the same position then on the picture.

Tweet

0 (http://www.inmoov.fr/imm_old/1.bp.blogspot.com/-Ee9RUDNv8DU/UFtuk7pSHgI/AAAAAAAAAew/FNCvTLAf9Mc/s1600/DSC05111.JPG)

0 (http://www.inmoov.fr/imm_old/2.bp.blogspot.com/-25i2i4PxiKE/UFtuuJDG8MI/AAAAAAAAAe4/ZElhC3hKTNg/s1600/DSC05112.JPG)

1

Like (http://www.inmoov.fr/imm_old/1.bp.blogspot.com/-Ee9RUDNv8DU/UFtuk7pSHgI/AAAAAAAAAew/FNCvTLAf9Mc/s1600/DSC05111.JPG)

Add “pistonbaseV1″ and “spacerV1″. Attach the potentiometer, again make sure to place the little metal plate from the potentiometer in the gap designed.

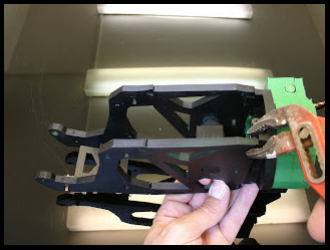
[picture p324: figure]

Assemble the rest of “higharmV1″ and “lowarmV1″. Later, after your tests, you will have to glue those parts.

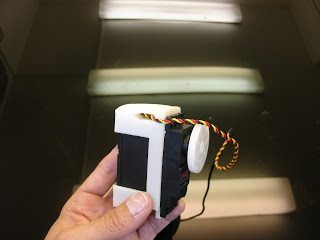
[picture p325: figure]

Attach the servo in the “servoholderV1″.

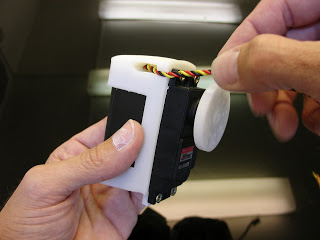
[picture p326: figure]

Run the cables as shown.

Attach the “servobaseV1″, and “pistonanticlockV1″ to the actuator.

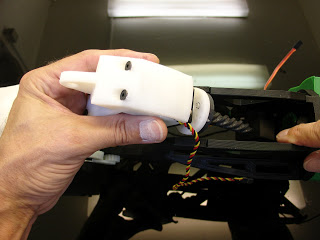
[picture p327: figure]

Turn in “pistonanticlockV1″ in to “pistonbaseV1″. Adding grease is a good idea.

So I assume here you already have glued “elbowshaftgearV1” (http://www.inmoov.fr/imm_old/3.bp.blogspot.com/-Y1NRfwrdrW4/UGjSSjAh9TI/AAAAAAAAAls/6gm1qejfPhM/s1600/inmoov_elbowconnection.png) to “robcap3V1″. So you also have attached the forarm to the bicep. Good.

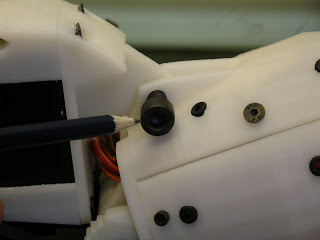
[picture p328: figure]

Here comes the part the most difficult for me to explain. Now lean down “servobase” and attache it to the forarm.

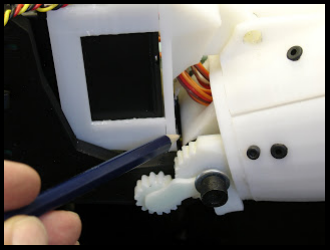
[picture p329: figure]

You should KEEP a gap at it’s base, this is going to be your 0° degree position. Fix or mark the whole arm in this position, it is important not to lose it during the next steps.

Unmount the servo gun. Plug your servo to the Arduino board, and run a sketch to get the 0° position of your servo, it will rotate continuously. Now turn by hand the potentiometer until the servo stops turning. This is your 0° degree position.

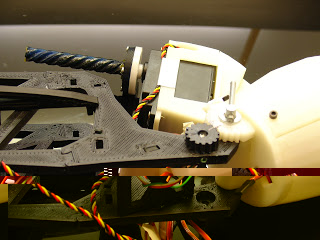
[picture p330: figure]

Mount the “potentiogearV1″ on the potentiometer, making sure the arm and the potentiometer don’t move.

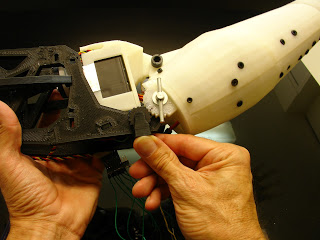
[picture p331: figure]

Clip in the “gearholderV1″. There should not be backlash between the two gears. Keep the servo gun unmounted and make a test with your Arduino like previously to 0°degree. You can move the arm slowly by hand to closed position and open position to check everything is okay. Remount the servo gun.

Big moment now. Rerun the test to 0°degree. The arm should open keeping the gap previously seen at the base. If not it will break the “pistonanticlockV1″.

Tweet (https://twitter.com/intent/tweet?text=Bicep%20-%20&tw_p=tweetbutton&url=http%3A%2F%2Fwww.inmoov.fr%2Fbicep%2F) 0 (http://twitter.com/search?q=http%3A%2F%2Fwww.inmoov.fr%2Fbicep%2F)

Stum (http://www.stumbleupon.com/submit?url=http%3A%2F%2Fwww.inmoov.fr%2Fbicep%2F)

0

Make another test from 0°degree to 60°degree. Check the space left between “pistonanticlockV1″ and “pistonbaseV1″. My arm can go up to 90°, but be carefull that all depends on the gap you have set. So try 10° by 10°degrees. Remember when writing your sketchs to never go further then the best result you got.
Now you can make a test with the servo attached to “rotcenterV1″ going to 90°, that will be the “rest” position of the arm when it will be attached to the coming shoulder.
Normally you should be all set. Hope this helped because it took me a lot of time to do this tuto

# Share and Enjoy

# Leave a comment

You must be logged in (http://www.inmoov.fr/wp-login.php?redirect_to=http%3A%2F%2Fwww.inmoov.fr%2Fbicep%2F) to post a comment.

Copyright © 2014 InMoov (http://www.inmoov.fr/)

Proudly powered by WordPress. (http://wordpress.org/)

BACK TO TOP ↑

Like 1

Share
