aalonsopuig/Inmoov_ROS2/docs/assembly/Arms/Forearm/Hand and Forarm.pdf

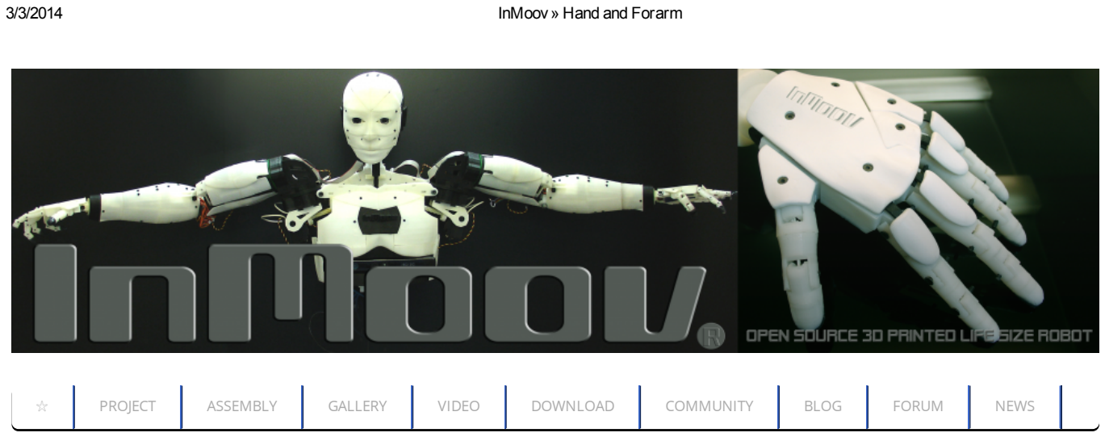
[picture p332: figure]
InMoov» Hand and Forarm; PROJECT; ASSEMBLY; GALLERY; VIDEO; DOWNLOAD; COMMUNITY; BLOG; FORUM; NEWS

http://www.inmoov.fr/hand-and-forarm/ | 1/27

# Hand and Forarm

Print wristarge, wristsmall,thumb with an infill of 30%, 3 shells, best with no support, no raft.
Print Thumb, index3, majeure3, ringfinger3, auriculaire3, with an infill of 30%, 1 shell, best with no support, no raft.
Print robpart2, robpart3, robpart4, robpart5 with an infill of 30%, 3 shell, best with raft, no support. Print coverfinger with an infill of 30%, 3 shells, with support. To get the best printing result on the covers is to print them standing up, instead laying them flat.

The wrist parts are good printed with an infill of 30%, 3 shells, with no raft, no support. The Gears of the wrist should be printed with the best quality your printer can give you.

Big bolts are now printable. (Strong enough for tests and even more!)
You can replace the 16x3mm for the fingers with pins/pegs of filament instead of bolts, it’s cheap, easy, and strong enough. It was a suggestion of FreddyA.

1x8mmx8cm bolt to attach wristlarge to wristsmall.
1x8mmx4cm bolt to attach wriarge to thumbbottom.
1x8mmx6cm bolt for to attach wriarge to robpart1.
16x3mmx2cm bolts for all fingers hinges(I have recut each bolt to adapt to finger width)

These instructions are for the right hand. The left hand is similar but parts are mirrored.

# Step1

Remove the antiwarp supports and trim with a knife, RobPart2, 3, 4 and 5

## HELP ME EXPERIMENT

## SEARCH

search here...

## MEMBER ACTIVITIES

Dwa yne Wi l l i a ms (http://www.inmoov.fr/members/dwilli9013/) upl oa ded a new pi c t ure : openc v_fd_1. j pg (http://www.inmoov.fr/members/dwilli9013/album/picture/46/) 17 hours , 56 mi nut e s a go (http://www.inmoov.fr/activity/p/1213/)

Rob is
standing
proud as a
test bot for
Grog.
He is very
pleased to be a part of
enhancing the Inmoov Nation.

Fred (http://www.inmoov.fr/members/freddyzaz/) upl oa ded a new
pi c t ure : Pos s i bl e spri ng for… (http://www.inmoov.fr/members/freddyzaz/album/picture/45/) 1 da y, 16 hours a go (http://www.inmoov.fr/activity/p/1203/)

Maybe a
possible
spring for
tendons ?

Assemble together Robpart2 and Robpart5

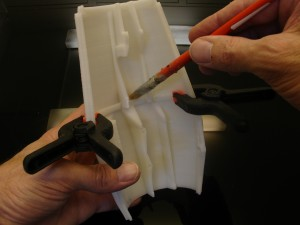
[picture p333: figure]

Help yourself with pliers to hold the parts together while you glue them with Acetone (ABS) or Epoxy 2 components(PLA)

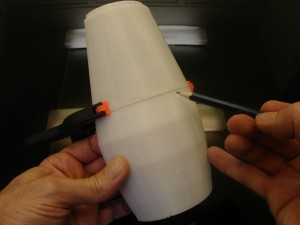
[picture p334: figure]

Avoid using glue on the outside other wise it won’t look clean. Control that your parts are correctly aligned.

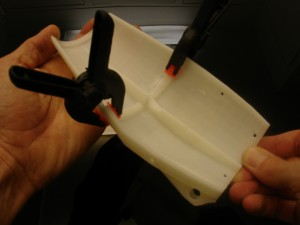
[picture p335: figure]

Do the same with Robpart3 and 4.

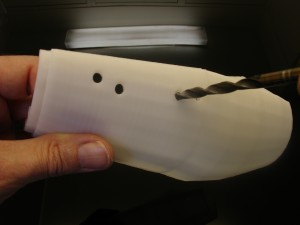
[picture p336: figure]

Redrill the holes on the side of Robpart2 with a 6mm drill. These are for to fix an extra servo to get a double actuated thumb. See: http://www.thingiverse.com/thing:28124

J a c k Phi l l i ps pos t ed a n upda t e 2 da ys , 11 hours a go; Head Connect to Torso. Using EZ Robot for programing interface for now. Printing arms and hands next. Not sure how to post video so here is the link. https://www.youtube.com/wat ch? v=czMIEDz9804&feature=c4- overview&list=UUNwIfeOZc- u4UbOx3bcqJHQ; Ga e l La nge vi n pos t ed a n upda t e 2 da ys , 16 hours a go; To Fred and others:; https://groups.google.com/gro up/inmoov/attach/151d3d256 a4108f0/spring%20tensioner1.j pg?part=4&authuser=0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

## FOLLOW ME

## gael langevin (https://plus.google.com/109466702837468444192?prsrc=5)

413 followers

### 1 circle

## RECENT POSTS

InMoov prosthetic hand almost ready (http://www.inmoov.fr/inmoov-prosthetic-hand-almost-ready/) InMoov in Moscow, Geek Picnic (http://www.inmoov.fr/inmoov-in-moscow-geek-picnic/) InMoov on the New Yorker (http://www.inmoov.fr/inmoov-on-the-new-yorker/)
Wow InMoov Santa! (http://www.inmoov.fr/wow-inmoov-santa/)

Use the little rubber (https://twitter.com/intent/tweet?text=InMoov%20%20Hand%20and%20Forarm%20-%20&tw_p=tweetbutton) silentblocs that came with your servos.

In Robpart5, insert two bolts for 4mm screws in the printed cavities. Mine were not fitting, due to overhang, I heated them with a flam to make them fit.

Trim/Fill the holes of the simple servo bed if there is overhang.

Set in Robpart5 the simple servo bed, make sure it is completely seated on the bottom.

Glue or screw the simple servo bed with 2 wood screws.

New wiring design for the hand (http://www.inmoov.fr/new-wiring-design-for-the-hand/)

## RECENT COMMENTS

Gael Langevin (http://www.inmoov.fr/) on Hand and Forarm
Tom on Hand and Forarm
InMoov » InMoov prosthetic hand almost ready on Default Hardware Map (http://www.inmoov.fr/inmoov-prosthetic-hand-almost-ready/)
Gael Langevin (http://www.inmoov.fr/) on Hand and Forarm
Tom on Hand and Forarm

## ARCHIVES

March 2014 (http://www.inmoov.fr/2014/03/)
February 2014 (http://www.inmoov.fr/2014/02/)
January 2014 (http://www.inmoov.fr/2014/01/)
December 2013 (http://www.inmoov.fr/2013/12/)
November 2013 (http://www.inmoov.fr/2013/11/)
October 2013 (http://www.inmoov.fr/2013/10/)
September 2013 (http://www.inmoov.fr/2013/09/)
August 2013 (http://www.inmoov.fr/2013/08/)
July 2013 (http://www.inmoov.fr/2013/07/)
May 2013 (http://www.inmoov.fr/2013/05/)
April 2013 (http://www.inmoov.fr/2013/04/)
March 2013 (http://www.inmoov.fr/2013/03/)
February 2013 (http://www.inmoov.fr/2013/02/)
January 2013 (http://www.inmoov.fr/2013/01/)
December 2012 (http://www.inmoov.fr/2012/12/)
November 2012 (http://www.inmoov.fr/2012/11/)
October 2012 (http://www.inmoov.fr/2012/10/)
September 2012 (http://www.inmoov.fr/2012/09/)
August 2012 (http://www.inmoov.fr/2012/08/)
July 2012 (http://www.inmoov.fr/2012/07/)
June 2012 (http://www.inmoov.fr/2012/06/)
May 2012 (http://www.inmoov.fr/2012/05/)

## CATEGORIES

Select Category

Tweet (https://twitter.com/intent/tweet?text=InMoov%20%20Hand%20and%20Forarm%20-%20&tw_p=tweetbutton)

1 (http://www.inmoov.fr/wp-content/uploads/2013/09/DSC06394.jpg)

### 6 (http://www.inmoov.fr/wp-content/uploads/2013/09/DSC06395.jpg)

At this point we can mount the servos on simple servo bed.

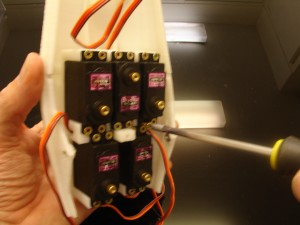
[picture p337: figure]

As you can see on my picture, I’m not using the HK15298 but some MG946r instead, for this tuto. The reason is that Hobbyking Europe is out of stock and I couldn’t wait.

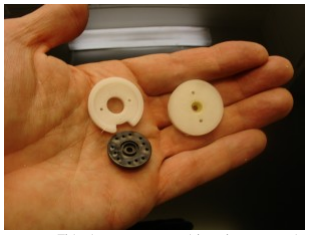
[picture p338: figure]

When you download my parts on Thingiverse, you can either choose to print RobRing or ServoPulley. It all depends, if you received with your servos the black actuator shown in my hand.

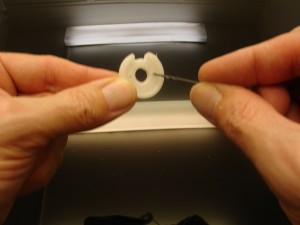
[picture p339: figure]
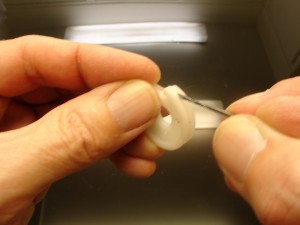
[picture p340: figure]

I personnaly use the ServoPulley. Redrill the holes with a 2mm drill.

Use the screws that came with your servos to mount the black actuator.

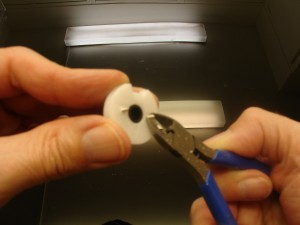
[picture p341: figure]

Cut the screws in the back with cutters.

Now use this script (http://www.inmoov.fr/wp-content/uploads/2013/10/Arduino-Schetch-servo-zerorestmax.txt) with your Arduino to set all your servos at 90 degrees. Set screw all the ServoPulleys in place as shown. Once the ServoPulleys are fixed, using the script again, set all the servos to Zero degrees. This will be for later when we attach the fishing lines. Avoid moving them during the next steps, otherwise you will need to reset them to Zero later.

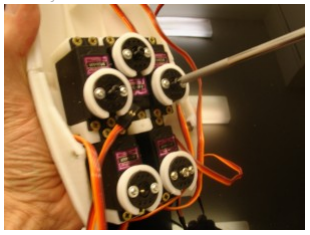
[picture p342: figure]
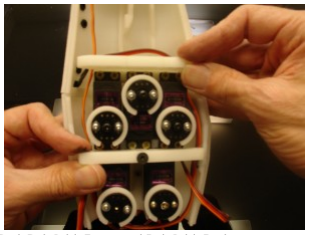
[picture p343: figure]

Mount on Simple servo Bed, RobCableFront and RobCableBack.

# Step2

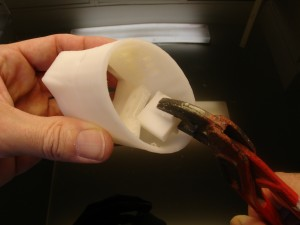
[picture p344: figure]

On RotaWrist1 remove the support.

Redrill if necessary the holes for the lining.

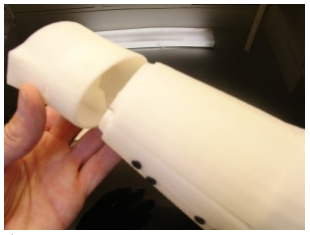
[picture p345: figure]

Make sure it fits on the Robparts.

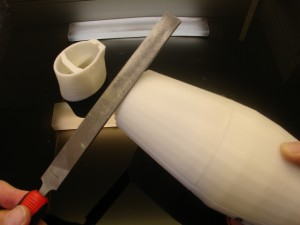
[picture p346: figure]

You can use a fill to adapt it perfectly.

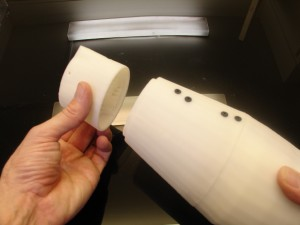
[picture p347: figure]

This is the correct way to mount it, see, the black holes are aligned with the squary part of RotaWrist1. I have seen many assembly where the wrist was mounted the opposite way.

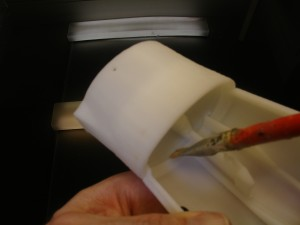
[picture p348: figure]

Back to RotaWrist1. Glue it to Robpart2. When doing this it is good to also set the Robpart3/4 cover to make sure the RotaWrist1 is correctly placed.

Insert your MG996 servo. Here we want a servo with 180 degree rotation. The HK15298 only rotates of 90 degrees.

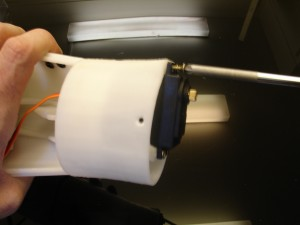
[picture p349: figure]

Set the wood screws to fix your servo in place.

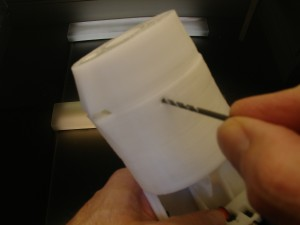
[picture p350: figure]

Redrill with a 2.5mm drill RotaWrist2.

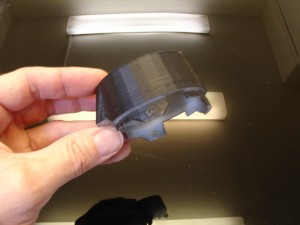
[picture p351: figure]

I like to spray paint in black RotaWrist2 because the grease used inside makes the part become yellow after some time.

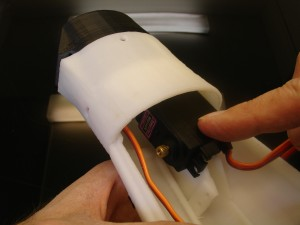
[picture p352: figure]

This picture is to show where to set the extra servo if you use the thumb with double actuation.

Redrill with 8mm RotaWrist3.

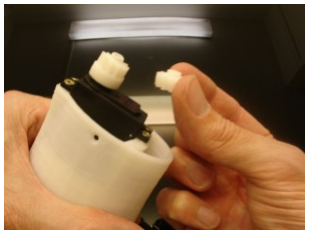
[picture p353: figure]
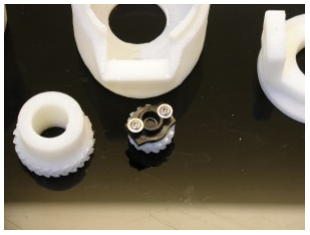
[picture p354: figure]

With your downloads there is two different small gears, use the one you think is most appropriate for your needs. Here is a previous tuto you might want to read. (http://www.inmoov.fr/rotational-wrist/)

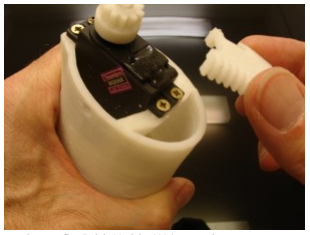
[picture p355: figure]
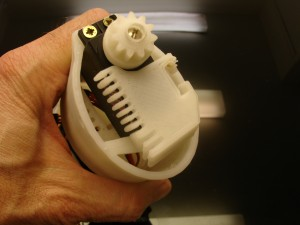
[picture p356: figure]

Use Epoxy two component glus to fix CableHolderWrist on the servo.

Use grease between the components.

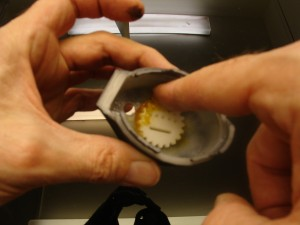
[picture p357: figure]
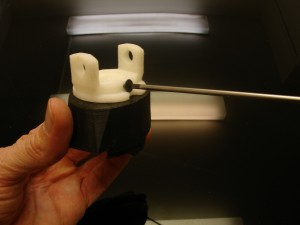
[picture p358: figure]

Mount RotaWrist3 to the big Gear.

# Step3

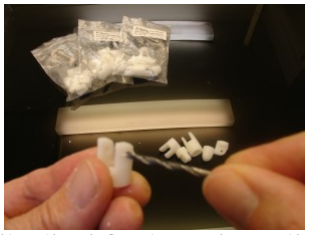
[picture p359: figure]

Time to redrill the finger hinges. I keep the fingers in seperate bags to avoid mixing them.

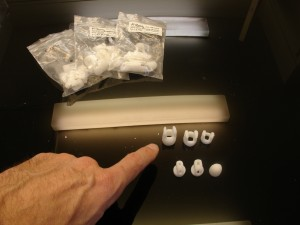
[picture p360: figure]

The outside hinge is redrilled with a 3mm drill.

The inside hinge is redrilled with a 3.2 or 3.5mm drill.

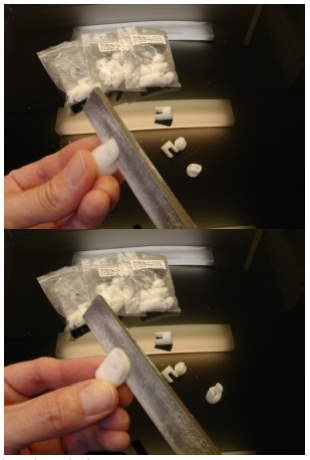
[picture p361: figure]

Fill the hinges to really adapt them the best.

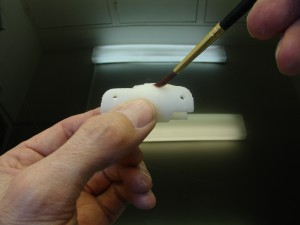
[picture p362: figure]

Glue the parts together with Acetone(ABS)

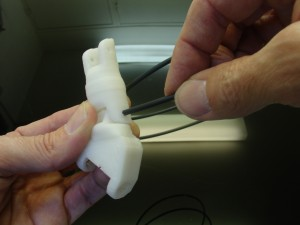
[picture p363: figure]

Use your 3mm filament to make pegs.

Cut with a knife the filament. If you don’t have 3mm filament you will need to do this with bolts of 3mm. I recommand the filament, it’s perfect, cheap and fast.

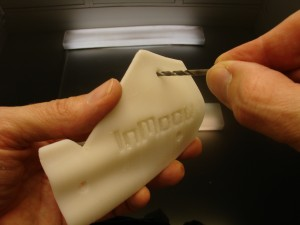
[picture p364: figure]

Redrill all holes of the covers with a 3mm drill.

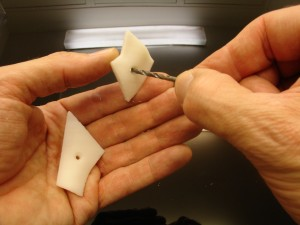
[picture p365: figure]
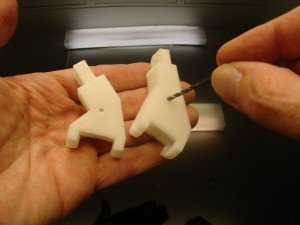
[picture p366: figure]

Redrill Wristmall and Wristlarge with a 2.5mm drill for to adapt the covers. If you don’t have exactly these size of screws, it doesn’t really matter. Use whatever you find at you hardware shop. Remember that the covers have a purpose and are necessary to have a correctly functional hand. They restrain Wristmall from going to the back of the hand. If you don’t understand read this. (http://www.inmoov.fr/dilemna-with-wristsmallv3-part/)

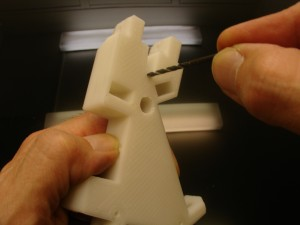
[picture p367: figure]

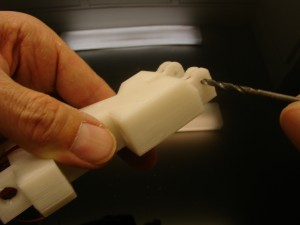
[picture p368: figure]

Redrill the hinges of Wristmall and Wristlarge with a 3.2 or 3.5mm drill

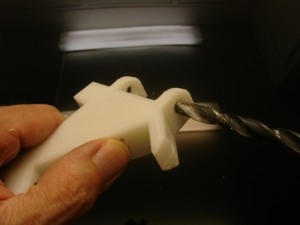
[picture p369: figure]

Redrill the big hinges with a 8mm drill.

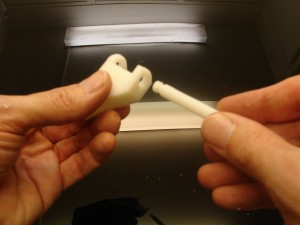
[picture p370: figure]

Ensure Bolts or printed Bolts run smoothly with no resistance but without wobbling.

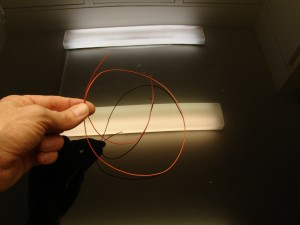
[picture p371: figure]

Cut 10 pieces of 75cm long of your braided fish line 200LB. Don’t use standard nylon because it stretchs.

At this point it is good to decide if you want to have sensors on the tip of the fingers or not. You must have seen three holes above each other for the linings in WristLarge. The third hole (middle one) is for running electrical cables to wire up the sensors.

Insert the braided fish lines in the holes of Wristlarge. In this picture, I don’t have electrical wires for sensor fingers because it was a previous version.

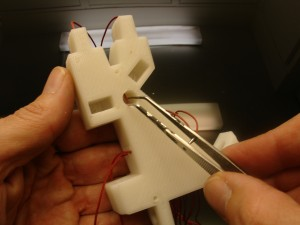
[picture p372: figure]

I have designed a little hole which can help you to guide the linings.

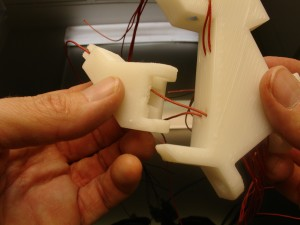
[picture p373: figure]
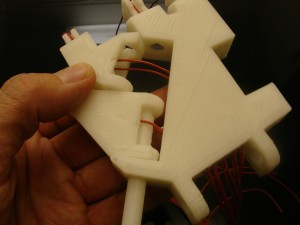
[picture p374: figure]
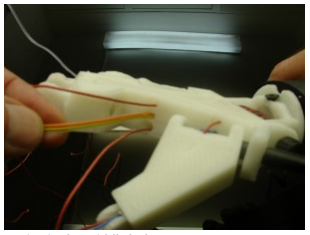
[picture p375: figure]

The electrical cables are running in the middle holes.

Run the linings into Wristmall. Make sure not to twist them on the way through. If you mix them up, the servos won’t be able actuate the fingers correctly.

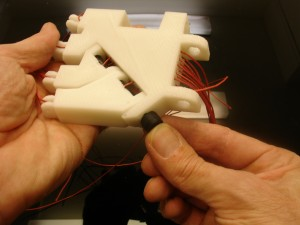
[picture p376: figure]
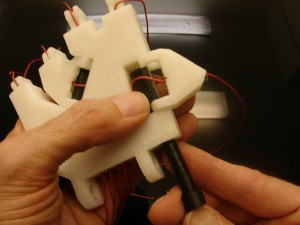
[picture p377: figure]

Repeat the wiring with the thumb. If you are using electrical cables don’t use the “Entretoise”, as shown above, otherwise you won’t be able to run the electric cables.

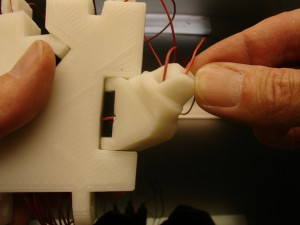
[picture p378: figure]
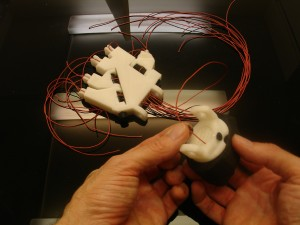
[picture p379: figure]

Line up the hand to the wrist.

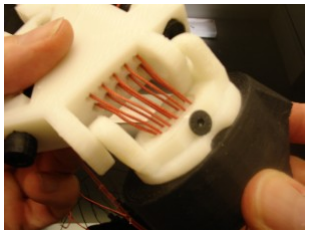
[picture p380: figure]
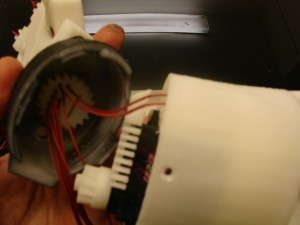
[picture p381: figure]

Now wire up the Wrist to the forarm, each lining has a slot.

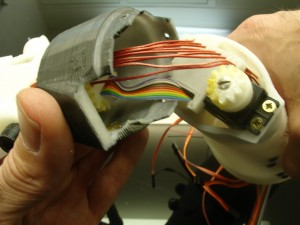
[picture p382: figure]

If you have electrical cable it will be like this. Using color ribbon is a good idea because you know what wire correspond to which finger and connection.

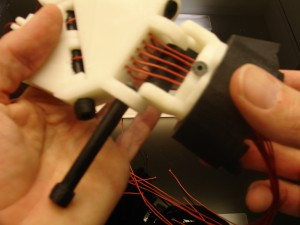
[picture p383: figure]

Add the “Entretoise” between the cables

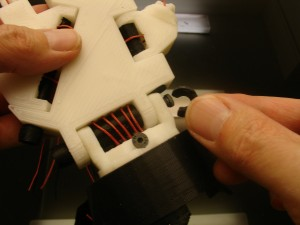
[picture p384: figure]

Use the “C” ring to end stop the bolt from coming out.

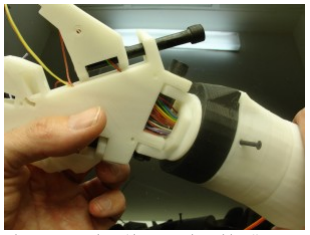
[picture p385: figure]

This is the back of the hand, you can see how I have set the cables. I’m not sure it is the best solution but, like you, I’m learning and discovering.

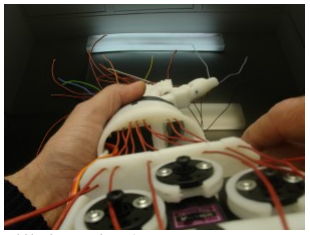
[picture p386: figure]

Here is how the lining should look up to the wrist.

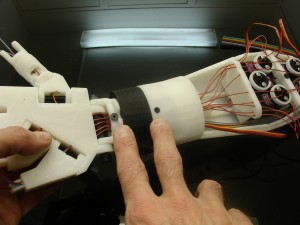
[picture p387: figure]

When you assemble the wrist make sure the servo is set at 90 degree and that the two screws on the picture are aligned. Until now I never did recomandation about this, and unfortunatly many of the gestures I created can’t be reproduced by other InMoov because the wrist isn’t set the same than mine.

Glue RobCap to ElbowShaftGear.

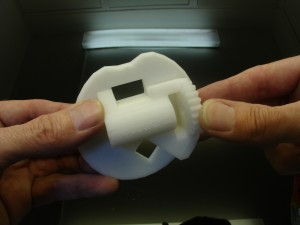
[picture p388: figure]

Aligning the squarry hole is the way to do it. If are using ABS and acetone, I can tell you there is no need to add screws if both of your surfaces are correctly flat.

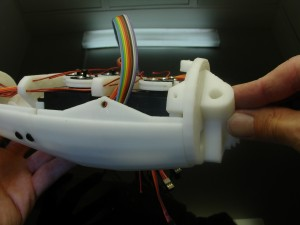
[picture p389: figure]

Now glue this assembly to RobPart5, make sure it is correctly aligned in the slots.

# Step 4

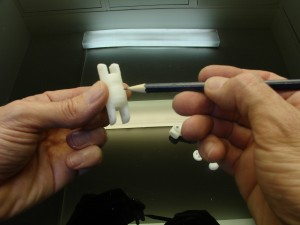
[picture p390: figure]

When assembling the fingers there is marks that can help you to see in which order it has to be done. I won’t go in those details here but you can find more instructions in the finger starter tutorial. (http://www.inmoov.fr/finger-starter/) The finger starter has numbers for an easy comprehension, the normal fingers don’t have those numbers, but the parts are the same.

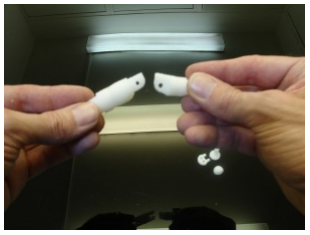
[picture p391: figure]

Now that you have all your fingers assembled, for those that want to add sensors here is how we are going to proceed.

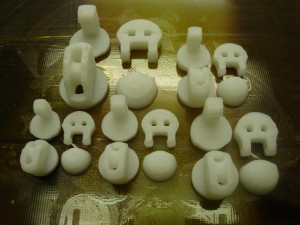
[picture p392: figure]

Finger sensor prints.

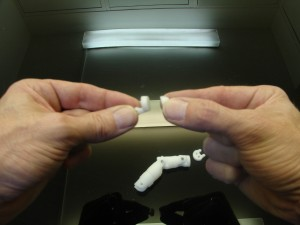
[picture p393: figure]

Glue the tip of the finger to the hinge tip. Make sure to align the nail lines, it will look better

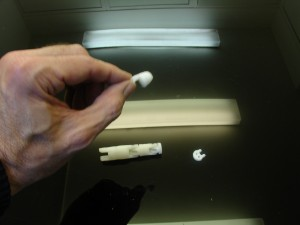
[picture p394: figure]

Sorry for the blurry picture.

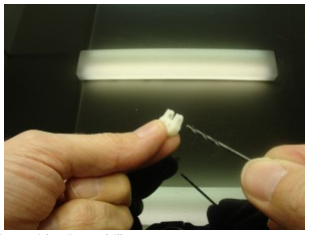
[picture p395: figure]

Redrill the holes of the hinge with a 2mm drill.

Redrill the hole of the tip hinge with the same bit.

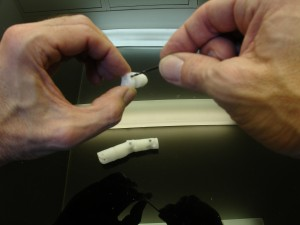
[picture p396: figure]

Add the hinge to the tip hinge and redrill them together to make sure they fit nicely.

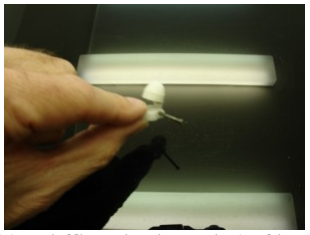
[picture p397: figure]

I used non flat metal nails instead of filament here, because the size of these parts are small. I just cut them at the size needed.

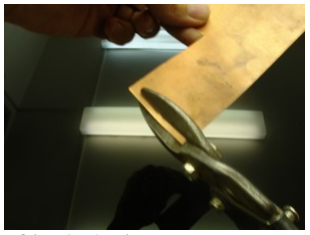
[picture p398: figure]

Cut some strips of copper of about 3 to 4mm large.

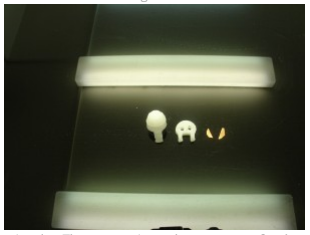
[picture p399: figure]

Recut those strips in tiny triangles. These are going to be contactors for the antistatic foam.

Cut with scissors some nice little rounds in your 4/5mm thick antistatic foam. This foam is sold with electronic components to avoid electric shocks. Most of the time we just throw it away when we buy components, you can also buy it in many electonic shops. It contains carbon which is an electrical conductor. When the foam is pressed against the 2 contactors, the carbon lets the current flow between them. More the foam is pressed and more current goes through. This is the info we will send to the Arduino Analog pins.

Glue with 2 components epoxy the foam to tip hinge part as shown on the picture.

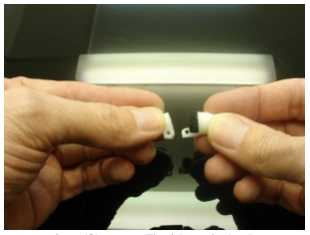
[picture p400: figure]

Try to assemble the two parts and see if it move. The hinge design is supposed to stop the hinge from opening further than the 5mm thickness of the foam.

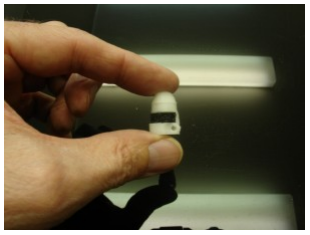
[picture p401: figure]
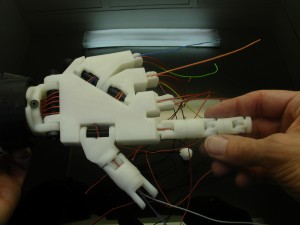
[picture p402: figure]

Time to mount the finger to Wristlarge. Notice the last hinge of the finger, this will receive the finger tip sensor assembly. All the holes in those finger parts should be cleared and large enough to have the 2 tension cables and the 2 electrical cables.

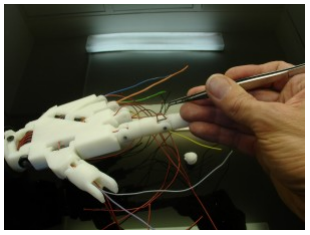
[picture p403: figure]

Run the tension cables and the electrical cables. One of each on the up side and one of each on the down side. Make sure to avoid any twisting of cables, this would cause to get unfunctional fingers.

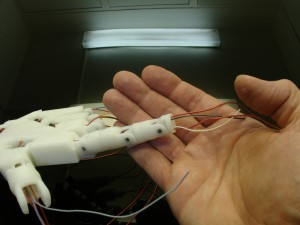
[picture p404: figure]

The color ribbon again is handy in this task.

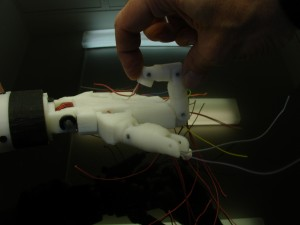
[picture p405: figure]

Fold the fingers to smooth up a bit the cables in their path.

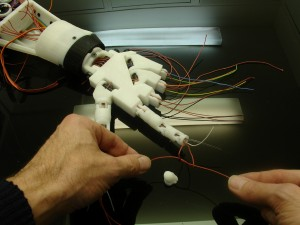
[picture p406: figure]

Make knots with the tension cables.

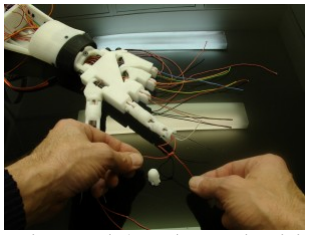
[picture p407: figure]

A bunch of them is necessary because we don’t want them to go through the holes when the servos are pulling hard on them.

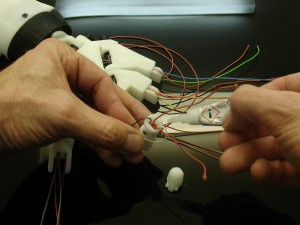
[picture p408: figure]

What I do is even add glue to ensure any bad surprise. I also glue the electrical cables at the same time. When doing so, it is good to have the finger folded otherwise the electrical cables could later restrain the full motion of the finger.

Cut the remains of the tension cables. Now glue the hinge of the finger tip to the last hinge of the finger. Notice the position, don’t glue them upside down. Remember I mentionned the tip hinge was design to avoid opening further than the thickness of the foam.

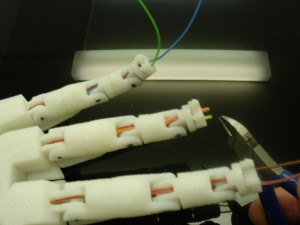
[picture p409: figure]

Cut each electrical wire at a 4/5mm length. Scary moment because too short would mean to redo all the wiring.

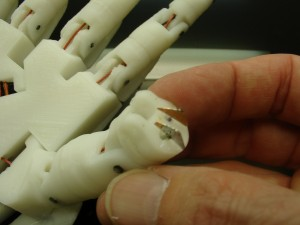
[picture p410: figure]

Cut and clear up the plastic on the electrical cable and solder the copper triangles.

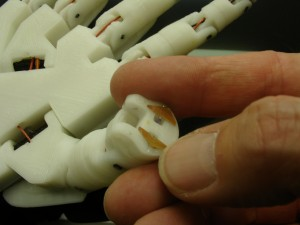
[picture p411: figure]

Once done, fold the cable and lay the copper triangles in a flat position.

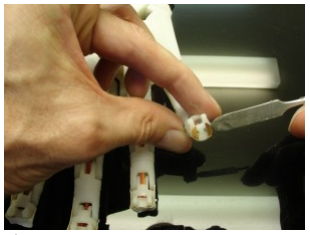
[picture p412: figure]

Add 2 component glue under.

To maintain them flat during the time the glue gets hard, I used some tape, Look out for the tape you use as it maybe glued as well to the finger tips.

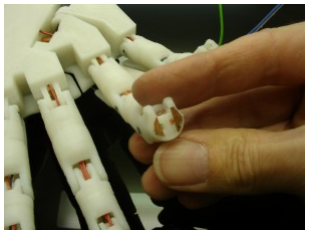
[picture p413: figure]

This is the result.

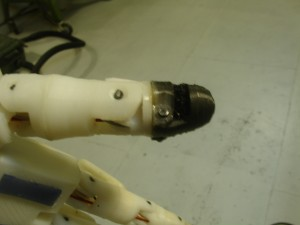
[picture p414: figure]

Now you can add the finger tip with the nail and you should have a sensor ready to be pressed and give feedback.

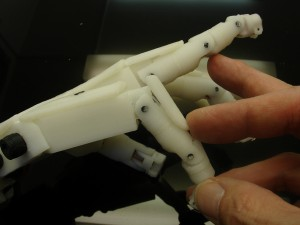
[picture p415: figure]

Glue the finger covers on the fingers.

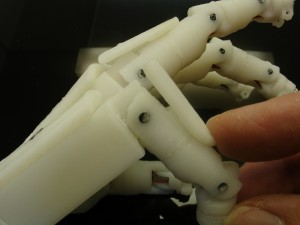
[picture p416: figure]

These are used to avoid the finger going to much in a backward position and they also add a llok to the design

Do the same with the Thumb cover and Wristsmall. Actually I glue them first and then I add the screw, that keeps them well in place. Recut with a knife the two corners on the thumb hinge. If you don’t the hinge will be forcing against the hand cover.

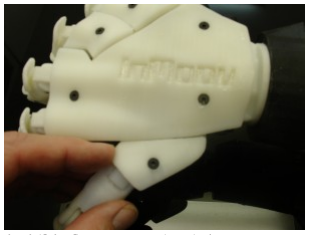
[picture p417: figure]

Add the hand cover and check if the fingers are moving nicely.

You can add Sugru on the finger tips, and ping pong surface in the palm of the hand for a better gripping. I found also some kitchen heat protectors for 1,50 euros with silicone surface. It is even better. Ideally for the finger tips it would be to have what they do today with silicone grips on the tooth brushs.

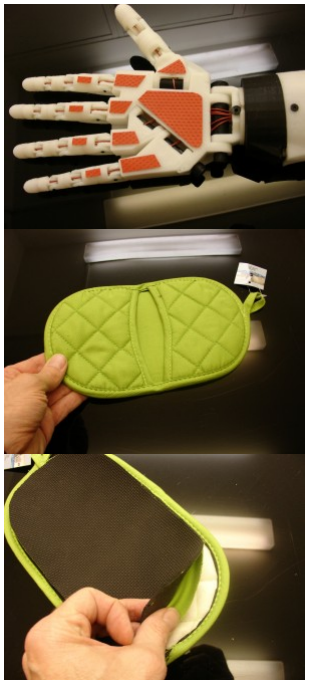
[picture p418: figure]

Hey it looks like you are set to tension the fishing braided (http://www.inmoov.fr/wp-content/uploads/2013/09/DSC06542.jpg)

Tweet (https://twitter.com/intent/tweet?text=Hand%20and%20Forarm%20-%20&tw_p=tweetbutton) 1 (http://twitter.com/search?q=http%3A%2F%2Fwww.inmoov.fr%2Fhand-and-forarm%2F)

6

December 22, 2013 2:05 am Log in to Reply (http://www.inmoov.fr/wp-login.php?redirect_to=http%3A%2F%2Fwww.inmoov.fr%2Fhand-and-forarm%2F)

January 8, 2014 3:28 am Log in to Reply (http://www.inmoov.fr/wp-login.php?redirect_to=http%3A%2F%2Fwww.inmoov.fr%2Fhand-and-forarm%2F)

January 9, 2014 3:14 am Log in to Reply (http://www.inmoov.fr/wp-login.php?redirect_to=http%3A%2F%2Fwww.inmoov.fr%2Fhand-and-forarm%2F)

January 12, 2014 7:03 am Log in to Reply (http://www.inmoov.fr/wp-login.php?redirect_to=http%3A%2F%2Fwww.inmoov.fr%2Fhand-and-forarm%2F)

January 12, 2014 8:03 pm Log in to Reply (http://www.inmoov.fr/wp-login.php?redirect_to=http%3A%2F%2Fwww.inmoov.fr%2Fhand-and-forarm%2F)

# lines!!

In the next tuto there is steps I’m going through again and they might also look a bit different. The reason is because of updates. Actually the next tuto was done before the tuto you just followed above.

Go to this tutorial for tensioning the Linings. (http://www.inmoov.fr/lining-and-tighting-the-tendons/)

# Share and Enjoy

# 12 COMMENTS

InMoov » New wiring design for the hand (http://www.inmoov.fr/new-wiring-design-for-the-hand/)

[…] Hand and Forarm […]

Vinícius (http://www.inmoov.fr/members/v1n1/)

OI…..queria saber onde conseguiu os arduínos e os motores para mover o dedos… também queria saber como se conecta o eletrodos no braço!!

Gael Langevin (http://www.inmoov.fr/members/admin/)

Hi, can you translate in English? Thanks

Renato Brigido (http://www.inmoov.fr/members/rbrigido/)

Hi Gael, Vinicius wants to know where did you get the arduino components and the motors that move the fingers, and , also, how to conect the electrodes in the arm.

Gael Langevin (http://www.inmoov.fr/members/admin/)

Hi, the Arduino for the arm and hand is a Arduino Uno, you can get it everywhere on the net (Adafruit for exemple), for the motors I use some HK15298 from Hobbyking.
The connection map is here (http://www.inmoov.fr/default-hardware-map/)
The connectors are here (http://www.inmoov.fr/creating-the-connectors/)

Share

February 24, 2014 8:58 am Log in to Reply (http://www.inmoov.fr/wp-login.php?redirect_to=http%3A%2F%2Fwww.inmoov.fr%2Fhand-and-forarm%2F)

February 24, 2014 2:16 pm Log in to Reply (http://www.inmoov.fr/wp-login.php?redirect_to=http%3A%2F%2Fwww.inmoov.fr%2Fhand-and-forarm%2F)

February 28, 2014 10:32 am Log in to Reply (http://www.inmoov.fr/wp-login.php?redirect_to=http%3A%2F%2Fwww.inmoov.fr%2Fhand-and-forarm%2F)

February 28, 2014 10:34 am Log in to Reply (http://www.inmoov.fr/wp-login.php?redirect_to=http%3A%2F%2Fwww.inmoov.fr%2Fhand-and-forarm%2F)

February 28, 2014 7:24 pm Log in to Reply (http://www.inmoov.fr/wp-login.php?redirect_to=http%3A%2F%2Fwww.inmoov.fr%2Fhand-and-forarm%2F)

March 2, 2014 5:44 am Log in to Reply (http://www.inmoov.fr/wp-login.php?redirect_to=http%3A%2F%2Fwww.inmoov.fr%2Fhand-and-forarm%2F)

March 2, 2014 11:38 am Log in to Reply (http://www.inmoov.fr/wp-login.php?redirect_to=http%3A%2F%2Fwww.inmoov.fr%2Fhand-and-forarm%2F)

Tom

Hi, Gael
Awesome work! I’m going to print the parts and make one. But where should the Arduino Uno be settled in Inmoov’s hand? I didn’t find it in this tuto. Maybe u could give me some directions? Thank u.
BTW, for 3D print, are these 4 files enough for this tuto?
Hand_robot__InMoov
Adjustable_thumb_for_InMoov Simple_Servo_Bed_for_InMoov Inmoov_Robot_Rotation_Wrist

Thanks again! Hope I can finish it.

Gael Langevin (http://www.inmoov.fr/members/admin/)

Yes this 4 files are enough. You can fit an Arduino Uno inside the forearm, there is space enough although it isn’t designed to do that. I had difficulties to get the USB cable inserted. If you want easy set up, go for Arduino Nano.

Tom (http://www.inmoov.fr/members/ldldlr/)

Hi, Gael
Nice work and I really want to make one. But I find out that it is really expensive to print these things (I mean hand) totally, since I have no 3d printer myself. I ask a company to print this, but need 18000 hkd, which is about 2400 us dollar. So I want to ask whether it needs such money? How much may this cost by yourself? It is too big number for me , since I’m steel student… I thought this may cost me about 200 us dollar. Or do you have any suggestion? Thank u very much!! Really love your work！

Tom (http://www.inmoov.fr/members/ldldlr/)

I’m still student not steel student… Sorry for the mistake in last comment.

Gael Langevin (http://www.inmoov.fr/members/admin/)

No problem

Tom (http://www.inmoov.fr/members/ldldlr/)

Hi, Gael. So the question about the budget？ How much will it take for the 3d print of this part? I mean the hand and forarm. I may have no enough money for it. Any suggestion? Thank you

Gael Langevin (http://www.inmoov.fr/members/admin/)

Hi, it is hard for me to say because it all depends on your material and printer experience. I would say that with 15 to 20 euros of ABS it is largely enough to print those parts. If I remember correctly, the hand and forearm have a total weight of 750Gr. But you need to have a 3D printer.

# Leave a comment

You must be logged in (http://www.inmoov.fr/wp-login.php?redirect_to=http%3A%2F%2Fwww.inmoov.fr%2Fhand-and-forarm%2F) to post a comment.

Copyright © 2014 InMoov (http://www.inmoov.fr/)

Proudly powered by WordPress. (http://wordpress.org/)

BACK TO TOP ↑
