aalonsopuig/Inmoov_ROS2/docs/assembly/Arms/Hand/Finger Starter.pdf

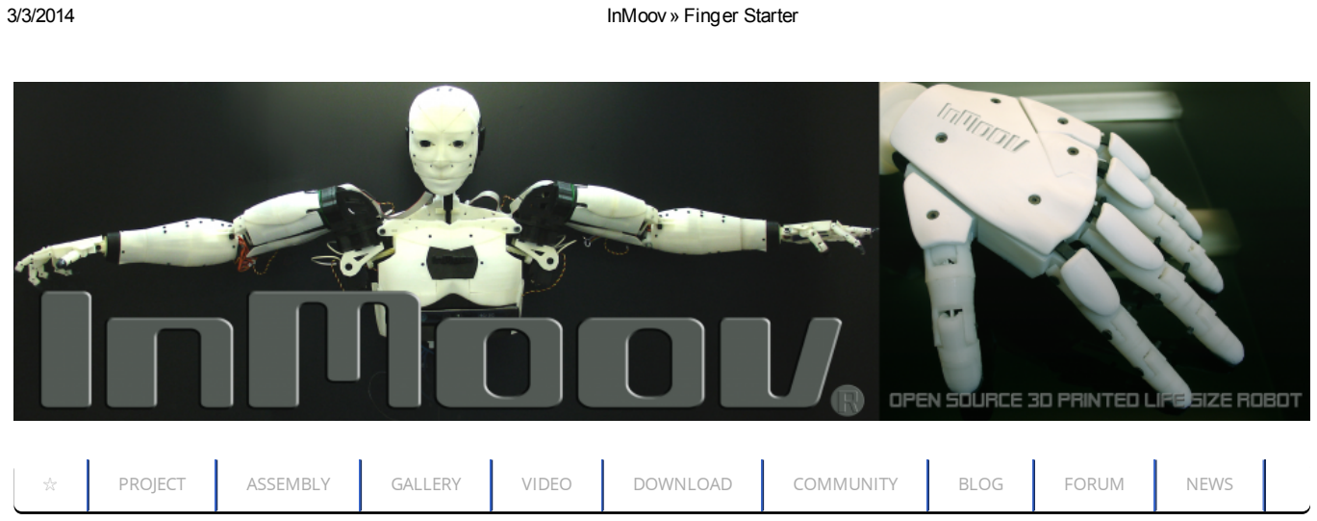
[picture p419: figure]
InMoov» Finger Starter; PROJECT; ASSEMBLY; GALLERY; VIDEO; DOWNLOAD; COMMUNITY; BLOG; FORUM; NEWS

http://www.inmoov.fr/finger-starter/ | 1/13

# Finger Starter

# Assembly of the “Finger Starter”

This is going to be interesting
We are going to assemble a finger to a small servo for testing it with an Arduino board. The servo I used on the pictures (http://twitter.com/search?q=http%3A%2F%2Fwww.inmoov.fr%2Ffinger-starter%2F) is a digital HK15298 but you can use also a cheap analog MG995 or even cheaper if you find (http://twitter.com/search?q=http%3A%2F%2Fwww.inmoov.fr%2Ffinger-starter%2F) and if the size specifications are the same.
The Arduino board (https://twitter.com/intent/tweet?text=InMoov%20%20Finger%20Starter%20-%20&tw_p=tweetbutton) used here is a Arduino Uno. It is best to add an external power supply because even if these servos are small they draw to much current which will or might reboot your board.
For connections and power supply you can see HERE. (http://inmoov.blogspot.fr/2012/12/power-supply-robot-head-printed.html) These connections drawing are mainly for the whole hand, but it is the same for one servo/finger or for five.

The pulling rods I (http://www.printfriendly.com/print?url=http%3A%2F%2Fwww.inmoov.fr%2Ffinger-starter%2F) use on this tuto is a fishing nylon, but it is not what works the best because it tends to stretch overtime. I recommand for InMoov, fishing braid 200LB. But for this test you can use anything you have at hand as long as it can pull and is thin enough to let the finger curl.

Now let see what we have printed and how we are going to do that.

Redrill the sides hinges holes with a 3mm drill.

## HELP ME EXPERIMENT

## SEARCH

search here...

## MEMBER ACTIVITIES

Dwa yne Wi l l i a ms (http://www.inmoov.fr/members/dwilli9013/) upl oa ded a new pi c t ure : openc v_fd_1. j pg (http://www.inmoov.fr/members/dwilli9013/album/picture/46/) 17 hours , 54 mi nut e s a go (http://www.inmoov.fr/activity/p/1213/)

Rob is
standing
proud as a
test bot for
Grog.
He is very
pleased to be a part of
enhancing the Inmoov Nation.

Fred (http://www.inmoov.fr/members/freddyzaz/) upl oa ded a new
pi c t ure : Pos s i bl e spri ng for… (http://www.inmoov.fr/members/freddyzaz/album/picture/45/) 1 da y, 16 hours a go (http://www.inmoov.fr/activity/p/1203/)

Maybe a
possible
spring for
tendons ?

Tweet (https://twitter.com/intent/tweet?text=InMoov%20%20Finger%20Starter%20-%20&tw_p=tweetbutton)

0 (http://twitter.com/search?q=http%3A%2F%2Fwww.inmoov.fr%2Ffinger-starter%2F)

4

Like

The inside hinges holes should be redrilled with a 3.5mm drill.

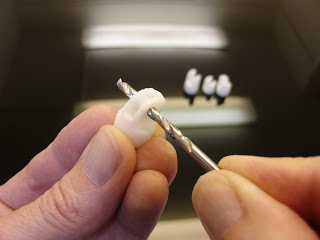
[picture p420: figure]

So the inside hinges of the finger should also be done with a 3.5mm drill.

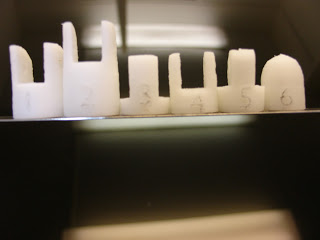
[picture p421: figure]

Note the finger parts have numbers printed for a easier assembly.

J a c k Phi l l i ps pos t ed a n upda t e 2 da ys , 11 hours a go; Head Connect to Torso. Using EZ Robot for programing interface for now. Printing arms and hands next. Not sure how to post video so here is the link. https://www.youtube.com/wat ch? v=czMIEDz9804&feature=c4- overview&list=UUNwIfeOZc- u4UbOx3bcqJHQ; Ga e l La nge vi n pos t ed a n upda t e 2 da ys , 16 hours a go; To Fred and others:; https://groups.google.com/gro up/inmoov/attach/151d3d256 a4108f0/spring%20tensioner1.j pg?part=4&authuser=0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
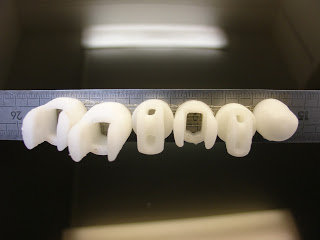
[picture p422: figure]

## FOLLOW ME

## RECENT POSTS

InMoov prosthetic hand almost ready (http://www.inmoov.fr/inmoov-prosthetic-hand-almost-ready/) InMoov in Moscow, Geek Picnic (http://www.inmoov.fr/inmoov-in-moscow-geek-picnic/) InMoov on the New Yorker (http://www.inmoov.fr/inmoov-on-the-new-yorker/)
Wow InMoov Santa! (http://www.inmoov.fr/wow-inmoov-santa/)
New wiring design for the hand (http://www.inmoov.fr/new-wiring-design-for-the-hand/)

## RECENT COMMENTS

Gael Langevin (http://www.inmoov.fr/) on Hand and Forarm (http://www.inmoov.fr/hand-and-forarm/#comment-482)

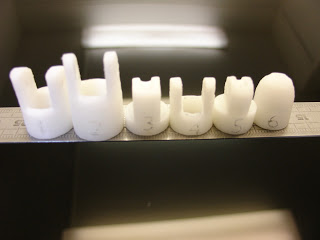
[picture p423: figure]

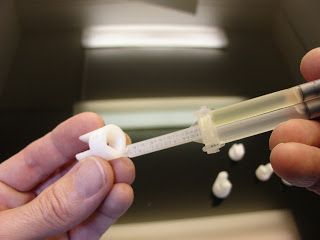
[picture p424: figure]
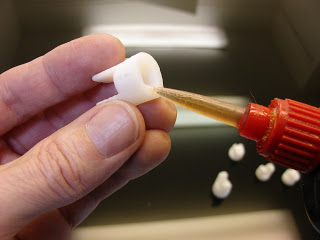
[picture p425: figure]

Depending on the material you have used to print there is different ways to glue the parts together. If you have PLA prints, a two components epoxy glue is really good but you can also use UHU glue. If you have printed in ABS, you can use epoxy, UHU glue but what works the best is acetone.

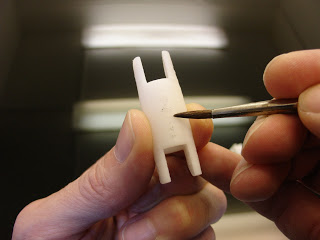
[picture p426: figure]

Applying few drops of acetone will link disolve the parts together like it was printed in one piece. So take part 1 and part 2 and glue them together.

Tom on Hand and Forarm (http://www.inmoov.fr/hand-and-forarm/#comment-481)
InMoov » InMoov prosthetic hand almost ready on Default Hardware Map (http://www.inmoov.fr/inmoov-prosthetic-hand-almost-ready/)
Gael Langevin (http://www.inmoov.fr/) on Hand and Forarm (http://www.inmoov.fr/hand-and-forarm/#comment-479)
Tom on Hand and Forarm (http://www.inmoov.fr/hand-and-forarm/#comment-478)

## ARCHIVES

March 2014 (http://www.inmoov.fr/2014/03/)
February 2014 (http://www.inmoov.fr/2014/02/)
January 2014 (http://www.inmoov.fr/2014/01/)
December 2013 (http://www.inmoov.fr/2013/12/)
November 2013 (http://www.inmoov.fr/2013/11/)
October 2013 (http://www.inmoov.fr/2013/10/)
September 2013 (http://www.inmoov.fr/2013/09/)
August 2013 (http://www.inmoov.fr/2013/08/)
July 2013 (http://www.inmoov.fr/2013/07/)
May 2013 (http://www.inmoov.fr/2013/05/)
April 2013 (http://www.inmoov.fr/2013/04/)
March 2013 (http://www.inmoov.fr/2013/03/)
February 2013 (http://www.inmoov.fr/2013/02/)
January 2013 (http://www.inmoov.fr/2013/01/)
December 2012 (http://www.inmoov.fr/2012/12/)
November 2012 (http://www.inmoov.fr/2012/11/)
October 2012 (http://www.inmoov.fr/2012/10/)
September 2012 (http://www.inmoov.fr/2012/09/)
August 2012 (http://www.inmoov.fr/2012/08/)
July 2012 (http://www.inmoov.fr/2012/07/)
June 2012 (http://www.inmoov.fr/2012/06/)
May 2012 (http://www.inmoov.fr/2012/05/)

## CATEGORIES

Select Category

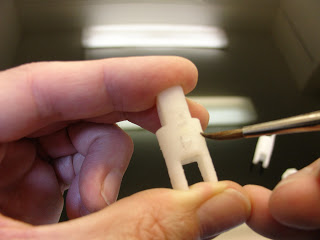
[picture p427: figure]

Glue together part 3 and 4.

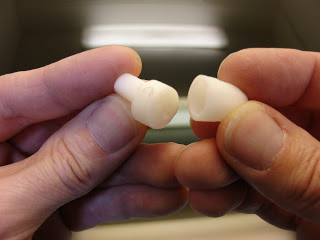
[picture p428: figure]

Don’t glue yet parts 5 and 6

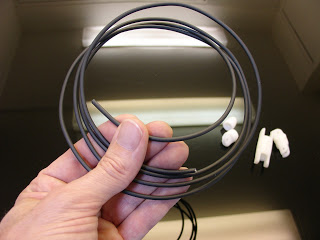
[picture p429: figure]

Take a piece of your 3mm filament, if you don’t have that you will need to get some screws of 3mm at your hardware shop.

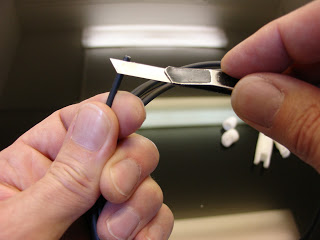
[picture p430: figure]

Get it trimmed with a cutter knife.

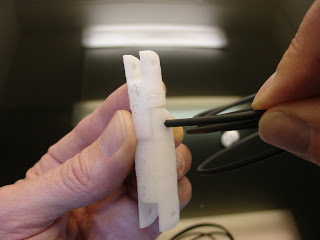
[picture p431: figure]

Push it in the hole, assembling part 1/2 to 3/4 together.

Once it reaches the other side,

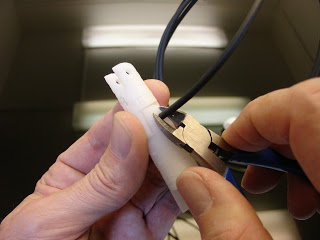
[picture p432: figure]

cut the filament with pliers.

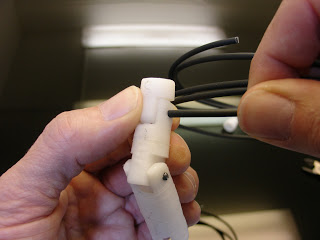
[picture p433: figure]

Do the same trick with parts 3/4 to 5

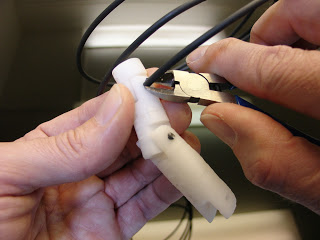
[picture p434: figure]
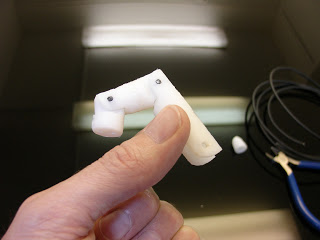
[picture p435: figure]

Now we have a finger that should move freely.

Assemble the finger to the main part with the same technique.

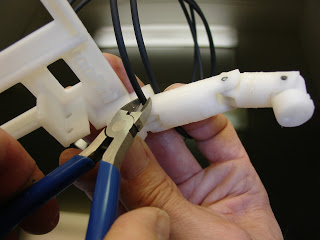
[picture p436: figure]
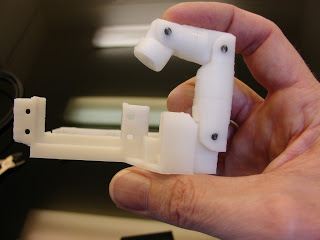
[picture p437: figure]

You should have something like this. It should be able to freely fold to this angle.

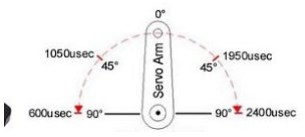
[picture p438: figure]

Now lets hack the servo. We are going to find an arbitrary zero point on the servo. Turn by hand the actuator to the maximum left, note until where it goes. Do the same to the left and note until where it went. These two points are the extremes positions of your servo, in the middle of these two points decide where is the arbitrary zero point. You can find that with your arduino board if you know how to do it, but this is a simple solution for now even though it isn’t precise.

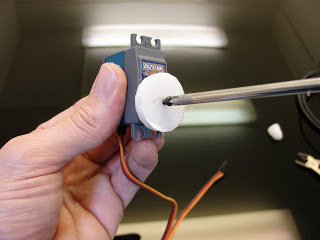
[picture p439: figure]

Mount, Screw the “RobRing” on your servo, the two little holes should be on your extreme points.

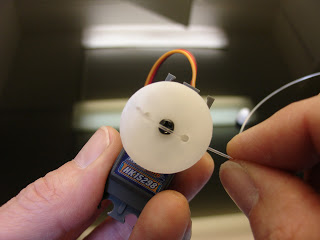
[picture p440: figure]

Take a piece of rod of about 50cm long. Run your rod through one hole.

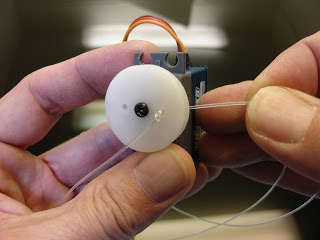
[picture p441: figure]

Make two knots at approximatly 25cm of your rod, like this. make them well tight.

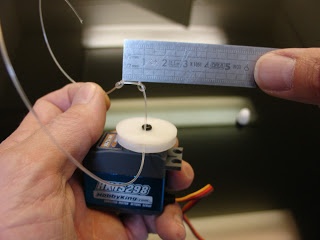
[picture p442: figure]

Add another set of knots about a 1cm away from the first set.

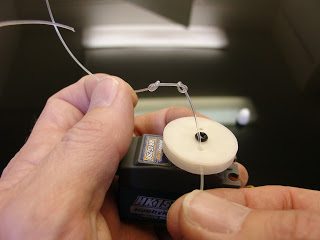
[picture p443: figure]

On my picture I did only two knots like this, but they might run through the hole of “RobRing” and that shouldn’t happen. Adding a bunch of knots will help to avoid that.

Now run the other end of the rod through the second hole.

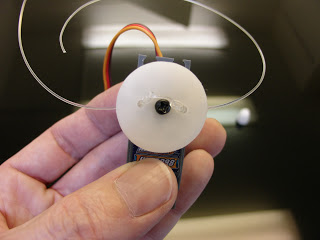
[picture p444: figure]

You should have something like this, with even more knots than me.

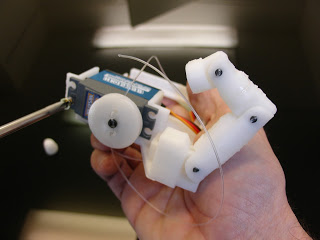
[picture p445: figure]

Time to fix the servo to the base.

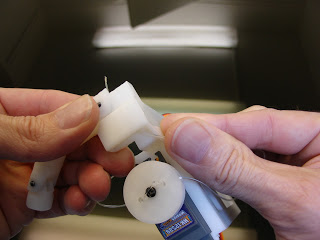
[picture p446: figure]

Run the bottom rod through the parts like on the following pictures.

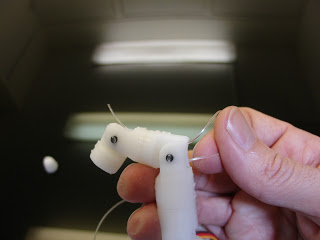
[picture p447: figure]

Just make sure not to invert your rod, it should always on the back of the finger.

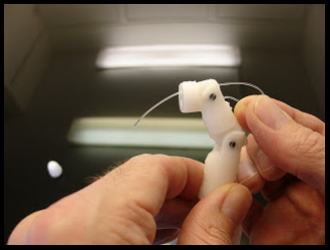
[picture p448: figure]
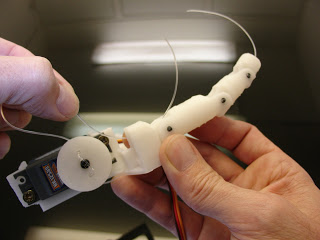
[picture p449: figure]

Now run the second rod on the inside of the finger.

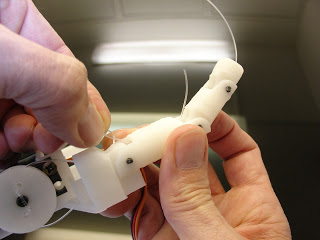
[picture p450: figure]

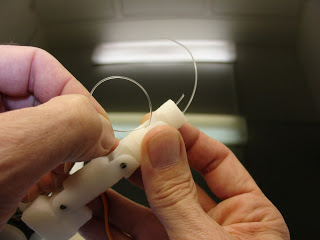
[picture p451: figure]
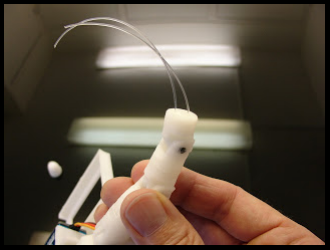
[picture p452: figure]

You should end up like this.

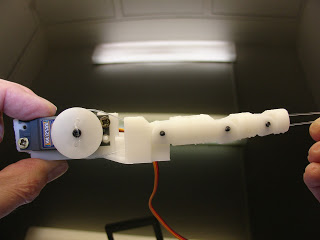
[picture p453: figure]

Check your servo is at his zero arbitrary point.

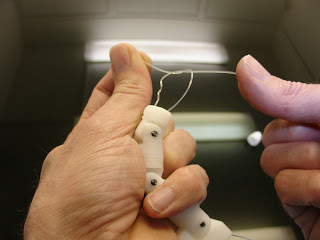
[picture p454: figure]

Curl a little bit the finger and make a few knots between the two wires.

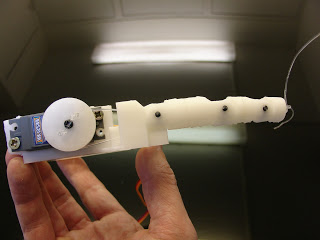
[picture p455: figure]

When turning “RobRing” by hand you should be able to get the finger in this position. Finger totally stretched.

Now cut the rods.

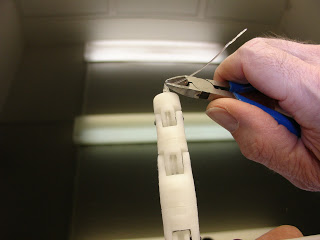
[picture p456: figure]
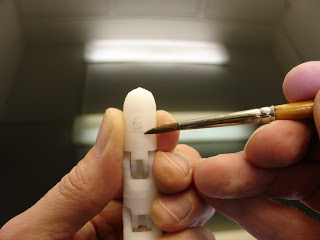
[picture p457: figure]

Glue part 6 to 5. If you look close at part 6, there is a nail side, and I haven’t put the number on the nail for aesthetic reasons.

Tweet (https://twitter.com/intent/tweet?text=Finger%20Starter%20-%20&tw_p=tweetbutton) 0 (http://twitter.com/search?q=http%3A%2F%2Fwww.inmoov.fr%2Ffinger-starter%2F)

Stum (http://www.stumbleupon.com/submit?url=http%3A%2F%2Fwww.inmoov.fr%2Ffinger-starter%2F)

Try to move the finger by rotating “RobRing”, it should move freely without locking.

Insert the Arduino board and make a wire connection like this. Orange or yellow to pin3 on PWM. Red on +5V. Black or brown on Gnd (ground).

Okay at this point Grog is doing a basic InMoov starter service, and is not ready with it, hopefully it will very soon. Be patient this is all done on our free time. But you can follow this tutorial (http://myrobotlab.org/tutorials) to get started with Myrobotlab. Things have changed a bit since I wrote it but it helps to understand the basics.

# Share and Enjoy

Like 4

Share

# Leave a comment

You must be logged in (http://www.inmoov.fr/wp-login.php?redirect_to=http%3A%2F%2Fwww.inmoov.fr%2Ffinger-starter%2F) to post a comment.

Copyright © 2014 InMoov (http://www.inmoov.fr/)

Proudly powered by WordPress. (http://wordpress.org/)

BACK TO TOP ↑
