aalonsopuig/Inmoov_ROS2/docs/assembly/Arms/Hand/Lining and Tighting the tendons.pdf

3/3/2014 | InMoov» Lining and Tighting the tendons

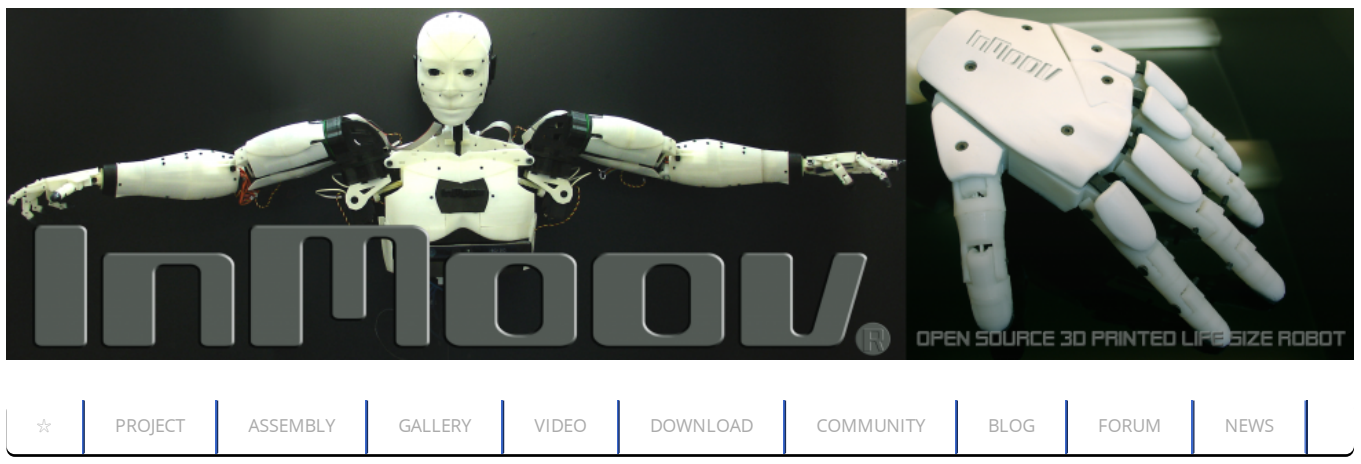
[picture p458: figure]
PROJECT; ASSEMBLY; GALLERY; VIDEO; DOWNLOAD; COMMUNITY; BLOG; FORUM; NEWS

http://www.inmoov.fr/lining-and-tighting-the-tendons/ | 1/4

# Lining and Tighting the tendons

# Lining and tighting the tendons

This is a little tuto to help you tighting up the tendons with the “SimpleServoBed”. In these pictures there is also a demonstration of how to line up the wiring for to add sensors on the tip of fingers.

Using a multi colored nappe will help you to distinguish wich sensor is connected to your Analog pins.

Seperate the wires by pairs. One pair per finger. You can see here in the wrist I’ve decided to have the wire nappe on the bottom of the wrist and the tendons (red braided fishing line) on the top. Make sure at all time not to twist/tangle tendons and wires somewhere during the lining to tip of fingers, other wise the fingers will never work correctly.

## HELP ME EXPERIMENT

## SEARCH

search here...

## MEMBER ACTIVITIES

Dwa yne Wi l l i a ms (http://www.inmoov.fr/members/dwilli9013/) upl oa ded a new pi c t ure : openc v_fd_1. j pg (http://www.inmoov.fr/members/dwilli9013/album/picture/46/) 17 hours , 57 mi nut e s a go (http://www.inmoov.fr/activity/p/1213/)

Rob is
standing
proud as a
test bot for
Grog.
He is very
pleased to be a part of
enhancing the Inmoov Nation.

Fred (http://www.inmoov.fr/members/freddyzaz/) upl oa ded a new
pi c t ure : Pos s i bl e spri ng for… (http://www.inmoov.fr/members/freddyzaz/album/picture/45/) 1 da y, 16 hours a go (http://www.inmoov.fr/activity/p/1203/)

Maybe a
possible
spring for
tendons ?

Tweet (https://twitter.com/intent/tweet?tw_p=tweetbutton)

0 (http://twitter.com/search?q=http%3A%2F%2Fwww.inmoov.fr%2Flining-and-tighting-the-tendons%2F)

0

1

Like

Now that the tendons and wires are lined up correctly from servo to finger tip, make three or four knots by the finger tip. Put a drop cyanocrylate glue on the knots to secure them.

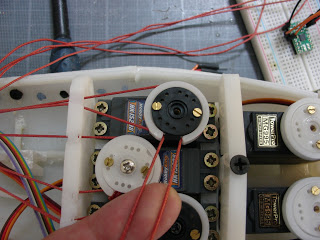
[picture p459: figure]
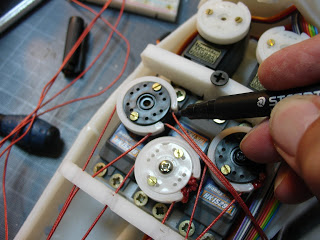
[picture p460: figure]

Pull on the lining as much as you can. (without breaking something of course) Mark with a pen where the wire comes out of the wheel.

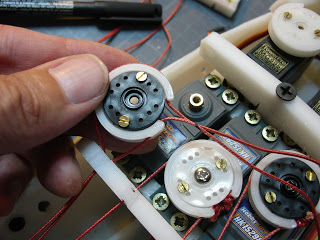
[picture p461: figure]

Now unmount the actuator wheel from servo to release the tendons. You can see my black marks on the fishing line.

J a c k Phi l l i ps pos t ed a n upda t e 2 da ys , 11 hours a go; Head Connect to Torso. Using EZ Robot for programing interface for now. Printing arms and hands next. Not sure how to post video so here is the link. https://www.youtube.com/wat ch? v=czMIEDz9804&feature=c4- overview&list=UUNwIfeOZc- u4UbOx3bcqJHQ; Ga e l La nge vi n pos t ed a n upda t e 2 da ys , 16 hours a go; To Fred and others:; https://groups.google.com/gro up/inmoov/attach/151d3d256 a4108f0/spring%20tensioner1.j pg?part=4&authuser=0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

## FOLLOW ME

## gael langevin (https://plus.google.com/109466702837468444192?prsrc=5)

413 followers

### 1 circle

## RECENT POSTS

InMoov prosthetic hand almost ready (http://www.inmoov.fr/inmoov-prosthetic-hand-almost-ready/) InMoov in Moscow, Geek Picnic (http://www.inmoov.fr/inmoov-in-moscow-geek-picnic/) InMoov on the New Yorker (http://www.inmoov.fr/inmoov-on-the-new-yorker/)
Wow InMoov Santa! (http://www.inmoov.fr/wow-inmoov-santa/)

Make two knots on each mark points. This will reduce the length of fishing line between the tip of the finger and the actuator wheel. Normally it should be enough to give the correct tension for the tendons.

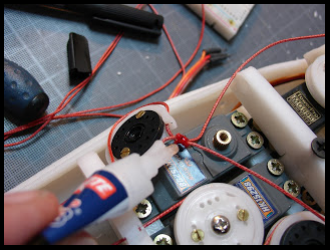
[picture p462: figure]

Secure the knots with a drop of Cyanocrylate glue.

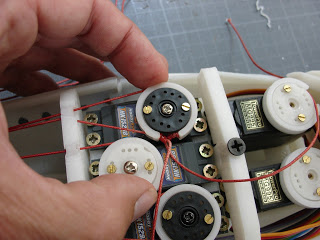
[picture p463: figure]

Set back the actuator wheel on the servo respecting the intial degree position.

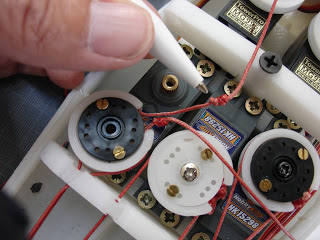
[picture p464: figure]

Let the lining set for a few hours or move the servo through the Arduino. Check if the tension is still correct. If ever it gets too loose add a knot between the first knots and the wheel.

New wiring design for the hand (http://www.inmoov.fr/new-wiring-design-for-the-hand/)

## RECENT COMMENTS

Gael Langevin (http://www.inmoov.fr/) on Hand and Forarm (http://www.inmoov.fr/hand-and-forarm/#comment-482)
Tom on Hand and Forarm (http://www.inmoov.fr/hand-and-forarm/#comment-481)
InMoov » InMoov prosthetic hand almost ready on Default Hardware Map (http://www.inmoov.fr/inmoov-prosthetic-hand-almost-ready/)
Gael Langevin (http://www.inmoov.fr/) on Hand and Forarm (http://www.inmoov.fr/hand-and-forarm/#comment-479)
Tom on Hand and Forarm (http://www.inmoov.fr/hand-and-forarm/#comment-478)

## ARCHIVES

March 2014 (http://www.inmoov.fr/2014/03/)
February 2014 (http://www.inmoov.fr/2014/02/)
January 2014 (http://www.inmoov.fr/2014/01/)
December 2013 (http://www.inmoov.fr/2013/12/)
November 2013 (http://www.inmoov.fr/2013/11/)
October 2013 (http://www.inmoov.fr/2013/10/)
September 2013 (http://www.inmoov.fr/2013/09/)
August 2013 (http://www.inmoov.fr/2013/08/)
July 2013 (http://www.inmoov.fr/2013/07/)
May 2013 (http://www.inmoov.fr/2013/05/)
April 2013 (http://www.inmoov.fr/2013/04/)
March 2013 (http://www.inmoov.fr/2013/03/)
February 2013 (http://www.inmoov.fr/2013/02/)
January 2013 (http://www.inmoov.fr/2013/01/)
December 2012 (http://www.inmoov.fr/2012/12/)
November 2012 (http://www.inmoov.fr/2012/11/)
October 2012 (http://www.inmoov.fr/2012/10/)
September 2012 (http://www.inmoov.fr/2012/09/)
August 2012 (http://www.inmoov.fr/2012/08/)
July 2012 (http://www.inmoov.fr/2012/07/)
June 2012 (http://www.inmoov.fr/2012/06/)
May 2012 (http://www.inmoov.fr/2012/05/)

## CATEGORIES

Select Category

# Share and Enjoy

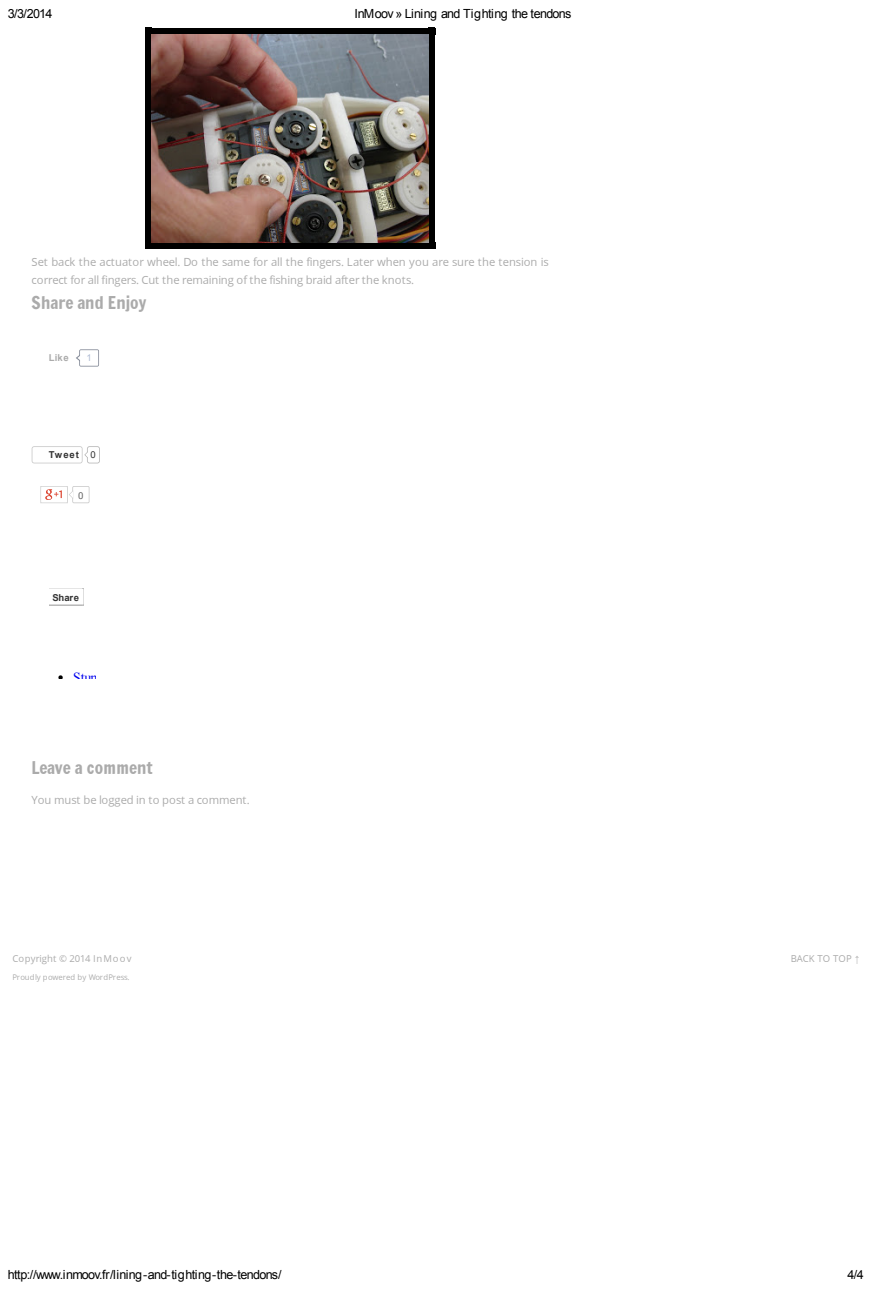
[picture p465: page 4]
Tweet 0; Stum; Leave a comment; Copyright © 2014 InMoov; Like; Share

Set back the actuator wheel. Do the same for all the fingers. Later when you are sure the tension is
correct for all fingers. Cut the remaining of the fishing braid after the knots.

You must be logged in (http://www.inmoov.fr/wp-login.php) to post a comment.

BACK TO TOP ↑

Proudly powered by WordPress. (http://wordpress.org/)
