aalonsopuig/Inmoov_ROS2/docs/assembly/Arms/Rotational wrist/Rotational Wrist.pdf

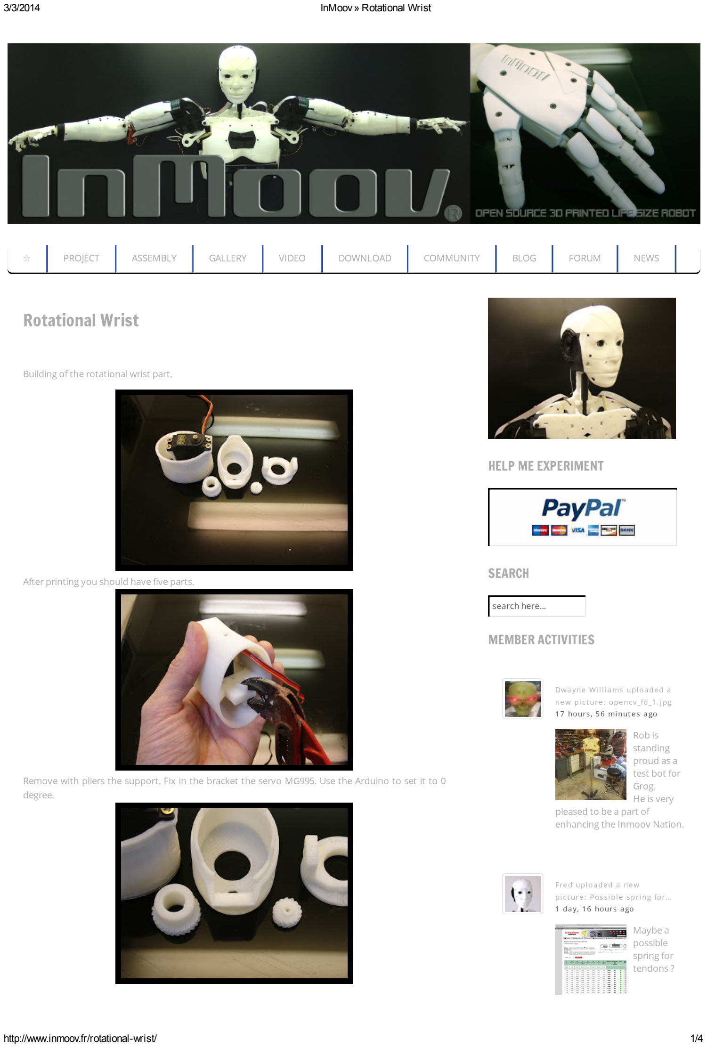
[picture p466: page 1]

3/3/2014 | InMoov» Rotational Wrist
http://www.inmoov.fr/rotational-wrist/ | 1/4

# Rotational Wrist

Building of the rotational wrist part.

After printing you should have five parts.

Remove with pliers the support. Fix in the bracket the servo MG995. Use the Arduino to set it to 0 degree.

## HELP ME EXPERIMENT

## SEARCH

search here...

## MEMBER ACTIVITIES

Dwa yne Wi l l i a ms (http://www.inmoov.fr/members/dwilli9013/) upl oa ded a new pi c t ure : openc v_fd_1. j pg (http://www.inmoov.fr/members/dwilli9013/album/picture/46/) 17 hours , 56 mi nut e s a go (http://www.inmoov.fr/activity/p/1213/)

Rob is
standing
proud as a
test bot for
Grog.
He is very
pleased to be a part of
enhancing the Inmoov Nation.

Fred (http://www.inmoov.fr/members/freddyzaz/) upl oa ded a new
pi c t ure : Pos s i bl e spri ng for… (http://www.inmoov.fr/members/freddyzaz/album/picture/45/) 1 da y, 16 hours a go (http://www.inmoov.fr/activity/p/1203/)

Maybe a
possible
spring for
tendons ?
☆ (http://www.inmoov.fr/) | PROJECT (http://www.inmoov.fr/project/) | ASSEMBLY (http://www.inmoov.fr/assembly/) | GALLERY (http://www.inmoov.fr/gallery/) | VIDEO (http://www.inmoov.fr/youvideo/) | DOWNLOAD (http://www.inmoov.fr/download/) | COMMUNITY (http://www.inmoov.fr/community/) | BLOG (http://inmoov.blogspot.com/) | FORUM (https://groups.google.com/forum/#!forum/inmoov) | NEWS (http://www.inmoov.fr/on-the-net/)

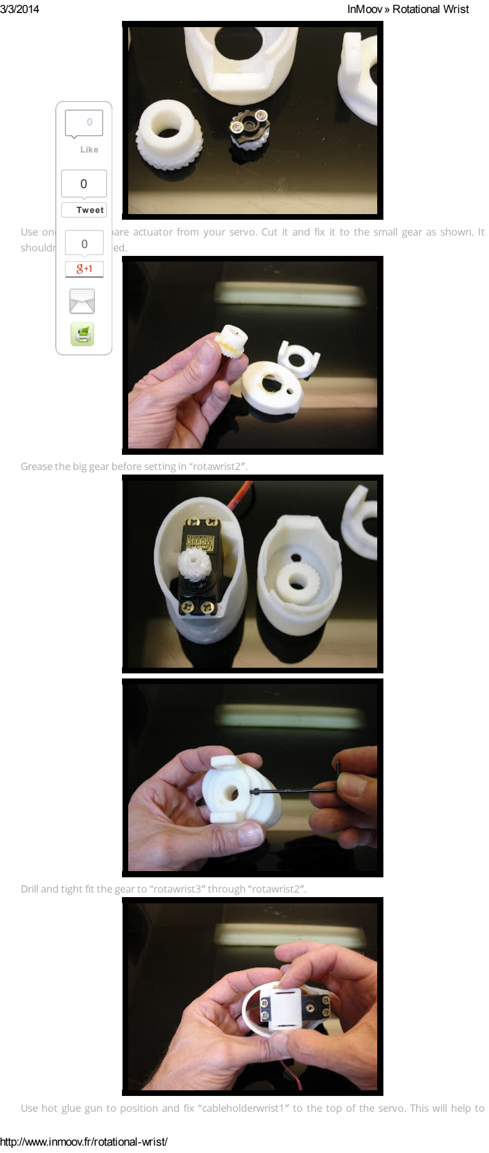
[picture p467: figure]
shouldn’t be oversized.; Tweet; Like

Use one of your spare actuator from your servo. Cut it and fix it to the small gear as shown. It

Grease the big gear before setting in “rotawrist2″.

Drill and tight fit the gear to “rotawrist3″ through “rotawrist2″.

Use hot glue gun to position and fix “cableholderwrist1″ to the top of the servo. This will help to

J a c k Phi l l i ps pos t ed a n upda t e 2 da ys , 11 hours a go; Head Connect to Torso. Using EZ Robot for programing interface for now. Printing arms and hands next. Not sure how to post video so here is the link. https://www.youtube.com/wat ch? v=czMIEDz9804&feature=c4- overview&list=UUNwIfeOZc- u4UbOx3bcqJHQ; Ga e l La nge vi n pos t ed a n upda t e 2 da ys , 16 hours a go; To Fred and others:; https://groups.google.com/gro up/inmoov/attach/151d3d256 a4108f0/spring%20tensioner1.j pg?part=4&authuser=0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

## FOLLOW ME

## gael langevin (https://plus.google.com/109466702837468444192?prsrc=5)

413 followers

### 1 circle

## RECENT POSTS

InMoov prosthetic hand almost ready (http://www.inmoov.fr/inmoov-prosthetic-hand-almost-ready/) InMoov in Moscow, Geek Picnic (http://www.inmoov.fr/inmoov-in-moscow-geek-picnic/) InMoov on the New Yorker (http://www.inmoov.fr/inmoov-on-the-new-yorker/)
Wow InMoov Santa! (http://www.inmoov.fr/wow-inmoov-santa/)

Tweet (https://twitter.com/intent/tweet?text=Rotational%20Wrist%20-%20&tw_p=tweetbutton) 0 (http://twitter.com/search?q=http%3A%2F%2Fwww.inmoov.fr%2Frotational-wrist%2F)

Stum (http://www.stumbleupon.com/submit?url=http%3A%2F%2Fwww.inmoov.fr%2Frotational-wrist%2F)

0

guide the rods into the center hole.

Close the whole thing and tight the 3 screws on perimeter. Make a test run with your Aduino. This is the position you should have when your servo is at 180° for the left hand

Now it’s time to glue “rotawrist1″ to “robpart2V2″. Once glued detach “rotawrist1″ from “rotawrist2″. Start running the rods from your servos up to each finger. (Use the Arduino to set your servos at 0 Degrees) Don’t twist the rods and make sure the upper rods run through the upper parts of the fingers, run the lower rods through the lower parts of the fingers.

This is where you are going to test your patience and skills. I use twisers for to do the job.

# Share and Enjoy

New wiring design for the hand (http://www.inmoov.fr/new-wiring-design-for-the-hand/)

## RECENT COMMENTS

Gael Langevin (http://www.inmoov.fr/) on Hand and Forarm (http://www.inmoov.fr/hand-and-forarm/#comment-482)
Tom on Hand and Forarm (http://www.inmoov.fr/hand-and-forarm/#comment-481)
InMoov » InMoov prosthetic hand almost ready on Default Hardware Map (http://www.inmoov.fr/inmoov-prosthetic-hand-almost-ready/)
Gael Langevin (http://www.inmoov.fr/) on Hand and Forarm (http://www.inmoov.fr/hand-and-forarm/#comment-479)
Tom on Hand and Forarm (http://www.inmoov.fr/hand-and-forarm/#comment-478)

## ARCHIVES

March 2014 (http://www.inmoov.fr/2014/03/)
February 2014 (http://www.inmoov.fr/2014/02/)
January 2014 (http://www.inmoov.fr/2014/01/)
December 2013 (http://www.inmoov.fr/2013/12/)
November 2013 (http://www.inmoov.fr/2013/11/)
October 2013 (http://www.inmoov.fr/2013/10/)
September 2013 (http://www.inmoov.fr/2013/09/)
August 2013 (http://www.inmoov.fr/2013/08/)
July 2013 (http://www.inmoov.fr/2013/07/)
May 2013 (http://www.inmoov.fr/2013/05/)
April 2013 (http://www.inmoov.fr/2013/04/)
March 2013 (http://www.inmoov.fr/2013/03/)
February 2013 (http://www.inmoov.fr/2013/02/)
January 2013 (http://www.inmoov.fr/2013/01/)
December 2012 (http://www.inmoov.fr/2012/12/)
November 2012 (http://www.inmoov.fr/2012/11/)
October 2012 (http://www.inmoov.fr/2012/10/)
September 2012 (http://www.inmoov.fr/2012/09/)
August 2012 (http://www.inmoov.fr/2012/08/)
July 2012 (http://www.inmoov.fr/2012/07/)
June 2012 (http://www.inmoov.fr/2012/06/)
May 2012 (http://www.inmoov.fr/2012/05/)

## CATEGORIES

Select Category

Like 0

Share

# Leave a comment

You must be logged in (http://www.inmoov.fr/wp-login.php?redirect_to=http%3A%2F%2Fwww.inmoov.fr%2Frotational-wrist%2F) to post a comment.

Copyright © 2014 InMoov (http://www.inmoov.fr/)

Proudly powered by WordPress. (http://wordpress.org/)

BACK TO TOP ↑
