aalonsopuig/Inmoov_ROS2/docs/assembly/Arms/Shoulder/Shoulder and Torso.pdf

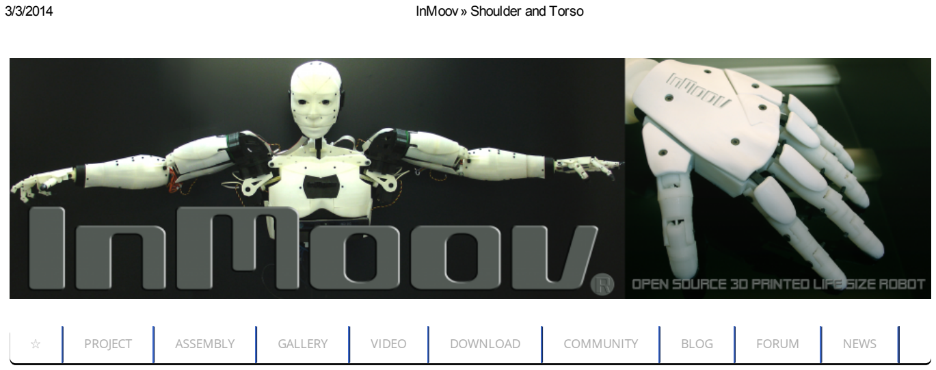
[picture p468: figure]
InMoov» Shoulder and Torso; PROJECT; ASSEMBLY; GALLERY; VIDEO; DOWNLOAD; COMMUNITY; BLOG; FORUM; NEWS

http://www.inmoov.fr/shoulder-and-torso/ | 1/11

# Shoulder and Torso

# Building a shoulder and torso

All right let see how we’re goig to proceed. In this tuto we are going to build the shoulder and torso simulteanously. I would have rathered do it seperatly, but my pictures were already done this way, and I’m not going to take the robot apart for to make new pictures.
STEP1:

Follow the step1 in “Building the bicep of InMoov” for to extract the potentiometers of your servos. There is a difference though in the last part during re-welding the cables to the potentiometer depending if you build the right or left shoulder.

Weld the cables this way, if you are building the right shoulder. In this picture the blue replace the green or the black wire depending on your servos.

Weld the cables this way, if you are building the left shoulder. In this picture the blue replace the green or the black wire depending on your servos.

This will allow your servo to turn the opposite way making your initial 0 position becoming your 180

## HELP ME EXPERIMENT

## SEARCH

search here...

## MEMBER ACTIVITIES

Dwa yne Wi l l i a ms (http://www.inmoov.fr/members/dwilli9013/) upl oa ded a new pi c t ure : openc v_fd_1. j pg (http://www.inmoov.fr/members/dwilli9013/album/picture/46/) 17 hours , 59 mi nut e s a go (http://www.inmoov.fr/activity/p/1213/)

Rob is
standing
proud as a
test bot for
Grog.
He is very
pleased to be a part of
enhancing the Inmoov Nation.

Fred (http://www.inmoov.fr/members/freddyzaz/) upl oa ded a new
pi c t ure : Pos s i bl e spri ng for… (http://www.inmoov.fr/members/freddyzaz/album/picture/45/) 1 da y, 16 hours a go (http://www.inmoov.fr/activity/p/1203/)

Maybe a
possible
spring for
tendons ?

position. And your initial 180 position become your 0 position. I hope you get the idea. This will be done on both servos used in each the shoulder. Now let start the assembly.
STEP2:

If you plan on building both shoulders you should repeat most of the following steps explained bellow.

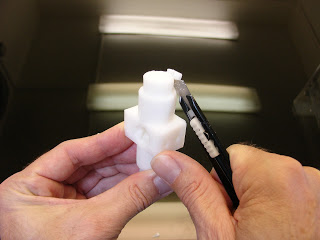
[picture p469: figure]

Remove the pre-built support under “PistoBaseV4″
Make sure “PistonClaviV2″ can run freely inside. If your prints are a bit too tight you can ease it with grease. I had to fine tune my printer for those parts to get the right setting.

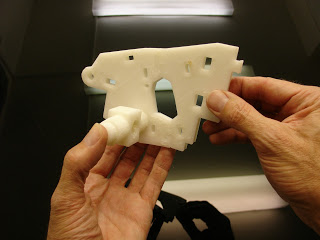
[picture p470: figure]

Assemble together with your favorite pliers, “PistoBaseV4″, “ClaviBackV1″ and “HomPlatback+V1″. Make sure that “PistoBaseV4″ can rotate smoothly.

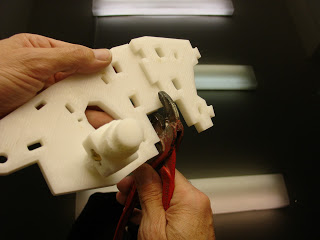
[picture p471: figure]

Add “HomPlatback-V1″to “HomPlatback+V1″ Here you can see my favorit pliers in action.

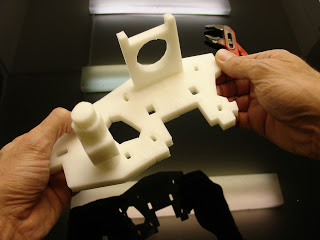
[picture p472: figure]

Add “ThroatHoleV2″ to “HomPlatback-V1″to “HomPlatback+V1″ “ThroatHoleV2″ has been modified since this picture.

J a c k Phi l l i ps pos t ed a n upda t e 2 da ys , 11 hours a go; Head Connect to Torso. Using EZ Robot for programing interface for now. Printing arms and hands next. Not sure how to post video so here is the link. https://www.youtube.com/wat ch? v=czMIEDz9804&feature=c4- overview&list=UUNwIfeOZc- u4UbOx3bcqJHQ; Ga e l La nge vi n pos t ed a n upda t e 2 da ys , 16 hours a go; To Fred and others:; https://groups.google.com/gro up/inmoov/attach/151d3d256 a4108f0/spring%20tensioner1.j pg?part=4&authuser=0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

## FOLLOW ME

## gael langevin (https://plus.google.com/109466702837468444192?prsrc=5)

413 followers

### 1 circle

## RECENT POSTS

InMoov prosthetic hand almost ready (http://www.inmoov.fr/inmoov-prosthetic-hand-almost-ready/) InMoov in Moscow, Geek Picnic (http://www.inmoov.fr/inmoov-in-moscow-geek-picnic/) InMoov on the New Yorker (http://www.inmoov.fr/inmoov-on-the-new-yorker/)
Wow InMoov Santa! (http://www.inmoov.fr/wow-inmoov-santa/)

Time to assemble the front. Mount together “SternumV1″ to “ClaviFrontV1″.
Sorry this picture shows the first version I made but it’s pretty close, check the next picture.

This is the shape you will obtain with the last version and the last “ThroatHoleV2″ in the back.

Mount together the two “ThroatLowerV1″ and “ServoHolsterV1″.
This servo, set in the middle of the torso, is for to move the head up and down and can be added later if you wish, but the holster should be set already in place.

Mount this assembly to the back assembly. Check on the picture the plots and the position of the servo. Front clips and back clips are different.

New wiring design for the hand (http://www.inmoov.fr/new-wiring-design-for-the-hand/)

## RECENT COMMENTS

Gael Langevin (http://www.inmoov.fr/) on Hand and Forarm (http://www.inmoov.fr/hand-and-forarm/#comment-482)
Tom on Hand and Forarm (http://www.inmoov.fr/hand-and-forarm/#comment-481)
InMoov » InMoov prosthetic hand almost ready on Default Hardware Map (http://www.inmoov.fr/inmoov-prosthetic-hand-almost-ready/)
Gael Langevin (http://www.inmoov.fr/) on Hand and Forarm (http://www.inmoov.fr/hand-and-forarm/#comment-479)
Tom on Hand and Forarm (http://www.inmoov.fr/hand-and-forarm/#comment-478)

## ARCHIVES

March 2014 (http://www.inmoov.fr/2014/03/)
February 2014 (http://www.inmoov.fr/2014/02/)
January 2014 (http://www.inmoov.fr/2014/01/)
December 2013 (http://www.inmoov.fr/2013/12/)
November 2013 (http://www.inmoov.fr/2013/11/)
October 2013 (http://www.inmoov.fr/2013/10/)
September 2013 (http://www.inmoov.fr/2013/09/)
August 2013 (http://www.inmoov.fr/2013/08/)
July 2013 (http://www.inmoov.fr/2013/07/)
May 2013 (http://www.inmoov.fr/2013/05/)
April 2013 (http://www.inmoov.fr/2013/04/)
March 2013 (http://www.inmoov.fr/2013/03/)
February 2013 (http://www.inmoov.fr/2013/02/)
January 2013 (http://www.inmoov.fr/2013/01/)
December 2012 (http://www.inmoov.fr/2012/12/)
November 2012 (http://www.inmoov.fr/2012/11/)
October 2012 (http://www.inmoov.fr/2012/10/)
September 2012 (http://www.inmoov.fr/2012/09/)
August 2012 (http://www.inmoov.fr/2012/08/)
July 2012 (http://www.inmoov.fr/2012/07/)
June 2012 (http://www.inmoov.fr/2012/06/)
May 2012 (http://www.inmoov.fr/2012/05/)

## CATEGORIES

Select Category

Tweet

0 (http://www.inmoov.fr/imm_old/2.bp.blogspot.com/-dakEkJuGlfw/UOSQRyDe90I/AAAAAAAAA1A/tFADduYFhfw/s1600/DSC05256.JPG)

0

0

Like (http://www.inmoov.fr/imm_old/2.bp.blogspot.com/-dakEkJuGlfw/UOSQRyDe90I/AAAAAAAAA1A/tFADduYFhfw/s1600/DSC05256.JPG)

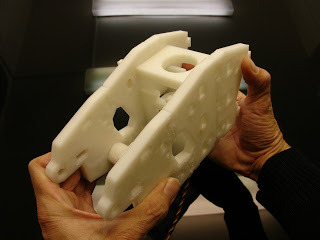
[picture p473: figure]

Add the front assembly to the rest.

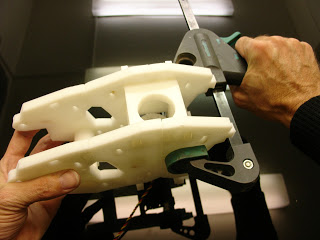
[picture p474: figure]

You can help yourself with clamps. It should all fit nicely. You can add acetone to glue parts together, but I haven’t done it yet and it holds together since a few weeks of tests.

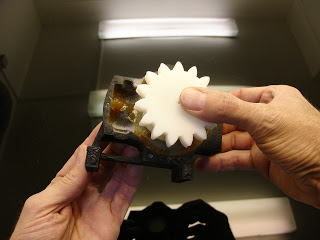
[picture p475: figure]

Now assemble “PivGearV2″ to “PivCenterV1″ It should turn in it smoothly but without slack.

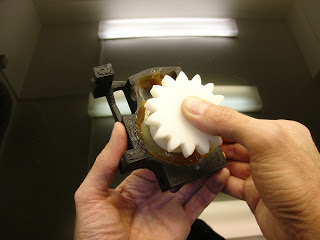
[picture p476: figure]

Using a fear amount of grease is a good idea.

Ok, This section with green parts is the same than for the bicep so I re-used the pictures and changed the name of the parts. This picture is to show you what is the angle position of “PiCenterV1″ compared to “PivMitV1″. Check the little rectangle hole where the potentiometer will go.


So keeping the same rotation angle, mount “PivmitV1″ to “PivgearV1″.


I used clamps to make sure there wouldn’t be slack between all three parts during pre-screwing. Leave them like this, we will screw them definitly together in a further step.


Attach one servo to “PivcenterV1″. For to do so: mount but don’t tight fit the white actuator wheel.

Once the servo is attached, you can tight the screw.

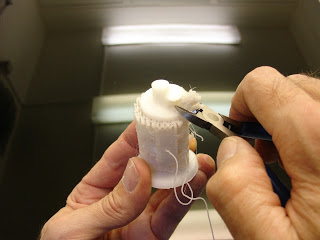
[picture p477: figure]

Clean up the support on “PivWormV1″

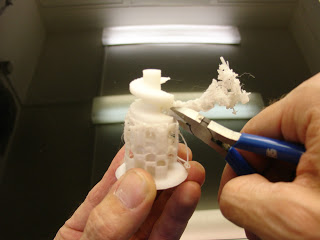
[picture p478: figure]
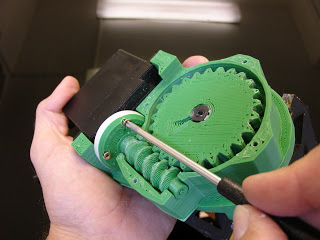
[picture p479: figure]

Mount “PivWormV1″ to the actuator with 4 little screws, make sure they don’t come out behind the actuator, otherwise you have to cut them. I made it operate a few turns by plugging the servo on the Arduino. Then I cleaned up the dust created by the parts.

Before closing the case with “PivTitV1″, make sure you used a good amount of grease, every where on the gears. (sorry the servo is not mounted on this picture)

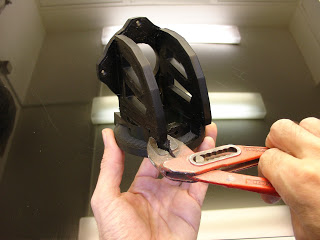
[picture p480: figure]
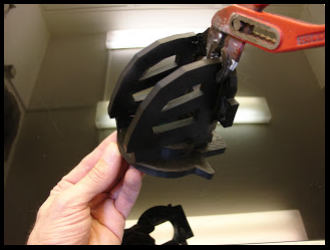
[picture p481: figure]

Mount the two “ConnectorV1″ to “RotTitV1″ and “PivMitV1″, making the junction between the bicep and the shoulder.
Glue with acetone all three parts together, and do it well, this is going to take a lot of pressure.

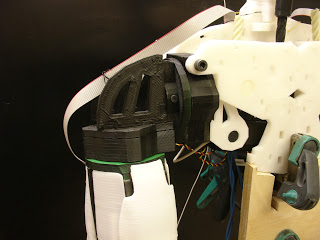
[picture p482: figure]

This is how they should be positionned. (sorry this picture is after everything is built)

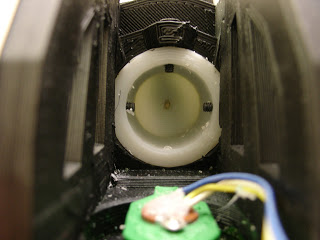
[picture p483: figure]

Set “PivGearV1″ in this rotation angle to “PivMitV1″. Here have a close look at angle of the hole of the potentiometer inside “PivGearV1″. (sorry the screws of the next step are already mounted on this picture)

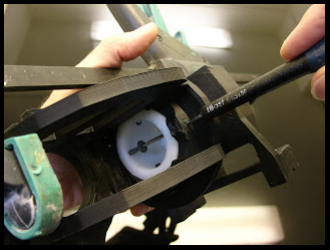
[picture p484: figure]

Use a longer screw to assemble “PivGearV1″ to “PivMitV1″ to “RotTitV1″
Use a clamp to make sure there is no slack between the parts during mounting.

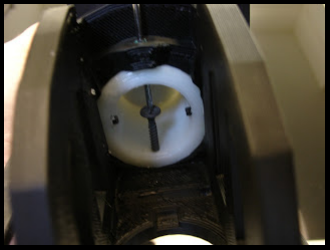
[picture p485: figure]
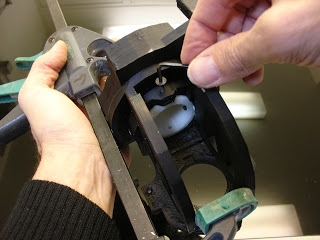
[picture p486: figure]

Then screw “PivGearV1″ to “PivMitV1″ on the sides and top.

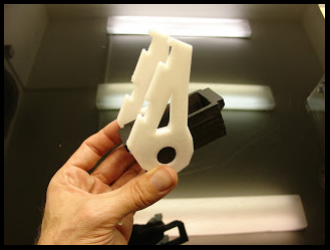
[picture p487: figure]

Put together the two “ServoHolderV1″ and “ServoHolsterV1″

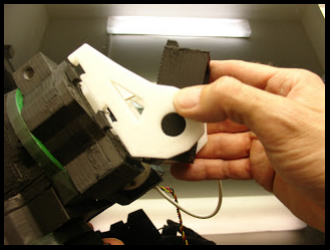
[picture p488: figure]

Mount the assembly to “PivTitV1″. Glue well with acetone, this is going to take pressure too, but make sure the “ServoHolsterV1″ can rotate freely.

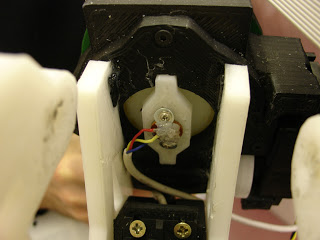
[picture p489: figure]

Set in the potentiometer into “PivPotentioV2″ and clip it as is.
Here make sure the welding for the right shoulder. Red wire being on top, yellow in the middle, and blue on the bottom. I used hot glue on the weldings to avoid short circuits.

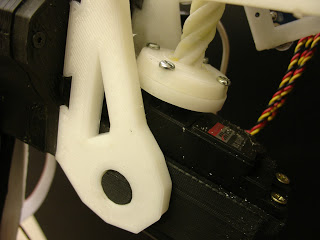
[picture p490: figure]

Mount with screws”PistonClaviV2″ to the white wheel of your servo. set your servo into “ServoHolsterV1″ with screws.

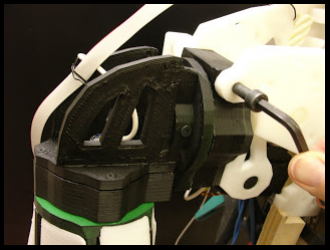
[picture p491: figure]

Attach the complete arm to the shoulder parts.

In the back of the shoulder clip the first part of “PivPotHolderV2″ to “ClaviBackV1″

Remove the two screws attaching the servo and put in place the second part of “PivPotHolderV2″.

Use long screws to go through the servo holes. Fix the potentiometer in place as is. You can see on this picture I used “arduinosupport” from the hand (http://www.thingiverse.com/thing:17773) to set my Board.

Fix the bolt to complete the attachement of thearm to the shoulder.
You are now set to GO for your first test. One thing you should keep in mind is that the servo actuating “PistonClaviV1″ should stay between 0 and 80 position, if you go further it will certainly break. Now if you use InMoov service from Myrobotlab, this is aready implemented to avoid breakage. Remember to do your test in a large space, and check your wires so they don’t get torn off.

# Share and Enjoy

Like 0

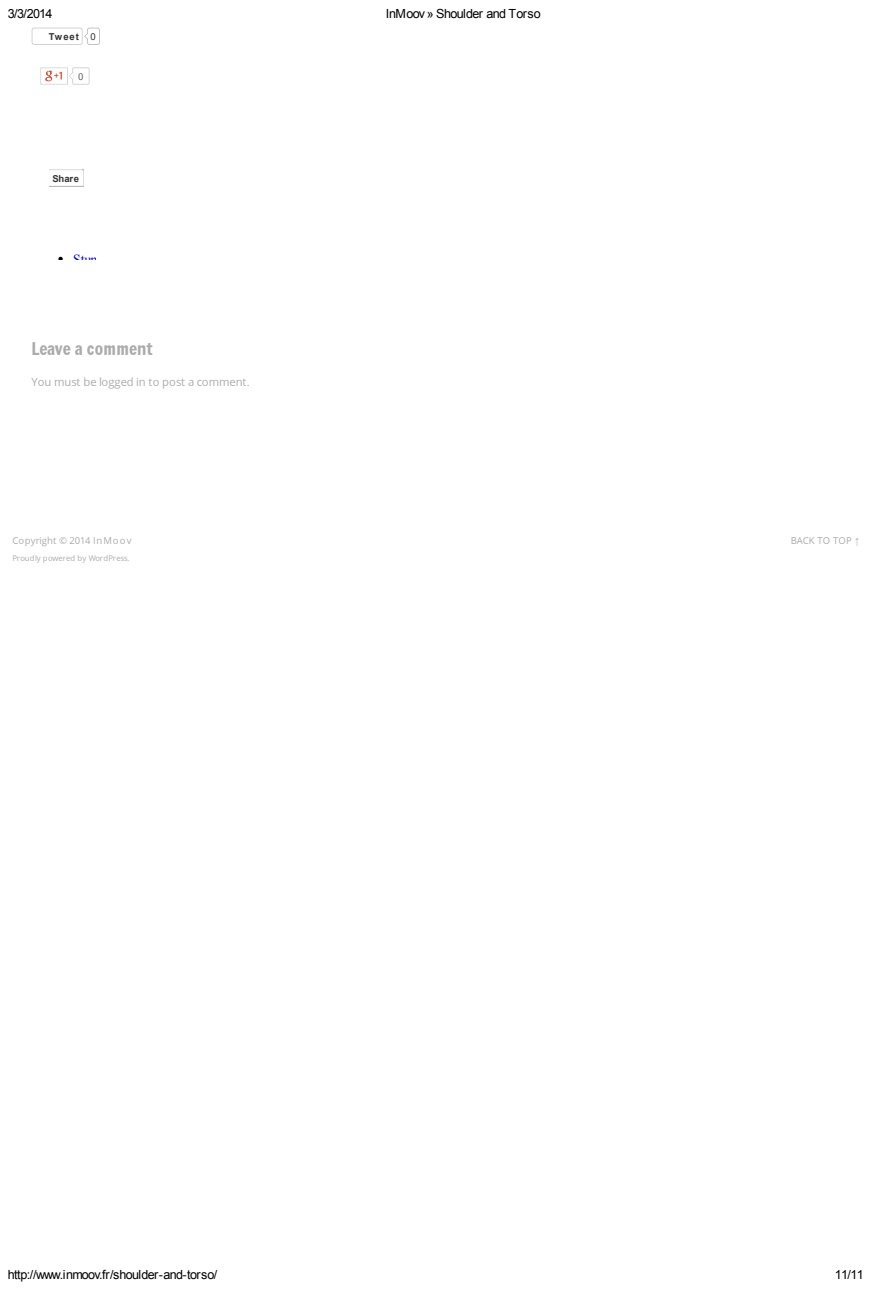
[picture p492: page 11]
Tweet 0; Stum; Leave a comment; Copyright © 2014 InMoov; Share

You must be logged in (http://www.inmoov.fr/wp-login.php?redirect_to=http%3A%2F%2Fwww.inmoov.fr%2Fshoulder-and-torso%2F) to post a comment.

BACK TO TOP ↑

Proudly powered by WordPress. (http://wordpress.org/)
