aalonsopuig/Inmoov_ROS2/docs/assembly/Arms/Bicep/DSC05222_preview_featured.jpg

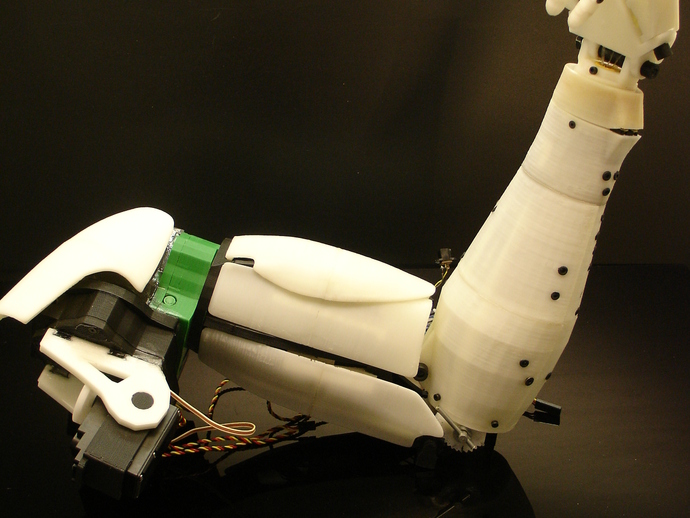
docs/assembly/Arms/Bicep/DSC05222_preview_featured.jpg
