aalonsopuig/Inmoov_ROS2/docs/assembly/Arms/Hand/DSC04799_display_large_preview_featured.jpg

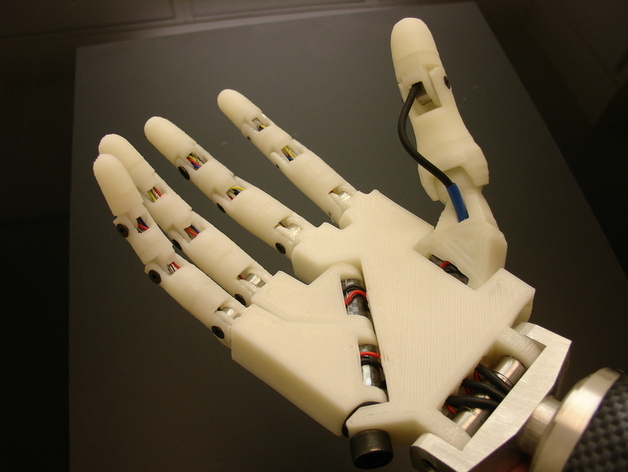
docs/assembly/Arms/Hand/DSC04799_display_large_preview_featured.jpg
