aalonsopuig/Inmoov_ROS2/docs/assembly/Arms/Hand/InMoovhand_display_large_preview_featured.jpg

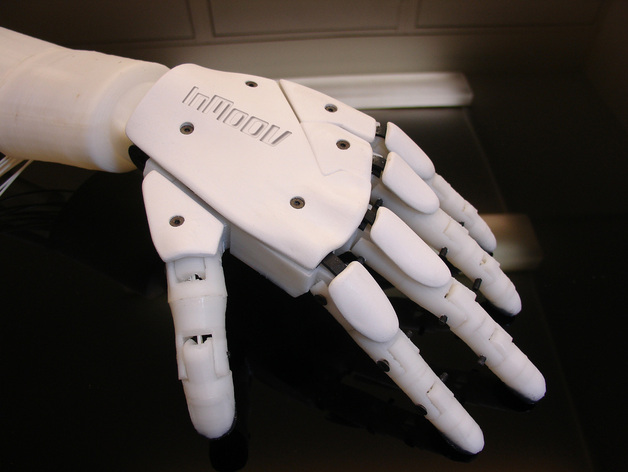
docs/assembly/Arms/Hand/InMoovhand_display_large_preview_featured.jpg
