aalonsopuig/Inmoov_ROS2/docs/assembly/Arms/inmoov_lower_arm.png

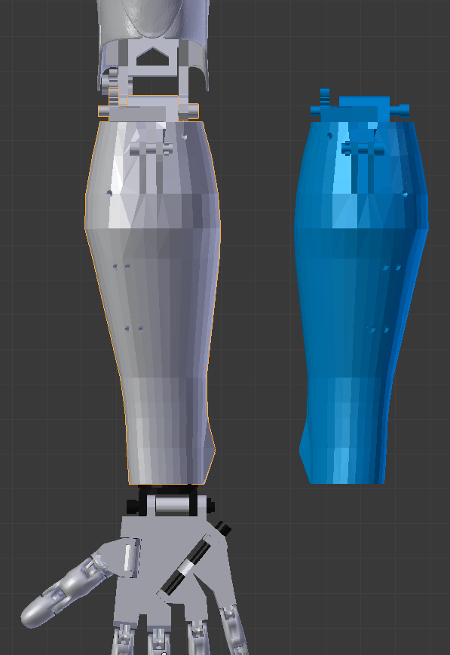
docs/assembly/Arms/inmoov_lower_arm.png
