aalonsopuig/Inmoov_ROS2/docs/assembly/Arms/inmoov_robot_arm_3d_print220.JPG

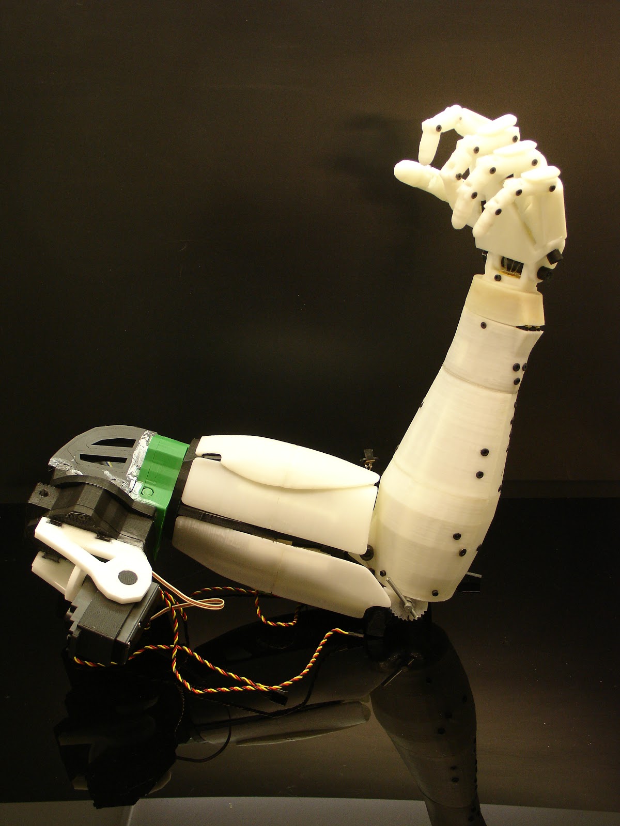
docs/assembly/Arms/inmoov_robot_arm_3d_print220.JPG
