aalonsopuig/Inmoov_ROS2/docs/assembly/Arms/Rotational wrist/DSC04924_display_large_preview_featured.jpg

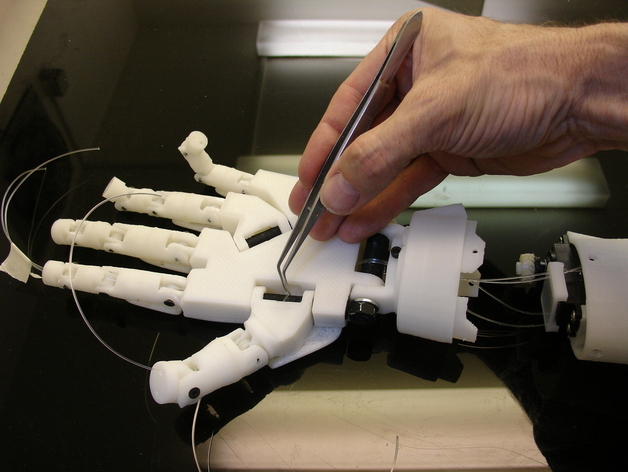
docs/assembly/Arms/Rotational wrist/DSC04924_display_large_preview_featured.jpg
