aalonsopuig/Inmoov_ROS2/docs/assembly/Arms/Shoulder/inmoov_robot_arm_3d_print294_preview_featured.jpg

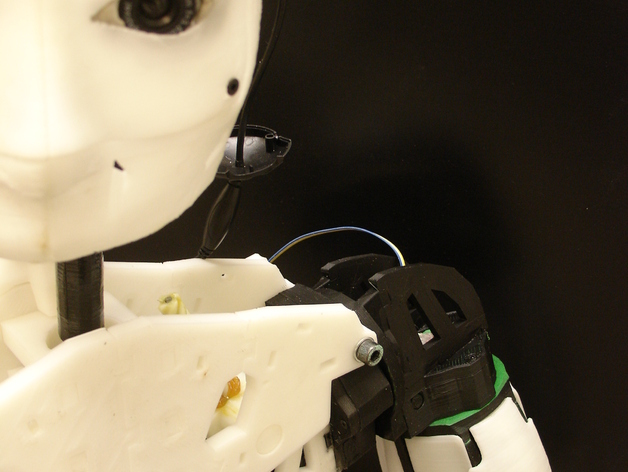
docs/assembly/Arms/Shoulder/inmoov_robot_arm_3d_print294_preview_featured.jpg
