aalonsopuig/Inmoov_ROS2/docs/assembly/Head and Neck/Ears/DSC06017_preview_featured.jpg

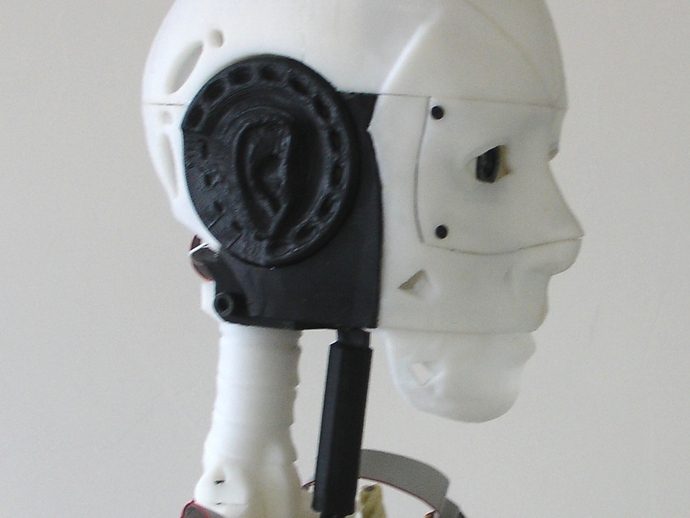
docs/assembly/Head and Neck/Ears/DSC06017_preview_featured.jpg
