aalonsopuig/Inmoov_ROS2/docs/assembly/Head and Neck/Ears/EarLeftV0_preview_featured.jpg

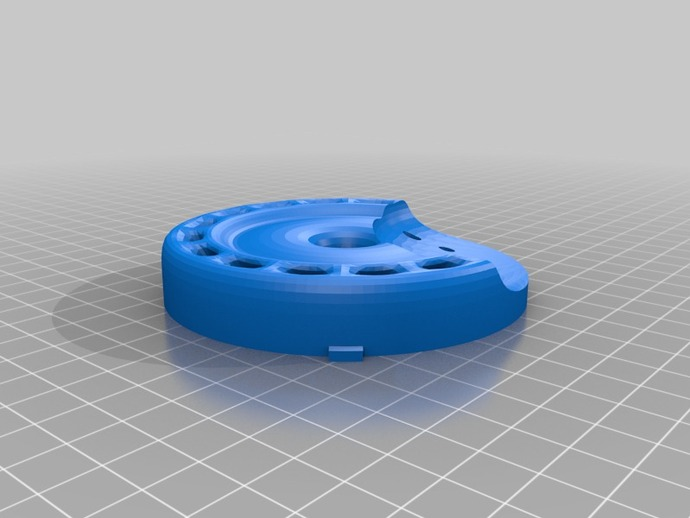
docs/assembly/Head and Neck/Ears/EarLeftV0_preview_featured.jpg
