aalonsopuig/Inmoov_ROS2/docs/assembly/Head and Neck/Ears/EarRightV1_preview_featured.jpg

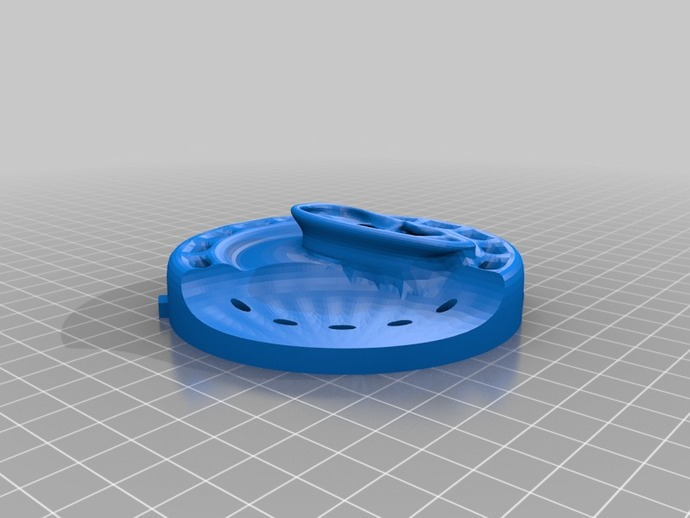
docs/assembly/Head and Neck/Ears/EarRightV1_preview_featured.jpg
