aalonsopuig/Inmoov_ROS2/docs/assembly/Head and Neck/Eye mechanism/Eye Mechanism.jpg

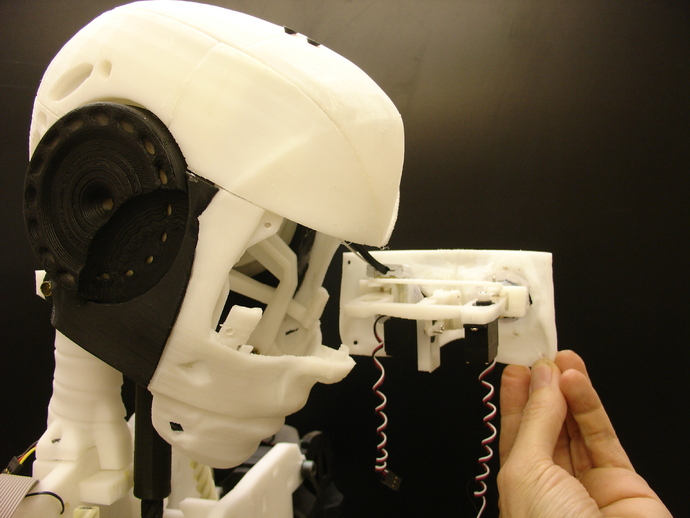
docs/assembly/Head and Neck/Eye mechanism/Eye Mechanism.jpg
