aalonsopuig/Inmoov_ROS2/docs/assembly/Head and Neck/Eye mechanism/EyeBallV1_preview_featured.jpg

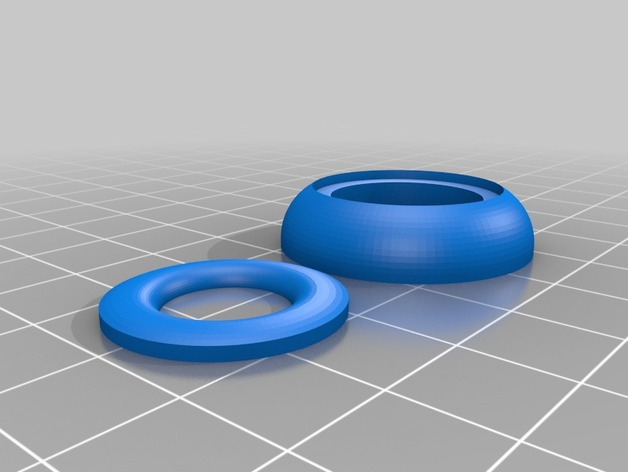
docs/assembly/Head and Neck/Eye mechanism/EyeBallV1_preview_featured.jpg
