aalonsopuig/Inmoov_ROS2/docs/assembly/Head and Neck/Eye mechanism/Instructions/DSC05735_preview_featured.jpg

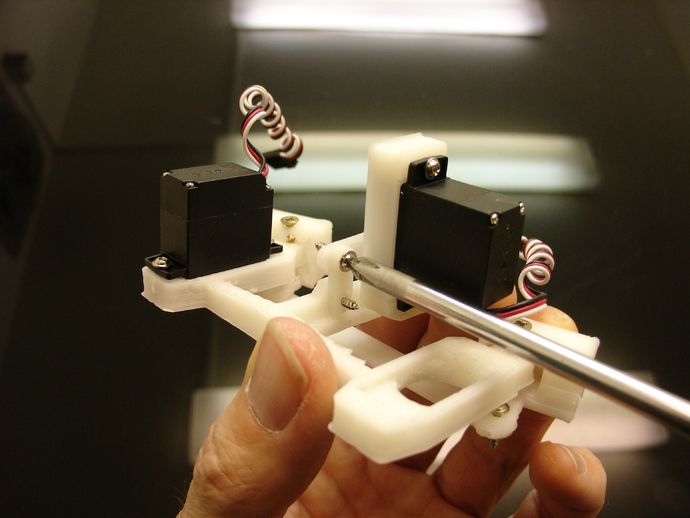
docs/assembly/Head and Neck/Eye mechanism/Instructions/DSC05735_preview_featured.jpg
