aalonsopuig/Inmoov_ROS2/docs/assembly/Head and Neck/Jaw Mechanism/Instructions/DSC05451_preview_featured.jpg

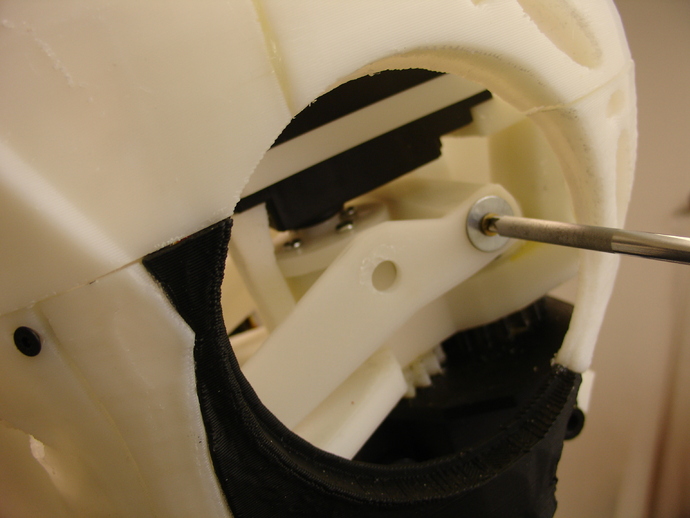
docs/assembly/Head and Neck/Jaw Mechanism/Instructions/DSC05451_preview_featured.jpg
