aalonsopuig/Inmoov_ROS2/docs/assembly/Head and Neck/Neck Mechanism/FaceHolderV3.png

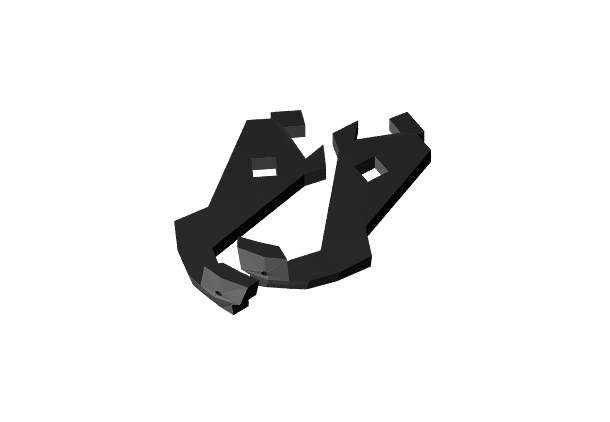
docs/assembly/Head and Neck/Neck Mechanism/FaceHolderV3.png
