aalonsopuig/Inmoov_ROS2/docs/assembly/Head and Neck/Neck Mechanism/GearHolderV1.png

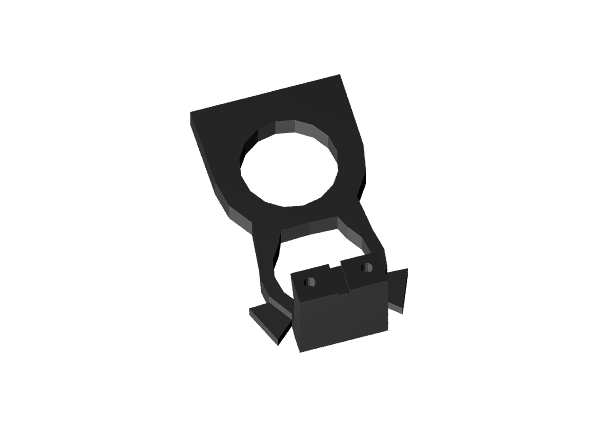
docs/assembly/Head and Neck/Neck Mechanism/GearHolderV1.png
