aalonsopuig/Inmoov_ROS2/docs/assembly/Head and Neck/Neck Mechanism/NeckBoltsV2.png

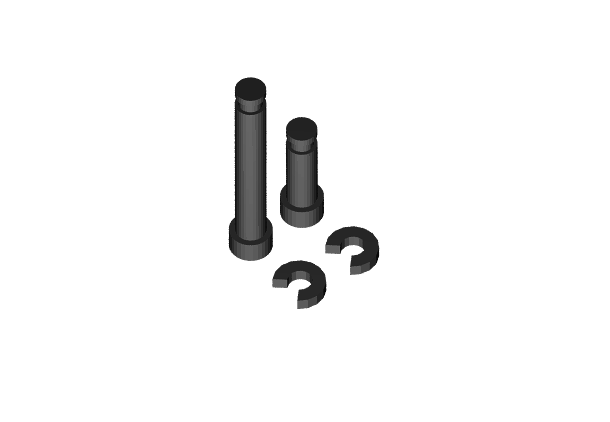
docs/assembly/Head and Neck/Neck Mechanism/NeckBoltsV2.png
