aalonsopuig/Inmoov_ROS2/docs/assembly/Head and Neck/Neck Mechanism/NeckV1.png

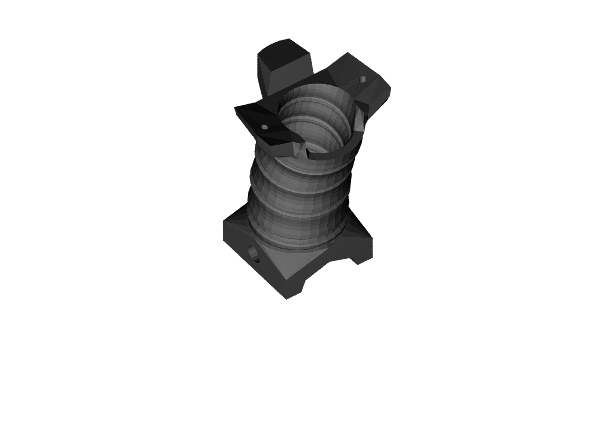
docs/assembly/Head and Neck/Neck Mechanism/NeckV1.png
