aalonsopuig/Inmoov_ROS2/docs/assembly/Head and Neck/Neck Mechanism/RingV1.png

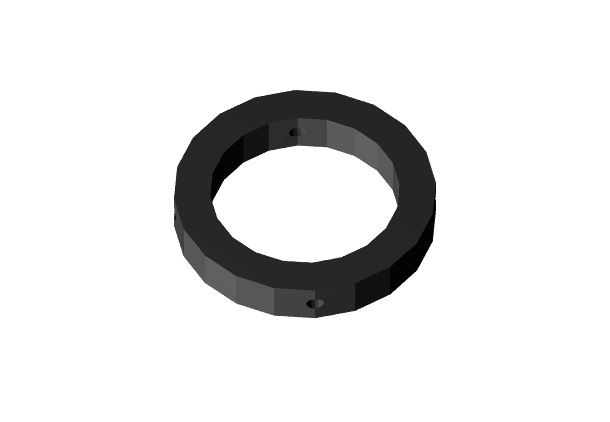
docs/assembly/Head and Neck/Neck Mechanism/RingV1.png
