aalonsopuig/Inmoov_ROS2/docs/assembly/Head and Neck/Neck Mechanism/ServoGearV1.png

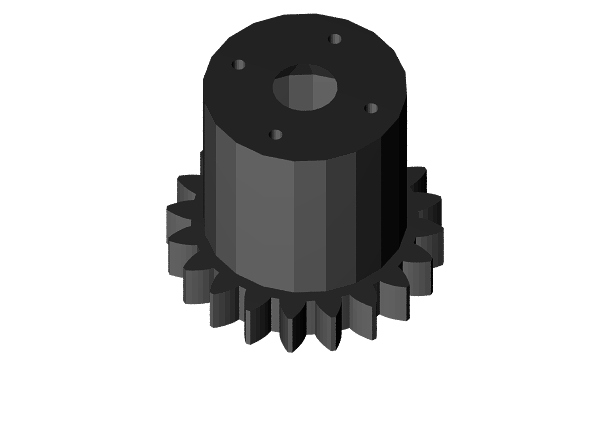
docs/assembly/Head and Neck/Neck Mechanism/ServoGearV1.png
