aalonsopuig/Inmoov_ROS2/docs/assembly/Head and Neck/Neck Mechanism/ThroatHolderV1.png

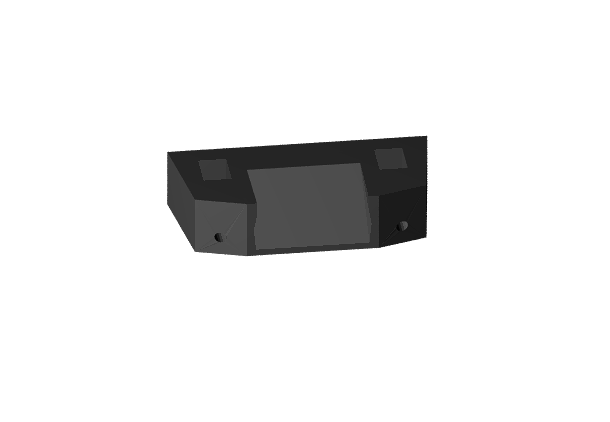
docs/assembly/Head and Neck/Neck Mechanism/ThroatHolderV1.png
