aalonsopuig/Inmoov_ROS2/docs/assembly/Head and Neck/Neck Mechanism/ThroatHoleV2.png

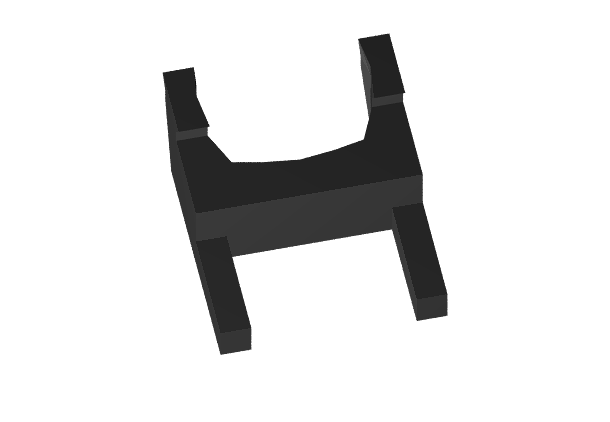
docs/assembly/Head and Neck/Neck Mechanism/ThroatHoleV2.png
