aalonsopuig/Inmoov_ROS2/docs/assembly/Head and Neck/Neck Mechanism/ThroatPistonBaseV2.png

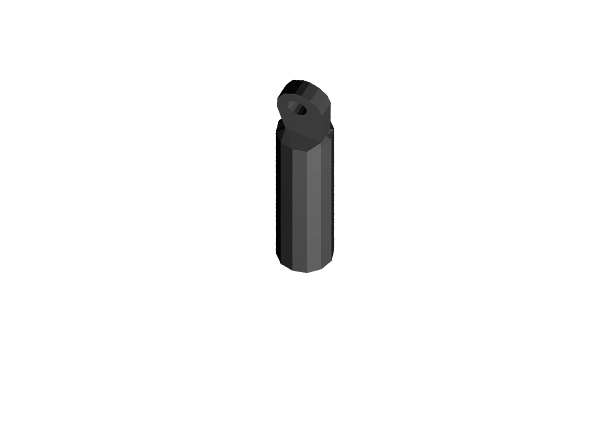
docs/assembly/Head and Neck/Neck Mechanism/ThroatPistonBaseV2.png
