aalonsopuig/Inmoov_ROS2/docs/assembly/Trunk/Back/6d73031dcac765bfd714ed9ef196d3d422a40b08_default.jpg

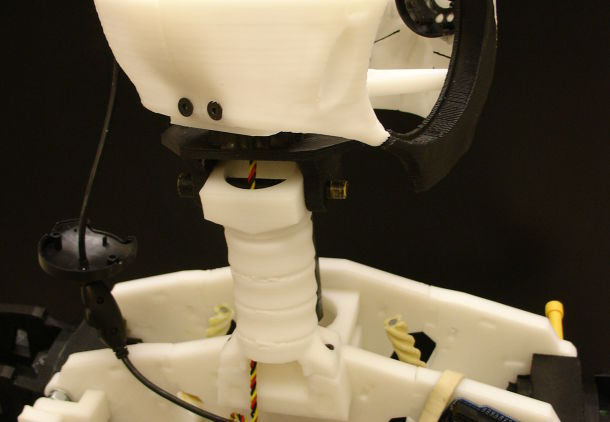
docs/assembly/Trunk/Back/6d73031dcac765bfd714ed9ef196d3d422a40b08_default.jpg
