aalonsopuig/Inmoov_ROS2/docs/assembly/Trunk/Chest/513ba3b910479359042817c23022896ff23bba51_default.jpg

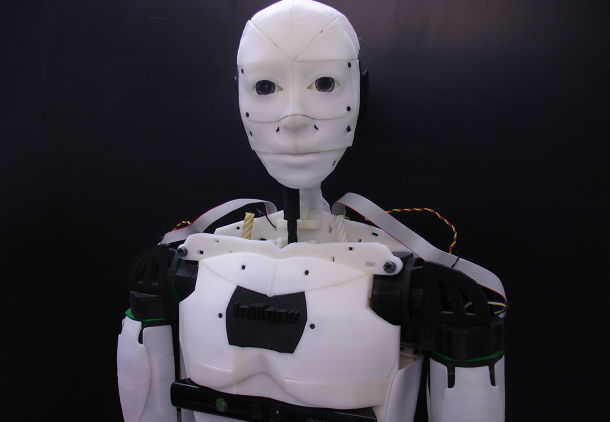
docs/assembly/Trunk/Chest/513ba3b910479359042817c23022896ff23bba51_default.jpg
