aalonsopuig/Inmoov_ROS2/docs/assembly/Trunk/Torso/66db0e63179cfb2d090f9d5d6366c704b484e8d0_default.jpg

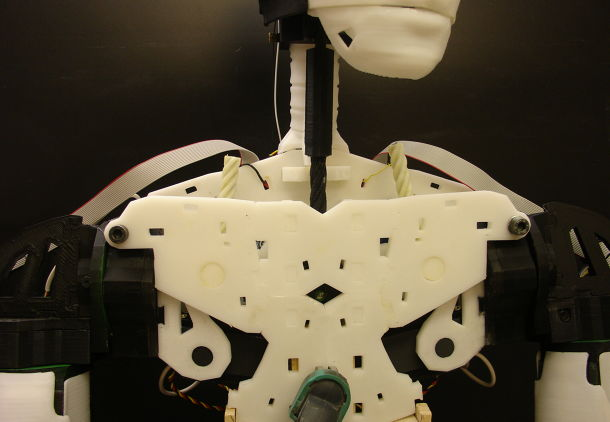
docs/assembly/Trunk/Torso/66db0e63179cfb2d090f9d5d6366c704b484e8d0_default.jpg
