aalonsopuig/Inmoov_ROS2/(commit log)

2025-06-18 Initial commit from ~/ with selected project folders
    [asmArm.urdf.xacro, asmBase.urdf.xacro, asmEye.urdf.xacro, asmFace.urdf.xacro, asmHand.urdf.xacro, asmHead.urdf.xacro, asmTorso.urdf.xacro, bicep.stl]
2026-07-16 Xicro_subsys1_ID_1 v 2.0
    Integrates xicro but is not fully tested. Arduino 1 is almost at full use of memory...
